TeslaCoilerOW/ttihp-protocol-emulator/README.md

     

# Protocol Emulator: four concurrent programmable I/O engines

- [Read the documentation for project](docs/info.md): the datasheet, with the host protocol, ISA reference and a worked example.

This is a Tiny Tapeout project for the IHP SG13CMOS5L 130 nm process and an
entry in the
[Jane Street protocol emulator ASIC competition](https://blog.janestreet.com/protocol-emulator-asic-competition/).
The chip is a small programmable protocol processor. Four engines run their
own programs at the same time on eight shared bidirectional pins. Each engine
fetches from a private 64-instruction program memory (two IHP SRAM macros)
and has 8-word TX and RX queues, shift and scratch registers, a repeat
counter and a wait timer. UART, SPI, I2C, JTAG and timed waveforms are
firmware; none is hardwired. Event mailboxes, input triggers, a common
timestamp and an autonomous mover coordinate the engines; the mover forwards
queue words between engines without the host, for example UART receive into
SPI transmit. A synchronous nibble-wide host port on `ui_in`/`uo_out` loads
and controls everything. The hardware is written in
[Hardcaml](https://github.com/janestreet/hardcaml): `src/protocol_emulator_core.v`
is generated from `hardcaml/`, and `src/project.v` is a thin Tiny Tapeout
wrapper (`tt_um_teslacoilerow_protocol_emulator`).

<!-- ENTRANT: pitch paragraph in your own words -->
> *Placeholder: the entrant's own pitch paragraph goes here.*

```mermaid
flowchart LR
    H["Synchronous host: load, commit, start, status"] --> C["Ownership, mailboxes, timestamp, finite transfer descriptors"]
    H --> P0["Engine 0: private program and TX/RX queues"]
    H --> P1["Engine 1: private program and TX/RX queues"]
    H --> P2["Engine 2: private program and TX/RX queues"]
    H --> P3["Engine 3: private program and TX/RX queues"]
    C --> P0
    C --> P1
    C --> P2
    C --> P3
    P1 --> D["One accepted FIFO transfer per clock; round-robin sources"]
    D --> P2
    P0 --> U0["Pin 0: UART TX"]
    U1["Pin 1: UART RX"] --> P1
    P2 <--> S["Pins 2–5: SPI"]
    P3 <--> I["Pins 6–7: open-drain I²C"]
```

The pin assignment shown is the flagship example (`firmware/flagship-scenario.json`);
ownership is set by the host.

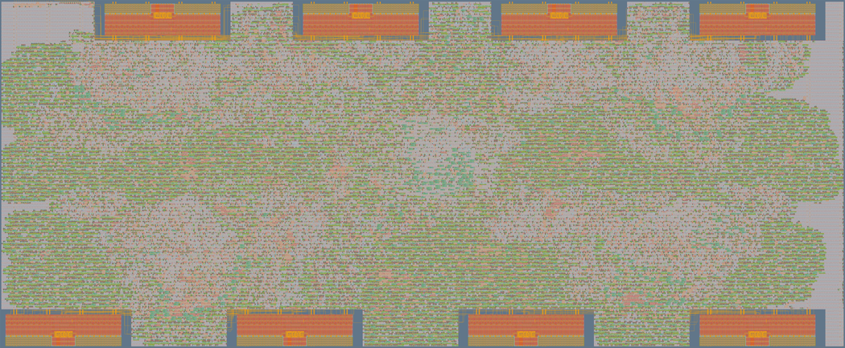
[picture p1: docs/img/die.png]
Layout of the 8x4 die: four SRAM macros along the top edge, four along the bottom, standard cells between them


The layout of the design of record (8x4 tiles, IHP SG13CMOS5L) with its eight
SRAM macros, rendered by the official `gds` workflow (artifact `gds_render` of run
[36714406904](https://github.com/TeslaCoilerOW/ttihp-protocol-emulator/actions/runs/36714406904),
commit `ce6b9bd`) and scaled down. The
[GDS viewer](https://teslacoilerow.github.io/ttihp-protocol-emulator/) shows
the same layout in 3D.

## What is different

1. **Isolated engines and a host-free mover.** Each engine fetches from its
   own SRAM, drives only the pins it owns, and its timing changes only at its
   own stall points; apart from `START`, `STOP` and `BEGIN`, the host port and
   the mover never delay its instructions. The mover forwards words from one
   engine's RX queue to another's TX queue without the host
   ([docs/architecture.md](docs/architecture.md)). The pad-level form of this
   isolation is proved on the RTL, unbounded, for each engine (item 2).
2. **Per-image timing certificates, extended by an isolation proof.** For each
   firmware image, a static analyzer predicts the clock edge of every pad
   change, and generated SymbiYosys proofs check that schedule on the RTL; an
   unbounded two-copy proof per engine extends it to any activity of the other
   engines and the host, apart from the host's commands to that engine
   ([docs/timing-certificates.md](docs/timing-certificates.md)).
3. **Netlist equivalence in CI.** After each official build of `main`, the
   `equivalence` workflow proves the gate-level netlist from the Tiny Tapeout
   flow sequentially equivalent to the RTL, for the 8x4 build and the 6x4
   fallback; an undecided result fails ([docs/equivalence.md](docs/equivalence.md)).

Each piece is checked by a tool on its own: the per-segment certificates of
each image and the lemmas that chain its segments, the per-engine isolation
proof, the netlist equivalence, and the static timing analysis of the layout
in the Tiny Tapeout flow. That they compose into one guarantee (the pads of
a loaded image change on the predicted clock edges in the hardened netlist,
whatever the other engines do and whatever the host does short of commands
to that engine) is a written argument over these separate results, not a
single machine-checked proof
([docs/timing-certificates.md](docs/timing-certificates.md) section 3). How
these fit with the other checks, and what they do not establish, is in
[docs/verification.md](docs/verification.md).

## Status (2026-09-29)

| | |
|---|---|
| Official build, 8x4 | The Tiny Tapeout `gds`, `precheck` and `gl_test` jobs pass. The `viewer` job, which publishes the GDS preview to GitHub Pages, failed until Pages was enabled after `24f31f0`; since `bab697b` (run 36624435821) it passes, and every completed official `gds` run of `main` since then has passed all four jobs, for example run 36714406904 on `ce6b9bd`. |
| Clock | Signed off at 15 ns (66.7 MHz), with setup and hold met at all three corners; operated at 50 MHz. Operation above 50 MHz is not claimed. |
| Tile size | 8x4 confirmed by the organizers (2026-09-28). The 6x4 build is a fallback kept green in CI: the `diet4` variant (4-word queues, 7-bit PC, byte-lane shifts) passes `gds`, `precheck` and `gl_test` in the `gds_6x4` workflow at 20 ns (50 MHz). |
| Timing certificates | All 19 images committed at `24f31f0` are certified: 350 of 350 segments proved, the 22 long segments also as 127 chunks, 455 covers reached; 132 of 132 negative controls and 52 of 52 chunk-level ones fail as required; 3 of 5 RTL timing mutants caught. The 7 images added since (`uart-rx-idle` and the SWD, WS2812B, PS/2 and 1-Wire images) are certified by the campaign on `6a3ea08`: 91 of 91 segments proved, the 28 long ones (up to 80,004 steps) as chains of 96-step chunks, 91 covers reached, and 53 of 53 negative controls that were run fail as required (36 deeper than 2,000 steps are not run). The ledger lists 26 of 26 images certified. |
| Silicon and hardware | No silicon: nothing has been measured on a chip. FPGA bitstreams exist, but no board has been programmed yet, and the host library has not run on hardware. |
| Details | [docs/signoff-history.md](docs/signoff-history.md): official runs, superseded configurations and the 50 MHz re-analysis. [docs/results.md](docs/results.md): every number with its evidence. |

## Documentation

| Page | Contents |
|---|---|
| [docs/overview.md](docs/overview.md) | Two-page overview, with a comparison against RP2040 PIO and other public entries |
| [docs/verification.md](docs/verification.md) | The verification argument: what is proven, bounded, tested or open |
| [docs/results.md](docs/results.md) | Every headline number, its evidence and the command that reproduces it |
| [docs/limitations.md](docs/limitations.md) | What the verification does not establish |
| [docs/info.md](docs/info.md) | Datasheet (rendered by the Tiny Tapeout docs action) |
| [docs/isa.md](docs/isa.md), [docs/isa-spec.md](docs/isa-spec.md), [docs/architecture.md](docs/architecture.md), [docs/firmware.md](docs/firmware.md) | ISA and host-protocol contract and its instruction-level formal specification, architecture notes, firmware and assembler contract |
| [docs/timing-analysis.md](docs/timing-analysis.md), [docs/timing-certificates.md](docs/timing-certificates.md), [docs/timing-certificates-tutorial.md](docs/timing-certificates-tutorial.md) | Static timing analysis of the firmware images; timing certificates proved on the RTL; a worked example |
| [docs/equivalence.md](docs/equivalence.md), [docs/formal-depth.md](docs/formal-depth.md) | RTL-to-netlist equivalence; deeper formal runs and further properties |
| [docs/verification-campaign.md](docs/verification-campaign.md), [docs/mutation-push.md](docs/mutation-push.md), [docs/independent-peers.md](docs/independent-peers.md) | Random differential and mutation campaigns; the mutation score push; tests against unmodified third-party protocol peers |
| [docs/bug-ledger.md](docs/bug-ledger.md) | Each defect the verification found, the method that found it and its fix |
| [docs/host.md](docs/host.md), [docs/fpga.md](docs/fpga.md), [docs/demo.md](docs/demo.md) | Host library, FPGA prototype and hardware demonstration procedures (not yet run on hardware) |
| [docs/signoff-history.md](docs/signoff-history.md) | Sign-off record, including superseded configurations and the milestone plan |
| [docs/extension.md](docs/extension.md), [docs/extension-study.md](docs/extension-study.md) | Line-coding and CRC-16 extension, built on a branch; not the design of record. The study that proposed it |
| [docs/notes/README.md](docs/notes/README.md) | Working notes: area study, hardening recipe, DRC triage, sweep harness, RTL variants, timing closure, optimizer, 6x4 fallback build |

## Build, test and prove

Requirements: OCaml 5.2.1 with the opam packages pinned in
`scripts/opam-deps.txt` (dune 3.20.2, hardcaml v0.17.0, yojson 2.2.2,
digestif 1.3.1); cocotb 2.0.1 and Icarus Verilog; Yosys and SymbiYosys.

```sh
make generate            # scripts/generate.sh configs/instruction-sram-32.json
make check-generated     # regenerate and fail if the committed core differs (the regen action)
make lint                # iverilog, yosys hierarchy and verilator -Wall
(cd test && pip install -r requirements.txt && make clean && make)   # cocotb suite on the RTL
(cd test && make COCOTB_TEST_MODULES=test_protocols_ext)             # SWD, WS2812B, PS/2 and 1-Wire images (RTL)
formal/run.sh --list     # SymbiYosys job names and isa_ci_* groups; formal/run.sh runs the core jobs (the formal action also runs the groups)
make reproduce           # the local checks behind docs/results.md; reproduce-full adds the longer ones
```

The cocotb tests run the design in lockstep with a Python reference model of
the ISA and check protocol results at the pins ([test/README.md](test/README.md)
covers gate-level runs with `GATES=yes` and the constrained-random test).
[formal/README.md](formal/README.md) lists each formal claim and its method.
The firmware assembler is `hardcaml/bin/assemble.ml` ([docs/firmware.md](docs/firmware.md)),
and [docs/notes/hardening.md](docs/notes/hardening.md) records the recipe of the first 8x4 `gds` build (as of `c118027`); `src/config.json` holds the current flow settings.

## Repository layout

| Path | Contents |
|---|---|
| `info.yaml`, `docs/info.md` | Tiny Tapeout metadata, pinout and datasheet |
| `src/` | `project.v` (top module), the generated core, LibreLane configuration |
| `hardcaml/`, `configs/` | Hardcaml hardware, assembler, firmware library, generators; configurations |
| `firmware/` | Assembled firmware images and sources, `flagship-scenario.json` |
| `test/`, `test_ext/` | cocotb tests and the reference model; tests against third-party protocol peers |
| `formal/`, `formal_depth/`, `formal_eq/` | SymbiYosys proofs; deeper runs and further property sets; RTL-vs-netlist equivalence |
| `tools/` | Firmware timing analyzer and certificates (`tools/timing/`), STA re-analysis (`tools/sta/`), evidence checks |
| `campaigns/` | Mutation and constrained-random campaigns |
| `macros/`, `models/` | Vendored IHP SRAM views and simulation models |
| `variants6x4/` | Overlay for the 6x4 fallback build |
| `fpga/`, `demo/`, `host/` | FPGA ports, bench kit and host library (not yet run on hardware) |
| `scripts/` | Generation, lint, reproduction and pinned opam packages |

## License

Apache License 2.0 ([LICENSE](LICENSE), [NOTICE](NOTICE)) for the Hardcaml
sources, the generated Verilog, the firmware, the tests and the documentation.
The SRAM views in `macros/RM_IHPSG13_1P_64x16_c2/` and the models in `models/`
are unmodified IHP-Open-PDK files (`models/blackbox/` is an interface-only
derivative), under Apache-2.0 from the IHP PDK Authors; see
`macros/LICENSE.IHP-Open-PDK` and `models/NOTICE.IHP-Open-PDK`.
`macros/README.md` and `macros/check_macro_floorplan.py` were written for this
project. The Tiny Tapeout template is Apache-2.0.

## What is Tiny Tapeout?

Tiny Tapeout is an educational project that aims to make it easier and cheaper than ever to get your digital and analog designs manufactured on a real chip.

To learn more and get started, visit https://tinytapeout.com.

## Resources

- [FAQ](https://tinytapeout.com/faq/)
- [Digital design lessons](https://tinytapeout.com/digital_design/)
- [Learn how semiconductors work](https://tinytapeout.com/siliwiz/)
- [Join the community](https://tinytapeout.com/discord)
- [Build your design locally](https://www.tinytapeout.com/guides/local-hardening/)
- [Enabling GitHub Pages](https://tinytapeout.com/faq/#my-github-action-is-failing-on-the-pages-part) for the results page
