TeslaCoilerOW/ttihp-protocol-emulator/tools/timing/report/timing-report.md

# Static timing report

Generated by `tools/timing/pe_timing.py report` (pe_timing 1.0) from `firmware`. All times are exact clock-cycle offsets from the previous synchronization boundary (START, PULL, blocking PUSH, WAITPIN, WAITEVENT) unless a range is given; ranges that cross a boundary use its minimum stall and LIMIT-1 (or unbounded) maximum.

## Ground truth (reference model)

Result **PASS**: 1193441/1193441 engine runs, 2599061920 edges, 1284177301 issue attempts and 35303947/35303947 pad changes matched the static schedules exactly; 12610795 complete segments, 12215049 boundary completions, 36114 LIMIT timeouts at the predicted edge.

Negative controls (deliberately wrong analyzers, each must be caught): `wait-n-cycles` caught, `xfer-late-edge` caught, `count-n-iterations` caught, `loopback-latency-4` caught, `open-drain-as-push-pull` caught, `halt-keeps-pins` caught, `set-two-cycles` caught

Margin experiment `uart-rx-baud`: agrees exactly. back-to-back 8N1 at 64 cycles/bit: predicted safe bit periods 62..67, observed passing 62..67 (patterns incl. 0x55/0xAA); prediction matches every setting

Margin experiment `spi-target-timing`: agrees. mode0 half_period: predicted >= 5, observed first pass 5; mode0 cs_setup: predicted >= 5, observed first pass 5; mode0 cs_high: predicted >= 9, observed first pass 9; mode1 half_period: predicted >= 4, observed first pass 4; mode1 cs_setup: predicted >= 2, observed first pass 1; mode1 cs_high: predicted >= 9, observed first pass 9; mode2 half_period: predicted >= 5, observed first pass 5; mode2 cs_setup: predicted >= 5, observed first pass 5; mode2 cs_high: predicted >= 9, observed first pass 9; mode3 half_period: predicted >= 4, observed first pass 4; mode3 cs_setup: predicted >= 2, observed first pass 1; mode3 cs_high: predicted >= 9, observed first pass 9

Margin experiment `i2c-target-phase`: agrees exactly. i2c-target-write: predicted phase >= 8 cycles (declared >= 16), observed first pass 8; i2c-target-write: mismatched second address faults 66 as documented; i2c-target-write: two transactions pass; i2c-target-read: predicted phase >= 8 cycles (declared >= 16), observed first pass 8; i2c-target-read: mismatched second address faults 66 as documented; i2c-target-read: two transactions pass, controller ACK faults 67 as documented

Random and legacy programs analyzed on the fly: 297112 (not exact: 844).

## Summary

| image | engine | contexts | variants | WCET between boundaries | model runs | variants observed | checks |
|---|---:|---:|---:|---:|---:|---:|---|
| event-transmitter | 0 | 2 | 2 | 35 | 28061 | 2/2 | 6 PASS |
| i2c-read | 3 | 26 | 28 | 106 | 28954 | 27/28 | 9 PASS |
| i2c-repeated-start | 3 | 50 | 53 | 106 | 28718 | 53/53 | 9 PASS |
| i2c-target-read | 3 | 67 | 70 | 6 | 27819 | 70/70 | 10 PASS |
| i2c-target-write | 3 | 48 | 49 | 7 | 27886 | 49/49 | 10 PASS |
| i2c-write | 3 | 25 | 27 | 106 | 28836 | 27/27 | 9 PASS |
| jtag | 0 | 4 | 4 | 695 | 33910 | 4/4 | 9 PASS |
| onewire-master | 3 | 6 | 12 | 80005 | - | - | 9 PASS |
| ps2-device | 2 | 18 | 31 | 4000 | - | - | 11 PASS |
| ps2-host | 2 | 50 | 52 | 6290 | - | - | 9 PASS |
| spi-controller-fast | 2 | 4 | 4 | 262 | 35071 | 4/4 | 10 PASS |
| spi-controller-mode0 | 2 | 4 | 4 | 518 | 34446 | 4/4 | 10 PASS |
| spi-controller-mode1 | 2 | 4 | 4 | 518 | 34901 | 4/4 | 10 PASS |
| spi-controller-mode2 | 2 | 4 | 4 | 518 | 34843 | 4/4 | 10 PASS |
| spi-controller-mode3 | 2 | 4 | 4 | 518 | 34936 | 4/4 | 10 PASS |
| spi-target-mode0 | 2 | 24 | 24 | 4 | 31770 | 24/24 | 10 PASS |
| spi-target-mode1 | 2 | 25 | 25 | 4 | 31529 | 25/25 | 10 PASS |
| spi-target-mode2 | 2 | 24 | 24 | 4 | 31306 | 24/24 | 10 PASS |
| spi-target-mode3 | 2 | 25 | 25 | 4 | 31631 | 25/25 | 10 PASS |
| swd-read | 0 | 6 | 18 | 6220 | - | - | 12 PASS |
| uart-rx-idle | 1 | 5 | 9 | 606 | - | - | 10 PASS |
| uart-rx | 1 | 5 | 7 | 618 | 28657 | 7/7 | 8 PASS |
| uart-tx | 0 | 3 | 3 | 644 | 31234 | 3/3 | 9 PASS |
| waveform | 0 | 2 | 2 | 1541 | 28336 | 2/2 | 6 PASS |
| ws2812 | 1 | 3 | 5 | 16514 | - | - | 9 PASS |
| ws2812b-v5 | 1 | 3 | 5 | 16514 | - | - | 9 PASS |

## Flagship scenario

- **PASS** `flagship-ownership`: images on engines 0:uart-tx (0x01), 1:uart-rx-idle (0x00), 2:spi-controller-mode0 (0x2c), 3:i2c-write (0xc0); ownership disjoint and matches each image's engine
- **PASS** `flagship-pin-roles`: pin connections match the image pin roles of docs/firmware.md
- **PASS** `flagship-engine0-schedule`: uart-tx: 3 contexts, WCET between boundaries 644 cycles; schedule exact per engine (no widening). Isolation from the other engines, host and mover rests on formal job timing_isolation_prove_k0 (formal/README.md; not re-run by this tool)
- **PASS** `flagship-engine1-schedule`: uart-rx-idle: 5 contexts, WCET between boundaries 606 cycles; schedule exact per engine (no widening). Isolation from the other engines, host and mover rests on formal job timing_isolation_prove_k1 (formal/README.md; not re-run by this tool)
- **PASS** `flagship-engine2-schedule`: spi-controller-mode0: 4 contexts, WCET between boundaries 518 cycles; schedule exact per engine (no widening). Isolation from the other engines, host and mover rests on formal job timing_isolation_prove_k2 (formal/README.md; not re-run by this tool)
- **PASS** `flagship-engine3-schedule`: i2c-write: 25 contexts, WCET between boundaries 106 cycles; schedule exact per engine (no widening). Isolation from the other engines, host and mover rests on formal job timing_isolation_prove_k3 (formal/README.md; not re-run by this tool)
- **PASS** `flagship-bridge-rate`: UART RX (engine1) delivers at most one word per 640 cycles (10 x 64); the SPI engine returns to PULL 520 cycles after taking a word when its RX FIFO has room: the route never backs up at line rate (margin 120 cycles/word)
- **PASS** `flagship-spi-rx-capacity`: 8 SPI return words fit the 8-word RX FIFO without host service; the 9th would stall the SPI PUSH, back up the route and end in the UART strict-PUSH fault4 (documented overload behaviour)

## event-transmitter

Engine 0, owned 0x01, open-drain 0x00, fused, 50 MHz annotation. Notes: "Event-triggered pin0 low pulse; mailbox delivery does not require host byte service. WAITEVENT has reset LIMIT65535."

### Checks

- **PASS** `identity`: bytecode sha256 matches, source sha256 matches
- **PASS** `assembler-timing-table`: 7 per-instruction entries (minimum_cycles, blocking) agree with the ISA cost model
- **PASS** `exact-analysis`: 2 boundary contexts, 2 path variants, no widening or budget cut
- **PASS** `no-self-deadlock`: no WAITPIN waits for a level the engine itself forces
- **PASS** `reachable-faults`: only explicit FAULT codes [] reachable
- **INFO** `bounded-waits`: 1 WAITPIN/WAITEVENT contexts; LIMIT values [65535]; longest bounded stall 65534 cycles (1310.680 us at 50 MHz) before fault 3
- **PASS** `event-pulse`: low pulse exactly 32 cycles (half-period 32, docs/firmware.md default); pulse starts 1 cycle(s) after WAITEVENT completes; minimum high time between pulses 3 cycles when events are already pending

### Boundaries

| boundary (context) | stall min..max | segment BCET..WCET | holding pads |
|---|---|---|---|
| START | 0..0 | 3..3 | pin0=Z |
| pc2 WAITEVENT | 0..65534 | 35..35 | pin0=1 |

### Pin spacing

- pin0: exact spacings {32: 1}; across boundaries [('2', '65536'), ('3', '65537')]; minimum 2

### Loop periods

- pc2 `WAITEVENT` via JMP@pc6: 35..65569 (x2)

### Edge schedules

```
  from START v0:
    +2      pc1   pin0 Z->1
    +3      pc2   arrive WAITEVENT
  from pc2 WAITEVENT v0:
    +1      pc3   pin0 1->0
    +33     pc5   pin0 0->1
    +35     pc2   arrive WAITEVENT
```

## i2c-read

Engine 3, owned 0xc0, open-drain 0xc0, fused, 50 MHz annotation. Notes: "I2C controller pins SCL6/SDA7, external pull-ups required. SCL release always waits for synchronized high and LIMIT bounds stretching." "TX word: address+R; one returned RX byte followed by NACK and STOP; an address NACK ends the transaction with STOP, completed by the fault65 pin release." "Single-controller bus only; no arbitration-loss detection. Queue a complete transaction: the first PULL waits with the bus idle, later PULL/PUSH holding points keep SCL low." "Declared I2C bus speed at the 50000000 Hz annotation: Fast-mode Plus (UM10204 Table 11; SCL low >= 35 and high >= 36 clocks, START/repeated-START/STOP set-up and hold >= 34 clocks, bus free >= 72 clocks, SDA held >= 2 clocks after SCL falls); Fast-mode needs half-period >= 62; Standard-mode needs half-period >= 247."

### Checks

- **PASS** `identity`: bytecode sha256 matches, source sha256 matches
- **PASS** `assembler-timing-table`: 55 per-instruction entries (minimum_cycles, blocking) agree with the ISA cost model
- **PASS** `exact-analysis`: 26 boundary contexts, 28 path variants, no widening or budget cut
- **PASS** `no-self-deadlock`: no WAITPIN waits for a level the engine itself forces
- **PASS** `reachable-faults`: only explicit FAULT codes [65] reachable
- **INFO** `bounded-waits`: 7 WAITPIN/WAITEVENT contexts; LIMIT values [131072]; longest bounded stall 131071 cycles (2621.420 us at 50 MHz) before fault 3
- **INFO** `holding-points`: unbounded FIFO waits hold: pc2 PULL [pin6=Z pin7=Z]; pc43 PUSH [pin6=0 pin7=Z]
- **PASS** `i2c-open-drain`: SCL/SDA are open-drain and never driven high (pull-ups define the high level)
- **PASS** `i2c-stretch-safe`: every SCL release is followed by WAITPIN SCL==1 before SCL is driven low again (clock stretching honoured; LIMIT bounds it)
- **PASS** `i2c-sda-only-while-scl-low`: SDA changes only while SCL is held low, except START/STOP conditions
- **PASS** `i2c-scl-low-phase`: SCL low phases (cycles: occurrences) {'37': 2, '36': 8, '38': 1, '35': 8, '37..inf': 1}; every phase >= half-period 32 (docs/firmware.md default)
- **INFO** `i2c-bus-timing-cycles`: tLOW >= 35; tHIGH >= 36; tHD;STA >= 34; tSU;STA >= 37; tSU;STO >= 37; tBUF >= 72; tSU;DAT >= 34; tHD;DAT >= 2; fSCL_period >= 71; tVD;DAT <= 4 cycles (tHIGH/tSU;STA/tSU;STO counted from the synchronized observation of SCL high, +2 cycles input latency; stretch-aware)
- **INFO** `i2c-Sm`: UM10204 Sm: met for clocks 1.16..7.1 MHz (limited by fSCL_period); at 50 MHz FAIL; 10MHz FAIL, 25MHz FAIL, 50MHz FAIL, 66MHz FAIL, 100MHz FAIL
- **INFO** `i2c-Fm`: UM10204 Fm: met for clocks 4.44..26.9 MHz (limited by tLOW); at 50 MHz FAIL; 10MHz PASS, 25MHz PASS, 50MHz FAIL, 66MHz FAIL, 100MHz FAIL
- **INFO** `i2c-Fm+`: UM10204 Fm+: met for clocks 8.89..70 MHz (limited by tLOW); at 50 MHz PASS; 10MHz PASS, 25MHz PASS, 50MHz PASS, 66MHz PASS, 100MHz FAIL

### Boundaries

| boundary (context) | stall min..max | segment BCET..WCET | holding pads |
|---|---|---|---|
| START | 0..0 | 3..3 | pin6=Z pin7=Z |
| pc2 PULL | 0..inf | 2..2 | pin6=Z pin7=Z |
| pc4 WAITPIN pin6==1 | 0..131071 | 1..1 | pin6=Z pin7=Z |
| pc5 WAITPIN pin7==1 | 0..131071 | 106..106 | pin6=Z pin7=Z |
| pc15 WAITPIN pin6==1 [repeat=7] | 2..131071 | 71..71 | pin6=Z pin7=0|Z |
| pc15 WAITPIN pin6==1 [repeat=6] | 2..131071 | 71..71 | pin6=Z pin7=0|Z |
| pc15 WAITPIN pin6==1 [repeat=5] | 2..131071 | 71..71 | pin6=Z pin7=0|Z |
| pc15 WAITPIN pin6==1 [repeat=4] | 2..131071 | 71..71 | pin6=Z pin7=0|Z |
| pc15 WAITPIN pin6==1 [repeat=3] | 2..131071 | 71..71 | pin6=Z pin7=0|Z |
| pc15 WAITPIN pin6==1 [repeat=2] | 2..131071 | 71..71 | pin6=Z pin7=0|Z |
| pc15 WAITPIN pin6==1 [repeat=1] | 2..131071 | 71..71 | pin6=Z pin7=0|Z |
| pc15 WAITPIN pin6==1 | 2..131071 | 71..71 | pin6=Z pin7=0|Z |
| pc22 WAITPIN pin6==1 | 2..131071 | 74..75 | pin6=Z pin7=Z |
| pc48 WAITPIN pin6==1 | 2..131071 | 35..70 | pin6=Z pin7=0 |
| pc33 WAITPIN pin6==1 [repeat=7] | 2..131071 | 71..71 | pin6=Z pin7=Z |
| pc2 PULL | 0..inf | 2..2 | pin6=Z pin7=Z |
| pc33 WAITPIN pin6==1 [repeat=6] | 2..131071 | 71..71 | pin6=Z pin7=Z |
| pc33 WAITPIN pin6==1 [repeat=5] | 2..131071 | 71..71 | pin6=Z pin7=Z |
| pc33 WAITPIN pin6==1 [repeat=4] | 2..131071 | 71..71 | pin6=Z pin7=Z |
| pc33 WAITPIN pin6==1 [repeat=3] | 2..131071 | 71..71 | pin6=Z pin7=Z |
| pc33 WAITPIN pin6==1 [repeat=2] | 2..131071 | 71..71 | pin6=Z pin7=Z |
| pc33 WAITPIN pin6==1 [repeat=1] | 2..131071 | 71..71 | pin6=Z pin7=Z |
| pc33 WAITPIN pin6==1 | 2..131071 | 71..71 | pin6=Z pin7=Z |
| pc40 WAITPIN pin6==1 | 2..131071 | 35..35 | pin6=Z pin7=Z |
| pc43 PUSH | 0..inf | 37..37 | pin6=0 pin7=Z |
| pc48 WAITPIN pin6==1 | 2..131071 | 70..70 | pin6=Z pin7=0 |

### Pin spacing

- pin6: exact spacings {35: 8, 36: 8, 37: 2, 38: 1}; across boundaries [('144', 'inf'), ('37', '131106'), ('37', 'inf'), ('38', '131107'), ('39', '131108')]; minimum 35
- pin7: exact spacings {37: 1}; across boundaries [('72', '131141'), ('72', 'inf'), ('73', '131142'), ('77', 'inf')]; minimum 37

### Loop periods

- pc2 `PULL` via JMP@pc54: 842..inf (x3)
- pc12 `OUT pin7 msb` via LOOP@pc18: 73..131142 (x7), 331..inf (x1)
- pc31 `WAIT 32` via LOOP@pc37: 73..131142 (x7), 988..inf (x1)

### Edge schedules

```
  from START v0:
    +3      pc2   arrive PULL
  from pc2 PULL v0 (+1 identical contexts):
    +2      pc4   arrive WAITPIN pin6==1
  from pc4 WAITPIN pin6==1 v0:
    +1      pc5   arrive WAITPIN pin7==1
  from pc5 WAITPIN pin7==1 v0:
    +34     pc7   pin7 Z->0
    +68     pc9   pin6 Z->0
    +71     pc12  pin7 0->0|Z
    +105    pc14  pin6 0->Z
    +106    pc15  arrive WAITPIN pin6==1
  from pc15 WAITPIN pin6==1 [repeat=7] v0 (+6 identical contexts):
    +34     pc17  pin6 Z->0
    +36     pc12  pin7 0|Z->0|Z
    +70     pc14  pin6 0->Z
    +71     pc15  arrive WAITPIN pin6==1
  from pc15 WAITPIN pin6==1 v0:
    +34     pc17  pin6 Z->0
    +36     pc19  pin7 0|Z->Z
    +70     pc21  pin6 0->Z
    +71     pc22  arrive WAITPIN pin6==1
  from pc22 WAITPIN pin6==1 v0:
    +35     pc25  sample pin7
    +36     pc26  pin6 Z->0
    +40     pc45  pin7 Z->0
    +74     pc47  pin6 0->Z
    +75     pc48  arrive WAITPIN pin6==1
  from pc22 WAITPIN pin6==1 v1:
    +35     pc25  sample pin7
    +36     pc26  pin6 Z->0
    +73     pc32  pin6 0->Z
    +74     pc33  arrive WAITPIN pin6==1
  from pc48 WAITPIN pin6==1 v0:
    +35     pc51  pin7 0->Z
    end: fault65 at +35
  from pc48 WAITPIN pin6==1 v1 (+1 identical contexts):
    +35     pc52  pin7 0->Z
    +70     pc2   arrive PULL
  from pc33 WAITPIN pin6==1 [repeat=7] v0 (+6 identical contexts):
    +34     pc35  sample pin7
    +35     pc36  pin6 Z->0
    +70     pc32  pin6 0->Z
    +71     pc33  arrive WAITPIN pin6==1
  from pc33 WAITPIN pin6==1 v0:
    +34     pc35  sample pin7
    +35     pc36  pin6 Z->0
    +70     pc39  pin6 0->Z
    +71     pc40  arrive WAITPIN pin6==1
  from pc40 WAITPIN pin6==1 v0:
    +34     pc42  pin6 Z->0
    +35     pc43  arrive PUSH
  from pc43 PUSH v0:
    +2      pc45  pin7 Z->0
    +36     pc47  pin6 0->Z
    +37     pc48  arrive WAITPIN pin6==1
```

## i2c-repeated-start

Engine 3, owned 0xc0, open-drain 0xc0, fused, 50 MHz annotation. Notes: "I2C register read: TX address+W, register, address+R; repeated START, one RX byte, NACK, STOP." "Pins SCL6/SDA7 require pull-ups. Every released SCL is checked for stretching; LIMIT bounds pin waits; a NACK ends the transaction with STOP, completed by the fault65 pin release." "Shared transmit routine fits 64 words. Queue all three TX words: the first PULL waits with the bus idle, later FIFO holding points keep SCL low. Single-controller bus, no arbitration-loss detection." "Declared I2C bus speed at the 50000000 Hz annotation: Fast-mode Plus (UM10204 Table 11; SCL low >= 35 and high >= 36 clocks, START/repeated-START/STOP set-up and hold >= 34 clocks, bus free >= 72 clocks, SDA held >= 2 clocks after SCL falls); Fast-mode needs half-period >= 62; Standard-mode needs half-period >= 247."

### Checks

- **PASS** `identity`: bytecode sha256 matches, source sha256 matches
- **PASS** `assembler-timing-table`: 61 per-instruction entries (minimum_cycles, blocking) agree with the ISA cost model
- **PASS** `exact-analysis`: 50 boundary contexts, 53 path variants, no widening or budget cut
- **PASS** `no-self-deadlock`: no WAITPIN waits for a level the engine itself forces
- **PASS** `reachable-faults`: only explicit FAULT codes [65] reachable
- **INFO** `bounded-waits`: 7 WAITPIN/WAITEVENT contexts; LIMIT values [131072]; longest bounded stall 131071 cycles (2621.420 us at 50 MHz) before fault 3
- **INFO** `holding-points`: unbounded FIFO waits hold: pc5 PULL [pin6=0 pin7=Z]; pc5 PULL [pin6=Z pin7=Z]; pc50 PUSH [pin6=0 pin7=Z]
- **PASS** `i2c-open-drain`: SCL/SDA are open-drain and never driven high (pull-ups define the high level)
- **PASS** `i2c-stretch-safe`: every SCL release is followed by WAITPIN SCL==1 before SCL is driven low again (clock stretching honoured; LIMIT bounds it)
- **PASS** `i2c-sda-only-while-scl-low`: SDA changes only while SCL is held low, except START/STOP conditions
- **PASS** `i2c-scl-low-phase`: SCL low phases (cycles: occurrences) {'37': 2, '36': 24, '38': 3, '46..inf': 1, '42..inf': 1, '39': 1, '35': 8, '36..inf': 1}; every phase >= half-period 32 (docs/firmware.md default)
- **INFO** `i2c-bus-timing-cycles`: tLOW >= 35; tHIGH >= 36; tHD;STA >= 34; tSU;STA >= 37; tSU;STO >= 37; tBUF >= 111; tSU;DAT >= 34; tHD;DAT >= 2; fSCL_period >= 71; tVD;DAT <= 4 cycles (tHIGH/tSU;STA/tSU;STO counted from the synchronized observation of SCL high, +2 cycles input latency; stretch-aware)
- **INFO** `i2c-Sm`: UM10204 Sm: met for clocks 1.16..7.1 MHz (limited by fSCL_period); at 50 MHz FAIL; 10MHz FAIL, 25MHz FAIL, 50MHz FAIL, 66MHz FAIL, 100MHz FAIL
- **INFO** `i2c-Fm`: UM10204 Fm: met for clocks 4.44..26.9 MHz (limited by tLOW); at 50 MHz FAIL; 10MHz PASS, 25MHz PASS, 50MHz FAIL, 66MHz FAIL, 100MHz FAIL
- **INFO** `i2c-Fm+`: UM10204 Fm+: met for clocks 8.89..70 MHz (limited by tLOW); at 50 MHz PASS; 10MHz PASS, 25MHz PASS, 50MHz PASS, 66MHz PASS, 100MHz FAIL

### Boundaries

| boundary (context) | stall min..max | segment BCET..WCET | holding pads |
|---|---|---|---|
| START | 0..0 | 6..6 | pin6=Z pin7=Z |
| pc5 PULL | 0..inf | 38..38 | pin6=Z pin7=Z |
| pc11 WAITPIN pin6==1 | 0..131071 | 1..1 | pin6=Z pin7=Z |
| pc12 WAITPIN pin7==1 | 0..131071 | 106..106 | pin6=Z pin7=Z |
| pc22 WAITPIN pin6==1 [repeat=7] | 2..131071 | 71..71 | pin6=Z pin7=0|Z |
| pc22 WAITPIN pin6==1 [repeat=6] | 2..131071 | 71..71 | pin6=Z pin7=0|Z |
| pc22 WAITPIN pin6==1 [repeat=5] | 2..131071 | 71..71 | pin6=Z pin7=0|Z |
| pc22 WAITPIN pin6==1 [repeat=4] | 2..131071 | 71..71 | pin6=Z pin7=0|Z |
| pc22 WAITPIN pin6==1 [repeat=3] | 2..131071 | 71..71 | pin6=Z pin7=0|Z |
| pc22 WAITPIN pin6==1 [repeat=2] | 2..131071 | 71..71 | pin6=Z pin7=0|Z |
| pc22 WAITPIN pin6==1 [repeat=1] | 2..131071 | 71..71 | pin6=Z pin7=0|Z |
| pc22 WAITPIN pin6==1 | 2..131071 | 71..71 | pin6=Z pin7=0|Z |
| pc29 WAITPIN pin6==1 | 2..131071 | 41..75 | pin6=Z pin7=Z |
| pc54 WAITPIN pin6==1 | 2..131071 | 35..35 | pin6=Z pin7=0 |
| pc5 PULL | 0..inf | 42..42 | pin6=0 pin7=Z |
| pc22 WAITPIN pin6==1 [repeat=7] | 2..131071 | 71..71 | pin6=Z pin7=0|Z |
| pc22 WAITPIN pin6==1 [repeat=6] | 2..131071 | 71..71 | pin6=Z pin7=0|Z |
| pc22 WAITPIN pin6==1 [repeat=5] | 2..131071 | 71..71 | pin6=Z pin7=0|Z |
| pc22 WAITPIN pin6==1 [repeat=4] | 2..131071 | 71..71 | pin6=Z pin7=0|Z |
| pc22 WAITPIN pin6==1 [repeat=3] | 2..131071 | 71..71 | pin6=Z pin7=0|Z |
| pc22 WAITPIN pin6==1 [repeat=2] | 2..131071 | 71..71 | pin6=Z pin7=0|Z |
| pc22 WAITPIN pin6==1 [repeat=1] | 2..131071 | 71..71 | pin6=Z pin7=0|Z |
| pc22 WAITPIN pin6==1 | 2..131071 | 71..71 | pin6=Z pin7=0|Z |
| pc29 WAITPIN pin6==1 | 2..131071 | 41..75 | pin6=Z pin7=Z |
| pc54 WAITPIN pin6==1 | 2..131071 | 35..35 | pin6=Z pin7=0 |
| pc5 PULL | 0..inf | 38..38 | pin6=0 pin7=Z |
| pc11 WAITPIN pin6==1 | 2..131071 | 1..1 | pin6=Z pin7=Z |
| pc12 WAITPIN pin7==1 | 0..131071 | 106..106 | pin6=Z pin7=Z |
| pc22 WAITPIN pin6==1 [repeat=7] | 2..131071 | 71..71 | pin6=Z pin7=0|Z |
| pc22 WAITPIN pin6==1 [repeat=6] | 2..131071 | 71..71 | pin6=Z pin7=0|Z |
| pc22 WAITPIN pin6==1 [repeat=5] | 2..131071 | 71..71 | pin6=Z pin7=0|Z |
| pc22 WAITPIN pin6==1 [repeat=4] | 2..131071 | 71..71 | pin6=Z pin7=0|Z |
| pc22 WAITPIN pin6==1 [repeat=3] | 2..131071 | 71..71 | pin6=Z pin7=0|Z |
| pc22 WAITPIN pin6==1 [repeat=2] | 2..131071 | 71..71 | pin6=Z pin7=0|Z |
| pc22 WAITPIN pin6==1 [repeat=1] | 2..131071 | 71..71 | pin6=Z pin7=0|Z |
| pc22 WAITPIN pin6==1 | 2..131071 | 71..71 | pin6=Z pin7=0|Z |
| pc29 WAITPIN pin6==1 | 2..131071 | 75..76 | pin6=Z pin7=Z |
| pc54 WAITPIN pin6==1 | 2..131071 | 35..35 | pin6=Z pin7=0 |
| pc40 WAITPIN pin6==1 [repeat=7] | 2..131071 | 71..71 | pin6=Z pin7=Z |
| pc40 WAITPIN pin6==1 [repeat=6] | 2..131071 | 71..71 | pin6=Z pin7=Z |
| pc40 WAITPIN pin6==1 [repeat=5] | 2..131071 | 71..71 | pin6=Z pin7=Z |
| pc40 WAITPIN pin6==1 [repeat=4] | 2..131071 | 71..71 | pin6=Z pin7=Z |
| pc40 WAITPIN pin6==1 [repeat=3] | 2..131071 | 71..71 | pin6=Z pin7=Z |
| pc40 WAITPIN pin6==1 [repeat=2] | 2..131071 | 71..71 | pin6=Z pin7=Z |
| pc40 WAITPIN pin6==1 [repeat=1] | 2..131071 | 71..71 | pin6=Z pin7=Z |
| pc40 WAITPIN pin6==1 | 2..131071 | 71..71 | pin6=Z pin7=Z |
| pc47 WAITPIN pin6==1 | 2..131071 | 35..35 | pin6=Z pin7=Z |
| pc50 PUSH | 0..inf | 36..36 | pin6=0 pin7=Z |
| pc54 WAITPIN pin6==1 | 2..131071 | 73..73 | pin6=Z pin7=0 |
| pc5 PULL | 0..inf | 38..38 | pin6=Z pin7=Z |

### Pin spacing

- pin6: exact spacings {35: 8, 36: 24, 37: 2, 38: 3, 39: 1}; across boundaries [('183', 'inf'), ('36', 'inf'), ('37', '131106'), ('38', '131107'), ('39', '131108'), ('42', 'inf'), ('46', 'inf'), ('72', '262212')]; minimum 35
- pin7: exact spacings {3: 1, 37: 2}; across boundaries [('111', 'inf'), ('72', '131141'), ('73', '131142'), ('77', 'inf')]; minimum 3

### Loop periods

- pc2 `LOAD x, 4` via JMP@pc60: 2982..inf (x2)
- pc3 `ADD x, y` via JZ@pc35: 669..inf (x1), 767..inf (x1), 772..inf (x2), 774..inf (x1)
- pc19 `OUT pin7 msb` via LOOP@pc25: 73..131142 (x21), 158..inf (x1), 263..inf (x1), 1028..inf (x1)
- pc38 `WAIT 32` via LOOP@pc44: 73..131142 (x7), 2471..inf (x1)

### Edge schedules

```
  from START v0:
    +6      pc5   arrive PULL
  from pc5 PULL v0 (+1 identical contexts):
    +38     pc11  arrive WAITPIN pin6==1
  from pc11 WAITPIN pin6==1 v0 (+1 identical contexts):
    +1      pc12  arrive WAITPIN pin7==1
  from pc12 WAITPIN pin7==1 v0 (+1 identical contexts):
    +34     pc14  pin7 Z->0
    +68     pc16  pin6 Z->0
    +71     pc19  pin7 0->0|Z
    +105    pc21  pin6 0->Z
    +106    pc22  arrive WAITPIN pin6==1
  from pc22 WAITPIN pin6==1 [repeat=7] v0 (+20 identical contexts):
    +34     pc24  pin6 Z->0
    +36     pc19  pin7 0|Z->0|Z
    +70     pc21  pin6 0->Z
    +71     pc22  arrive WAITPIN pin6==1
  from pc22 WAITPIN pin6==1 v0 (+2 identical contexts):
    +34     pc24  pin6 Z->0
    +36     pc26  pin7 0|Z->Z
    +70     pc28  pin6 0->Z
    +71     pc29  arrive WAITPIN pin6==1
  from pc29 WAITPIN pin6==1 v0 (+2 identical contexts):
    +35     pc32  sample pin7
    +36     pc33  pin6 Z->0
    +40     pc51  pin7 Z->0
    +74     pc53  pin6 0->Z
    +75     pc54  arrive WAITPIN pin6==1
  from pc29 WAITPIN pin6==1 v1 (+1 identical contexts):
    +35     pc32  sample pin7
    +36     pc33  pin6 Z->0
    +41     pc5   arrive PULL
  from pc54 WAITPIN pin6==1 v0 (+2 identical contexts):
    +35     pc57  pin7 0->Z
    end: fault65 at +35
  from pc5 PULL v0:
    +4      pc16  pin7 Z->0
    +7      pc19  pin7 0->0|Z
    +41     pc21  pin6 0->Z
    +42     pc22  arrive WAITPIN pin6==1
  from pc5 PULL v0:
    +37     pc10  pin6 0->Z
    +38     pc11  arrive WAITPIN pin6==1
  from pc29 WAITPIN pin6==1 v1:
    +35     pc32  sample pin7
    +36     pc33  pin6 Z->0
    +75     pc39  pin6 0->Z
    +76     pc40  arrive WAITPIN pin6==1
  from pc40 WAITPIN pin6==1 [repeat=7] v0 (+6 identical contexts):
    +34     pc42  sample pin7
    +35     pc43  pin6 Z->0
    +70     pc39  pin6 0->Z
    +71     pc40  arrive WAITPIN pin6==1
  from pc40 WAITPIN pin6==1 v0:
    +34     pc42  sample pin7
    +35     pc43  pin6 Z->0
    +70     pc46  pin6 0->Z
    +71     pc47  arrive WAITPIN pin6==1
  from pc47 WAITPIN pin6==1 v0:
    +34     pc49  pin6 Z->0
    +35     pc50  arrive PUSH
  from pc50 PUSH v0:
    +1      pc51  pin7 Z->0
    +35     pc53  pin6 0->Z
    +36     pc54  arrive WAITPIN pin6==1
  from pc54 WAITPIN pin6==1 v0:
    +35     pc58  pin7 0->Z
    +73     pc5   arrive PULL
```

## i2c-target-read

Engine 3, owned 0xc0, open-drain 0xc0, fused, 50 MHz annotation. Notes: "I2C 7-bit target address0x42, pins SCL6/SDA7 with external pull-ups; one data byte per START/STOP transaction." "Controller must supply each low/high phase at least 16 system clocks and honor stretching. Target stretches before address ACK for TX availability and before data ACK for RX space." "Different address/direction faults66 and releases bus; this is a dedicated point-to-point target example, not a multi-address shared-bus target." "Read returns one queued byte; controller must NACK it (ACK faults67), then STOP." "Repeated START and multi-byte target framing are outside this example's contract; controller firmware provides repeated START."

### Checks

- **PASS** `identity`: bytecode sha256 matches, source sha256 matches
- **PASS** `assembler-timing-table`: 40 per-instruction entries (minimum_cycles, blocking) agree with the ISA cost model
- **PASS** `exact-analysis`: 67 boundary contexts, 70 path variants, no widening or budget cut
- **PASS** `no-self-deadlock`: no WAITPIN waits for a level the engine itself forces
- **PASS** `reachable-faults`: only explicit FAULT codes [66, 67] reachable
- **INFO** `bounded-waits`: 14 WAITPIN/WAITEVENT contexts; LIMIT values [131072]; longest bounded stall 131071 cycles (2621.420 us at 50 MHz) before fault 3
- **INFO** `holding-points`: unbounded FIFO waits hold: pc18 PULL [pin6=0 pin7=0]; pc18 PULL [pin6=0 pin7=0|Z]
- **PASS** `i2c-target-sda-latency`: SDA driven 7..8 cycles after SCL falls (input latency included); controller keeps SCL low >= 16 cycles: tSU;DAT margin 8 cycles (160.0 ns at 50 MHz); declared: "Controller must supply each low/high phase at least 16 system clocks and honor stretching. Target stretches before address ACK for TX availability and before data ACK for RX space."
- **PASS** `i2c-target-sda-only-after-scl-low`: the target changes SDA only after observing SCL low (or while stretching SCL)
- **PASS** `i2c-target-rearm`: after each observed edge the firmware reaches the next pin wait within 6 cycles, or grabs SCL (stretch) within 7..8 cycles of the edge; both <= 16 (margin 8)
- **PASS** `i2c-target-sample-hold`: SDA sampled from the pad 1..2 cycles after SCL rises (data held by the controller >= 16 cycles; margin 14)
- **PASS** `i2c-target-stretch-at-holding`: SCL held low (clock stretch) at every FIFO holding point

### Boundaries

| boundary (context) | stall min..max | segment BCET..WCET | holding pads |
|---|---|---|---|
| START | 0..0 | 4..4 | pin6=Z pin7=Z |
| pc3 WAITPIN pin7==1 | 0..131071 | 1..1 | pin6=Z pin7=Z |
| pc4 WAITPIN pin6==1 | 0..131071 | 1..1 | pin6=Z pin7=Z |
| pc5 WAITPIN pin7==0 | 0..131071 | 1..1 | pin6=Z pin7=Z |
| pc6 WAITPIN pin6==0 | 0..131071 | 3..3 | pin6=Z pin7=Z |
| pc9 WAITPIN pin6==1 [repeat=7] | 0..131071 | 2..2 | pin6=Z pin7=Z |
| pc11 WAITPIN pin6==0 [repeat=7] | 0..131071 | 2..2 | pin6=Z pin7=Z |
| pc9 WAITPIN pin6==1 [repeat=6] | 0..131071 | 2..2 | pin6=Z pin7=Z |
| pc11 WAITPIN pin6==0 [repeat=6] | 0..131071 | 2..2 | pin6=Z pin7=Z |
| pc9 WAITPIN pin6==1 [repeat=5] | 0..131071 | 2..2 | pin6=Z pin7=Z |
| pc11 WAITPIN pin6==0 [repeat=5] | 0..131071 | 2..2 | pin6=Z pin7=Z |
| pc9 WAITPIN pin6==1 [repeat=4] | 0..131071 | 2..2 | pin6=Z pin7=Z |
| pc11 WAITPIN pin6==0 [repeat=4] | 0..131071 | 2..2 | pin6=Z pin7=Z |
| pc9 WAITPIN pin6==1 [repeat=3] | 0..131071 | 2..2 | pin6=Z pin7=Z |
| pc11 WAITPIN pin6==0 [repeat=3] | 0..131071 | 2..2 | pin6=Z pin7=Z |
| pc9 WAITPIN pin6==1 [repeat=2] | 0..131071 | 2..2 | pin6=Z pin7=Z |
| pc11 WAITPIN pin6==0 [repeat=2] | 0..131071 | 2..2 | pin6=Z pin7=Z |
| pc9 WAITPIN pin6==1 [repeat=1] | 0..131071 | 2..2 | pin6=Z pin7=Z |
| pc11 WAITPIN pin6==0 [repeat=1] | 0..131071 | 2..2 | pin6=Z pin7=Z |
| pc9 WAITPIN pin6==1 | 0..131071 | 2..2 | pin6=Z pin7=Z |
| pc11 WAITPIN pin6==0 | 0..131071 | 5..6 | pin6=Z pin7=Z |
| pc18 PULL | 0..inf | 3..3 | pin6=0 pin7=0 |
| pc21 WAITPIN pin6==1 | 2..131071 | 1..1 | pin6=Z pin7=0 |
| pc22 WAITPIN pin6==0 | 0..131071 | 6..6 | pin6=Z pin7=0 |
| pc28 WAITPIN pin6==1 [repeat=7] | 0..131071 | 1..1 | pin6=Z pin7=0|Z |
| pc29 WAITPIN pin6==0 [repeat=7] | 0..131071 | 3..3 | pin6=Z pin7=0|Z |
| pc28 WAITPIN pin6==1 [repeat=6] | 0..131071 | 1..1 | pin6=Z pin7=0|Z |
| pc29 WAITPIN pin6==0 [repeat=6] | 0..131071 | 3..3 | pin6=Z pin7=0|Z |
| pc28 WAITPIN pin6==1 [repeat=5] | 0..131071 | 1..1 | pin6=Z pin7=0|Z |
| pc29 WAITPIN pin6==0 [repeat=5] | 0..131071 | 3..3 | pin6=Z pin7=0|Z |
| pc28 WAITPIN pin6==1 [repeat=4] | 0..131071 | 1..1 | pin6=Z pin7=0|Z |
| pc29 WAITPIN pin6==0 [repeat=4] | 0..131071 | 3..3 | pin6=Z pin7=0|Z |
| pc28 WAITPIN pin6==1 [repeat=3] | 0..131071 | 1..1 | pin6=Z pin7=0|Z |
| pc29 WAITPIN pin6==0 [repeat=3] | 0..131071 | 3..3 | pin6=Z pin7=0|Z |
| pc28 WAITPIN pin6==1 [repeat=2] | 0..131071 | 1..1 | pin6=Z pin7=0|Z |
| pc29 WAITPIN pin6==0 [repeat=2] | 0..131071 | 3..3 | pin6=Z pin7=0|Z |
| pc28 WAITPIN pin6==1 [repeat=1] | 0..131071 | 1..1 | pin6=Z pin7=0|Z |
| pc29 WAITPIN pin6==0 [repeat=1] | 0..131071 | 3..3 | pin6=Z pin7=0|Z |
| pc28 WAITPIN pin6==1 | 0..131071 | 1..1 | pin6=Z pin7=0|Z |
| pc29 WAITPIN pin6==0 | 0..131071 | 3..3 | pin6=Z pin7=0|Z |
| pc32 WAITPIN pin6==1 | 0..131071 | 2..2 | pin6=Z pin7=Z |
| pc34 WAITPIN pin6==0 | 0..131071 | 2..2 | pin6=Z pin7=Z |
| pc36 WAITPIN pin6==1 | 0..131071 | 1..1 | pin6=Z pin7=Z |
| pc37 WAITPIN pin7==1 | 0..131071 | 2..2 | pin6=Z pin7=Z |
| pc3 WAITPIN pin7==1 | 0..131071 | 1..1 | pin6=Z pin7=Z |
| pc4 WAITPIN pin6==1 | 0..131071 | 1..1 | pin6=Z pin7=Z |
| pc5 WAITPIN pin7==0 | 0..131071 | 1..1 | pin6=Z pin7=Z |
| pc6 WAITPIN pin6==0 | 0..131071 | 3..3 | pin6=Z pin7=Z |
| pc9 WAITPIN pin6==1 [repeat=7] | 0..131071 | 2..2 | pin6=Z pin7=Z |
| pc11 WAITPIN pin6==0 [repeat=7] | 0..131071 | 2..2 | pin6=Z pin7=Z |
| pc9 WAITPIN pin6==1 [repeat=6] | 0..131071 | 2..2 | pin6=Z pin7=Z |
| pc11 WAITPIN pin6==0 [repeat=6] | 0..131071 | 2..2 | pin6=Z pin7=Z |
| pc9 WAITPIN pin6==1 [repeat=5] | 0..131071 | 2..2 | pin6=Z pin7=Z |
| pc11 WAITPIN pin6==0 [repeat=5] | 0..131071 | 2..2 | pin6=Z pin7=Z |
| pc9 WAITPIN pin6==1 [repeat=4] | 0..131071 | 2..2 | pin6=Z pin7=Z |
| pc11 WAITPIN pin6==0 [repeat=4] | 0..131071 | 2..2 | pin6=Z pin7=Z |
| pc9 WAITPIN pin6==1 [repeat=3] | 0..131071 | 2..2 | pin6=Z pin7=Z |
| pc11 WAITPIN pin6==0 [repeat=3] | 0..131071 | 2..2 | pin6=Z pin7=Z |
| pc9 WAITPIN pin6==1 [repeat=2] | 0..131071 | 2..2 | pin6=Z pin7=Z |
| pc11 WAITPIN pin6==0 [repeat=2] | 0..131071 | 2..2 | pin6=Z pin7=Z |
| pc9 WAITPIN pin6==1 [repeat=1] | 0..131071 | 2..2 | pin6=Z pin7=Z |
| pc11 WAITPIN pin6==0 [repeat=1] | 0..131071 | 2..2 | pin6=Z pin7=Z |
| pc9 WAITPIN pin6==1 | 0..131071 | 2..2 | pin6=Z pin7=Z |
| pc11 WAITPIN pin6==0 | 0..131071 | 5..6 | pin6=Z pin7=Z |
| pc18 PULL | 0..inf | 3..3 | pin6=0 pin7=0|Z |
| pc21 WAITPIN pin6==1 | 2..131071 | 1..1 | pin6=Z pin7=0|Z |
| pc22 WAITPIN pin6==0 | 0..131071 | 6..6 | pin6=Z pin7=0|Z |

### Pin spacing

- pin6: exact spacings {}; across boundaries [('3', 'inf'), ('90', '5505070')]; minimum 3
- pin7: exact spacings {1: 2, 3: 2}; across boundaries [('4', '262146'), ('49', '3145753'), ('8', 'inf')]; minimum 1

### Loop periods

- pc3 `WAITPIN pin7==1` via JMP@pc38: 93..inf (x2)
- pc9 `WAITPIN pin6==1` via LOOP@pc12: 4..262146 (x14), 65..inf (x2)
- pc27 `OUT pin7 msb` via LOOP@pc30: 4..262146 (x8), 65..inf (x1)

### Edge schedules

```
  from START v0:
    +4      pc3   arrive WAITPIN pin7==1
  from pc3 WAITPIN pin7==1 v0 (+1 identical contexts):
    +1      pc4   arrive WAITPIN pin6==1
  from pc4 WAITPIN pin6==1 v0 (+1 identical contexts):
    +1      pc5   arrive WAITPIN pin7==0
  from pc5 WAITPIN pin7==0 v0 (+1 identical contexts):
    +1      pc6   arrive WAITPIN pin6==0
  from pc6 WAITPIN pin6==0 v0 (+1 identical contexts):
    +3      pc9   arrive WAITPIN pin6==1
  from pc9 WAITPIN pin6==1 [repeat=7] v0 (+15 identical contexts):
    +1      pc10  sample pin7
    +2      pc11  arrive WAITPIN pin6==0
  from pc11 WAITPIN pin6==0 [repeat=7] v0 (+13 identical contexts):
    +2      pc9   arrive WAITPIN pin6==1
  from pc11 WAITPIN pin6==0 v0 (+1 identical contexts):
    end: fault66 at +5
  from pc11 WAITPIN pin6==0 v1:
    +5      pc17  pin6 Z->0
    +5      pc17  pin7 Z->0
    +6      pc18  arrive PULL
  from pc18 PULL v0 (+1 identical contexts):
    +2      pc20  pin6 0->Z
    +3      pc21  arrive WAITPIN pin6==1
  from pc21 WAITPIN pin6==1 v0 (+1 identical contexts):
    +1      pc22  arrive WAITPIN pin6==0
  from pc22 WAITPIN pin6==0 v0:
    +1      pc23  pin7 0->Z
    +4      pc26  pin7 Z->0
    +5      pc27  pin7 0->0|Z
    +6      pc28  arrive WAITPIN pin6==1
  from pc28 WAITPIN pin6==1 [repeat=7] v0 (+7 identical contexts):
    +1      pc29  arrive WAITPIN pin6==0
  from pc29 WAITPIN pin6==0 [repeat=7] v0 (+6 identical contexts):
    +2      pc27  pin7 0|Z->0|Z
    +3      pc28  arrive WAITPIN pin6==1
  from pc29 WAITPIN pin6==0 v0:
    +2      pc31  pin7 0|Z->Z
    +3      pc32  arrive WAITPIN pin6==1
  from pc32 WAITPIN pin6==1 v0:
    +1      pc33  sample pin7
    +2      pc34  arrive WAITPIN pin6==0
  from pc34 WAITPIN pin6==0 v0:
    +2      pc36  arrive WAITPIN pin6==1
  from pc34 WAITPIN pin6==0 v1:
    end: fault67 at +2
  from pc36 WAITPIN pin6==1 v0:
    +1      pc37  arrive WAITPIN pin7==1
  from pc37 WAITPIN pin7==1 v0:
    +2      pc3   arrive WAITPIN pin7==1
  from pc11 WAITPIN pin6==0 v1:
    +5      pc17  pin6 Z->0
    +5      pc17  pin7 Z->0|Z
    +6      pc18  arrive PULL
  from pc22 WAITPIN pin6==0 v0:
    +1      pc23  pin7 0|Z->Z
    +4      pc26  pin7 Z->0|Z
    +5      pc27  pin7 0|Z->0|Z
    +6      pc28  arrive WAITPIN pin6==1
```

## i2c-target-write

Engine 3, owned 0xc0, open-drain 0xc0, fused, 50 MHz annotation. Notes: "I2C 7-bit target address0x42, pins SCL6/SDA7 with external pull-ups; one data byte per START/STOP transaction." "Controller must supply each low/high phase at least 16 system clocks and honor stretching. Target stretches before address ACK for TX availability and before data ACK for RX space." "Different address/direction faults66 and releases bus; this is a dedicated point-to-point target example, not a multi-address shared-bus target." "Write accepts one byte, ACKs after RX enqueue, then requires STOP." "Repeated START and multi-byte target framing are outside this example's contract; controller firmware provides repeated START."

### Checks

- **PASS** `identity`: bytecode sha256 matches, source sha256 matches
- **PASS** `assembler-timing-table`: 37 per-instruction entries (minimum_cycles, blocking) agree with the ISA cost model
- **PASS** `exact-analysis`: 48 boundary contexts, 49 path variants, no widening or budget cut
- **PASS** `no-self-deadlock`: no WAITPIN waits for a level the engine itself forces
- **PASS** `reachable-faults`: only explicit FAULT codes [66] reachable
- **INFO** `bounded-waits`: 14 WAITPIN/WAITEVENT contexts; LIMIT values [131072]; longest bounded stall 131071 cycles (2621.420 us at 50 MHz) before fault 3
- **INFO** `holding-points`: unbounded FIFO waits hold: pc29 PUSH [pin6=0 pin7=0]
- **PASS** `i2c-target-sda-latency`: SDA driven 7..8 cycles after SCL falls (input latency included); controller keeps SCL low >= 16 cycles: tSU;DAT margin 8 cycles (160.0 ns at 50 MHz); declared: "Controller must supply each low/high phase at least 16 system clocks and honor stretching. Target stretches before address ACK for TX availability and before data ACK for RX space."
- **PASS** `i2c-target-sda-only-after-scl-low`: the target changes SDA only after observing SCL low (or while stretching SCL)
- **PASS** `i2c-target-rearm`: after each observed edge the firmware reaches the next pin wait within 4 cycles, or grabs SCL (stretch) within 7..8 cycles of the edge; both <= 16 (margin 8)
- **PASS** `i2c-target-sample-hold`: SDA sampled from the pad 1..2 cycles after SCL rises (data held by the controller >= 16 cycles; margin 14)
- **PASS** `i2c-target-stretch-at-holding`: SCL held low (clock stretch) at every FIFO holding point

### Boundaries

| boundary (context) | stall min..max | segment BCET..WCET | holding pads |
|---|---|---|---|
| START | 0..0 | 4..4 | pin6=Z pin7=Z |
| pc3 WAITPIN pin7==1 | 0..131071 | 1..1 | pin6=Z pin7=Z |
| pc4 WAITPIN pin6==1 | 0..131071 | 1..1 | pin6=Z pin7=Z |
| pc5 WAITPIN pin7==0 | 0..131071 | 1..1 | pin6=Z pin7=Z |
| pc6 WAITPIN pin6==0 | 0..131071 | 3..3 | pin6=Z pin7=Z |
| pc9 WAITPIN pin6==1 [repeat=7] | 0..131071 | 2..2 | pin6=Z pin7=Z |
| pc11 WAITPIN pin6==0 [repeat=7] | 0..131071 | 2..2 | pin6=Z pin7=Z |
| pc9 WAITPIN pin6==1 [repeat=6] | 0..131071 | 2..2 | pin6=Z pin7=Z |
| pc11 WAITPIN pin6==0 [repeat=6] | 0..131071 | 2..2 | pin6=Z pin7=Z |
| pc9 WAITPIN pin6==1 [repeat=5] | 0..131071 | 2..2 | pin6=Z pin7=Z |
| pc11 WAITPIN pin6==0 [repeat=5] | 0..131071 | 2..2 | pin6=Z pin7=Z |
| pc9 WAITPIN pin6==1 [repeat=4] | 0..131071 | 2..2 | pin6=Z pin7=Z |
| pc11 WAITPIN pin6==0 [repeat=4] | 0..131071 | 2..2 | pin6=Z pin7=Z |
| pc9 WAITPIN pin6==1 [repeat=3] | 0..131071 | 2..2 | pin6=Z pin7=Z |
| pc11 WAITPIN pin6==0 [repeat=3] | 0..131071 | 2..2 | pin6=Z pin7=Z |
| pc9 WAITPIN pin6==1 [repeat=2] | 0..131071 | 2..2 | pin6=Z pin7=Z |
| pc11 WAITPIN pin6==0 [repeat=2] | 0..131071 | 2..2 | pin6=Z pin7=Z |
| pc9 WAITPIN pin6==1 [repeat=1] | 0..131071 | 2..2 | pin6=Z pin7=Z |
| pc11 WAITPIN pin6==0 [repeat=1] | 0..131071 | 2..2 | pin6=Z pin7=Z |
| pc9 WAITPIN pin6==1 | 0..131071 | 2..2 | pin6=Z pin7=Z |
| pc11 WAITPIN pin6==0 | 0..131071 | 5..7 | pin6=Z pin7=Z |
| pc19 WAITPIN pin6==1 | 0..131071 | 1..1 | pin6=Z pin7=0 |
| pc20 WAITPIN pin6==0 | 0..131071 | 4..4 | pin6=Z pin7=0 |
| pc24 WAITPIN pin6==1 [repeat=7] | 0..131071 | 2..2 | pin6=Z pin7=Z |
| pc26 WAITPIN pin6==0 [repeat=7] | 0..131071 | 2..2 | pin6=Z pin7=Z |
| pc24 WAITPIN pin6==1 [repeat=6] | 0..131071 | 2..2 | pin6=Z pin7=Z |
| pc26 WAITPIN pin6==0 [repeat=6] | 0..131071 | 2..2 | pin6=Z pin7=Z |
| pc24 WAITPIN pin6==1 [repeat=5] | 0..131071 | 2..2 | pin6=Z pin7=Z |
| pc26 WAITPIN pin6==0 [repeat=5] | 0..131071 | 2..2 | pin6=Z pin7=Z |
| pc24 WAITPIN pin6==1 [repeat=4] | 0..131071 | 2..2 | pin6=Z pin7=Z |
| pc26 WAITPIN pin6==0 [repeat=4] | 0..131071 | 2..2 | pin6=Z pin7=Z |
| pc24 WAITPIN pin6==1 [repeat=3] | 0..131071 | 2..2 | pin6=Z pin7=Z |
| pc26 WAITPIN pin6==0 [repeat=3] | 0..131071 | 2..2 | pin6=Z pin7=Z |
| pc24 WAITPIN pin6==1 [repeat=2] | 0..131071 | 2..2 | pin6=Z pin7=Z |
| pc26 WAITPIN pin6==0 [repeat=2] | 0..131071 | 2..2 | pin6=Z pin7=Z |
| pc24 WAITPIN pin6==1 [repeat=1] | 0..131071 | 2..2 | pin6=Z pin7=Z |
| pc26 WAITPIN pin6==0 [repeat=1] | 0..131071 | 2..2 | pin6=Z pin7=Z |
| pc24 WAITPIN pin6==1 | 0..131071 | 2..2 | pin6=Z pin7=Z |
| pc26 WAITPIN pin6==0 | 0..131071 | 3..3 | pin6=Z pin7=Z |
| pc29 PUSH | 0..inf | 2..2 | pin6=0 pin7=0 |
| pc31 WAITPIN pin6==1 | 0..131071 | 1..1 | pin6=Z pin7=0 |
| pc32 WAITPIN pin6==0 | 0..131071 | 2..2 | pin6=Z pin7=0 |
| pc34 WAITPIN pin6==1 | 0..131071 | 1..1 | pin6=Z pin7=Z |
| pc35 WAITPIN pin7==1 | 0..131071 | 2..2 | pin6=Z pin7=Z |
| pc3 WAITPIN pin7==1 | 0..131071 | 1..1 | pin6=Z pin7=Z |
| pc4 WAITPIN pin6==1 | 0..131071 | 1..1 | pin6=Z pin7=Z |
| pc5 WAITPIN pin7==0 | 0..131071 | 1..1 | pin6=Z pin7=Z |
| pc6 WAITPIN pin6==0 | 0..131071 | 3..3 | pin6=Z pin7=Z |

### Pin spacing

- pin6: exact spacings {1: 1}; across boundaries [('2', 'inf'), ('38', '2359316'), ('48', '3145752')]; minimum 1
- pin7: exact spacings {}; across boundaries [('35', '2097171'), ('4', '262146'), ('45', '2883607'), ('5', 'inf')]; minimum 4

### Loop periods

- pc3 `WAITPIN pin7==1` via JMP@pc36: 89..inf (x2)
- pc9 `WAITPIN pin6==1` via LOOP@pc12: 4..262146 (x8), 61..inf (x1)
- pc24 `WAITPIN pin6==1` via LOOP@pc27: 4..262146 (x7), 61..inf (x1)

### Edge schedules

```
  from START v0:
    +4      pc3   arrive WAITPIN pin7==1
  from pc3 WAITPIN pin7==1 v0 (+1 identical contexts):
    +1      pc4   arrive WAITPIN pin6==1
  from pc4 WAITPIN pin6==1 v0 (+1 identical contexts):
    +1      pc5   arrive WAITPIN pin7==0
  from pc5 WAITPIN pin7==0 v0 (+1 identical contexts):
    +1      pc6   arrive WAITPIN pin6==0
  from pc6 WAITPIN pin6==0 v0 (+1 identical contexts):
    +3      pc9   arrive WAITPIN pin6==1
  from pc9 WAITPIN pin6==1 [repeat=7] v0 (+7 identical contexts):
    +1      pc10  sample pin7
    +2      pc11  arrive WAITPIN pin6==0
  from pc11 WAITPIN pin6==0 [repeat=7] v0 (+6 identical contexts):
    +2      pc9   arrive WAITPIN pin6==1
  from pc11 WAITPIN pin6==0 v0:
    end: fault66 at +5
  from pc11 WAITPIN pin6==0 v1:
    +5      pc17  pin6 Z->0
    +5      pc17  pin7 Z->0
    +6      pc18  pin6 0->Z
    +7      pc19  arrive WAITPIN pin6==1
  from pc19 WAITPIN pin6==1 v0:
    +1      pc20  arrive WAITPIN pin6==0
  from pc20 WAITPIN pin6==0 v0:
    +1      pc21  pin7 0->Z
    +4      pc24  arrive WAITPIN pin6==1
  from pc24 WAITPIN pin6==1 [repeat=7] v0 (+7 identical contexts):
    +1      pc25  sample pin7
    +2      pc26  arrive WAITPIN pin6==0
  from pc26 WAITPIN pin6==0 [repeat=7] v0 (+6 identical contexts):
    +2      pc24  arrive WAITPIN pin6==1
  from pc26 WAITPIN pin6==0 v0:
    +2      pc28  pin6 Z->0
    +2      pc28  pin7 Z->0
    +3      pc29  arrive PUSH
  from pc29 PUSH v0:
    +1      pc30  pin6 0->Z
    +2      pc31  arrive WAITPIN pin6==1
  from pc31 WAITPIN pin6==1 v0:
    +1      pc32  arrive WAITPIN pin6==0
  from pc32 WAITPIN pin6==0 v0:
    +1      pc33  pin7 0->Z
    +2      pc34  arrive WAITPIN pin6==1
  from pc34 WAITPIN pin6==1 v0:
    +1      pc35  arrive WAITPIN pin7==1
  from pc35 WAITPIN pin7==1 v0:
    +2      pc3   arrive WAITPIN pin7==1
```

## i2c-write

Engine 3, owned 0xc0, open-drain 0xc0, fused, 50 MHz annotation. Notes: "I2C controller pins SCL6/SDA7, external pull-ups required. SCL release always waits for synchronized high and LIMIT bounds stretching." "TX words: address+W then one data byte; an address or data NACK ends the transaction with STOP, completed by the fault65 pin release." "Single-controller bus only; no arbitration-loss detection. Queue a complete transaction: the first PULL waits with the bus idle, later PULL/PUSH holding points keep SCL low." "Declared I2C bus speed at the 50000000 Hz annotation: Fast-mode Plus (UM10204 Table 11; SCL low >= 35 and high >= 36 clocks, START/repeated-START/STOP set-up and hold >= 34 clocks, bus free >= 72 clocks, SDA held >= 2 clocks after SCL falls); Fast-mode needs half-period >= 62; Standard-mode needs half-period >= 247."

### Checks

- **PASS** `identity`: bytecode sha256 matches, source sha256 matches
- **PASS** `assembler-timing-table`: 60 per-instruction entries (minimum_cycles, blocking) agree with the ISA cost model
- **PASS** `exact-analysis`: 25 boundary contexts, 27 path variants, no widening or budget cut
- **PASS** `no-self-deadlock`: no WAITPIN waits for a level the engine itself forces
- **PASS** `reachable-faults`: only explicit FAULT codes [65] reachable
- **INFO** `bounded-waits`: 7 WAITPIN/WAITEVENT contexts; LIMIT values [131072]; longest bounded stall 131071 cycles (2621.420 us at 50 MHz) before fault 3
- **INFO** `holding-points`: unbounded FIFO waits hold: pc2 PULL [pin6=Z pin7=Z]; pc31 PULL [pin6=0 pin7=0]
- **PASS** `i2c-open-drain`: SCL/SDA are open-drain and never driven high (pull-ups define the high level)
- **PASS** `i2c-stretch-safe`: every SCL release is followed by WAITPIN SCL==1 before SCL is driven low again (clock stretching honoured; LIMIT bounds it)
- **PASS** `i2c-sda-only-while-scl-low`: SDA changes only while SCL is held low, except START/STOP conditions
- **PASS** `i2c-scl-low-phase`: SCL low phases (cycles: occurrences) {'37': 1, '36': 17, '38': 1, '41..inf': 1}; every phase >= half-period 32 (docs/firmware.md default)
- **INFO** `i2c-bus-timing-cycles`: tLOW >= 36; tHIGH >= 36; tHD;STA >= 34; tSU;STA >= 37; tSU;STO >= 37; tBUF >= 72; tSU;DAT >= 34; tHD;DAT >= 2; fSCL_period >= 72; tVD;DAT <= 4 cycles (tHIGH/tSU;STA/tSU;STO counted from the synchronized observation of SCL high, +2 cycles input latency; stretch-aware)
- **INFO** `i2c-Sm`: UM10204 Sm: met for clocks 1.16..7.2 MHz (limited by fSCL_period); at 50 MHz FAIL; 10MHz FAIL, 25MHz FAIL, 50MHz FAIL, 66MHz FAIL, 100MHz FAIL
- **INFO** `i2c-Fm`: UM10204 Fm: met for clocks 4.44..27.7 MHz (limited by tLOW); at 50 MHz FAIL; 10MHz PASS, 25MHz PASS, 50MHz FAIL, 66MHz FAIL, 100MHz FAIL
- **INFO** `i2c-Fm+`: UM10204 Fm+: met for clocks 8.89..72 MHz (limited by fSCL_period); at 50 MHz PASS; 10MHz PASS, 25MHz PASS, 50MHz PASS, 66MHz PASS, 100MHz FAIL

### Boundaries

| boundary (context) | stall min..max | segment BCET..WCET | holding pads |
|---|---|---|---|
| START | 0..0 | 3..3 | pin6=Z pin7=Z |
| pc2 PULL | 0..inf | 2..2 | pin6=Z pin7=Z |
| pc4 WAITPIN pin6==1 | 0..131071 | 1..1 | pin6=Z pin7=Z |
| pc5 WAITPIN pin7==1 | 0..131071 | 106..106 | pin6=Z pin7=Z |
| pc15 WAITPIN pin6==1 [repeat=7] | 2..131071 | 71..71 | pin6=Z pin7=0|Z |
| pc15 WAITPIN pin6==1 [repeat=6] | 2..131071 | 71..71 | pin6=Z pin7=0|Z |
| pc15 WAITPIN pin6==1 [repeat=5] | 2..131071 | 71..71 | pin6=Z pin7=0|Z |
| pc15 WAITPIN pin6==1 [repeat=4] | 2..131071 | 71..71 | pin6=Z pin7=0|Z |
| pc15 WAITPIN pin6==1 [repeat=3] | 2..131071 | 71..71 | pin6=Z pin7=0|Z |
| pc15 WAITPIN pin6==1 [repeat=2] | 2..131071 | 71..71 | pin6=Z pin7=0|Z |
| pc15 WAITPIN pin6==1 [repeat=1] | 2..131071 | 71..71 | pin6=Z pin7=0|Z |
| pc15 WAITPIN pin6==1 | 2..131071 | 71..71 | pin6=Z pin7=0|Z |
| pc22 WAITPIN pin6==1 | 2..131071 | 40..75 | pin6=Z pin7=Z |
| pc53 WAITPIN pin6==1 | 2..131071 | 35..70 | pin6=Z pin7=0 |
| pc31 PULL | 0..inf | 38..38 | pin6=0 pin7=0 |
| pc2 PULL | 0..inf | 2..2 | pin6=Z pin7=Z |
| pc37 WAITPIN pin6==1 [repeat=7] | 2..131071 | 71..71 | pin6=Z pin7=0|Z |
| pc37 WAITPIN pin6==1 [repeat=6] | 2..131071 | 71..71 | pin6=Z pin7=0|Z |
| pc37 WAITPIN pin6==1 [repeat=5] | 2..131071 | 71..71 | pin6=Z pin7=0|Z |
| pc37 WAITPIN pin6==1 [repeat=4] | 2..131071 | 71..71 | pin6=Z pin7=0|Z |
| pc37 WAITPIN pin6==1 [repeat=3] | 2..131071 | 71..71 | pin6=Z pin7=0|Z |
| pc37 WAITPIN pin6==1 [repeat=2] | 2..131071 | 71..71 | pin6=Z pin7=0|Z |
| pc37 WAITPIN pin6==1 [repeat=1] | 2..131071 | 71..71 | pin6=Z pin7=0|Z |
| pc37 WAITPIN pin6==1 | 2..131071 | 71..71 | pin6=Z pin7=0|Z |
| pc44 WAITPIN pin6==1 | 2..131071 | 73..73 | pin6=Z pin7=Z |

### Pin spacing

- pin6: exact spacings {36: 17, 37: 1, 38: 1}; across boundaries [('144', 'inf'), ('37', '131106'), ('39', '131108'), ('41', 'inf')]; minimum 36
- pin7: exact spacings {37: 1}; across boundaries [('4', 'inf'), ('72', '131141'), ('72', 'inf'), ('73', '131142'), ('75', '131144'), ('76', '131146')]; minimum 4

### Loop periods

- pc2 `PULL` via JMP@pc59: 842..inf (x2)
- pc12 `OUT pin7 msb` via LOOP@pc18: 73..131142 (x7), 331..inf (x1)
- pc34 `OUT pin7 msb` via LOOP@pc40: 73..131142 (x7), 993..inf (x1)

### Edge schedules

```
  from START v0:
    +3      pc2   arrive PULL
  from pc2 PULL v0 (+1 identical contexts):
    +2      pc4   arrive WAITPIN pin6==1
  from pc4 WAITPIN pin6==1 v0:
    +1      pc5   arrive WAITPIN pin7==1
  from pc5 WAITPIN pin7==1 v0:
    +34     pc7   pin7 Z->0
    +68     pc9   pin6 Z->0
    +71     pc12  pin7 0->0|Z
    +105    pc14  pin6 0->Z
    +106    pc15  arrive WAITPIN pin6==1
  from pc15 WAITPIN pin6==1 [repeat=7] v0 (+6 identical contexts):
    +34     pc17  pin6 Z->0
    +36     pc12  pin7 0|Z->0|Z
    +70     pc14  pin6 0->Z
    +71     pc15  arrive WAITPIN pin6==1
  from pc15 WAITPIN pin6==1 v0:
    +34     pc17  pin6 Z->0
    +36     pc19  pin7 0|Z->Z
    +70     pc21  pin6 0->Z
    +71     pc22  arrive WAITPIN pin6==1
  from pc22 WAITPIN pin6==1 v0:
    +35     pc25  sample pin7
    +36     pc26  pin6 Z->0
    +40     pc50  pin7 Z->0
    +74     pc52  pin6 0->Z
    +75     pc53  arrive WAITPIN pin6==1
  from pc22 WAITPIN pin6==1 v1:
    +35     pc25  sample pin7
    +36     pc26  pin6 Z->0
    +39     pc30  pin7 Z->0
    +40     pc31  arrive PULL
  from pc53 WAITPIN pin6==1 v0:
    +35     pc56  pin7 0->Z
    end: fault65 at +35
  from pc53 WAITPIN pin6==1 v1:
    +35     pc57  pin7 0->Z
    +70     pc2   arrive PULL
  from pc31 PULL v0:
    +3      pc34  pin7 0->0|Z
    +37     pc36  pin6 0->Z
    +38     pc37  arrive WAITPIN pin6==1
  from pc37 WAITPIN pin6==1 [repeat=7] v0 (+6 identical contexts):
    +34     pc39  pin6 Z->0
    +36     pc34  pin7 0|Z->0|Z
    +70     pc36  pin6 0->Z
    +71     pc37  arrive WAITPIN pin6==1
  from pc37 WAITPIN pin6==1 v0:
    +34     pc39  pin6 Z->0
    +36     pc41  pin7 0|Z->Z
    +70     pc43  pin6 0->Z
    +71     pc44  arrive WAITPIN pin6==1
  from pc44 WAITPIN pin6==1 v0:
    +35     pc47  sample pin7
    +36     pc48  pin6 Z->0
    +38     pc50  pin7 Z->0
    +72     pc52  pin6 0->Z
    +73     pc53  arrive WAITPIN pin6==1
```

## jtag

Engine 0, owned 0x0b, open-drain 0x00, fused, 50 MHz annotation. Notes: "JTAG pins TCK0/TDI1/TDO2/TMS3: TAP reset, enter Shift-DR, stream LSB-first eight-bit scan chunks indefinitely." "Scan-only fixture: no device-specific IR commands or update/exit sequence; halt releases outputs. Use a source program for full device TAP transactions."

### Checks

- **PASS** `identity`: bytecode sha256 matches, source sha256 matches
- **PASS** `assembler-timing-table`: 35 per-instruction entries (minimum_cycles, blocking) agree with the ISA cost model
- **PASS** `exact-analysis`: 4 boundary contexts, 4 path variants, no widening or budget cut
- **PASS** `no-self-deadlock`: no WAITPIN waits for a level the engine itself forces
- **PASS** `reachable-faults`: only explicit FAULT codes [] reachable
- **INFO** `holding-points`: unbounded FIFO waits hold: pc29 PULL [pin0=0 pin1=0 pin3=0]; pc29 PULL [pin0=0 pin1=0|1 pin3=0]; pc33 PUSH [pin0=0 pin1=0|1 pin3=0]
- **PASS** `jtag-tms-tdi-change-on-tck-low`: all 20 TMS/TDI writes happen while TCK is low
- **PASS** `jtag-setup-hold`: TMS/TDI setup to TCK rise >= 32 cycles, hold after TCK rise >= 32 cycles; TCK low/high phases >= 32 cycles
- **PASS** `jtag-tdo-sampling`: TDO sampled exactly on TCK rising edges; TDO launched on the falling edge must reach the pad within 30 cycles (600.0 ns at 50 MHz)
- **PASS** `jtag-tap-reset`: 6 TCK rising edges with TMS high before the first TMS low (>= 5 resets any TAP)

### Boundaries

| boundary (context) | stall min..max | segment BCET..WCET | holding pads |
|---|---|---|---|
| START | 0..0 | 695..695 | pin0=Z pin1=Z pin3=Z |
| pc29 PULL | 0..inf | 516..516 | pin0=0 pin1=0 pin3=0 |
| pc33 PUSH | 0..inf | 2..2 | pin0=0 pin1=0|1 pin3=0 |
| pc29 PULL | 0..inf | 516..516 | pin0=0 pin1=0|1 pin3=0 |

### Pin spacing

- pin0: exact spacings {32: 30, 34: 10, 35: 9, 36: 1}; across boundaries [('36', 'inf'), ('38', 'inf')]; minimum 32
- pin1: exact spacings {64: 14}; across boundaries [('695', 'inf'), ('70', 'inf')]; minimum 64
- pin3: exact spacings {2: 1, 69: 2, 414: 1}; across boundaries []; minimum 2

### Loop periods

- pc3 `SET 0x08` via LOOP@pc7: 69 (x5)
- pc29 `PULL` via JMP@pc34: 518..inf (x2)

### Edge schedules

```
  from START v0:
    +2      pc1   pin0 Z->0
    +2      pc1   pin1 Z->0
    +2      pc1   pin3 Z->0
    +4      pc3   pin3 0->1
    +38     pc5   pin0 0->1
    +73     pc3   pin0 1->0
    +107    pc5   pin0 0->1
    +142    pc3   pin0 1->0
    +176    pc5   pin0 0->1
    +211    pc3   pin0 1->0
    +245    pc5   pin0 0->1
    +280    pc3   pin0 1->0
    +314    pc5   pin0 0->1
    +349    pc3   pin0 1->0
    +383    pc5   pin0 0->1
    +418    pc8   pin0 1->0
    +418    pc8   pin3 1->0
    +452    pc10  pin0 0->1
    +486    pc12  pin0 1->0
    +487    pc13  pin3 0->1
    +521    pc15  pin0 0->1
    +555    pc17  pin0 1->0
    +556    pc18  pin3 1->0
    +590    pc20  pin0 0->1
    +624    pc22  pin0 1->0
    +659    pc25  pin0 0->1
    +693    pc27  pin0 1->0
    +695    pc29  arrive PULL
  from pc29 PULL v0:
    +2      pc31  pin1 0->0|1
    +34     pc31  pin0 0->1
    +34     pc31  sample pin2
    +66     pc31  pin0 1->0
    +66     pc31  pin1 0|1->0|1
    +98     pc31  pin0 0->1
    +98     pc31  sample pin2
    +130    pc31  pin0 1->0
    +130    pc31  pin1 0|1->0|1
    +162    pc31  pin0 0->1
    +162    pc31  sample pin2
    +194    pc31  pin0 1->0
    +194    pc31  pin1 0|1->0|1
    +226    pc31  pin0 0->1
    +226    pc31  sample pin2
    +258    pc31  pin0 1->0
    +258    pc31  pin1 0|1->0|1
    +290    pc31  pin0 0->1
    +290    pc31  sample pin2
    +322    pc31  pin0 1->0
    +322    pc31  pin1 0|1->0|1
    +354    pc31  pin0 0->1
    +354    pc31  sample pin2
    +386    pc31  pin0 1->0
    +386    pc31  pin1 0|1->0|1
    +418    pc31  pin0 0->1
    +418    pc31  sample pin2
    +450    pc31  pin0 1->0
    +450    pc31  pin1 0|1->0|1
    +482    pc31  pin0 0->1
    +482    pc31  sample pin2
    +514    pc31  pin0 1->0
    +516    pc33  arrive PUSH
  from pc33 PUSH v0:
    +2      pc29  arrive PULL
  from pc29 PULL v0:
    +2      pc31  pin1 0|1->0|1
    +34     pc31  pin0 0->1
    +34     pc31  sample pin2
    +66     pc31  pin0 1->0
    +66     pc31  pin1 0|1->0|1
    +98     pc31  pin0 0->1
    +98     pc31  sample pin2
    +130    pc31  pin0 1->0
    +130    pc31  pin1 0|1->0|1
    +162    pc31  pin0 0->1
    +162    pc31  sample pin2
    +194    pc31  pin0 1->0
    +194    pc31  pin1 0|1->0|1
    +226    pc31  pin0 0->1
    +226    pc31  sample pin2
    +258    pc31  pin0 1->0
    +258    pc31  pin1 0|1->0|1
    +290    pc31  pin0 0->1
    +290    pc31  sample pin2
    +322    pc31  pin0 1->0
    +322    pc31  pin1 0|1->0|1
    +354    pc31  pin0 0->1
    +354    pc31  sample pin2
    +386    pc31  pin0 1->0
    +386    pc31  pin1 0|1->0|1
    +418    pc31  pin0 0->1
    +418    pc31  sample pin2
    +450    pc31  pin0 1->0
    +450    pc31  pin1 0|1->0|1
    +482    pc31  pin0 0->1
    +482    pc31  sample pin2
    +514    pc31  pin0 1->0
    +516    pc33  arrive PUSH
```

## onewire-master

Engine 3, owned 0x80, open-drain 0x80, fused, 50 MHz annotation. Notes: "1-Wire bus master (Maxim AN126 operations, standard speed) on DQ pin7, open-drain; external pull-up required. TX word: bits 7..0 a byte; bit 8 set: reset and presence detect first. The byte is sent LSB first in 8 time slots that also sample DQ; RX word: the 8 sampled bits (the byte itself for a write, the slave's data when the byte is 0xFF)." "Reset at 50000000 Hz: DQ low 25000 clocks (500 us); presence sampled 3500 clocks (70 us) after release; first slot 25000 clocks (500 us) after release. No presence pulse: fault 96." "Time slot at 50000000 Hz: DQ low at 0; a 1 bit releases DQ at 300 clocks (6 us); DQ sampled 700 clocks (14 us) after the fall; a 0 bit releases DQ at 3250 clocks (65 us); next slot at 3750 clocks (75 us)." "DQ is released at every holding point (PULL, PUSH). The host checks CRCs. Scope: standard speed only; no overdrive, strong pull-up (parasite power) or alarm-presence handling."

### Checks

- **PASS** `identity`: bytecode sha256 matches, source sha256 matches
- **PASS** `assembler-timing-table`: 28 per-instruction entries (minimum_cycles, blocking) agree with the ISA cost model
- **PASS** `exact-analysis`: 6 boundary contexts, 12 path variants, no widening or budget cut
- **PASS** `no-self-deadlock`: no WAITPIN waits for a level the engine itself forces
- **PASS** `reachable-faults`: only explicit FAULT codes [96] reachable
- **INFO** `holding-points`: unbounded FIFO waits hold: pc2 PULL [pin7=Z]; pc26 PUSH [pin7=Z]
- **PASS** `onewire-schedule`: reset path: DQ low 25000, presence sample 3500 after release, first slot 25000 after release; 8 slots per byte on both paths: OUT (a 1 releases DQ) at [300], sample at [700], release at [3250], next slot at [3750] clocks (declared {'reset_low': 25000, 'presence': 3500, 'reset_high': 25000, 'release1': 300, 'sample': 700, 'release0': 3250, 'slot': 3750})
- **PASS** `onewire-reset`: DS18B20 limits at 50 MHz: reset low (tRSTL) 25000 clocks = 500.00 us (480.00 us..960.00 us; 20.00 us above the minimum, 460.00 us below the maximum); presence sample, pad value 3498 clocks = 69.96 us (60.00 us..75.00 us; 9960 ns above the minimum, 5040 ns below the maximum); release to first slot (tRSTH) 25000 clocks = 500.00 us (>= 480.00 us; 20.00 us above the minimum). all hold for clocks from 46.64 to 52.08 MHz. AN126 Table 1 uses 480.00 us low, samples 70.00 us after release and waits 480.00 us in total; the presence window is where every DS18B20 presence pulse (tPDHIGH 15-60 us, tPDLOW 60-240 us) holds DQ low
- **PASS** `onewire-slot`: DS18B20 limits at 50 MHz: write-1 low (tLOW1) 300 clocks = 6000 ns (1000 ns..15.00 us; 5000 ns above the minimum, 9000 ns below the maximum); write-0 low (tLOW0) 3250 clocks = 65.00 us (60.00 us..120.00 us; 5000 ns above the minimum, 55.00 us below the maximum); read sample, pad value (tRDV) 698 clocks = 13.96 us (<= 15.00 us; 1040 ns below the maximum); time slot (tSLOT) 3750 clocks = 75.00 us (60.00 us..120.00 us; 15.00 us above the minimum, 45.00 us below the maximum); recovery (tREC) 500 clocks = 10.00 us (>= 1000 ns; 9000 ns above the minimum); write-1 released before the slave's window 300 clocks = 6000 ns (<= 15.00 us; 9000 ns below the maximum); write-0 held through the slave's window 3250 clocks = 65.00 us (>= 60.00 us; 5000 ns above the minimum). all hold for clocks from 46.53 to 54.17 MHz. AN126 Table 1: write-1 low 6000 ns, write-0 low 60.00 us, sample 15.00 us after the fall, slot 70.00 us. Rise time after a release is not included
- **PASS** `onewire-open-drain`: DQ is only pulled low or released, released at every PULL/PUSH holding point and by fault 96; the shortest recovery from a release to the next fall, across bytes, is 500 clocks (10.00 us; tREC >= 1 us); 1-Wire sets no maximum time between slots

### Boundaries

| boundary (context) | stall min..max | segment BCET..WCET | holding pads |
|---|---|---|---|
| START | 0..0 | 3..3 | pin7=Z |
| pc2 PULL | 0..inf | 28506..80005 | pin7=Z |
| pc26 PUSH | 0..inf | 2..2 | pin7=Z |
| pc26 PUSH | 0..inf | 2..2 | pin7=Z |
| pc2 PULL | 0..inf | 28506..80005 | pin7=Z |
| pc2 PULL | 0..inf | 28506..80005 | pin7=Z |

### Pin spacing

- pin7: exact spacings {300: 48, 500: 42, 2950: 48, 25000: 9}; across boundaries [('507', 'inf')]; minimum 300

### Loop periods

- pc2 `PULL` via JMP@pc27: 30008..inf (x3)
- pc16 `SET 0x00` via LOOP@pc24: 3750 (x42), 3758..inf (x6)

### Edge schedules

```
  from START v0:
    +3      pc2   arrive PULL
  from pc2 PULL v0 (+2 identical contexts):
    +4      pc6   pin7 Z->0
    +25004  pc8   pin7 0->Z
    +28504  pc11  sample pin7
    end: fault96 at +28506
  from pc2 PULL v1 (+2 identical contexts):
    +4      pc6   pin7 Z->0
    +25004  pc8   pin7 0->Z
    +28504  pc11  sample pin7
    +50004  pc16  pin7 Z->0
    +50304  pc18  pin7 0->0|Z
    +50704  pc20  sample pin7
    +53254  pc22  pin7 0|Z->Z
    +53754  pc16  pin7 Z->0
    +54054  pc18  pin7 0->0|Z
    +54454  pc20  sample pin7
    +57004  pc22  pin7 0|Z->Z
    +57504  pc16  pin7 Z->0
    +57804  pc18  pin7 0->0|Z
    +58204  pc20  sample pin7
    +60754  pc22  pin7 0|Z->Z
    +61254  pc16  pin7 Z->0
    +61554  pc18  pin7 0->0|Z
    +61954  pc20  sample pin7
    +64504  pc22  pin7 0|Z->Z
    +65004  pc16  pin7 Z->0
    +65304  pc18  pin7 0->0|Z
    +65704  pc20  sample pin7
    +68254  pc22  pin7 0|Z->Z
    +68754  pc16  pin7 Z->0
    +69054  pc18  pin7 0->0|Z
    +69454  pc20  sample pin7
    +72004  pc22  pin7 0|Z->Z
    +72504  pc16  pin7 Z->0
    +72804  pc18  pin7 0->0|Z
    +73204  pc20  sample pin7
    +75754  pc22  pin7 0|Z->Z
    +76254  pc16  pin7 Z->0
    +76554  pc18  pin7 0->0|Z
    +76954  pc20  sample pin7
    +79504  pc22  pin7 0|Z->Z
    +80005  pc26  arrive PUSH
  from pc2 PULL v2 (+2 identical contexts):
    +5      pc16  pin7 Z->0
    +305    pc18  pin7 0->0|Z
    +705    pc20  sample pin7
    +3255   pc22  pin7 0|Z->Z
    +3755   pc16  pin7 Z->0
    +4055   pc18  pin7 0->0|Z
    +4455   pc20  sample pin7
    +7005   pc22  pin7 0|Z->Z
    +7505   pc16  pin7 Z->0
    +7805   pc18  pin7 0->0|Z
    +8205   pc20  sample pin7
    +10755  pc22  pin7 0|Z->Z
    +11255  pc16  pin7 Z->0
    +11555  pc18  pin7 0->0|Z
    +11955  pc20  sample pin7
    +14505  pc22  pin7 0|Z->Z
    +15005  pc16  pin7 Z->0
    +15305  pc18  pin7 0->0|Z
    +15705  pc20  sample pin7
    +18255  pc22  pin7 0|Z->Z
    +18755  pc16  pin7 Z->0
    +19055  pc18  pin7 0->0|Z
    +19455  pc20  sample pin7
    +22005  pc22  pin7 0|Z->Z
    +22505  pc16  pin7 Z->0
    +22805  pc18  pin7 0->0|Z
    +23205  pc20  sample pin7
    +25755  pc22  pin7 0|Z->Z
    +26255  pc16  pin7 Z->0
    +26555  pc18  pin7 0->0|Z
    +26955  pc20  sample pin7
    +29505  pc22  pin7 0|Z->Z
    +30006  pc26  arrive PUSH
  from pc26 PUSH v0 (+1 identical contexts):
    +2      pc2   arrive PULL
```

## ps2-device

Engine 2, owned 0x30, open-drain 0x30, fused, 50 MHz annotation. Notes: "PS/2 device-to-host transmitter (keyboard or mouse side) on CLK pin4 and DATA pin5, open-drain; external pull-ups required (a 5 V host needs level shifting to the 3.3 V pads). TX word: a byte in bits 7..0, sent as an 11-bit frame: start 0, 8 data bits LSB first, odd parity, stop 1." "Before each frame: WAITPIN CLK high, WAITPIN DATA high, then 56 CLK samples 50 clocks apart (1 us at 50000000 Hz, 55 us from first to last) must all read high, or the wait starts again." "Timing at 50000000 Hz: DATA change to CLK fall 1000 clocks (20 us), CLK low 2000 clocks (40 us), CLK rise to DATA change 1000 clocks (20 us), CLK high 2000 clocks (40 us): 12.5 kHz." "Inhibit: CLK is sampled before each of the 11 CLK falls; if the host holds it low, the device releases both lines and retransmits the same frame after the idle check. No check after the 11th clock. The CLK-high and DATA-high waits are bounded by LIMIT 16777215 (335.5 ms at 50000000 Hz): a longer inhibit or request-to-send ends in fault 3." "Scope: device-to-host only. This image does not receive host-to-device commands: PULL is the only TX-queue test of the design-of-record ISA and it blocks, so one engine cannot wait for a queued byte and a host request-to-send at the same time."

### Checks

- **PASS** `identity`: bytecode sha256 matches, source sha256 matches
- **PASS** `assembler-timing-table`: 45 per-instruction entries (minimum_cycles, blocking) agree with the ISA cost model
- **PASS** `exact-analysis`: 18 boundary contexts, 31 path variants, no widening or budget cut
- **PASS** `no-self-deadlock`: no WAITPIN waits for a level the engine itself forces
- **PASS** `reachable-faults`: only explicit FAULT codes [] reachable
- **INFO** `bounded-waits`: 2 WAITPIN/WAITEVENT contexts; LIMIT values [16777215]; longest bounded stall 16777214 cycles (335544.280 us at 50 MHz) before fault 3
- **INFO** `holding-points`: unbounded FIFO waits hold: pc1 PULL [pin4=Z pin5=Z]
- **PASS** `ps2-frame`: one frame without inhibit (12 segments joined at zero stall): 11 DATA changes (OUT, LSB first), each followed by a CLK fall and a CLK release: 11 clock pulses. Start, parity and stop values are computed from the TX byte (checked at the pins by test/test_protocols_ext.py)
- **PASS** `ps2-frame-timing`: inside a frame, exact in every bit: data_to_fall [1000], low [2000], high [2000], rise_to_data [1000], period [4000] clocks; declared data_to_fall 1000, low 2000, rise_to_data 1000, high 2000
- **PASS** `ps2-spec-timing`: PS/2 device-to-host limits (Chapweske) at 50 MHz: CLK low 2000 clocks = 40.00 us (30.00 us..50.00 us; 10.00 us above the minimum, 10.00 us below the maximum); CLK high 2000 clocks = 40.00 us (30.00 us..50.00 us; 10.00 us above the minimum, 10.00 us below the maximum); CLK period 4000 clocks = 80.00 us (59.88 us..100.00 us; 20.12 us above the minimum, 20.00 us below the maximum); CLK rise to DATA change 1000 clocks = 20.00 us (>= 5000 ns; 15.00 us above the minimum); DATA change to CLK fall 1000 clocks = 20.00 us (5000 ns..25.00 us; 15.00 us above the minimum, 5000 ns below the maximum). all hold for clocks from 40.00 to 66.67 MHz
- **PASS** `ps2-idle-before-frame`: PS/2 device-to-host limits (Chapweske) at 50 MHz: CLK sampled high 2750 clocks = 55.00 us (>= 50.00 us; 5000 ns above the minimum). all hold for clocks from 0.00 to 55.00 MHz. 56 CLK samples [50] clocks apart after WAITPIN CLK and WAITPIN DATA, all high, span 2750 clocks; the start bit follows the last sample by 8 clocks. Between samples the line is not observed: a low pulse shorter than 50 clocks can be missed (a host inhibit lasts at least 100 us)
- **PASS** `ps2-inhibit`: CLK is sampled 2 clocks before each of the 11 CLK falls (the pad value 4 clocks before the fall) and not after the 11th; a low sample branches to the retry path, which releases CLK and DATA and waits for the idle bus (11 abort paths, WAITPIN reached 5 clocks later at most, no CLK fall on the way). The idle waits are bounded by LIMIT 16777215 (335.5 ms at 50 MHz), then fault 3
- **PASS** `ps2-open-drain`: CLK and DATA are only pulled low or released (no pad state drives high) and both are released at the PULL holding point

### Boundaries

| boundary (context) | stall min..max | segment BCET..WCET | holding pads |
|---|---|---|---|
| START | 0..0 | 2..2 | pin4=Z pin5=Z |
| pc1 PULL | 0..inf | 42..42 | pin4=Z pin5=Z |
| pc22 WAITPIN pin4==1 [repeat=55] | 0..16777214 | 1..1 | pin4=Z pin5=Z |
| pc23 WAITPIN pin5==1 [repeat=55] | 0..16777214 | 2806..3805 | pin4=Z pin5=Z |
| pc37 JZ rx, 18 <retry> [repeat=10] | 0..0 | 5..4000 | pin4=Z pin5=0|Z |
| pc22 WAITPIN pin4==1 [repeat=55] | 0..16777214 | 1..1 | pin4=Z pin5=Z |
| pc37 JZ rx, 18 <retry> [repeat=9] | 0..0 | 5..4000 | pin4=Z pin5=0|Z |
| pc23 WAITPIN pin5==1 [repeat=55] | 0..16777214 | 2806..3805 | pin4=Z pin5=Z |
| pc37 JZ rx, 18 <retry> [repeat=8] | 0..0 | 5..4000 | pin4=Z pin5=0|Z |
| pc37 JZ rx, 18 <retry> [repeat=7] | 0..0 | 5..4000 | pin4=Z pin5=0|Z |
| pc37 JZ rx, 18 <retry> [repeat=6] | 0..0 | 5..4000 | pin4=Z pin5=0|Z |
| pc37 JZ rx, 18 <retry> [repeat=5] | 0..0 | 5..4000 | pin4=Z pin5=0|Z |
| pc37 JZ rx, 18 <retry> [repeat=4] | 0..0 | 5..4000 | pin4=Z pin5=0|Z |
| pc37 JZ rx, 18 <retry> [repeat=3] | 0..0 | 5..4000 | pin4=Z pin5=0|Z |
| pc37 JZ rx, 18 <retry> [repeat=2] | 0..0 | 5..4000 | pin4=Z pin5=0|Z |
| pc37 JZ rx, 18 <retry> [repeat=1] | 0..0 | 5..4000 | pin4=Z pin5=0|Z |
| pc37 JZ rx, 18 <retry> | 0..0 | 5..3003 | pin4=Z pin5=0|Z |
| pc1 PULL | 0..inf | 42..42 | pin4=Z pin5=Z |

### Pin spacing

- pin4: exact spacings {2000: 11}; across boundaries [('2000', 'inf'), ('4851', 'inf')]; minimum 2000
- pin5: exact spacings {}; across boundaries [('1000', '4000'), ('2811', 'inf'), ('2851', 'inf')]; minimum 1000

### Loop periods

- pc1 `PULL` via JMP@pc44: 46851..inf (x2)
- pc7 `XOR y, x` via LOOP@pc9: 3 (x14), 46830..inf (x2)
- pc18 `DIR 0x00` via JZ@pc28, JZ@pc37: 2807..inf (x15)
- pc24 `WAIT 46` via LOOP@pc27: 50 (x220), 57..33554485 (x2), 1061..inf (x2)
- pc33 `OUT pin5 lsb` via LOOP@pc42: 3811..inf (x12)

### Edge schedules

```
  from START v0:
    +2      pc1   arrive PULL
  from pc1 PULL v0 (+1 identical contexts):
    +42     pc22  arrive WAITPIN pin4==1
  from pc22 WAITPIN pin4==1 [repeat=55] v0 (+1 identical contexts):
    +1      pc23  arrive WAITPIN pin5==1
  from pc23 WAITPIN pin5==1 [repeat=55] v0 (+1 identical contexts):
    +48     pc25  sample pin4
    +98     pc25  sample pin4
    +148    pc25  sample pin4
    +198    pc25  sample pin4
    +248    pc25  sample pin4
    +298    pc25  sample pin4
    +348    pc25  sample pin4
    +398    pc25  sample pin4
    +448    pc25  sample pin4
    +498    pc25  sample pin4
    +548    pc25  sample pin4
    +598    pc25  sample pin4
    +648    pc25  sample pin4
    +698    pc25  sample pin4
    +748    pc25  sample pin4
    +798    pc25  sample pin4
    +848    pc25  sample pin4
    +898    pc25  sample pin4
    +948    pc25  sample pin4
    +998    pc25  sample pin4
    +1048   pc25  sample pin4
    +1098   pc25  sample pin4
    +1148   pc25  sample pin4
    +1198   pc25  sample pin4
    +1248   pc25  sample pin4
    +1298   pc25  sample pin4
    +1348   pc25  sample pin4
    +1398   pc25  sample pin4
    +1448   pc25  sample pin4
    +1498   pc25  sample pin4
    +1548   pc25  sample pin4
    +1598   pc25  sample pin4
    +1648   pc25  sample pin4
    +1698   pc25  sample pin4
    +1748   pc25  sample pin4
    +1798   pc25  sample pin4
    +1848   pc25  sample pin4
    +1898   pc25  sample pin4
    +1948   pc25  sample pin4
    +1998   pc25  sample pin4
    +2048   pc25  sample pin4
    +2098   pc25  sample pin4
    +2148   pc25  sample pin4
    +2198   pc25  sample pin4
    +2248   pc25  sample pin4
    +2298   pc25  sample pin4
    +2348   pc25  sample pin4
    +2398   pc25  sample pin4
    +2448   pc25  sample pin4
    +2498   pc25  sample pin4
    +2548   pc25  sample pin4
    +2598   pc25  sample pin4
    +2648   pc25  sample pin4
    +2698   pc25  sample pin4
    +2748   pc25  sample pin4
    +2798   pc25  sample pin4
    +2806   pc33  pin5 Z->0|Z
    +3804   pc36  sample pin4
    +3805   pc37  arrive JZ rx, 18 <retry>
  from pc23 WAITPIN pin5==1 [repeat=55] v1 (+1 identical contexts):
    +48     pc25  sample pin4
    +98     pc25  sample pin4
    +148    pc25  sample pin4
    +198    pc25  sample pin4
    +248    pc25  sample pin4
    +298    pc25  sample pin4
    +348    pc25  sample pin4
    +398    pc25  sample pin4
    +448    pc25  sample pin4
    +498    pc25  sample pin4
    +548    pc25  sample pin4
    +598    pc25  sample pin4
    +648    pc25  sample pin4
    +698    pc25  sample pin4
    +748    pc25  sample pin4
    +798    pc25  sample pin4
    +848    pc25  sample pin4
    +898    pc25  sample pin4
    +948    pc25  sample pin4
    +998    pc25  sample pin4
    +1048   pc25  sample pin4
    +1098   pc25  sample pin4
    +1148   pc25  sample pin4
    +1198   pc25  sample pin4
    +1248   pc25  sample pin4
    +1298   pc25  sample pin4
    +1348   pc25  sample pin4
    +1398   pc25  sample pin4
    +1448   pc25  sample pin4
    +1498   pc25  sample pin4
    +1548   pc25  sample pin4
    +1598   pc25  sample pin4
    +1648   pc25  sample pin4
    +1698   pc25  sample pin4
    +1748   pc25  sample pin4
    +1798   pc25  sample pin4
    +1848   pc25  sample pin4
    +1898   pc25  sample pin4
    +1948   pc25  sample pin4
    +1998   pc25  sample pin4
    +2048   pc25  sample pin4
    +2098   pc25  sample pin4
    +2148   pc25  sample pin4
    +2198   pc25  sample pin4
    +2248   pc25  sample pin4
    +2298   pc25  sample pin4
    +2348   pc25  sample pin4
    +2398   pc25  sample pin4
    +2448   pc25  sample pin4
    +2498   pc25  sample pin4
    +2548   pc25  sample pin4
    +2598   pc25  sample pin4
    +2648   pc25  sample pin4
    +2698   pc25  sample pin4
    +2748   pc25  sample pin4
    +2798   pc25  sample pin4
    +2806   pc22  arrive WAITPIN pin4==1
  from pc37 JZ rx, 18 <retry> [repeat=10] v0 (+10 identical contexts):
    +1      pc18  pin5 0|Z->Z
    +5      pc22  arrive WAITPIN pin4==1
  from pc37 JZ rx, 18 <retry> [repeat=10] v1 (+9 identical contexts):
    +1      pc38  pin4 Z->0
    +2001   pc40  pin4 0->Z
    +3001   pc33  pin5 0|Z->0|Z
    +3999   pc36  sample pin4
    +4000   pc37  arrive JZ rx, 18 <retry>
  from pc37 JZ rx, 18 <retry> v1:
    +1      pc38  pin4 Z->0
    +2001   pc40  pin4 0->Z
    +3001   pc43  pin5 0|Z->Z
    +3003   pc1   arrive PULL
```

## ps2-host

Engine 2, owned 0x30, open-drain 0x30, fused, 50 MHz annotation. Notes: "PS/2 host (computer side) on CLK pin4 and DATA pin5, open-drain; external pull-ups required (a 5 V device needs level shifting to the 3.3 V pads). TX word: bits 7..0 a command byte, bits 11..8 the number of response frames to read. RX word: one received frame, bit 0 start, bits 8..1 data LSB first, bit 9 parity, bit 10 stop; the TT host checks the framing." "Request to send at 50000000 Hz: CLK low 6000 clocks (120 us), then DATA low, then CLK released 250 clocks (5 us) later. After it sees CLK high, the host puts each of the 10 bits (8 data bits LSB first, odd parity, stop 1) on DATA one clock after it sees the device's CLK low and waits for CLK high before the next one; after the stop bit it waits for the device's acknowledge (DATA low), one more CLK pulse and DATA high." "Timeouts: every wait for the device during the command is bounded by LIMIT 800000 (16 ms at 50000000 Hz; a device must start clocking within 15 ms), every wait while reading responses by LIMIT 1100000 (22 ms; a response is due within 20 ms); a device that does not clock, acknowledge or answer in time ends in fault 3." "Each response frame is sampled on 11 device CLK falls (DATA read one clock after WAITPIN sees CLK low) and pushed with strict PUSH: more than 8 unread frames end in fault 4. The host does not inhibit the device between commands."

### Checks

- **PASS** `identity`: bytecode sha256 matches, source sha256 matches
- **PASS** `assembler-timing-table`: 49 per-instruction entries (minimum_cycles, blocking) agree with the ISA cost model
- **PASS** `exact-analysis`: 50 boundary contexts, 52 path variants, no widening or budget cut
- **PASS** `no-self-deadlock`: no WAITPIN waits for a level the engine itself forces
- **PASS** `reachable-faults`: only explicit FAULT codes [] reachable
- **INFO** `bounded-waits`: 9 WAITPIN/WAITEVENT contexts; LIMIT values [800000, 1100000]; longest bounded stall 1099999 cycles (21999.980 us at 50 MHz) before fault 3
- **INFO** `holding-points`: unbounded FIFO waits hold: pc0 PULL [pin4=Z pin5=Z]
- **PASS** `ps2-host-request`: PS/2 host-to-device limits (Chapweske) at 50 MHz: CLK low before DATA low 6000 clocks = 120.00 us (>= 100.00 us; 20.00 us above the minimum); CLK low to the host's first-clock timeout 806250 clocks = 16.1 ms (>= 15.0 ms; 1.1 ms above the minimum). all hold for clocks from 0.00 to 53.75 MHz. request-to-send schedule (CLK low to DATA low, DATA low to CLK release) [(6000, 250)] clocks (declared 6000, 250): CLK low, then DATA low, then CLK released. The host waits for each device clock for up to LIMIT 800000 clocks, so a device that starts clocking within the 15 ms allowed after CLK goes low is never timed out
- **PASS** `ps2-host-bits`: command: 10 bits (8 data LSB first, parity, stop), each put on DATA one clock after WAITPIN sees the device's CLK low and held until WAITPIN sees CLK high (the device reads it on the rising edge); response: 11 DATA samples per frame, each one clock after WAITPIN sees CLK low, from the pad value 1 to 2 clocks after the CLK fall
- **PASS** `ps2-host-handshake`: PS/2 host-to-device limits (Chapweske) at 50 MHz: response wait 1.1e+06 clocks = 22.0 ms (>= 20.0 ms; 2.0 ms above the minimum). all hold for clocks from 0.00 to 55.00 MHz. WAITPIN sequence [(4, 1), (4, 0), (4, 1), (5, 0), (4, 0), (4, 1), (5, 1), (4, 0), (4, 1)] (CLK seen released, bit clocking, acknowledge DATA low, the acknowledge clock, DATA released, response clocking); LIMIT values [800000, 1100000]; both lines released at every PULL holding point
- **PASS** `ps2-host-open-drain`: CLK and DATA are only pulled low or released

### Boundaries

| boundary (context) | stall min..max | segment BCET..WCET | holding pads |
|---|---|---|---|
| START | 0..0 | 1..1 | pin4=Z pin5=Z |
| pc0 PULL | 0..inf | 6290..6290 | pin4=Z pin5=Z |
| pc23 WAITPIN pin4==1 | 2..799999 | 2..2 | pin4=Z pin5=0 |
| pc25 WAITPIN pin4==0 [repeat=9] | 0..799999 | 2..2 | pin4=Z pin5=0 |
| pc27 WAITPIN pin4==1 [repeat=9] | 0..799999 | 2..2 | pin4=Z pin5=0|Z |
| pc25 WAITPIN pin4==0 [repeat=8] | 0..799999 | 2..2 | pin4=Z pin5=0|Z |
| pc27 WAITPIN pin4==1 [repeat=8] | 0..799999 | 2..2 | pin4=Z pin5=0|Z |
| pc25 WAITPIN pin4==0 [repeat=7] | 0..799999 | 2..2 | pin4=Z pin5=0|Z |
| pc27 WAITPIN pin4==1 [repeat=7] | 0..799999 | 2..2 | pin4=Z pin5=0|Z |
| pc25 WAITPIN pin4==0 [repeat=6] | 0..799999 | 2..2 | pin4=Z pin5=0|Z |
| pc27 WAITPIN pin4==1 [repeat=6] | 0..799999 | 2..2 | pin4=Z pin5=0|Z |
| pc25 WAITPIN pin4==0 [repeat=5] | 0..799999 | 2..2 | pin4=Z pin5=0|Z |
| pc27 WAITPIN pin4==1 [repeat=5] | 0..799999 | 2..2 | pin4=Z pin5=0|Z |
| pc25 WAITPIN pin4==0 [repeat=4] | 0..799999 | 2..2 | pin4=Z pin5=0|Z |
| pc27 WAITPIN pin4==1 [repeat=4] | 0..799999 | 2..2 | pin4=Z pin5=0|Z |
| pc25 WAITPIN pin4==0 [repeat=3] | 0..799999 | 2..2 | pin4=Z pin5=0|Z |
| pc27 WAITPIN pin4==1 [repeat=3] | 0..799999 | 2..2 | pin4=Z pin5=0|Z |
| pc25 WAITPIN pin4==0 [repeat=2] | 0..799999 | 2..2 | pin4=Z pin5=0|Z |
| pc27 WAITPIN pin4==1 [repeat=2] | 0..799999 | 2..2 | pin4=Z pin5=0|Z |
| pc25 WAITPIN pin4==0 [repeat=1] | 0..799999 | 2..2 | pin4=Z pin5=0|Z |
| pc27 WAITPIN pin4==1 [repeat=1] | 0..799999 | 2..2 | pin4=Z pin5=0|Z |
| pc25 WAITPIN pin4==0 | 0..799999 | 2..2 | pin4=Z pin5=0|Z |
| pc27 WAITPIN pin4==1 | 0..799999 | 2..2 | pin4=Z pin5=0|Z |
| pc29 WAITPIN pin5==0 | 0..799999 | 1..1 | pin4=Z pin5=0|Z |
| pc30 WAITPIN pin4==0 | 0..799999 | 1..1 | pin4=Z pin5=0|Z |
| pc31 WAITPIN pin4==1 | 0..799999 | 1..1 | pin4=Z pin5=0|Z |
| pc32 WAITPIN pin5==1 | 0..799999 | 8..9 | pin4=Z pin5=0|Z |
| pc41 WAITPIN pin4==0 [repeat=10] | 0..1099999 | 2..2 | pin4=Z pin5=Z |
| pc0 PULL | 0..inf | 6290..6290 | pin4=Z pin5=Z |
| pc43 WAITPIN pin4==1 [repeat=10] | 0..1099999 | 2..2 | pin4=Z pin5=Z |
| pc41 WAITPIN pin4==0 [repeat=9] | 0..1099999 | 2..2 | pin4=Z pin5=Z |
| pc43 WAITPIN pin4==1 [repeat=9] | 0..1099999 | 2..2 | pin4=Z pin5=Z |
| pc41 WAITPIN pin4==0 [repeat=8] | 0..1099999 | 2..2 | pin4=Z pin5=Z |
| pc43 WAITPIN pin4==1 [repeat=8] | 0..1099999 | 2..2 | pin4=Z pin5=Z |
| pc41 WAITPIN pin4==0 [repeat=7] | 0..1099999 | 2..2 | pin4=Z pin5=Z |
| pc43 WAITPIN pin4==1 [repeat=7] | 0..1099999 | 2..2 | pin4=Z pin5=Z |
| pc41 WAITPIN pin4==0 [repeat=6] | 0..1099999 | 2..2 | pin4=Z pin5=Z |
| pc43 WAITPIN pin4==1 [repeat=6] | 0..1099999 | 2..2 | pin4=Z pin5=Z |
| pc41 WAITPIN pin4==0 [repeat=5] | 0..1099999 | 2..2 | pin4=Z pin5=Z |
| pc43 WAITPIN pin4==1 [repeat=5] | 0..1099999 | 2..2 | pin4=Z pin5=Z |
| pc41 WAITPIN pin4==0 [repeat=4] | 0..1099999 | 2..2 | pin4=Z pin5=Z |
| pc43 WAITPIN pin4==1 [repeat=4] | 0..1099999 | 2..2 | pin4=Z pin5=Z |
| pc41 WAITPIN pin4==0 [repeat=3] | 0..1099999 | 2..2 | pin4=Z pin5=Z |
| pc43 WAITPIN pin4==1 [repeat=3] | 0..1099999 | 2..2 | pin4=Z pin5=Z |
| pc41 WAITPIN pin4==0 [repeat=2] | 0..1099999 | 2..2 | pin4=Z pin5=Z |
| pc43 WAITPIN pin4==1 [repeat=2] | 0..1099999 | 2..2 | pin4=Z pin5=Z |
| pc41 WAITPIN pin4==0 [repeat=1] | 0..1099999 | 2..2 | pin4=Z pin5=Z |
| pc43 WAITPIN pin4==1 [repeat=1] | 0..1099999 | 2..2 | pin4=Z pin5=Z |
| pc41 WAITPIN pin4==0 | 0..1099999 | 2..2 | pin4=Z pin5=Z |
| pc43 WAITPIN pin4==1 | 0..1099999 | 7..8 | pin4=Z pin5=Z |

### Pin spacing

- pin4: exact spacings {6250: 2}; across boundaries [('95', 'inf')]; minimum 95
- pin5: exact spacings {}; across boundaries [('256', '1600252'), ('4', '1600002'), ('6046', 'inf'), ('6096', 'inf'), ('7', '4000002')]; minimum 4

### Loop periods

- pc0 `PULL` via JZ@pc39: 6345..inf (x3)
- pc7 `XOR rx, x` via LOOP@pc9: 3 (x14), 6324..inf (x2)
- pc25 `WAITPIN pin4==0` via LOOP@pc28: 4..1600002 (x9), 6309..inf (x1)
- pc39 `JZ x, 0 <command>` via JMP@pc48: 50..24200028 (x2), 6345..inf (x2)
- pc41 `WAITPIN pin4==0` via LOOP@pc44: 4..2200002 (x11), 10..inf (x1)

### Edge schedules

```
  from START v0:
    +1      pc0   arrive PULL
  from pc0 PULL v0 (+1 identical contexts):
    +39     pc18  pin4 Z->0
    +6039   pc20  pin5 Z->0
    +6289   pc22  pin4 0->Z
    +6290   pc23  arrive WAITPIN pin4==1
  from pc23 WAITPIN pin4==1 v0 (+9 identical contexts):
    +2      pc25  arrive WAITPIN pin4==0
  from pc25 WAITPIN pin4==0 [repeat=9] v0:
    +1      pc26  pin5 0->0|Z
    +2      pc27  arrive WAITPIN pin4==1
  from pc25 WAITPIN pin4==0 [repeat=8] v0 (+8 identical contexts):
    +1      pc26  pin5 0|Z->0|Z
    +2      pc27  arrive WAITPIN pin4==1
  from pc27 WAITPIN pin4==1 v0:
    +2      pc29  arrive WAITPIN pin5==0
  from pc29 WAITPIN pin5==0 v0:
    +1      pc30  arrive WAITPIN pin4==0
  from pc30 WAITPIN pin4==0 v0:
    +1      pc31  arrive WAITPIN pin4==1
  from pc31 WAITPIN pin4==1 v0:
    +1      pc32  arrive WAITPIN pin5==1
  from pc32 WAITPIN pin5==1 v0:
    +1      pc33  pin5 0|Z->Z
    +9      pc41  arrive WAITPIN pin4==0
  from pc32 WAITPIN pin5==1 v1:
    +1      pc33  pin5 0|Z->Z
    +8      pc0   arrive PULL
  from pc41 WAITPIN pin4==0 [repeat=10] v0 (+10 identical contexts):
    +1      pc42  sample pin5
    +2      pc43  arrive WAITPIN pin4==1
  from pc43 WAITPIN pin4==1 [repeat=10] v0 (+9 identical contexts):
    +2      pc41  arrive WAITPIN pin4==0
  from pc43 WAITPIN pin4==1 v0:
    +3      pc46  interaction
    +8      pc41  arrive WAITPIN pin4==0
  from pc43 WAITPIN pin4==1 v1:
    +3      pc46  interaction
    +7      pc0   arrive PULL
```

## spi-controller-fast

Engine 2, owned 0x2c, open-drain 0x00, fused, 50 MHz annotation. Notes: "SPI controller mode0, MSB-first 8-bit full duplex; pins SCK2/MOSI3/MISO4/CSn5." "Fused transfers have 16-cycle half periods; scalar expansion preserves mode but adds data-dependent instruction overhead between bits." "One CS assertion per FIFO byte; low-byte receive words. Input synchronization requires external return/setup margin; no maximum external rate asserted."

### Checks

- **PASS** `identity`: bytecode sha256 matches, source sha256 matches
- **PASS** `assembler-timing-table`: 11 per-instruction entries (minimum_cycles, blocking) agree with the ISA cost model
- **PASS** `exact-analysis`: 4 boundary contexts, 4 path variants, no widening or budget cut
- **PASS** `no-self-deadlock`: no WAITPIN waits for a level the engine itself forces
- **PASS** `reachable-faults`: only explicit FAULT codes [] reachable
- **INFO** `holding-points`: unbounded FIFO waits hold: pc3 PULL [pin2=0 pin3=0 pin5=1]; pc9 PUSH [pin2=0 pin3=0 pin5=1]
- **PASS** `spi-xfer-encoding`: 1 XFER: 8 bits, half-period 16, CPOL0/CPHA0, MSB first, drive+sample; declared: "Fused transfers have 16-cycle half periods; scalar expansion preserves mode but adds data-dependent instruction overhead between bits." and mode0
- **PASS** `spi-sck-half-period`: every frame has 16 SCK edges spaced exactly 16 cycles (2 frame contexts)
- **PASS** `spi-idle-at-holding-points`: SCK at CPOL level 0 and CS deasserted at every PULL/PUSH holding point
- **INFO** `spi-cs-timing`: CS setup (CS low to first SCK edge) [17] cycles; CS hold (last SCK edge to CS high) [1] cycles; CS high between frames >= 6 cycles (120.0 ns at 50 MHz)
- **PASS** `spi-mosi-setup-hold`: MOSI stable >= 16 cycles before and >= 16 cycles after every target sampling edge (leading)
- **PASS** `spi-miso-sampling`: MISO sampled on every leading SCK edge; the sample reads the pad 2 cycles before the edge, so target clock-to-out plus board round trip must fit in 14 cycles (280.0 ns at 50 MHz)
- **INFO** `spi-sck-frequency`: 10MHz: SCK 0.3125 MHz, 25MHz: SCK 0.78125 MHz, 50MHz: SCK 1.5625 MHz, 66MHz: SCK 2.0625 MHz, 100MHz: SCK 3.125 MHz
- **INFO** `image-name`: image 'name' field is "spi-controller-mode0" but the file is spi-controller-fast.image.json

### Boundaries

| boundary (context) | stall min..max | segment BCET..WCET | holding pads |
|---|---|---|---|
| START | 0..0 | 4..4 | pin2=Z pin3=Z pin5=Z |
| pc3 PULL | 0..inf | 262..262 | pin2=0 pin3=0 pin5=1 |
| pc9 PUSH | 0..inf | 2..2 | pin2=0 pin3=0 pin5=1 |
| pc3 PULL | 0..inf | 262..262 | pin2=0 pin3=0 pin5=1 |

### Pin spacing

- pin2: exact spacings {16: 30}; across boundaries [('22', 'inf'), ('24', 'inf')]; minimum 16
- pin3: exact spacings {32: 14, 33: 2}; across boundaries [('6', 'inf'), ('7', 'inf')]; minimum 6
- pin5: exact spacings {258: 2}; across boundaries [('5', 'inf'), ('6', 'inf')]; minimum 5

### Loop periods

- pc3 `PULL` via JMP@pc10: 264..inf (x2)

### Edge schedules

```
  from START v0:
    +2      pc1   pin2 Z->0
    +2      pc1   pin3 Z->0
    +2      pc1   pin5 Z->1
    +4      pc3   arrive PULL
  from pc3 PULL v0 (+1 identical contexts):
    +3      pc6   pin5 1->0
    +4      pc7   pin3 0->0|1
    +20     pc7   pin2 0->1
    +20     pc7   sample pin4
    +36     pc7   pin2 1->0
    +36     pc7   pin3 0|1->0|1
    +52     pc7   pin2 0->1
    +52     pc7   sample pin4
    +68     pc7   pin2 1->0
    +68     pc7   pin3 0|1->0|1
    +84     pc7   pin2 0->1
    +84     pc7   sample pin4
    +100    pc7   pin2 1->0
    +100    pc7   pin3 0|1->0|1
    +116    pc7   pin2 0->1
    +116    pc7   sample pin4
    +132    pc7   pin2 1->0
    +132    pc7   pin3 0|1->0|1
    +148    pc7   pin2 0->1
    +148    pc7   sample pin4
    +164    pc7   pin2 1->0
    +164    pc7   pin3 0|1->0|1
    +180    pc7   pin2 0->1
    +180    pc7   sample pin4
    +196    pc7   pin2 1->0
    +196    pc7   pin3 0|1->0|1
    +212    pc7   pin2 0->1
    +212    pc7   sample pin4
    +228    pc7   pin2 1->0
    +228    pc7   pin3 0|1->0|1
    +244    pc7   pin2 0->1
    +244    pc7   sample pin4
    +260    pc7   pin2 1->0
    +261    pc8   pin3 0|1->0
    +261    pc8   pin5 0->1
    +262    pc9   arrive PUSH
  from pc9 PUSH v0:
    +2      pc3   arrive PULL
```

## spi-controller-mode0

Engine 2, owned 0x2c, open-drain 0x00, fused, 50 MHz annotation. Notes: "SPI controller mode0, MSB-first 8-bit full duplex; pins SCK2/MOSI3/MISO4/CSn5." "Fused transfers have 32-cycle half periods; scalar expansion preserves mode but adds data-dependent instruction overhead between bits." "One CS assertion per FIFO byte; low-byte receive words. Input synchronization requires external return/setup margin; no maximum external rate asserted."

### Checks

- **PASS** `identity`: bytecode sha256 matches, source sha256 matches
- **PASS** `assembler-timing-table`: 11 per-instruction entries (minimum_cycles, blocking) agree with the ISA cost model
- **PASS** `exact-analysis`: 4 boundary contexts, 4 path variants, no widening or budget cut
- **PASS** `no-self-deadlock`: no WAITPIN waits for a level the engine itself forces
- **PASS** `reachable-faults`: only explicit FAULT codes [] reachable
- **INFO** `holding-points`: unbounded FIFO waits hold: pc3 PULL [pin2=0 pin3=0 pin5=1]; pc9 PUSH [pin2=0 pin3=0 pin5=1]
- **PASS** `spi-xfer-encoding`: 1 XFER: 8 bits, half-period 32, CPOL0/CPHA0, MSB first, drive+sample; declared: "Fused transfers have 32-cycle half periods; scalar expansion preserves mode but adds data-dependent instruction overhead between bits." and mode0
- **PASS** `spi-sck-half-period`: every frame has 16 SCK edges spaced exactly 32 cycles (2 frame contexts)
- **PASS** `spi-idle-at-holding-points`: SCK at CPOL level 0 and CS deasserted at every PULL/PUSH holding point
- **INFO** `spi-cs-timing`: CS setup (CS low to first SCK edge) [33] cycles; CS hold (last SCK edge to CS high) [1] cycles; CS high between frames >= 6 cycles (120.0 ns at 50 MHz)
- **PASS** `spi-mosi-setup-hold`: MOSI stable >= 32 cycles before and >= 32 cycles after every target sampling edge (leading)
- **PASS** `spi-miso-sampling`: MISO sampled on every leading SCK edge; the sample reads the pad 2 cycles before the edge, so target clock-to-out plus board round trip must fit in 30 cycles (600.0 ns at 50 MHz)
- **INFO** `spi-sck-frequency`: 10MHz: SCK 0.15625 MHz, 25MHz: SCK 0.390625 MHz, 50MHz: SCK 0.78125 MHz, 66MHz: SCK 1.03125 MHz, 100MHz: SCK 1.5625 MHz

### Boundaries

| boundary (context) | stall min..max | segment BCET..WCET | holding pads |
|---|---|---|---|
| START | 0..0 | 4..4 | pin2=Z pin3=Z pin5=Z |
| pc3 PULL | 0..inf | 518..518 | pin2=0 pin3=0 pin5=1 |
| pc9 PUSH | 0..inf | 2..2 | pin2=0 pin3=0 pin5=1 |
| pc3 PULL | 0..inf | 518..518 | pin2=0 pin3=0 pin5=1 |

### Pin spacing

- pin2: exact spacings {32: 30}; across boundaries [('38', 'inf'), ('40', 'inf')]; minimum 32
- pin3: exact spacings {64: 14, 65: 2}; across boundaries [('6', 'inf'), ('7', 'inf')]; minimum 6
- pin5: exact spacings {514: 2}; across boundaries [('5', 'inf'), ('6', 'inf')]; minimum 5

### Loop periods

- pc3 `PULL` via JMP@pc10: 520..inf (x2)

### Edge schedules

```
  from START v0:
    +2      pc1   pin2 Z->0
    +2      pc1   pin3 Z->0
    +2      pc1   pin5 Z->1
    +4      pc3   arrive PULL
  from pc3 PULL v0 (+1 identical contexts):
    +3      pc6   pin5 1->0
    +4      pc7   pin3 0->0|1
    +36     pc7   pin2 0->1
    +36     pc7   sample pin4
    +68     pc7   pin2 1->0
    +68     pc7   pin3 0|1->0|1
    +100    pc7   pin2 0->1
    +100    pc7   sample pin4
    +132    pc7   pin2 1->0
    +132    pc7   pin3 0|1->0|1
    +164    pc7   pin2 0->1
    +164    pc7   sample pin4
    +196    pc7   pin2 1->0
    +196    pc7   pin3 0|1->0|1
    +228    pc7   pin2 0->1
    +228    pc7   sample pin4
    +260    pc7   pin2 1->0
    +260    pc7   pin3 0|1->0|1
    +292    pc7   pin2 0->1
    +292    pc7   sample pin4
    +324    pc7   pin2 1->0
    +324    pc7   pin3 0|1->0|1
    +356    pc7   pin2 0->1
    +356    pc7   sample pin4
    +388    pc7   pin2 1->0
    +388    pc7   pin3 0|1->0|1
    +420    pc7   pin2 0->1
    +420    pc7   sample pin4
    +452    pc7   pin2 1->0
    +452    pc7   pin3 0|1->0|1
    +484    pc7   pin2 0->1
    +484    pc7   sample pin4
    +516    pc7   pin2 1->0
    +517    pc8   pin3 0|1->0
    +517    pc8   pin5 0->1
    +518    pc9   arrive PUSH
  from pc9 PUSH v0:
    +2      pc3   arrive PULL
```

## spi-controller-mode1

Engine 2, owned 0x2c, open-drain 0x00, fused, 50 MHz annotation. Notes: "SPI controller mode1, MSB-first 8-bit full duplex; pins SCK2/MOSI3/MISO4/CSn5." "Fused transfers have 32-cycle half periods; scalar expansion preserves mode but adds data-dependent instruction overhead between bits." "One CS assertion per FIFO byte; low-byte receive words. Input synchronization requires external return/setup margin; no maximum external rate asserted."

### Checks

- **PASS** `identity`: bytecode sha256 matches, source sha256 matches
- **PASS** `assembler-timing-table`: 11 per-instruction entries (minimum_cycles, blocking) agree with the ISA cost model
- **PASS** `exact-analysis`: 4 boundary contexts, 4 path variants, no widening or budget cut
- **PASS** `no-self-deadlock`: no WAITPIN waits for a level the engine itself forces
- **PASS** `reachable-faults`: only explicit FAULT codes [] reachable
- **INFO** `holding-points`: unbounded FIFO waits hold: pc3 PULL [pin2=0 pin3=0 pin5=1]; pc9 PUSH [pin2=0 pin3=0 pin5=1]
- **PASS** `spi-xfer-encoding`: 1 XFER: 8 bits, half-period 32, CPOL0/CPHA1, MSB first, drive+sample; declared: "Fused transfers have 32-cycle half periods; scalar expansion preserves mode but adds data-dependent instruction overhead between bits." and mode1
- **PASS** `spi-sck-half-period`: every frame has 16 SCK edges spaced exactly 32 cycles (2 frame contexts)
- **PASS** `spi-idle-at-holding-points`: SCK at CPOL level 0 and CS deasserted at every PULL/PUSH holding point
- **INFO** `spi-cs-timing`: CS setup (CS low to first SCK edge) [33] cycles; CS hold (last SCK edge to CS high) [1] cycles; CS high between frames >= 6 cycles (120.0 ns at 50 MHz)
- **PASS** `spi-mosi-setup-hold`: MOSI stable >= 32 cycles before and >= 1 cycles after every target sampling edge (trailing); the last bit's hold is only [1] cycle(s) because the post-transfer SET rewrites MOSI together with CS
- **PASS** `spi-miso-sampling`: MISO sampled on every trailing SCK edge; the sample reads the pad 2 cycles before the edge, so target clock-to-out plus board round trip must fit in 30 cycles (600.0 ns at 50 MHz)
- **INFO** `spi-sck-frequency`: 10MHz: SCK 0.15625 MHz, 25MHz: SCK 0.390625 MHz, 50MHz: SCK 0.78125 MHz, 66MHz: SCK 1.03125 MHz, 100MHz: SCK 1.5625 MHz

### Boundaries

| boundary (context) | stall min..max | segment BCET..WCET | holding pads |
|---|---|---|---|
| START | 0..0 | 4..4 | pin2=Z pin3=Z pin5=Z |
| pc3 PULL | 0..inf | 518..518 | pin2=0 pin3=0 pin5=1 |
| pc9 PUSH | 0..inf | 2..2 | pin2=0 pin3=0 pin5=1 |
| pc3 PULL | 0..inf | 518..518 | pin2=0 pin3=0 pin5=1 |

### Pin spacing

- pin2: exact spacings {32: 30}; across boundaries [('38', 'inf'), ('40', 'inf')]; minimum 32
- pin3: exact spacings {33: 2, 64: 14}; across boundaries [('38', 'inf'), ('39', 'inf')]; minimum 33
- pin5: exact spacings {514: 2}; across boundaries [('5', 'inf'), ('6', 'inf')]; minimum 5

### Loop periods

- pc3 `PULL` via JMP@pc10: 520..inf (x2)

### Edge schedules

```
  from START v0:
    +2      pc1   pin2 Z->0
    +2      pc1   pin3 Z->0
    +2      pc1   pin5 Z->1
    +4      pc3   arrive PULL
  from pc3 PULL v0 (+1 identical contexts):
    +3      pc6   pin5 1->0
    +36     pc7   pin2 0->1
    +36     pc7   pin3 0->0|1
    +68     pc7   pin2 1->0
    +68     pc7   sample pin4
    +100    pc7   pin2 0->1
    +100    pc7   pin3 0|1->0|1
    +132    pc7   pin2 1->0
    +132    pc7   sample pin4
    +164    pc7   pin2 0->1
    +164    pc7   pin3 0|1->0|1
    +196    pc7   pin2 1->0
    +196    pc7   sample pin4
    +228    pc7   pin2 0->1
    +228    pc7   pin3 0|1->0|1
    +260    pc7   pin2 1->0
    +260    pc7   sample pin4
    +292    pc7   pin2 0->1
    +292    pc7   pin3 0|1->0|1
    +324    pc7   pin2 1->0
    +324    pc7   sample pin4
    +356    pc7   pin2 0->1
    +356    pc7   pin3 0|1->0|1
    +388    pc7   pin2 1->0
    +388    pc7   sample pin4
    +420    pc7   pin2 0->1
    +420    pc7   pin3 0|1->0|1
    +452    pc7   pin2 1->0
    +452    pc7   sample pin4
    +484    pc7   pin2 0->1
    +484    pc7   pin3 0|1->0|1
    +516    pc7   pin2 1->0
    +516    pc7   sample pin4
    +517    pc8   pin3 0|1->0
    +517    pc8   pin5 0->1
    +518    pc9   arrive PUSH
  from pc9 PUSH v0:
    +2      pc3   arrive PULL
```

## spi-controller-mode2

Engine 2, owned 0x2c, open-drain 0x00, fused, 50 MHz annotation. Notes: "SPI controller mode2, MSB-first 8-bit full duplex; pins SCK2/MOSI3/MISO4/CSn5." "Fused transfers have 32-cycle half periods; scalar expansion preserves mode but adds data-dependent instruction overhead between bits." "One CS assertion per FIFO byte; low-byte receive words. Input synchronization requires external return/setup margin; no maximum external rate asserted."

### Checks

- **PASS** `identity`: bytecode sha256 matches, source sha256 matches
- **PASS** `assembler-timing-table`: 11 per-instruction entries (minimum_cycles, blocking) agree with the ISA cost model
- **PASS** `exact-analysis`: 4 boundary contexts, 4 path variants, no widening or budget cut
- **PASS** `no-self-deadlock`: no WAITPIN waits for a level the engine itself forces
- **PASS** `reachable-faults`: only explicit FAULT codes [] reachable
- **INFO** `holding-points`: unbounded FIFO waits hold: pc3 PULL [pin2=1 pin3=0 pin5=1]; pc9 PUSH [pin2=1 pin3=0 pin5=1]
- **PASS** `spi-xfer-encoding`: 1 XFER: 8 bits, half-period 32, CPOL1/CPHA0, MSB first, drive+sample; declared: "Fused transfers have 32-cycle half periods; scalar expansion preserves mode but adds data-dependent instruction overhead between bits." and mode2
- **PASS** `spi-sck-half-period`: every frame has 16 SCK edges spaced exactly 32 cycles (2 frame contexts)
- **PASS** `spi-idle-at-holding-points`: SCK at CPOL level 1 and CS deasserted at every PULL/PUSH holding point
- **INFO** `spi-cs-timing`: CS setup (CS low to first SCK edge) [33] cycles; CS hold (last SCK edge to CS high) [1] cycles; CS high between frames >= 6 cycles (120.0 ns at 50 MHz)
- **PASS** `spi-mosi-setup-hold`: MOSI stable >= 32 cycles before and >= 32 cycles after every target sampling edge (leading)
- **PASS** `spi-miso-sampling`: MISO sampled on every leading SCK edge; the sample reads the pad 2 cycles before the edge, so target clock-to-out plus board round trip must fit in 30 cycles (600.0 ns at 50 MHz)
- **INFO** `spi-sck-frequency`: 10MHz: SCK 0.15625 MHz, 25MHz: SCK 0.390625 MHz, 50MHz: SCK 0.78125 MHz, 66MHz: SCK 1.03125 MHz, 100MHz: SCK 1.5625 MHz

### Boundaries

| boundary (context) | stall min..max | segment BCET..WCET | holding pads |
|---|---|---|---|
| START | 0..0 | 4..4 | pin2=Z pin3=Z pin5=Z |
| pc3 PULL | 0..inf | 518..518 | pin2=1 pin3=0 pin5=1 |
| pc9 PUSH | 0..inf | 2..2 | pin2=1 pin3=0 pin5=1 |
| pc3 PULL | 0..inf | 518..518 | pin2=1 pin3=0 pin5=1 |

### Pin spacing

- pin2: exact spacings {32: 30}; across boundaries [('38', 'inf'), ('40', 'inf')]; minimum 32
- pin3: exact spacings {64: 14, 65: 2}; across boundaries [('6', 'inf'), ('7', 'inf')]; minimum 6
- pin5: exact spacings {514: 2}; across boundaries [('5', 'inf'), ('6', 'inf')]; minimum 5

### Loop periods

- pc3 `PULL` via JMP@pc10: 520..inf (x2)

### Edge schedules

```
  from START v0:
    +2      pc1   pin2 Z->1
    +2      pc1   pin3 Z->0
    +2      pc1   pin5 Z->1
    +4      pc3   arrive PULL
  from pc3 PULL v0 (+1 identical contexts):
    +3      pc6   pin5 1->0
    +4      pc7   pin3 0->0|1
    +36     pc7   pin2 1->0
    +36     pc7   sample pin4
    +68     pc7   pin2 0->1
    +68     pc7   pin3 0|1->0|1
    +100    pc7   pin2 1->0
    +100    pc7   sample pin4
    +132    pc7   pin2 0->1
    +132    pc7   pin3 0|1->0|1
    +164    pc7   pin2 1->0
    +164    pc7   sample pin4
    +196    pc7   pin2 0->1
    +196    pc7   pin3 0|1->0|1
    +228    pc7   pin2 1->0
    +228    pc7   sample pin4
    +260    pc7   pin2 0->1
    +260    pc7   pin3 0|1->0|1
    +292    pc7   pin2 1->0
    +292    pc7   sample pin4
    +324    pc7   pin2 0->1
    +324    pc7   pin3 0|1->0|1
    +356    pc7   pin2 1->0
    +356    pc7   sample pin4
    +388    pc7   pin2 0->1
    +388    pc7   pin3 0|1->0|1
    +420    pc7   pin2 1->0
    +420    pc7   sample pin4
    +452    pc7   pin2 0->1
    +452    pc7   pin3 0|1->0|1
    +484    pc7   pin2 1->0
    +484    pc7   sample pin4
    +516    pc7   pin2 0->1
    +517    pc8   pin3 0|1->0
    +517    pc8   pin5 0->1
    +518    pc9   arrive PUSH
  from pc9 PUSH v0:
    +2      pc3   arrive PULL
```

## spi-controller-mode3

Engine 2, owned 0x2c, open-drain 0x00, fused, 50 MHz annotation. Notes: "SPI controller mode3, MSB-first 8-bit full duplex; pins SCK2/MOSI3/MISO4/CSn5." "Fused transfers have 32-cycle half periods; scalar expansion preserves mode but adds data-dependent instruction overhead between bits." "One CS assertion per FIFO byte; low-byte receive words. Input synchronization requires external return/setup margin; no maximum external rate asserted."

### Checks

- **PASS** `identity`: bytecode sha256 matches, source sha256 matches
- **PASS** `assembler-timing-table`: 11 per-instruction entries (minimum_cycles, blocking) agree with the ISA cost model
- **PASS** `exact-analysis`: 4 boundary contexts, 4 path variants, no widening or budget cut
- **PASS** `no-self-deadlock`: no WAITPIN waits for a level the engine itself forces
- **PASS** `reachable-faults`: only explicit FAULT codes [] reachable
- **INFO** `holding-points`: unbounded FIFO waits hold: pc3 PULL [pin2=1 pin3=0 pin5=1]; pc9 PUSH [pin2=1 pin3=0 pin5=1]
- **PASS** `spi-xfer-encoding`: 1 XFER: 8 bits, half-period 32, CPOL1/CPHA1, MSB first, drive+sample; declared: "Fused transfers have 32-cycle half periods; scalar expansion preserves mode but adds data-dependent instruction overhead between bits." and mode3
- **PASS** `spi-sck-half-period`: every frame has 16 SCK edges spaced exactly 32 cycles (2 frame contexts)
- **PASS** `spi-idle-at-holding-points`: SCK at CPOL level 1 and CS deasserted at every PULL/PUSH holding point
- **INFO** `spi-cs-timing`: CS setup (CS low to first SCK edge) [33] cycles; CS hold (last SCK edge to CS high) [1] cycles; CS high between frames >= 6 cycles (120.0 ns at 50 MHz)
- **PASS** `spi-mosi-setup-hold`: MOSI stable >= 32 cycles before and >= 1 cycles after every target sampling edge (trailing); the last bit's hold is only [1] cycle(s) because the post-transfer SET rewrites MOSI together with CS
- **PASS** `spi-miso-sampling`: MISO sampled on every trailing SCK edge; the sample reads the pad 2 cycles before the edge, so target clock-to-out plus board round trip must fit in 30 cycles (600.0 ns at 50 MHz)
- **INFO** `spi-sck-frequency`: 10MHz: SCK 0.15625 MHz, 25MHz: SCK 0.390625 MHz, 50MHz: SCK 0.78125 MHz, 66MHz: SCK 1.03125 MHz, 100MHz: SCK 1.5625 MHz

### Boundaries

| boundary (context) | stall min..max | segment BCET..WCET | holding pads |
|---|---|---|---|
| START | 0..0 | 4..4 | pin2=Z pin3=Z pin5=Z |
| pc3 PULL | 0..inf | 518..518 | pin2=1 pin3=0 pin5=1 |
| pc9 PUSH | 0..inf | 2..2 | pin2=1 pin3=0 pin5=1 |
| pc3 PULL | 0..inf | 518..518 | pin2=1 pin3=0 pin5=1 |

### Pin spacing

- pin2: exact spacings {32: 30}; across boundaries [('38', 'inf'), ('40', 'inf')]; minimum 32
- pin3: exact spacings {33: 2, 64: 14}; across boundaries [('38', 'inf'), ('39', 'inf')]; minimum 33
- pin5: exact spacings {514: 2}; across boundaries [('5', 'inf'), ('6', 'inf')]; minimum 5

### Loop periods

- pc3 `PULL` via JMP@pc10: 520..inf (x2)

### Edge schedules

```
  from START v0:
    +2      pc1   pin2 Z->1
    +2      pc1   pin3 Z->0
    +2      pc1   pin5 Z->1
    +4      pc3   arrive PULL
  from pc3 PULL v0 (+1 identical contexts):
    +3      pc6   pin5 1->0
    +36     pc7   pin2 1->0
    +36     pc7   pin3 0->0|1
    +68     pc7   pin2 0->1
    +68     pc7   sample pin4
    +100    pc7   pin2 1->0
    +100    pc7   pin3 0|1->0|1
    +132    pc7   pin2 0->1
    +132    pc7   sample pin4
    +164    pc7   pin2 1->0
    +164    pc7   pin3 0|1->0|1
    +196    pc7   pin2 0->1
    +196    pc7   sample pin4
    +228    pc7   pin2 1->0
    +228    pc7   pin3 0|1->0|1
    +260    pc7   pin2 0->1
    +260    pc7   sample pin4
    +292    pc7   pin2 1->0
    +292    pc7   pin3 0|1->0|1
    +324    pc7   pin2 0->1
    +324    pc7   sample pin4
    +356    pc7   pin2 1->0
    +356    pc7   pin3 0|1->0|1
    +388    pc7   pin2 0->1
    +388    pc7   sample pin4
    +420    pc7   pin2 1->0
    +420    pc7   pin3 0|1->0|1
    +452    pc7   pin2 0->1
    +452    pc7   sample pin4
    +484    pc7   pin2 1->0
    +484    pc7   pin3 0|1->0|1
    +516    pc7   pin2 0->1
    +516    pc7   sample pin4
    +517    pc8   pin3 0|1->0
    +517    pc8   pin5 0->1
    +518    pc9   arrive PUSH
  from pc9 PUSH v0:
    +2      pc3   arrive PULL
```

## spi-target-mode0

Engine 2, owned 0x10, open-drain 0x00, fused, 50 MHz annotation. Notes: "SPI target mode0, MSB-first 8-bit full duplex; SCK2/MOSI3/MISO4/CSn5." "CS must be high between bytes, asserted at least 8 system clocks before first edge; each external half period at least 8 clocks." "TX word must be queued before CS assertion; CS is checked at frame boundaries, interrupted frames terminate through LIMIT timeout. MISO releases at deassertion observation." "Full RX FIFO at completed-frame delivery halts with fault4 and retains the captured byte in READ_SELECT6."

### Checks

- **PASS** `identity`: bytecode sha256 matches, source sha256 matches
- **PASS** `assembler-timing-table`: 19 per-instruction entries (minimum_cycles, blocking) agree with the ISA cost model
- **PASS** `exact-analysis`: 24 boundary contexts, 24 path variants, no widening or budget cut
- **PASS** `no-self-deadlock`: no WAITPIN waits for a level the engine itself forces
- **PASS** `reachable-faults`: only explicit FAULT codes [] reachable
- **INFO** `bounded-waits`: 5 WAITPIN/WAITEVENT contexts; LIMIT values [32768]; longest bounded stall 32767 cycles (655.340 us at 50 MHz) before fault 3
- **INFO** `holding-points`: unbounded FIFO waits hold: pc3 PULL [pin4=Z]
- **PASS** `spi-target-miso-latency`: after CS edge: MISO valid 4..5 cycles later, budget 8 (margin 3); after SCK edge: MISO valid 4..5 cycles later, budget 8 (margin 3); declared: "CS must be high between bytes, asserted at least 8 system clocks before first edge; each external half period at least 8 clocks.", "CS must be high between bytes, asserted at least 8 system clocks before first edge; each external half period at least 8 clocks."
- **PASS** `spi-target-mosi-hold`: MOSI sampled from the pad 1..2 cycles after the sampling SCK edge; the controller keeps it for >= 8 cycles (margin 6)
- **PASS** `spi-target-rearm`: after each SCK edge is seen the firmware waits for the next edge within 3 cycles (<= 8: no edge observed late; margin 5)
- **PASS** `spi-target-cs-setup`: after CS assertion is seen, waiting for the first SCK edge within 3 cycles (declared CS setup 8; margin 5)
- **PASS** `spi-target-miso-released`: MISO released (high-Z) at the PULL holding point between frames

### Boundaries

| boundary (context) | stall min..max | segment BCET..WCET | holding pads |
|---|---|---|---|
| START | 0..0 | 4..4 | pin4=Z |
| pc3 PULL | 0..inf | 4..4 | pin4=Z |
| pc7 WAITPIN pin5==1 [repeat=7] | 0..32767 | 1..1 | pin4=Z |
| pc8 WAITPIN pin5==0 [repeat=7] | 0..32767 | 3..3 | pin4=Z |
| pc11 WAITPIN pin2==1 [repeat=7] | 0..32767 | 2..2 | pin4=0|1 |
| pc13 WAITPIN pin2==0 [repeat=7] | 0..32767 | 3..3 | pin4=0|1 |
| pc11 WAITPIN pin2==1 [repeat=6] | 0..32767 | 2..2 | pin4=0|1 |
| pc13 WAITPIN pin2==0 [repeat=6] | 0..32767 | 3..3 | pin4=0|1 |
| pc11 WAITPIN pin2==1 [repeat=5] | 0..32767 | 2..2 | pin4=0|1 |
| pc13 WAITPIN pin2==0 [repeat=5] | 0..32767 | 3..3 | pin4=0|1 |
| pc11 WAITPIN pin2==1 [repeat=4] | 0..32767 | 2..2 | pin4=0|1 |
| pc13 WAITPIN pin2==0 [repeat=4] | 0..32767 | 3..3 | pin4=0|1 |
| pc11 WAITPIN pin2==1 [repeat=3] | 0..32767 | 2..2 | pin4=0|1 |
| pc13 WAITPIN pin2==0 [repeat=3] | 0..32767 | 3..3 | pin4=0|1 |
| pc11 WAITPIN pin2==1 [repeat=2] | 0..32767 | 2..2 | pin4=0|1 |
| pc13 WAITPIN pin2==0 [repeat=2] | 0..32767 | 3..3 | pin4=0|1 |
| pc11 WAITPIN pin2==1 [repeat=1] | 0..32767 | 2..2 | pin4=0|1 |
| pc13 WAITPIN pin2==0 [repeat=1] | 0..32767 | 3..3 | pin4=0|1 |
| pc11 WAITPIN pin2==1 | 0..32767 | 2..2 | pin4=0|1 |
| pc13 WAITPIN pin2==0 | 0..32767 | 2..2 | pin4=0|1 |
| pc15 WAITPIN pin5==1 | 0..32767 | 4..4 | pin4=0|1 |
| pc3 PULL | 0..inf | 4..4 | pin4=Z |
| pc7 WAITPIN pin5==1 [repeat=7] | 0..32767 | 1..1 | pin4=Z |
| pc8 WAITPIN pin5==0 [repeat=7] | 0..32767 | 3..3 | pin4=Z |

### Pin spacing

- pin4: exact spacings {1: 2}; across boundaries [('5', '65539'), ('6', '98307'), ('9', 'inf')]; minimum 1

### Loop periods

- pc3 `PULL` via JMP@pc18: 51..inf (x2)
- pc10 `OUT pin4 msb` via LOOP@pc14: 5..65539 (x8), 16..inf (x1)

### Edge schedules

```
  from START v0:
    +4      pc3   arrive PULL
  from pc3 PULL v0 (+1 identical contexts):
    +4      pc7   arrive WAITPIN pin5==1
  from pc7 WAITPIN pin5==1 [repeat=7] v0 (+1 identical contexts):
    +1      pc8   arrive WAITPIN pin5==0
  from pc8 WAITPIN pin5==0 [repeat=7] v0:
    +1      pc9   pin4 Z->0
    +2      pc10  pin4 0->0|1
    +3      pc11  arrive WAITPIN pin2==1
  from pc11 WAITPIN pin2==1 [repeat=7] v0 (+7 identical contexts):
    +1      pc12  sample pin3
    +2      pc13  arrive WAITPIN pin2==0
  from pc13 WAITPIN pin2==0 [repeat=7] v0 (+6 identical contexts):
    +2      pc10  pin4 0|1->0|1
    +3      pc11  arrive WAITPIN pin2==1
  from pc13 WAITPIN pin2==0 v0:
    +2      pc15  arrive WAITPIN pin5==1
  from pc15 WAITPIN pin5==1 v0:
    +1      pc16  pin4 0|1->Z
    +2      pc17  interaction
    +4      pc3   arrive PULL
  from pc8 WAITPIN pin5==0 [repeat=7] v0:
    +1      pc9   pin4 Z->0|1
    +2      pc10  pin4 0|1->0|1
    +3      pc11  arrive WAITPIN pin2==1
```

## spi-target-mode1

Engine 2, owned 0x10, open-drain 0x00, fused, 50 MHz annotation. Notes: "SPI target mode1, MSB-first 8-bit full duplex; SCK2/MOSI3/MISO4/CSn5." "CS must be high between bytes, asserted at least 8 system clocks before first edge; each external half period at least 8 clocks." "TX word must be queued before CS assertion; CS is checked at frame boundaries, interrupted frames terminate through LIMIT timeout. MISO releases at deassertion observation." "Full RX FIFO at completed-frame delivery halts with fault4 and retains the captured byte in READ_SELECT6."

### Checks

- **PASS** `identity`: bytecode sha256 matches, source sha256 matches
- **PASS** `assembler-timing-table`: 19 per-instruction entries (minimum_cycles, blocking) agree with the ISA cost model
- **PASS** `exact-analysis`: 25 boundary contexts, 25 path variants, no widening or budget cut
- **PASS** `no-self-deadlock`: no WAITPIN waits for a level the engine itself forces
- **PASS** `reachable-faults`: only explicit FAULT codes [] reachable
- **INFO** `bounded-waits`: 5 WAITPIN/WAITEVENT contexts; LIMIT values [32768]; longest bounded stall 32767 cycles (655.340 us at 50 MHz) before fault 3
- **INFO** `holding-points`: unbounded FIFO waits hold: pc3 PULL [pin4=Z]
- **PASS** `spi-target-miso-latency`: after SCK edge: MISO valid 3..4 cycles later, budget 8 (margin 4); declared: "CS must be high between bytes, asserted at least 8 system clocks before first edge; each external half period at least 8 clocks.", "CS must be high between bytes, asserted at least 8 system clocks before first edge; each external half period at least 8 clocks."
- **PASS** `spi-target-mosi-hold`: MOSI sampled from the pad 1..2 cycles after the sampling SCK edge; the controller keeps it for >= 8 cycles (margin 6)
- **PASS** `spi-target-rearm`: after each SCK edge is seen the firmware waits for the next edge within 3 cycles (<= 8: no edge observed late; margin 5)
- **PASS** `spi-target-cs-setup`: after CS assertion is seen, waiting for the first SCK edge within 2 cycles (declared CS setup 8; margin 6)
- **PASS** `spi-target-miso-released`: MISO released (high-Z) at the PULL holding point between frames

### Boundaries

| boundary (context) | stall min..max | segment BCET..WCET | holding pads |
|---|---|---|---|
| START | 0..0 | 4..4 | pin4=Z |
| pc3 PULL | 0..inf | 4..4 | pin4=Z |
| pc7 WAITPIN pin5==1 [repeat=7] | 0..32767 | 1..1 | pin4=Z |
| pc8 WAITPIN pin5==0 [repeat=7] | 0..32767 | 2..2 | pin4=Z |
| pc10 WAITPIN pin2==1 [repeat=7] | 0..32767 | 2..2 | pin4=0 |
| pc12 WAITPIN pin2==0 [repeat=7] | 0..32767 | 3..3 | pin4=0|1 |
| pc10 WAITPIN pin2==1 [repeat=6] | 0..32767 | 2..2 | pin4=0|1 |
| pc12 WAITPIN pin2==0 [repeat=6] | 0..32767 | 3..3 | pin4=0|1 |
| pc10 WAITPIN pin2==1 [repeat=5] | 0..32767 | 2..2 | pin4=0|1 |
| pc12 WAITPIN pin2==0 [repeat=5] | 0..32767 | 3..3 | pin4=0|1 |
| pc10 WAITPIN pin2==1 [repeat=4] | 0..32767 | 2..2 | pin4=0|1 |
| pc12 WAITPIN pin2==0 [repeat=4] | 0..32767 | 3..3 | pin4=0|1 |
| pc10 WAITPIN pin2==1 [repeat=3] | 0..32767 | 2..2 | pin4=0|1 |
| pc12 WAITPIN pin2==0 [repeat=3] | 0..32767 | 3..3 | pin4=0|1 |
| pc10 WAITPIN pin2==1 [repeat=2] | 0..32767 | 2..2 | pin4=0|1 |
| pc12 WAITPIN pin2==0 [repeat=2] | 0..32767 | 3..3 | pin4=0|1 |
| pc10 WAITPIN pin2==1 [repeat=1] | 0..32767 | 2..2 | pin4=0|1 |
| pc12 WAITPIN pin2==0 [repeat=1] | 0..32767 | 3..3 | pin4=0|1 |
| pc10 WAITPIN pin2==1 | 0..32767 | 2..2 | pin4=0|1 |
| pc12 WAITPIN pin2==0 | 0..32767 | 3..3 | pin4=0|1 |
| pc15 WAITPIN pin5==1 | 0..32767 | 4..4 | pin4=0|1 |
| pc3 PULL | 0..inf | 4..4 | pin4=Z |
| pc7 WAITPIN pin5==1 [repeat=7] | 0..32767 | 1..1 | pin4=Z |
| pc8 WAITPIN pin5==0 [repeat=7] | 0..32767 | 2..2 | pin4=Z |
| pc10 WAITPIN pin2==1 [repeat=7] | 0..32767 | 2..2 | pin4=0|1 |

### Pin spacing

- pin4: exact spacings {}; across boundaries [('2', '32769'), ('5', '65539'), ('9', 'inf')]; minimum 2

### Loop periods

- pc3 `PULL` via JMP@pc18: 51..inf (x2)
- pc10 `WAITPIN pin2==1` via LOOP@pc14: 5..65539 (x8), 16..inf (x1)

### Edge schedules

```
  from START v0:
    +4      pc3   arrive PULL
  from pc3 PULL v0 (+1 identical contexts):
    +4      pc7   arrive WAITPIN pin5==1
  from pc7 WAITPIN pin5==1 [repeat=7] v0 (+1 identical contexts):
    +1      pc8   arrive WAITPIN pin5==0
  from pc8 WAITPIN pin5==0 [repeat=7] v0:
    +1      pc9   pin4 Z->0
    +2      pc10  arrive WAITPIN pin2==1
  from pc10 WAITPIN pin2==1 [repeat=7] v0:
    +1      pc11  pin4 0->0|1
    +2      pc12  arrive WAITPIN pin2==0
  from pc12 WAITPIN pin2==0 [repeat=7] v0 (+6 identical contexts):
    +1      pc13  sample pin3
    +3      pc10  arrive WAITPIN pin2==1
  from pc10 WAITPIN pin2==1 [repeat=6] v0 (+7 identical contexts):
    +1      pc11  pin4 0|1->0|1
    +2      pc12  arrive WAITPIN pin2==0
  from pc12 WAITPIN pin2==0 v0:
    +1      pc13  sample pin3
    +3      pc15  arrive WAITPIN pin5==1
  from pc15 WAITPIN pin5==1 v0:
    +1      pc16  pin4 0|1->Z
    +2      pc17  interaction
    +4      pc3   arrive PULL
  from pc8 WAITPIN pin5==0 [repeat=7] v0:
    +1      pc9   pin4 Z->0|1
    +2      pc10  arrive WAITPIN pin2==1
```

## spi-target-mode2

Engine 2, owned 0x10, open-drain 0x00, fused, 50 MHz annotation. Notes: "SPI target mode2, MSB-first 8-bit full duplex; SCK2/MOSI3/MISO4/CSn5." "CS must be high between bytes, asserted at least 8 system clocks before first edge; each external half period at least 8 clocks." "TX word must be queued before CS assertion; CS is checked at frame boundaries, interrupted frames terminate through LIMIT timeout. MISO releases at deassertion observation." "Full RX FIFO at completed-frame delivery halts with fault4 and retains the captured byte in READ_SELECT6."

### Checks

- **PASS** `identity`: bytecode sha256 matches, source sha256 matches
- **PASS** `assembler-timing-table`: 19 per-instruction entries (minimum_cycles, blocking) agree with the ISA cost model
- **PASS** `exact-analysis`: 24 boundary contexts, 24 path variants, no widening or budget cut
- **PASS** `no-self-deadlock`: no WAITPIN waits for a level the engine itself forces
- **PASS** `reachable-faults`: only explicit FAULT codes [] reachable
- **INFO** `bounded-waits`: 5 WAITPIN/WAITEVENT contexts; LIMIT values [32768]; longest bounded stall 32767 cycles (655.340 us at 50 MHz) before fault 3
- **INFO** `holding-points`: unbounded FIFO waits hold: pc3 PULL [pin4=Z]
- **PASS** `spi-target-miso-latency`: after CS edge: MISO valid 4..5 cycles later, budget 8 (margin 3); after SCK edge: MISO valid 4..5 cycles later, budget 8 (margin 3); declared: "CS must be high between bytes, asserted at least 8 system clocks before first edge; each external half period at least 8 clocks.", "CS must be high between bytes, asserted at least 8 system clocks before first edge; each external half period at least 8 clocks."
- **PASS** `spi-target-mosi-hold`: MOSI sampled from the pad 1..2 cycles after the sampling SCK edge; the controller keeps it for >= 8 cycles (margin 6)
- **PASS** `spi-target-rearm`: after each SCK edge is seen the firmware waits for the next edge within 3 cycles (<= 8: no edge observed late; margin 5)
- **PASS** `spi-target-cs-setup`: after CS assertion is seen, waiting for the first SCK edge within 3 cycles (declared CS setup 8; margin 5)
- **PASS** `spi-target-miso-released`: MISO released (high-Z) at the PULL holding point between frames

### Boundaries

| boundary (context) | stall min..max | segment BCET..WCET | holding pads |
|---|---|---|---|
| START | 0..0 | 4..4 | pin4=Z |
| pc3 PULL | 0..inf | 4..4 | pin4=Z |
| pc7 WAITPIN pin5==1 [repeat=7] | 0..32767 | 1..1 | pin4=Z |
| pc8 WAITPIN pin5==0 [repeat=7] | 0..32767 | 3..3 | pin4=Z |
| pc11 WAITPIN pin2==0 [repeat=7] | 0..32767 | 2..2 | pin4=0|1 |
| pc13 WAITPIN pin2==1 [repeat=7] | 0..32767 | 3..3 | pin4=0|1 |
| pc11 WAITPIN pin2==0 [repeat=6] | 0..32767 | 2..2 | pin4=0|1 |
| pc13 WAITPIN pin2==1 [repeat=6] | 0..32767 | 3..3 | pin4=0|1 |
| pc11 WAITPIN pin2==0 [repeat=5] | 0..32767 | 2..2 | pin4=0|1 |
| pc13 WAITPIN pin2==1 [repeat=5] | 0..32767 | 3..3 | pin4=0|1 |
| pc11 WAITPIN pin2==0 [repeat=4] | 0..32767 | 2..2 | pin4=0|1 |
| pc13 WAITPIN pin2==1 [repeat=4] | 0..32767 | 3..3 | pin4=0|1 |
| pc11 WAITPIN pin2==0 [repeat=3] | 0..32767 | 2..2 | pin4=0|1 |
| pc13 WAITPIN pin2==1 [repeat=3] | 0..32767 | 3..3 | pin4=0|1 |
| pc11 WAITPIN pin2==0 [repeat=2] | 0..32767 | 2..2 | pin4=0|1 |
| pc13 WAITPIN pin2==1 [repeat=2] | 0..32767 | 3..3 | pin4=0|1 |
| pc11 WAITPIN pin2==0 [repeat=1] | 0..32767 | 2..2 | pin4=0|1 |
| pc13 WAITPIN pin2==1 [repeat=1] | 0..32767 | 3..3 | pin4=0|1 |
| pc11 WAITPIN pin2==0 | 0..32767 | 2..2 | pin4=0|1 |
| pc13 WAITPIN pin2==1 | 0..32767 | 2..2 | pin4=0|1 |
| pc15 WAITPIN pin5==1 | 0..32767 | 4..4 | pin4=0|1 |
| pc3 PULL | 0..inf | 4..4 | pin4=Z |
| pc7 WAITPIN pin5==1 [repeat=7] | 0..32767 | 1..1 | pin4=Z |
| pc8 WAITPIN pin5==0 [repeat=7] | 0..32767 | 3..3 | pin4=Z |

### Pin spacing

- pin4: exact spacings {1: 2}; across boundaries [('5', '65539'), ('6', '98307'), ('9', 'inf')]; minimum 1

### Loop periods

- pc3 `PULL` via JMP@pc18: 51..inf (x2)
- pc10 `OUT pin4 msb` via LOOP@pc14: 5..65539 (x8), 16..inf (x1)

### Edge schedules

```
  from START v0:
    +4      pc3   arrive PULL
  from pc3 PULL v0 (+1 identical contexts):
    +4      pc7   arrive WAITPIN pin5==1
  from pc7 WAITPIN pin5==1 [repeat=7] v0 (+1 identical contexts):
    +1      pc8   arrive WAITPIN pin5==0
  from pc8 WAITPIN pin5==0 [repeat=7] v0:
    +1      pc9   pin4 Z->0
    +2      pc10  pin4 0->0|1
    +3      pc11  arrive WAITPIN pin2==0
  from pc11 WAITPIN pin2==0 [repeat=7] v0 (+7 identical contexts):
    +1      pc12  sample pin3
    +2      pc13  arrive WAITPIN pin2==1
  from pc13 WAITPIN pin2==1 [repeat=7] v0 (+6 identical contexts):
    +2      pc10  pin4 0|1->0|1
    +3      pc11  arrive WAITPIN pin2==0
  from pc13 WAITPIN pin2==1 v0:
    +2      pc15  arrive WAITPIN pin5==1
  from pc15 WAITPIN pin5==1 v0:
    +1      pc16  pin4 0|1->Z
    +2      pc17  interaction
    +4      pc3   arrive PULL
  from pc8 WAITPIN pin5==0 [repeat=7] v0:
    +1      pc9   pin4 Z->0|1
    +2      pc10  pin4 0|1->0|1
    +3      pc11  arrive WAITPIN pin2==0
```

## spi-target-mode3

Engine 2, owned 0x10, open-drain 0x00, fused, 50 MHz annotation. Notes: "SPI target mode3, MSB-first 8-bit full duplex; SCK2/MOSI3/MISO4/CSn5." "CS must be high between bytes, asserted at least 8 system clocks before first edge; each external half period at least 8 clocks." "TX word must be queued before CS assertion; CS is checked at frame boundaries, interrupted frames terminate through LIMIT timeout. MISO releases at deassertion observation." "Full RX FIFO at completed-frame delivery halts with fault4 and retains the captured byte in READ_SELECT6."

### Checks

- **PASS** `identity`: bytecode sha256 matches, source sha256 matches
- **PASS** `assembler-timing-table`: 19 per-instruction entries (minimum_cycles, blocking) agree with the ISA cost model
- **PASS** `exact-analysis`: 25 boundary contexts, 25 path variants, no widening or budget cut
- **PASS** `no-self-deadlock`: no WAITPIN waits for a level the engine itself forces
- **PASS** `reachable-faults`: only explicit FAULT codes [] reachable
- **INFO** `bounded-waits`: 5 WAITPIN/WAITEVENT contexts; LIMIT values [32768]; longest bounded stall 32767 cycles (655.340 us at 50 MHz) before fault 3
- **INFO** `holding-points`: unbounded FIFO waits hold: pc3 PULL [pin4=Z]
- **PASS** `spi-target-miso-latency`: after SCK edge: MISO valid 3..4 cycles later, budget 8 (margin 4); declared: "CS must be high between bytes, asserted at least 8 system clocks before first edge; each external half period at least 8 clocks.", "CS must be high between bytes, asserted at least 8 system clocks before first edge; each external half period at least 8 clocks."
- **PASS** `spi-target-mosi-hold`: MOSI sampled from the pad 1..2 cycles after the sampling SCK edge; the controller keeps it for >= 8 cycles (margin 6)
- **PASS** `spi-target-rearm`: after each SCK edge is seen the firmware waits for the next edge within 3 cycles (<= 8: no edge observed late; margin 5)
- **PASS** `spi-target-cs-setup`: after CS assertion is seen, waiting for the first SCK edge within 2 cycles (declared CS setup 8; margin 6)
- **PASS** `spi-target-miso-released`: MISO released (high-Z) at the PULL holding point between frames

### Boundaries

| boundary (context) | stall min..max | segment BCET..WCET | holding pads |
|---|---|---|---|
| START | 0..0 | 4..4 | pin4=Z |
| pc3 PULL | 0..inf | 4..4 | pin4=Z |
| pc7 WAITPIN pin5==1 [repeat=7] | 0..32767 | 1..1 | pin4=Z |
| pc8 WAITPIN pin5==0 [repeat=7] | 0..32767 | 2..2 | pin4=Z |
| pc10 WAITPIN pin2==0 [repeat=7] | 0..32767 | 2..2 | pin4=0 |
| pc12 WAITPIN pin2==1 [repeat=7] | 0..32767 | 3..3 | pin4=0|1 |
| pc10 WAITPIN pin2==0 [repeat=6] | 0..32767 | 2..2 | pin4=0|1 |
| pc12 WAITPIN pin2==1 [repeat=6] | 0..32767 | 3..3 | pin4=0|1 |
| pc10 WAITPIN pin2==0 [repeat=5] | 0..32767 | 2..2 | pin4=0|1 |
| pc12 WAITPIN pin2==1 [repeat=5] | 0..32767 | 3..3 | pin4=0|1 |
| pc10 WAITPIN pin2==0 [repeat=4] | 0..32767 | 2..2 | pin4=0|1 |
| pc12 WAITPIN pin2==1 [repeat=4] | 0..32767 | 3..3 | pin4=0|1 |
| pc10 WAITPIN pin2==0 [repeat=3] | 0..32767 | 2..2 | pin4=0|1 |
| pc12 WAITPIN pin2==1 [repeat=3] | 0..32767 | 3..3 | pin4=0|1 |
| pc10 WAITPIN pin2==0 [repeat=2] | 0..32767 | 2..2 | pin4=0|1 |
| pc12 WAITPIN pin2==1 [repeat=2] | 0..32767 | 3..3 | pin4=0|1 |
| pc10 WAITPIN pin2==0 [repeat=1] | 0..32767 | 2..2 | pin4=0|1 |
| pc12 WAITPIN pin2==1 [repeat=1] | 0..32767 | 3..3 | pin4=0|1 |
| pc10 WAITPIN pin2==0 | 0..32767 | 2..2 | pin4=0|1 |
| pc12 WAITPIN pin2==1 | 0..32767 | 3..3 | pin4=0|1 |
| pc15 WAITPIN pin5==1 | 0..32767 | 4..4 | pin4=0|1 |
| pc3 PULL | 0..inf | 4..4 | pin4=Z |
| pc7 WAITPIN pin5==1 [repeat=7] | 0..32767 | 1..1 | pin4=Z |
| pc8 WAITPIN pin5==0 [repeat=7] | 0..32767 | 2..2 | pin4=Z |
| pc10 WAITPIN pin2==0 [repeat=7] | 0..32767 | 2..2 | pin4=0|1 |

### Pin spacing

- pin4: exact spacings {}; across boundaries [('2', '32769'), ('5', '65539'), ('9', 'inf')]; minimum 2

### Loop periods

- pc3 `PULL` via JMP@pc18: 51..inf (x2)
- pc10 `WAITPIN pin2==0` via LOOP@pc14: 5..65539 (x8), 16..inf (x1)

### Edge schedules

```
  from START v0:
    +4      pc3   arrive PULL
  from pc3 PULL v0 (+1 identical contexts):
    +4      pc7   arrive WAITPIN pin5==1
  from pc7 WAITPIN pin5==1 [repeat=7] v0 (+1 identical contexts):
    +1      pc8   arrive WAITPIN pin5==0
  from pc8 WAITPIN pin5==0 [repeat=7] v0:
    +1      pc9   pin4 Z->0
    +2      pc10  arrive WAITPIN pin2==0
  from pc10 WAITPIN pin2==0 [repeat=7] v0:
    +1      pc11  pin4 0->0|1
    +2      pc12  arrive WAITPIN pin2==1
  from pc12 WAITPIN pin2==1 [repeat=7] v0 (+6 identical contexts):
    +1      pc13  sample pin3
    +3      pc10  arrive WAITPIN pin2==0
  from pc10 WAITPIN pin2==0 [repeat=6] v0 (+7 identical contexts):
    +1      pc11  pin4 0|1->0|1
    +2      pc12  arrive WAITPIN pin2==1
  from pc12 WAITPIN pin2==1 v0:
    +1      pc13  sample pin3
    +3      pc15  arrive WAITPIN pin5==1
  from pc15 WAITPIN pin5==1 v0:
    +1      pc16  pin4 0|1->Z
    +2      pc17  interaction
    +4      pc3   arrive PULL
  from pc8 WAITPIN pin5==0 [repeat=7] v0:
    +1      pc9   pin4 Z->0|1
    +2      pc10  arrive WAITPIN pin2==0
```

## swd-read

Engine 0, owned 0x03, open-drain 0x00, fused, 50 MHz annotation. Notes: "SWD host (Arm ADIv5 Serial Wire Debug) on SWCLK pin0 and SWDIO pin1, push-pull; SWDIO is released while the target drives it. TX word: bits 7..0 a read request header (Start, APnDP, RnW=1, A[2:3], Parity, Stop, Park; LSB first; 0xA5 reads DP DPIDR); bit 8 set: connect first. RX word: the 32-bit read data." "Connect: 56 SWCLK cycles with SWDIO high, the 16-bit JTAG-to-SWD select sequence 0xE79E LSB first, then 56 SWCLK cycles with SWDIO high (line reset). Every request starts with 8 idle cycles (SWDIO low)." "SWCLK half period 16 clocks (1.5625 MHz at 50000000 Hz). SWDIO changes only while SWCLK is low; ACK, data and parity are sampled at SWCLK rising edges from the pad value 2 clocks before the edge." "Park is driven high, then SWDIO is released for one turnaround cycle before ACK[0:2]. After RDATA[0:31] and its even parity bit: one turnaround cycle, 8 idle cycles with SWDIO low, then SWCLK stops low and SWDIO is driven high until the next request." "An ACK other than OK pushes the three ACK bits in wire order (4 OK, 2 WAIT, 1 FAULT, 7 no response), clocks one turnaround cycle and faults 80. A data parity error pushes the data word and faults 81. A header with RnW=0 faults 82 before any SWCLK edge." "Scope: read transactions only; the host builds the header, including its parity. No write data phase, no WAIT retry, no dormant-state (ADIv5.2) wake-up sequence. SWCLK is not free-running and a fault releases both pins."

### Checks

- **PASS** `identity`: bytecode sha256 matches, source sha256 matches
- **PASS** `assembler-timing-table`: 60 per-instruction entries (minimum_cycles, blocking) agree with the ISA cost model
- **PASS** `exact-analysis`: 6 boundary contexts, 18 path variants, no widening or budget cut
- **PASS** `no-self-deadlock`: no WAITPIN waits for a level the engine itself forces
- **PASS** `reachable-faults`: only explicit FAULT codes [80, 81, 82] reachable
- **INFO** `holding-points`: unbounded FIFO waits hold: pc3 PULL [pin0=0 pin1=1]; pc33 PUSH [pin0=0 pin1=Z]; pc53 PUSH [pin0=0 pin1=0]; pc56 PUSH [pin0=0 pin1=0]
- **PASS** `swd-dpidr-header`: declared header 0xA5 = start 1, APnDP 0, RnW 1, A2 0, A3 0, parity 1, stop 0, park 1: a DP read of address 0x0 (DPIDR) with even parity over APnDP, RnW, A[2:3], Stop 0 and Park 1 (ADIv5.1 Supplement 8.3.5)
- **PASS** `swd-sequence`: SWDIO at every SWCLK rise, all 14 request paths: connect = 56 x 1, 0xE79E LSB first, 56 x 1 (ADIv5.1 Supplement 6.2.1 and 8.3.6: at least 50 x 1, then at least one idle cycle); every request: 8 idle rises with SWDIO low, 8 driven header bits, then SWDIO released at the turnaround rise, the 3 ACK rises and, after ACK OK, the 32 data rises, the parity rise and the second turnaround rise, then 8 idle rises with SWDIO driven low. Samples are taken exactly at the ACK, data and parity rises (36; 3 when the ACK is not OK). A header with RnW = 0 faults 82 with no SWCLK edge
- **PASS** `swd-clock`: SWCLK high phases [(16, 16)] clocks, low phases at least 16 clocks (declared half period 16; a low phase between two XFERs is longer)
- **PASS** `swd-host-drive`: every host SWDIO change (drive, release, re-drive) happens while SWCLK is low; set-up to the next SWCLK rise >= 16 clocks, hold after a rise >= 16 clocks (half period 16); Park is driven before the release (ADIv5.1 Supplement erratum 2.6)
- **PASS** `swd-target-budget`: each ACK, data or parity sample is taken at a SWCLK rise at least 32 clocks after the rise on which the target launched the bit, from the pad value 2 clocks earlier: the target's output delay plus board delay must stay below 30 clocks (600.0 ns at 50 MHz)
- **PASS** `swd-clock-after-data`: 9 SWCLK rises after the data parity bit before SWCLK stops (one turnaround and 8 idle cycles); ADIv5.1 Supplement 8.2 asks for at least 8
- **PASS** `swd-idle-line`: SWCLK low and SWDIO driven high at every PULL holding point (ADIv5.1 Supplement 8.3.2: the host holds the line high between uses)
- **INFO** `swd-rate`: SWCLK = clock/32: 10MHz 0.3125 MHz, 25MHz 0.7812 MHz, 50MHz 1.562 MHz, 66MHz 2.062 MHz, 100MHz 3.125 MHz; SWCLK stretches between instructions (ADIv5 has no minimum SWCLK frequency); longest request path 6220 clocks

### Boundaries

| boundary (context) | stall min..max | segment BCET..WCET | holding pads |
|---|---|---|---|
| START | 0..0 | 4..4 | pin0=Z pin1=Z |
| pc3 PULL | 0..inf | 5..6220 | pin0=0 pin1=1 |
| pc33 PUSH | 0..inf | 34..34 | pin0=0 pin1=Z |
| pc53 PUSH | 0..inf | 1..1 | pin0=0 pin1=0 |
| pc56 PUSH | 0..inf | 3..3 | pin0=0 pin1=0 |
| pc3 PULL | 0..inf | 5..6220 | pin0=0 pin1=1 |

### Pin spacing

- pin0: exact spacings {1: 1, 16: 2585, 17: 20, 18: 24, 19: 34, 20: 14}; across boundaries [('104', 'inf'), ('111', 'inf'), ('21', 'inf'), ('7', 'inf')]; minimum 1
- pin1: exact spacings {32: 90, 33: 12, 64: 12, 128: 6, 131: 6, 259: 12, 1229: 8, 1891: 6}; across boundaries [('361', 'inf'), ('7', 'inf')]; minimum 7

### Loop periods

- pc3 `PULL` via JMP@pc58: 2115..inf (x2)
- pc45 `XOR rx, x` via LOOP@pc47: 3 (x248), 2022..inf (x4)

### Edge schedules

```
  from START v0:
    +2      pc1   pin0 Z->0
    +2      pc1   pin1 Z->1
    +4      pc3   arrive PULL
  from pc3 PULL v0 (+1 identical contexts):
    +25     pc12  pin0 0->1
    +41     pc12  pin0 1->0
    +57     pc12  pin0 0->1
    +73     pc12  pin0 1->0
    +89     pc12  pin0 0->1
    +105    pc12  pin0 1->0
    +121    pc12  pin0 0->1
    +137    pc12  pin0 1->0
    +153    pc12  pin0 0->1
    +169    pc12  pin0 1->0
    +185    pc12  pin0 0->1
    +201    pc12  pin0 1->0
    +217    pc12  pin0 0->1
    +233    pc12  pin0 1->0
    +249    pc12  pin0 0->1
    +265    pc12  pin0 1->0
    +281    pc12  pin0 0->1
    +297    pc12  pin0 1->0
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
    +33     pc34  pin0 1->0
    +34     pc35  pin0 0->Z
    end: fault80 at +34
  from pc53 PUSH v0:
    +1      pc54  pin0 0->Z
    +1      pc54  pin1 0->Z
    end: fault81 at +1
  from pc56 PUSH v0:
    +1      pc57  pin1 0->1
    +3      pc3   arrive PULL
```

## uart-rx-idle

Engine 1, owned 0x00, open-drain 0x00, fused, 50 MHz annotation. Notes: "UART 8N1 RX on pin1, 64 clocks per bit, low-byte RX words." "Idle-tolerant: the idle and start-bit waits poll the synchronized line with IN/XOR/JZ and have no bound (no WAITPIN, no LIMIT), so the line may stay idle indefinitely and fault3 cannot occur. After START it first waits for the idle-high line." "Start-bit poll period 3 clocks (detection latency 0..2 clocks). Frame bit n (start bit 0, stop bit 9) is sampled 64n+31..64n+33 clocks after the edge whose pad sample first showed the start bit low (95 clocks after the poll sample that saw it); declared baud tolerance +-2%." "Stop-bit low produces fault64; a full RX FIFO at completed-frame delivery halts with fault4 (strict PUSH), as in uart-rx; the captured byte remains inspectable in the RX register (READ_SELECT6)."

### Checks

- **PASS** `identity`: bytecode sha256 matches, source sha256 matches
- **PASS** `assembler-timing-table`: 24 per-instruction entries (minimum_cycles, blocking) agree with the ISA cost model
- **PASS** `exact-analysis`: 5 boundary contexts, 9 path variants, no widening or budget cut
- **PASS** `no-self-deadlock`: no WAITPIN waits for a level the engine itself forces
- **PASS** `reachable-faults`: only explicit FAULT codes [64] reachable
- **PASS** `uart-rx-idle-unbounded-wait`: no WAITPIN, WAITEVENT or LIMIT in the image, so fault 3 is unreachable; the idle and start-bit waits are data-dependent loops without a counter: JZ at pc3 samples pin1 at pc2 every [2] clocks; JZ at pc20 samples pin1 at pc18 every [3] clocks
- **PASS** `uart-rx-idle-poll-period`: start-bit poll period [3] clocks (detection latency 0..2); declared: "poll period 3 clocks"
- **PASS** `uart-rx-idle-center-sampling`: data bits sampled 31..33 and the stop bit 31..33 clocks into the bit, counted from the first edge that registered the start bit (one more from the line edge; centre 32); the first data sample is 95 clocks after the poll sample that saw the start bit; declared: "sampled 64n+31..64n+33 clocks"
- **PASS** `uart-rx-idle-baud-tolerance`: all 9 samples stay inside their bit for a transmitter bit period within -4.688% .. +5.382% of 64 clocks, i.e. a baud error of -5.107% .. +4.918% (includes the 0..2-clock poll latency and the 1-clock asynchronous edge uncertainty); declared: +-2%
- **PASS** `uart-rx-idle-rearm`: the poll samples the line again 612 clocks after the poll sample that saw the start bit (614 after the registered start edge at the latest); the next start edge (1 stop bit, no idle) is 640 clocks after the previous one: margin 25 clocks; back-to-back traffic keeps the 0..2-clock detection latency for a transmitter bit period down to -3.906% of 64 clocks
- **INFO** `uart-rx-idle-rate`: baud = clock/64: 10MHz 156250 Bd, 25MHz 390625 Bd, 50MHz 781250 Bd, 66MHz 1031250 Bd, 100MHz 1562500 Bd

### Boundaries

| boundary (context) | stall min..max | segment BCET..WCET | holding pads |
|---|---|---|---|
| START | 0..0 | 4..4 |  |
| pc3 JZ rx, 2 <idle> [repeat=7] | 0..0 | 2..5 |  |
| pc20 JZ rx, 18 <poll> [repeat=7] | 0..0 | 3..606 |  |
| pc14 JZ rx, 23 <framing_error> [repeat=7] | 0..0 | 1..6 |  |
| pc20 JZ rx, 18 <poll> [repeat=7] | 0..0 | 3..606 |  |

### Pin spacing

### Loop periods

- pc2 `IN pin1 msb` via JZ@pc3: 2..inf (x2)
- pc5 `WAIT 61` via LOOP@pc7, JMP@pc22: 64 (x14), 164..inf (x2)
- pc18 `IN pin1 msb` via JZ@pc20: 3..612 (x4)

### Edge schedules

```
  from START v0:
    +3      pc2   sample pin1
    +4      pc3   arrive JZ rx, 2 <idle>
  from pc3 JZ rx, 2 <idle> [repeat=7] v0:
    +1      pc2   sample pin1
    +2      pc3   arrive JZ rx, 2 <idle>
  from pc3 JZ rx, 2 <idle> [repeat=7] v1:
    +3      pc18  sample pin1
    +5      pc20  arrive JZ rx, 18 <poll>
  from pc20 JZ rx, 18 <poll> [repeat=7] v0 (+1 identical contexts):
    +1      pc18  sample pin1
    +3      pc20  arrive JZ rx, 18 <poll>
  from pc20 JZ rx, 18 <poll> [repeat=7] v1 (+1 identical contexts):
    +93     pc6   sample pin1
    +157    pc6   sample pin1
    +221    pc6   sample pin1
    +285    pc6   sample pin1
    +349    pc6   sample pin1
    +413    pc6   sample pin1
    +477    pc6   sample pin1
    +541    pc6   sample pin1
    +605    pc13  sample pin1
    +606    pc14  arrive JZ rx, 23 <framing_error>
  from pc14 JZ rx, 23 <framing_error> [repeat=7] v0:
    end: fault64 at +1
  from pc14 JZ rx, 23 <framing_error> [repeat=7] v1:
    +2      pc16  interaction
    +4      pc18  sample pin1
    +6      pc20  arrive JZ rx, 18 <poll>
```

## uart-rx

Engine 1, owned 0x00, open-drain 0x00, fused, 50 MHz annotation. Notes: "UART 8N1 RX on pin1, 64 clocks per bit, low-byte RX words." "Two-flop input synchronization precedes center sampling; stop-bit low produces fault64. Idle/start waits are bounded by 12 bit periods." "A full RX FIFO at completed-frame delivery halts with fault4; the captured byte remains inspectable in the RX register (READ_SELECT6)."

### Checks

- **PASS** `identity`: bytecode sha256 matches, source sha256 matches
- **PASS** `assembler-timing-table`: 18 per-instruction entries (minimum_cycles, blocking) agree with the ISA cost model
- **PASS** `exact-analysis`: 5 boundary contexts, 7 path variants, no widening or budget cut
- **PASS** `no-self-deadlock`: no WAITPIN waits for a level the engine itself forces
- **PASS** `reachable-faults`: only explicit FAULT codes [64] reachable
- **INFO** `bounded-waits`: 2 WAITPIN/WAITEVENT contexts; LIMIT values [768]; longest bounded stall 767 cycles (15.340 us at 50 MHz) before fault 3
- **PASS** `uart-rx-center-sampling`: data bits sampled 32..33 cycles into the bit (centre 32), stop bit +35..36 of 64; offsets from start-edge sample: (96, 160, 224, 288, 352, 416, 480, 544, 611); declared: "UART 8N1 RX on pin1, 64 clocks per bit, low-byte RX words."
- **INFO** `uart-rx-baud-tolerance`: all 9 samples stay inside their bit for a transmitter bit period within -4.37% .. +6.08% of 64 cycles (includes the 1-cycle asynchronous start-edge uncertainty)
- **PASS** `uart-rx-rearm`: re-armed at the start-bit WAITPIN 619 cycles after the start edge is seen; the next start edge (1 stop bit) is 640 cycles after the previous one: margin 20 cycles; continuous traffic tolerates a transmitter up to -3.12% fast without late start detection
- **PASS** `uart-rx-idle-bound`: idle/start WAITPIN LIMIT [768] = 12 x 64-cycle bit periods; declared: "Two-flop input synchronization precedes center sampling; stop-bit low produces fault64. Idle/start waits are bounded by 12 bit periods."
- **INFO** `uart-rx-rate`: baud = clock/64: 10MHz 156250 Bd, 25MHz 390625 Bd, 50MHz 781250 Bd, 66MHz 1031250 Bd, 100MHz 1562500 Bd

### Boundaries

| boundary (context) | stall min..max | segment BCET..WCET | holding pads |
|---|---|---|---|
| START | 0..0 | 4..4 |  |
| pc3 WAITPIN pin1==1 [repeat=7] | 0..767 | 1..1 |  |
| pc4 WAITPIN pin1==0 [repeat=7] | 0..767 | 613..618 |  |
| pc3 WAITPIN pin1==1 [repeat=7] | 0..767 | 1..1 |  |
| pc4 WAITPIN pin1==0 [repeat=7] | 0..767 | 613..618 |  |

### Pin spacing

### Loop periods

- pc1 `LOAD rx, 0` via JMP@pc16: 619..2153 (x3)
- pc6 `IN pin1 lsb` via LOOP@pc8: 64 (x28), 171..1705 (x2)

### Edge schedules

```
  from START v0:
    +4      pc3   arrive WAITPIN pin1==1
  from pc3 WAITPIN pin1==1 [repeat=7] v0 (+1 identical contexts):
    +1      pc4   arrive WAITPIN pin1==0
  from pc4 WAITPIN pin1==0 [repeat=7] v0 (+1 identical contexts):
    +96     pc6   sample pin1
    +160    pc6   sample pin1
    +224    pc6   sample pin1
    +288    pc6   sample pin1
    +352    pc6   sample pin1
    +416    pc6   sample pin1
    +480    pc6   sample pin1
    +544    pc6   sample pin1
    +611    pc12  sample pin1
    +614    pc15  interaction
    +618    pc3   arrive WAITPIN pin1==1
  from pc4 WAITPIN pin1==0 [repeat=7] v1 (+1 identical contexts):
    +96     pc6   sample pin1
    +160    pc6   sample pin1
    +224    pc6   sample pin1
    +288    pc6   sample pin1
    +352    pc6   sample pin1
    +416    pc6   sample pin1
    +480    pc6   sample pin1
    +544    pc6   sample pin1
    +611    pc12  sample pin1
    end: fault64 at +613
```

## uart-tx

Engine 0, owned 0x01, open-drain 0x00, fused, 50 MHz annotation. Notes: "UART 8N1 TX on pin0, LSB first, exact bit period 64 clocks (50000000 Hz nominal clock)." "TX FIFO low byte supplies each frame; FIFO-empty holding point is idle high; interframe idle includes loop/setup cycles."

### Checks

- **PASS** `identity`: bytecode sha256 matches, source sha256 matches
- **PASS** `assembler-timing-table`: 12 per-instruction entries (minimum_cycles, blocking) agree with the ISA cost model
- **PASS** `exact-analysis`: 3 boundary contexts, 3 path variants, no widening or budget cut
- **PASS** `no-self-deadlock`: no WAITPIN waits for a level the engine itself forces
- **PASS** `reachable-faults`: only explicit FAULT codes [] reachable
- **INFO** `holding-points`: unbounded FIFO waits hold: pc2 PULL [pin0=1]
- **PASS** `uart-tx-bit-period`: start bit and all 8 data bits last exactly 64 cycles in every context (18 bit boundaries); declared: "UART 8N1 TX on pin0, LSB first, exact bit period 64 clocks (50000000 Hz nominal clock)."
- **PASS** `uart-tx-frame-8N1`: each frame: start (1->0), 8 OUT data bits, stop (->1); contexts {'pc2 PULL': 16}
- **PASS** `uart-tx-stop-bit`: stop bit (idle high before the next start bit) >= 68 cycles, required >= 64; margin 4 cycles (loop/PULL overhead), unbounded while the TX FIFO is empty
- **PASS** `uart-tx-idle-high`: TX pin driven high at every FIFO holding point (PULL)
- **INFO** `uart-tx-rate`: baud = clock/64: 10MHz 156250 Bd, 25MHz 390625 Bd, 50MHz 781250 Bd, 66MHz 1031250 Bd, 100MHz 1562500 Bd; back-to-back frame period >= 644 cycles (10 bits = 640); standard 115200 Bd would need a 7.3728 MHz clock

### Boundaries

| boundary (context) | stall min..max | segment BCET..WCET | holding pads |
|---|---|---|---|
| START | 0..0 | 3..3 | pin0=Z |
| pc2 PULL | 0..inf | 644..644 | pin0=1 |
| pc2 PULL | 0..inf | 644..644 | pin0=1 |

### Pin spacing

- pin0: exact spacings {64: 18}; across boundaries [('3', 'inf'), ('68', 'inf')]; minimum 3

### Loop periods

- pc2 `PULL` via JMP@pc11: 644..inf (x3)
- pc6 `OUT pin0 lsb` via LOOP@pc8: 64 (x14), 196..inf (x2)

### Edge schedules

```
  from START v0:
    +2      pc1   pin0 Z->1
    +3      pc2   arrive PULL
  from pc2 PULL v0 (+1 identical contexts):
    +2      pc4   pin0 1->0
    +66     pc6   pin0 0->0|1
    +130    pc6   pin0 0|1->0|1
    +194    pc6   pin0 0|1->0|1
    +258    pc6   pin0 0|1->0|1
    +322    pc6   pin0 0|1->0|1
    +386    pc6   pin0 0|1->0|1
    +450    pc6   pin0 0|1->0|1
    +514    pc6   pin0 0|1->0|1
    +578    pc9   pin0 0|1->1
    +644    pc2   arrive PULL
```

## waveform

Engine 0, owned 0x01, open-drain 0x00, fused, 50 MHz annotation. Notes: "Custom timed waveform: sixteen pin0 pulses, high for half-period clocks and low for twice half-period clocks; final timestamp in RX FIFO."

### Checks

- **PASS** `identity`: bytecode sha256 matches, source sha256 matches
- **PASS** `assembler-timing-table`: 11 per-instruction entries (minimum_cycles, blocking) agree with the ISA cost model
- **PASS** `exact-analysis`: 2 boundary contexts, 2 path variants, no widening or budget cut
- **PASS** `no-self-deadlock`: no WAITPIN waits for a level the engine itself forces
- **PASS** `reachable-faults`: only explicit FAULT codes [] reachable
- **INFO** `holding-points`: unbounded FIFO waits hold: pc9 PUSH [pin0=0]
- **PASS** `waveform-pulses`: 16 pulses, high [32] cycles, low [64] cycles; declared 16 pulses high 32 / low 64 (half-period 32: docs/firmware.md default)
- **INFO** `waveform-timestamp`: TIME issues 1540 cycles after the START edge, 64 cycles after the last falling edge

### Boundaries

| boundary (context) | stall min..max | segment BCET..WCET | holding pads |
|---|---|---|---|
| START | 0..0 | 1541..1541 | pin0=Z |
| pc9 PUSH | 0..inf | 1..1 | pin0=0 |

### Pin spacing

- pin0: exact spacings {2: 1, 32: 16, 64: 15}; across boundaries [('66', 'inf')]; minimum 2

### Loop periods

- pc3 `SET 0x01` via LOOP@pc7: 96 (x15)

### Edge schedules

```
  from START v0:
    +2      pc1   pin0 Z->0
    +4      pc3   pin0 0->1
    +36     pc5   pin0 1->0
    +100    pc3   pin0 0->1
    +132    pc5   pin0 1->0
    +196    pc3   pin0 0->1
    +228    pc5   pin0 1->0
    +292    pc3   pin0 0->1
    +324    pc5   pin0 1->0
    +388    pc3   pin0 0->1
    +420    pc5   pin0 1->0
    +484    pc3   pin0 0->1
    +516    pc5   pin0 1->0
    +580    pc3   pin0 0->1
    +612    pc5   pin0 1->0
    +676    pc3   pin0 0->1
    +708    pc5   pin0 1->0
    +772    pc3   pin0 0->1
    +804    pc5   pin0 1->0
    +868    pc3   pin0 0->1
    +900    pc5   pin0 1->0
    +964    pc3   pin0 0->1
    +996    pc5   pin0 1->0
    +1060   pc3   pin0 0->1
    +1092   pc5   pin0 1->0
    +1156   pc3   pin0 0->1
    +1188   pc5   pin0 1->0
    +1252   pc3   pin0 0->1
    +1284   pc5   pin0 1->0
    +1348   pc3   pin0 0->1
    +1380   pc5   pin0 1->0
    +1444   pc3   pin0 0->1
    +1476   pc5   pin0 1->0
    +1540   pc8   interaction
    +1541   pc9   arrive PUSH
  from pc9 PUSH v0:
    +1      pc10  pin0 0->Z
    end: halt at +1
```

## ws2812

Engine 1, owned 0x04, open-drain 0x00, fused, 50 MHz annotation. Notes: "WS2812B data output on DOUT pin2, push-pull; timing from the Worldsemi WS2812B datasheet (T0H 0.4 us, T1H 0.8 us, T0L 0.85 us, T1L 0.45 us, each +-150 ns; RES above 50 us). TX word: G<<24 | R<<16 | B<<8 | L: 24 bits GRB, MSB first; a nonzero low byte L ends the frame with a reset (latch) low time." "Bit timing at 50000000 Hz: T0H 20, T1H 40, T0L 43, T1L 23 clocks (0.4, 0.8, 0.86, 0.46 us); bit period 63 clocks (1.26 us), also across pixel boundaries while the TX FIFO has data." "Reset low time: 15004 clocks (300.08 us) after START and 15025 clocks (300.5 us) after a word with a nonzero low byte." "Holding point: DOUT low while PULL waits. Keep the TX FIFO non-empty during a frame: an empty FIFO stretches the low time of the last bit sent, and a gap longer than the reset time latches early." "3.3 V output: this datasheet gives VIH = 0.7 VDD (3.5 V at VDD = 5 V), so a 5 V LED needs a level shifter. The WS2812B-V5 revision has other bit windows: see ws2812b-v5."

### Checks

- **PASS** `identity`: bytecode sha256 matches, source sha256 matches
- **PASS** `assembler-timing-table`: 22 per-instruction entries (minimum_cycles, blocking) agree with the ISA cost model
- **PASS** `exact-analysis`: 3 boundary contexts, 5 path variants, no widening or budget cut
- **PASS** `no-self-deadlock`: no WAITPIN waits for a level the engine itself forces
- **PASS** `reachable-faults`: only explicit FAULT codes [] reachable
- **INFO** `holding-points`: unbounded FIFO waits hold: pc3 PULL [pin2=0]
- **PASS** `ws2812-bit-schedule`: every pixel: 24 bits, MSB first (OUT c=1); high 20 clocks then the bit (OUT), low at 40; next bit 63 clocks after the previous one, also across the pixel boundary when the next TX word is queued: T0H [20], T1H [40], T0L [43], T1L [23], bit period [63] (declared T0H 20, T1H 40, T0L 43, T1L 23, period 63); rises/OUTs/falls per pixel [(24, 24, 24)]
- **PASS** `ws2812-datasheet-bits`: WS2812B datasheet at 50 MHz: T0H 20 clocks = 400 ns (250 ns..550 ns; 150 ns above the minimum, 150 ns below the maximum); T1H 40 clocks = 800 ns (650 ns..950 ns; 150 ns above the minimum, 150 ns below the maximum); T0L 43 clocks = 860 ns (700 ns..1000 ns; 160 ns above the minimum, 140 ns below the maximum); T1L 23 clocks = 460 ns (300 ns..600 ns; 160 ns above the minimum, 140 ns below the maximum); TH+TL 63 clocks = 1260 ns (650 ns..1850 ns; 610 ns above the minimum, 590 ns below the maximum). all hold for clocks from 43.00 to 61.43 MHz
- **PASS** `ws2812-reset`: WS2812B datasheet at 50 MHz: reset after START 15004 clocks = 300.08 us (>= 50.00 us; 250.08 us above the minimum); reset after a latch word 15025 clocks = 300.50 us (>= 50.00 us; 250.50 us above the minimum). all hold for clocks from 0.00 to 300.08 MHz. low times ending a frame [15004, 15025, 15045] clocks (declared 15004 after START, 15025 after a latch word); DOUT is low at the PULL holding point, so a TX FIFO underrun also latches once the stall exceeds 2477 clocks
- **PASS** `ws2812-underrun`: DOUT is driven low at every PULL holding point. A PULL stall of s clocks between pixels lengthens the last bit's low time by s: T0L stays within WS2812B datasheet for s <= 7, T1L for s <= 7; one TX word is consumed every 1512 clocks (30.240 us at 50 MHz)

### Boundaries

| boundary (context) | stall min..max | segment BCET..WCET | holding pads |
|---|---|---|---|
| START | 0..0 | 15004..15004 | pin2=Z |
| pc3 PULL | 0..inf | 1512..16514 | pin2=0 |
| pc3 PULL | 0..inf | 1512..16514 | pin2=0 |

### Pin spacing

- pin2: exact spacings {20: 192, 23: 92}; across boundaries [('15004', 'inf'), ('15025', 'inf'), ('23', 'inf')]; minimum 20

### Loop periods

- pc3 `PULL` via JZ@pc19, JMP@pc21: 1512..inf (x5)
- pc5 `SET 0x04` via LOOP@pc11: 63 (x88), 126..inf (x2), 15128..inf (x2)

### Edge schedules

```
  from START v0:
    +2      pc1   pin2 Z->0
    +15004  pc3   arrive PULL
  from pc3 PULL v0 (+1 identical contexts):
    +2      pc5   pin2 0->1
    +22     pc7   pin2 1->0|1
    +42     pc9   pin2 0|1->0
    +65     pc5   pin2 0->1
    +85     pc7   pin2 1->0|1
    +105    pc9   pin2 0|1->0
    +128    pc5   pin2 0->1
    +148    pc7   pin2 1->0|1
    +168    pc9   pin2 0|1->0
    +191    pc5   pin2 0->1
    +211    pc7   pin2 1->0|1
    +231    pc9   pin2 0|1->0
    +254    pc5   pin2 0->1
    +274    pc7   pin2 1->0|1
    +294    pc9   pin2 0|1->0
    +317    pc5   pin2 0->1
    +337    pc7   pin2 1->0|1
    +357    pc9   pin2 0|1->0
    +380    pc5   pin2 0->1
    +400    pc7   pin2 1->0|1
    +420    pc9   pin2 0|1->0
    +443    pc5   pin2 0->1
    +463    pc7   pin2 1->0|1
    +483    pc9   pin2 0|1->0
    +506    pc5   pin2 0->1
    +526    pc7   pin2 1->0|1
    +546    pc9   pin2 0|1->0
    +569    pc5   pin2 0->1
    +589    pc7   pin2 1->0|1
    +609    pc9   pin2 0|1->0
    +632    pc5   pin2 0->1
    +652    pc7   pin2 1->0|1
    +672    pc9   pin2 0|1->0
    +695    pc5   pin2 0->1
    +715    pc7   pin2 1->0|1
    +735    pc9   pin2 0|1->0
    +758    pc5   pin2 0->1
    +778    pc7   pin2 1->0|1
    +798    pc9   pin2 0|1->0
    +821    pc5   pin2 0->1
    +841    pc7   pin2 1->0|1
    +861    pc9   pin2 0|1->0
    +884    pc5   pin2 0->1
    +904    pc7   pin2 1->0|1
    +924    pc9   pin2 0|1->0
    +947    pc5   pin2 0->1
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

### Checks

- **PASS** `identity`: bytecode sha256 matches, source sha256 matches
- **PASS** `assembler-timing-table`: 22 per-instruction entries (minimum_cycles, blocking) agree with the ISA cost model
- **PASS** `exact-analysis`: 3 boundary contexts, 5 path variants, no widening or budget cut
- **PASS** `no-self-deadlock`: no WAITPIN waits for a level the engine itself forces
- **PASS** `reachable-faults`: only explicit FAULT codes [] reachable
- **INFO** `holding-points`: unbounded FIFO waits hold: pc3 PULL [pin2=0]
- **PASS** `ws2812-bit-schedule`: every pixel: 24 bits, MSB first (OUT c=1); high 15 clocks then the bit (OUT), low at 32; next bit 63 clocks after the previous one, also across the pixel boundary when the next TX word is queued: T0H [15], T1H [32], T0L [48], T1L [31], bit period [63] (declared T0H 15, T1H 32, T0L 48, T1L 31, period 63); rises/OUTs/falls per pixel [(24, 24, 24)]
- **PASS** `ws2812-datasheet-bits`: WS2812B-V5 datasheet V1.0 at 50 MHz: T0H 15 clocks = 300 ns (220 ns..380 ns; 80 ns above the minimum, 80 ns below the maximum); T1H 32 clocks = 640 ns (580 ns..1000 ns; 60 ns above the minimum, 360 ns below the maximum); T0L 48 clocks = 960 ns (580 ns..1000 ns; 380 ns above the minimum, 40 ns below the maximum); T1L 31 clocks = 620 ns (580 ns..1000 ns; 40 ns above the minimum, 380 ns below the maximum). all hold for clocks from 48.00 to 53.45 MHz
- **PASS** `ws2812-reset`: WS2812B-V5 datasheet V1.0 at 50 MHz: reset after START 15004 clocks = 300.08 us (>= 280.00 us; 20.08 us above the minimum); reset after a latch word 15033 clocks = 300.66 us (>= 280.00 us; 20.66 us above the minimum). all hold for clocks from 0.00 to 53.59 MHz. low times ending a frame [15004, 15033, 15050] clocks (declared 15004 after START, 15033 after a latch word); DOUT is low at the PULL holding point, so a TX FIFO underrun also latches once the stall exceeds 13968 clocks
- **PASS** `ws2812-underrun`: DOUT is driven low at every PULL holding point. A PULL stall of s clocks between pixels lengthens the last bit's low time by s: T0L stays within WS2812B-V5 datasheet V1.0 for s <= 2, T1L for s <= 19; one TX word is consumed every 1512 clocks (30.240 us at 50 MHz)

### Boundaries

| boundary (context) | stall min..max | segment BCET..WCET | holding pads |
|---|---|---|---|
| START | 0..0 | 15004..15004 | pin2=Z |
| pc3 PULL | 0..inf | 1512..16514 | pin2=0 |
| pc3 PULL | 0..inf | 1512..16514 | pin2=0 |

### Pin spacing

- pin2: exact spacings {15: 96, 17: 96, 31: 92}; across boundaries [('15004', 'inf'), ('15033', 'inf'), ('31', 'inf')]; minimum 15

### Loop periods

- pc3 `PULL` via JZ@pc19, JMP@pc21: 1512..inf (x5)
- pc5 `SET 0x04` via LOOP@pc11: 63 (x88), 126..inf (x2), 15128..inf (x2)

### Edge schedules

```
  from START v0:
    +2      pc1   pin2 Z->0
    +15004  pc3   arrive PULL
  from pc3 PULL v0 (+1 identical contexts):
    +2      pc5   pin2 0->1
    +17     pc7   pin2 1->0|1
    +34     pc9   pin2 0|1->0
    +65     pc5   pin2 0->1
    +80     pc7   pin2 1->0|1
    +97     pc9   pin2 0|1->0
    +128    pc5   pin2 0->1
    +143    pc7   pin2 1->0|1
    +160    pc9   pin2 0|1->0
    +191    pc5   pin2 0->1
    +206    pc7   pin2 1->0|1
    +223    pc9   pin2 0|1->0
    +254    pc5   pin2 0->1
    +269    pc7   pin2 1->0|1
    +286    pc9   pin2 0|1->0
    +317    pc5   pin2 0->1
    +332    pc7   pin2 1->0|1
    +349    pc9   pin2 0|1->0
    +380    pc5   pin2 0->1
    +395    pc7   pin2 1->0|1
    +412    pc9   pin2 0|1->0
    +443    pc5   pin2 0->1
    +458    pc7   pin2 1->0|1
    +475    pc9   pin2 0|1->0
    +506    pc5   pin2 0->1
    +521    pc7   pin2 1->0|1
    +538    pc9   pin2 0|1->0
    +569    pc5   pin2 0->1
    +584    pc7   pin2 1->0|1
    +601    pc9   pin2 0|1->0
    +632    pc5   pin2 0->1
    +647    pc7   pin2 1->0|1
    +664    pc9   pin2 0|1->0
    +695    pc5   pin2 0->1
    +710    pc7   pin2 1->0|1
    +727    pc9   pin2 0|1->0
    +758    pc5   pin2 0->1
    +773    pc7   pin2 1->0|1
    +790    pc9   pin2 0|1->0
    +821    pc5   pin2 0->1
    +836    pc7   pin2 1->0|1
    +853    pc9   pin2 0|1->0
    +884    pc5   pin2 0->1
    +899    pc7   pin2 1->0|1
    +916    pc9   pin2 0|1->0
    +947    pc5   pin2 0->1
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
    +1325   pc5   pin2 0->1
    +1340   pc7   pin2 1->0|1
    +1357   pc9   pin2 0|1->0
    +1388   pc5   pin2 0->1
    +1403   pc7   pin2 1->0|1
    +1420   pc9   pin2 0|1->0
    +1451   pc12  pin2 0->1
    +1466   pc14  pin2 1->0|1
    +1483   pc16  pin2 0|1->0
    +1512   pc3   arrive PULL
```
