TeslaCoilerOW/ttihp-protocol-emulator/docs/host.md

# Host library (`host/pe_host`)

`pe_host` drives the chip's nibble host port exactly as [isa.md](isa.md)
("Host interface") specifies. One API, `ProtocolEmulator`, runs unchanged on:

| Backend | Where | Module |
|---|---|---|
| Tiny Tapeout demo board | MicroPython on the board's RP2350 (or RP2040), through the Tiny Tapeout SDK (`ttboard`) | `pe_host.ports.ttboard.DemoBoardPort` |
| Raspberry Pi Pico or Pico 2 wired to an FPGA running the design | MicroPython, raw `machine.Pin` / SIO registers | `pe_host.ports.pico.PicoPort` |
| Reference model | CPython: `test/model/reference.py`, one clock per call | `pe_host.ports.model.ModelPort` |
| RTL or gate-level netlist in cocotb | CPython: cocotb bridge thread, lockstep with the model | `pe_host.ports.cocotb_port.CocotbPort` |
| Recorded trace | any interpreter: differential replay | `pe_host.ports.replay.ReplayPort` |
| Demo board v3 or a Pico, with the project clock free-running on a PIO state machine | MicroPython, `rp2` PIO ([Lockstep PIO port](#lockstep-pio-port-free-running-clock)) | `pe_host.ports.pio_lockstep.LockstepPort` |

The same scripts run everywhere. `host/examples/selftest_demo.py` exercises
every host command through the host port alone. `host/examples/flagship_demo.py`
runs [`firmware/flagship-scenario.json`](../firmware/flagship-scenario.json):
UART TX, UART RX, SPI and I2C on four engines at once, plus the autonomous
UART-RX to SPI-TX route.

**Status.** No hardware exists yet. Nothing here has run on a demo board, a
Pico or an FPGA. The demo-board and Pico backends ran unmodified against
register- and GPIO-level fakes of the SDK and of `machine`, with the reference
model behind the pins. The library also ran under the MicroPython 1.29 unix
port. Both are listed under [Verification](#verification-of-the-library).

## Contents

1. [Quick start](#quick-start)
2. [Wiring](#wiring)
3. [How one host clock works](#how-one-host-clock-works)
4. [API reference](#api-reference)
5. [Running the same scripts on silicon](#running-the-same-scripts-on-silicon)
6. [Lockstep PIO port (free-running clock)](#lockstep-pio-port-free-running-clock)
7. [Verification of the library](#verification-of-the-library)
8. [Sources](#sources)

## Quick start

CPython, reference model (from the repository root):

```sh
python3 host/examples/selftest_demo.py      # 73 checks, every host command
python3 host/examples/flagship_demo.py      # the flagship scenario with software peers
make -C host test                           # the library's unit tests
```

```python
import sys; sys.path.insert(0, "host")
from pe_host import ProtocolEmulator, FirmwareImage
from pe_host.ports.model import ModelPort

pe = ProtocolEmulator(ModelPort())
pe.reset()
pe.check_isa()                                    # READ_SELECT 7 == 2
pe.load_image(FirmwareImage.load("firmware/uart-tx.image.json"))
pe.tx_write([0x48, 0x69], engine=0)               # prefill engine 0's TX FIFO
pe.start(0b0001)
pe.run(2000)                                      # 2000 host clocks, raises on FAULT
print(pe.status(0), pe.levels(0))
```

On the demo board or a Pico, only the port changes. `pe_host.connect()` picks
`DemoBoardPort` when the `ttboard` SDK is importable, `PicoPort` on other
MicroPython boards, and `ModelPort` under CPython.

```python
import pe_host
pe = pe_host.connect()          # or connect("pico"), connect("model")
```

## Wiring

### Tiny Tapeout demo board

The chip sits on a carrier plugged into the demo board. The RP2 reaches every
project pin through the PCB, so the host needs no wiring. The table below
gives the GPIO numbers from the SDK's GPIO maps. The library never uses them
directly; it goes through the SDK.

```
                      Tiny Tapeout demo board
  +------------------------------+          +-----------------------------------+
  | RP2350B (TT ETR, DB v3)      |          | chip: tt_um_teslacoilerow_        |
  |                              |          |       protocol_emulator (8x4)     |
  | GPIO17..24 ---- ui_in[0..7] -+--------->| ui[3:0] nibble, ui4 WVALID,       |
  |                              |          | ui5 RREADY, ui[7:6] window        |
  | GPIO33..40 <--- uo_out[0..7]-+----------| uo[3:0] nibble, uo4 WREADY,       |
  |                              |          | uo5 RVALID, uo6 IRQ, uo7 FAULT    |
  | GPIO16 -------- clk ---------+--------->| clk (every edge from the RP2)     |
  | GPIO14 -------- rst_n -------+--------->| rst_n                             |
  | GPIO25..32 <--> uio[0..7] ---+<-------->| uio[7:0] protocol pins            |
  +------------------------------+    |     +-----------------------------------+
                                      |
                              uio PMOD header: UART / SPI / I2C peripherals
                              (not needed with software peers)
```

| Signal | DB v3 (RP2350B, SDK v3, `gpio_map_dbv3.py`) | TT04 to TT06 boards (RP2040, `util/platform/rp2040.py`) |
|---|---|---|
| ui_in[7:0] | GPIO 17..24 | GPIO 9..12 (bits 3:0), 17..20 (bits 7:4) |
| uo_out[7:0] | GPIO 33..40 | GPIO 5..8 (bits 3:0), 13..16 (bits 7:4) |
| uio[7:0] | GPIO 25..32 | GPIO 21..28 |
| project clock | GPIO 16 | GPIO 0 |
| rst_n | GPIO 14 | via the SDK's `reset_project()` |

Rules:

- Set all `ui_in` DIP switches to off. In `ASIC_RP_CONTROL` mode the SDK
  refuses to drive any ui_in pin that reads high, to avoid a fight with the
  switch (`pins.py`, `begin_asiconboard`).
- Software peers (the flagship demo with nothing attached): the RP2 drives
  uio1 (UART into the chip) and uio4 (MISO) push-pull. It pulls uio6/uio7
  (SCL/SDA) low or releases them. `pullups=0xC0` enables the RP2's internal
  pull-ups on SCL/SDA. Leave the uio PMOD header empty in this mode.
- Real peripherals on the PMOD header (`peers="external"`): as in
  [info.md](info.md), "External hardware". Connect a UART adapter (chip TX on
  uio0, chip RX on uio1), an SPI target (SCK 2, MOSI 3, MISO 4, CS_N 5) and
  an I2C target at 0x42 (SCL 6, SDA 7) with pull-ups, for example 4.7 kOhm, to
  the chip's I/O supply. The RP2 leaves uio as inputs (`uio_oe_pico = 0`), so
  it can still read the pads.

### Raspberry Pi Pico wired to an FPGA

`PicoPort`'s default map (`PIN_MAP`) uses all 26 GPIOs that the Pico and
Pico 2 expose. It is meant for an FPGA top that brings uio out to the Pico, so
the Pico can also act as the software peers (UART, SPI, I2C). The FPGA
host-clock builds that task 4.1 produces use other wirings, and two presets
match them (see [FPGA host-clock builds](#fpga-host-clock-builds)).
For any other wiring, pass `PicoPort(pin_map={...})`.

```
   Raspberry Pi Pico / Pico 2                     FPGA board running the design
  +----------------------------+                +------------------------------------+
  | GP0..GP7   (out) ----------+-- ui_in[0..7] -->| ui_in[7:0]                        |
  | GP8..GP15  (in)  <---------+-- uo_out[0..7] --| uo_out[7:0]                       |
  | GP16       (out) ----------+-- clk ---------->| clk   (clock-capable input pin)   |
  | GP17       (out) ----------+-- rst_n -------->| rst_n                             |
  | GP18..GP22 (in*) <---------+-- uio[0..4] ---->| uio[4:0]  tri-state pads          |
  | GP26..GP28 (in*) <---------+-- uio[5..7] ---->| uio[7:5]  tri-state pads          |
  | GND -----------------------+-- GND ---------->| GND                               |
  +----------------------------+                | ena tied high inside the top      |
     * outputs only while software peers        +------------------------------------+
       drive a pin
```

| Pico GPIO | Direction (Pico) | Design port |
|---|---|---|
| GP0..GP7 | output | ui_in[0..7] |
| GP8..GP15 | input | uo_out[0..7] |
| GP16 | output | clk |
| GP17 | output | rst_n (active low) |
| GP18, GP19, GP20, GP21, GP22 | input (output for software peers) | uio[0..4] |
| GP26, GP27, GP28 | input (output for software peers) | uio[5..7] |

For the default map, the FPGA top must:

- instantiate `tt_um_teslacoilerow_protocol_emulator` with `ena = 1`, or
  drive `ena` from a Pico GPIO named `"ena"` in the pin map;
- implement each uio pin as a tri-state pad, with
  `pad = uio_oe[i] ? uio_out[i] : 'z` and `uio_in[i] = pad`, so the chip reads
  its own driven level, as on silicon;
- take `clk` from GP16 on a clock-capable pin, with no PLL (the host supplies
  single edges; a PLL would not lock at kHz manual rates);
- use 3.3 V LVCMOS I/O banks for every signal above.

The IHP SRAM macros need an FPGA memory substitute (task 4.1). The template's
iCE40UP5K target is too small ([.github/workflows/fpga.yaml](../.github/workflows/fpga.yaml)).

#### FPGA host-clock builds

[fpga.md](fpga.md) ("Pin host (Pico) and the host clock option") documents
the Pico wiring of the Cmod A7 and Urbana `host` builds. That document is
task 4.1's work and was not yet committed when these presets were written, so
check the presets against it when it lands. These builds do not
bring uio to the Pico. `pe_host.ports.pico` provides pin maps for both builds:

| Preset | ui_in | uo_out | clk | reset | ena | uio |
|---|---|---|---|---|---|---|
| `PIN_MAP` (default) | GP0..7 | GP8..15 | GP16 | GP17 `rst_n` (active low) | tied high on the FPGA | GP18..22, GP26..28 |
| `PIN_MAP_CMOD_A7_HOST` | GP0..7 (DIP 1..8) | GP8..15 (DIP 9..14, 17, 18) | GP16 (DIP 46) | GP17 `rst_n` (DIP 47) | GP18 (DIP 48); `deselect()` pulses it low | not wired |
| `PIN_MAP_URBANA_HOST` | GP0..7 (PMOD B) | GP8..13 = uo_out[0..5] only | GP16 (JAB_1) | GP17 `rst` (SERVO0, active high) | sw[0] | not wired |

```python
from pe_host import ProtocolEmulator
from pe_host.ports.pico import PicoPort, PIN_MAP_CMOD_A7_HOST
pe = ProtocolEmulator(PicoPort(pin_map=PIN_MAP_CMOD_A7_HOST))
```

A pin map is a dict with these keys:

- `"ui_in"`: 8 GPIOs.
- `"uo_out"`: 6 to 8 GPIOs for uo_out[0..n-1]. The bits that are not wired
  read 0, and `port.uo_visible` lists the wired bits.
- `"clk"`: the clock GPIO.
- `"rst_n"` (active low) or `"rst"` (active high): exactly one of the two.
- `"ena"`: optional.
- `"uio"`: 0 to 8 GPIOs. The software peers need all eight.

What each build supports:

| Feature | Default map | Cmod A7 host build | Urbana host build |
|---|---|---|---|
| Every command, program load, TX/RX, READ_SELECT | yes | yes | yes |
| Command acceptance (`command()` returns True or False) | yes | yes | SELECT and READ_SELECT only; the others return None, because uo[7] is not wired |
| `wait_irq()` | yes | yes | raises HostError, because uo[6] is not wired; poll `levels()` instead |
| `fault_report()` | engine faults, and the host fault inferred from uo[7] | same | engine faults only; `host_fault` is None |
| Self-test (`selftest.run`) | all sections | all except `trigger`, which needs uio0 | no: it checks uo[7] |
| Software peers and the flagship demo | yes | no | no |
| Flagship demo with `peers="external"` | yes | yes | yes, but the sticky host fault cannot be checked (`result.notes` says so) |

`host/tests/test_host_ports.py` runs both presets against GPIO-level fakes
with the reference model behind the pins. On the Cmod A7 map, the self-test
minus `trigger`, followed by a `deselect()`, produces the same edges (ui_in,
uio, reset and ena) as the model backend. The Urbana map runs a program load,
TX and RX traffic and rejected commands, all with the active-high reset.

The FPGA workstream also ships its own Pico host, `fpga/host/pico_host.py`,
and a PC-side UART-bridge host, `fpga/host/pe_host.py`, with the client of
the bitstreams' on-board capture unit (`fpga/host/pe_scope.py`) and the
bring-up driver (`fpga/host/bringup.py`) next to it ([fpga.md](fpga.md),
"On-board capture unit" and "First hour with a board"). They are separate
tools: `pico_host.PicoPort` has a different constructor (`ui=`, `uo=`, `rst=`,
`rst_active_high=`, `ena=`) and a `step()` interface. The module name
`fpga/host/pe_host.py` is the same as this library's package `pe_host`, so do
not put `fpga/host/` and `host/` on the same `sys.path`. Renaming one of them
is left to the release reconciliation of tasks 4.1 and 4.2.

#### Fast GPIO path

`fast=True` (the default) uses `machine.mem32` on the SIO block for pin values:
GPIO_IN at 0xD0000004 and GPIO_OUT at 0xD0000010. The offsets are the same on
RP2040 and RP2350, and the SDK uses them in `util/platform/rp2040.py` and
`rp2350.py`. The fast path needs the ui_in and uo_out GPIOs to be contiguous
runs, and `os.uname().machine` must name an RP2040 or RP2350. Otherwise, or
with `fast=False`, the port uses only `machine.Pin` calls. Pin directions always
change through `machine.Pin`.

## How one host clock works

The host port is synchronous and `ui_in` is not synchronized ([isa.md](isa.md)),
so the host supplies every clock edge. A backend implements one primitive,
`port.cycle(ui)`:

1. With software peers attached: read the uio pad levels left by the previous
   edge, let the peers choose their drive, and apply it. A peer may never drive
   a pin that the chip owns push-pull; see [Safety interlock](#safety-interlock).
2. Drive `ui_in = ui`.
3. Sample `uo_out` before the edge. This sample shows the window-change bubble
   and the current ready/valid bits.
4. Apply one rising edge, then return the clock low.

The library's handshakes are cycle-identical to the cocotb harness's host
driver (`test/harness.py`, checked cycle for cycle):

- A window change costs one bubble cycle with valid and ready low.
- A word is eight little-endian nibbles. Write-valid is held on each nibble
  until write-ready was sampled high. One idle cycle follows the word, and its
  uo sample shows the FAULT state after the word.
- Read-ready is held until read-valid was sampled high, nibble by nibble.
- A READ_SELECT read is: the command, one cycle in window 1 (this drops a stale
  snapshot), then a window-0 read. The word is captured one cycle after the
  bubble, and read-valid rises one cycle later.

Example (the [info.md](info.md) timing sketch): writing one TX word and
then reading status takes a 1-cycle bubble, 8 nibble cycles, 1 idle cycle,
a 1-cycle bubble, 1 capture cycle and 8 read cycles.

## API reference

All cycle counts are host clocks. `timeout` arguments bound one blocked nibble
handshake; the default is `ProtocolEmulator.timeout`, 100000.

### `ProtocolEmulator(port, timeout=100000, architecture=None, isa_versions=(2,), strict=True, log=None)`

- `architecture`: the device architecture that images must be bound to. The
  default is `protocol.DESIGN_ARCHITECTURE`, the design of record
  `configs/instruction-sram-32.json`: 4 engines, 32-bit, 64 words, FIFO 8,
  fused, no prefetch.
- `isa_versions`: the READ_SELECT 7 values that `check_isa()` and
  `load_image()` accept.
- `strict`: raise `CommandRejected` when uo[7] rises across a command word.
- `log`: an optional print-like callable that logs every command and its
  outcome.

Attributes: `uo` (the last uo sample), `irq`, `fault_pin`, `fault_visible`
(False when the port does not see uo[7]), `cycles`, `window`, `selected`,
`read_selected`, `device_isa`, `last_command_ok`.

**Clock, reset and windows**

| Method | Effect |
|---|---|
| `cycle(ui=None)` | One clock; the default ui is the current window with no valid or ready. Returns uo. |
| `idle(n=1)` | n idle clocks in the current window. |
| `reset(cycles=4)` | Holds reset asserted (rst_n low) for `cycles` edges. Invalidates images, queues and selection. Always call it first. |
| `deselect(cycles=2)` | Holds ena low. Same effect as reset. Works on the model and cocotb backends, and on a `PicoPort` whose pin map has an `"ena"` GPIO. |
| `set_window(w)`, `bounce()` | Changes the window (one bubble). `bounce()` leaves the window for one cycle, which abandons any partial transfer. |

**Words**

| Method | Effect |
|---|---|
| `write_word(window, word, timeout=None)` | Windows 0, 1 and 2. On timeout, abandons the partial word (bounce) and raises `HostTimeout`. |
| `read_word(window=0, timeout=None, pauses=None)` | Windows 0 (status) and 3 (RX FIFO; pops at the 8th nibble). `pauses[i]` idle cycles before nibble i. |
| `try_write_word(window, word, max_wait, nibbles=8)` | Gives up after `max_wait` stalled cycles, or after `nibbles` < 8 on purpose. Returns True only for a complete word. |
| `try_read_word(window, max_wait, nibbles=8, pauses=None)` | Returns None when abandoned. An abandoned RX read does not pop the word. |

**Commands.** Every command method writes one window-0 word and returns
`True` (FAULT low after the word), `False` (FAULT rose: the chip rejected the
word and set its sticky host fault) or `None` (FAULT was already high, so
acceptance cannot be inferred). With `strict`, `False` raises
`CommandRejected`. The chip does not report which word was rejected. An
engine that faults on the same cycles cannot be told apart, so call
`fault_report()`.

SELECT and READ_SELECT are the exception. Whether the chip accepts them
depends only on the payload: SELECT needs an engine below `engine_count`, and
READ_SELECT an index from 0 to 7 ([isa.md](isa.md); `test/model/reference.py`).
For these two commands `command()` returns that answer, True or False, even
when FAULT is already high, when an engine faults during the word, or when
the port cannot see uo[7]. `selected` and `read_selected` change only when
the command is accepted, so the library's record always matches the chip.
Earlier versions returned None under a high FAULT pin and still recorded the
payload, so a raw `command(SELECT, 7)` could leave `selected` at 7 and make
`fault_report()` raise. `test_selection_tracking_under_fault` covers this
case. On a port without uo[7], every other command returns None.

| Method | Command (isa.md) |
|---|---|
| `command(op, payload=0, check=None)` | Any raw command. |
| `select(engine)` / `use(engine)` | SELECT. `use` sends it only when the engine is not already selected. |
| `begin(engine=None)` | BEGIN. |
| `commit(length)` | COMMIT. |
| `own(pins, open_drain=0, engine=None)` | OWN. |
| `start(mask)` / `stop(mask=None)` | START / STOP (default: all engines). |
| `route(source, destination, count, enable=True)` / `unroute(source)` | ROUTE. |
| `clear(mask=0, host_fault=False)` | CLEAR. `host_fault` sets payload bit 23. |
| `event(mask)` | EVENT. |
| `flush(engine=None)` | FLUSH. |
| `trigger(pin, mode, enable=True, engine=None)` / `disable_trigger(engine=None)` | TRIGGER. Modes are `protocol.TRIG_RISING`, `TRIG_FALLING`, `TRIG_HIGH` and `TRIG_LOW`. |

**Status reads.** Each read is READ_SELECT, a bounce and a window-0 read.
`engine=None` means the selected engine.

| Method | READ_SELECT |
|---|---|
| `read_status(index)` | Any index, raw word. |
| `status(engine=None)` | 0, decoded into `protocol.Status`: `running`, `committed`, `stalled`, `faulted`, `fault`, `fault_name`. |
| `timestamp()` | 1. |
| `levels(engine=None)` | 2, returned as `(tx_level, rx_level)`. |
| `pc(engine=None)` | 3. |
| `event_pending(engine=None)` | 4. |
| `completed(engine=None)` | 5. |
| `held_rx(engine=None)` | 6, for example the word a strict PUSH rejected. |
| `isa_version()` / `check_isa()` | 7. `check_isa` raises `IsaMismatch` for a version outside `isa_versions`. |

**Loading**

- `load_program(engine, words, owned=0, open_drain=0, verify=False)` sends
  SELECT, BEGIN, OWN, the program words in window 1, then COMMIT.
  `verify=True` reads the status back. [firmware.md](firmware.md) recommends
  a different order: SELECT, BEGIN, the program words, OWN, COMMIT. Both
  orders are legal under [isa.md](isa.md), because OWN only needs a halted
  engine and BEGIN has just halted it. The library uses the order of
  `test/harness.py` `load()`, so its waveforms stay cycle-identical to the
  harness and to the `scenarios.flagship` reference run. For the other order,
  call `select`, `begin`, `write_word(W_PROGRAM, ...)`, `own` and `commit`
  yourself.
- `load_image(image_or_path, engine=None, check_isa=True, verify=False)`
  checks the image's architecture binding. It reads the ISA version (at least
  the image's `isa_version`, and in `isa_versions`; on a version-3 device the
  image must also pass `image.check_isa`, below), then loads the image on
  `image.engine`. For a refused image the library reads READ_SELECT 7 and
  sends no program word.

**Queues**

- `tx_write(word_or_words, engine=None, timeout=None)` blocks under
  backpressure and raises `HostTimeout` when the budget runs out.
- `tx_try_write(word, max_wait=0, engine=None)` returns True or False.
- `rx_read(engine=None, timeout=None)` and `rx_read_many(count, ...)`.
- `rx_try_read(max_wait=4, engine=None)` returns a word, or None when no word
  became valid in time.
- `rx_drain(engine=None)` reads as many words as READ_SELECT 2 reports.

**Faults and waiting**

- `fault_report()` reads every engine's status and restores the selection.
  It returns a `FaultReport` with `statuses`, `faulted`, `fault_pin`, `ok` and
  `host_fault`. `host_fault` is True, False, or None when an engine fault
  masks it or the port cannot see uo[7] (`fault_pin` is then None too).
- `clear_faults(mask=None, host_fault=True)` with no mask clears exactly the
  faulted engines. A mask that includes a running engine would make the whole
  CLEAR reject.
- `raise_on_fault()` raises `EngineFault` carrying the report.
- `protocol.fault_name(code)` names built-in codes 1 to 4 and the example
  firmware's explicit codes 64 to 67.
- `wait_until(predicate, timeout)`, `wait_irq(timeout=None)` (raises
  `HostError` on a port that cannot see uo[6]), `run(cycles, watch_fault=True)`.
- `free_run(cycles, freq_hz=None)`: idle in window 0. With `freq_hz`, hardware
  ports switch to a PWM clock for `cycles / freq_hz` seconds, so the edge
  count is approximate.

### Firmware images: `pe_host.image`

`FirmwareImage.load(path, source=True, architecture=None)` verifies the image
as [firmware.md](firmware.md) specifies:

- the schema version;
- 32-bit words;
- `bytecode_sha256` over the little-endian words;
- `source_sha256` over the exact bytes of the sibling `.source.json` when it
  is present (`source="required"` makes it mandatory, `False` skips it);
- 8-bit pin masks, with open-drain pins inside the owned pins;
- the engine range and program capacity;
- with `architecture`, the binding to that architecture.

`image.check_binding(arch, ignore=())` and `image.check_isa(version)` raise
`ImageError`. `check_isa` requires the version to be at least the image's
`isa_version`. When bits 7..0 of the version are 3, an image of ISA version 1
or 2 must also meet the rule of [isa.md](isa.md), "ISA version": every SHL and
SHR count a byte lane (0, 8, 16 or 24) and every JMP, LOOP and JZ target below
128. Version 3 does not tell which of the ISA-3 knobs a device has, so both
parts apply. `isa3_differences(words)` lists the words that break the rule, as
(PC, reason) pairs. Of the 26 committed images only `ps2-host` breaks it (word
45, SHR by 21), so `load_image` refuses `ps2-host` on a `diet4` (6x4),
`diet2`, `diet8` or `diet8_rec16` device, where that word would fault with
code 1. (`load_image` compares the whole READ_SELECT 7 word with
`isa_versions`, so a `diet8_rec16` device, which reads 0x000F5F03, needs that
value in `isa_versions`; with (2, 3) it refuses every image.) `load_image(..., check_isa=False)` skips the version check.
`load_scenario(path, architecture=None)` loads a
`protocol-emulator.firmware-scenario.v1` file and checks its binding. All of
this uses only `json`, `hashlib.sha256`, `binascii` and `struct`, so it runs
on the board too.

### Software peers: `pe_host.peers`

Each peer sees only pad levels. `step(cycle, pads)` returns
`(enable_mask, value_mask)` for the next edge. `Environment(peers,
pullups=0xFF)` combines peers as a wired-AND. Attach an environment with
`port.env = env`.

| Peer | Behaviour |
|---|---|
| `UartSource(pin, words, bit_cycles, gap_cycles, start=None, bad_stop=())` | 8N1 sender, as `test/peers.py`. |
| `UartMonitor(pin, bit_cycles)` | Streaming 8N1 receiver: `words`, `errors`. |
| `SpiTarget(mode, responses, sck=2, mosi=3, miso=4, cs=5)` | Modes 0 to 3, as `test/peers.py`: `received`, `violations`. |
| `I2CTarget(address=0x42, scl=6, sda=7, read_bytes=(0x5A,), stretch_cycles=0, nack_bytes=())` | Pad-level open-drain target: `received`, `master_acks`, `starts`, `stops`. It changes SDA only after an observed SCL falling edge. `stretch_cycles` holds SCL low after each falling edge. |
| `PadCapture(limit, start)` | Records the observed pads, one byte per cycle. |

### Scenarios

- `pe_host.selftest.run(pe, trigger_pin=0, log=None, sections=None)` runs a
  bring-up self-test in 10 independent sections and 73 checks, using only
  the host port. The "trigger" section drives uio0 for a few cycles; nothing
  else leaves the chip. It returns `SelfTestResult` (`passed`, `summary()`).
- `pe_host.flagship.run_flagship(pe, scenario_path, firmware_dir=None,
  peers="software", i2c_stretch=0, done=None, max_cycles=None,
  free_run_cycles=200000, free_run_hz=None, on_reset=None, log=None)` returns
  `FlagshipResult` (`passed`, `mismatches`, `summary()`). With
  `peers="software"`, the result is checked against the scenario's `expected`
  block: the UART bytes seen on pin 0, the SPI MOSI bytes, the I2C bytes and a
  single STOP, engine 2's RX words, empty route queues and no faults.
  `peers="external"` lets the engines free-run with real peripherals and
  reports what the host reads back. Engine 1 runs `uart-rx-idle`, whose
  start-bit wait has no bound, so an idle UART line does not fault it, and
  with no engine faulted `run_flagship` reads the sticky host fault from
  uo[7] directly. Any engine fault fails the run, with one exception kept for
  a scenario that puts the bounded `uart-rx` image on engine 1: its idle and
  start-bit waits are bounded at twelve bit periods
  ([firmware.md](firmware.md)), so it ends in fault 3 when the line stays
  idle that long, and that fault is accepted. uo[7] is the OR of the sticky
  host fault and every engine fault, so it says nothing about the host fault
  while engine 1 is faulted. In that case `run_flagship` CLEARs engine 1
  after STOP (CLEAR is accepted for a halted engine whatever the host fault)
  and reads the fault state again. `result.fault_report` is the report from
  before any CLEAR, `result.fault_report_after_clear` the one after it (None
  when nothing was cleared), and `result.host_fault` the host fault read
  from uo[7] with no engine faulted. A host fault fails the run. On a port
  without uo[7] (the Urbana build)
  the host fault cannot be read. The run then passes on the engine faults
  alone, and `result.notes` records that the host fault was not checked.

### Ports

`Port` is the contract that every port implements: `cycle(ui)`,
`reset(cycles)`, `deselect(cycles)`, `free_run(cycles, freq_hz)`, `count`,
`env`, `forbidden`, and `uo_visible`, the mask of uo_out bits the port can
see. It is 0xFF except on a partly wired `PicoPort`.

| Port | Constructor |
|---|---|
| `ModelPort` | `(architecture=None, model=None, env=None, pins=None, pullups=0xFF, record=False, record_replay=False)`. `pins` is a harness-style supplier: an int or `(cycle, Outputs) -> pads`. `record` enables `wire_samples()`, which returns the scoreboards' `WireSample`s, and `render_testbench()`, which returns a self-checking Verilog testbench. |
| `CocotbPort` | `(dut, env=None, pins=None, pullups=0xFF, lockstep=True, ...)`. Use it from `await run_in_bridge(func)`. |
| `DemoBoardPort` | `(tt=None, project="tt_um_teslacoilerow_protocol_emulator", enable=True, fast=True, env=None, pullups=0)`. `release()` returns the board to the SDK. |
| `PicoPort` | `(pin_map=None, fast=True, env=None, pullups=0, chip=None)`. `pin_map` is `PIN_MAP` (the default), `PIN_MAP_CMOD_A7_HOST`, `PIN_MAP_URBANA_HOST` or your own dict; see [FPGA host-clock builds](#fpga-host-clock-builds). |
| `ReplayPort` | `(data, env=None)`. |

Errors are `HostError` and its subclasses: `HostTimeout`, `CommandRejected`,
`ImageError`, `IsaMismatch`, `EngineFault`, `PadContention` and
`ReplayDivergence`. `HostTimeout` does not derive from `TimeoutError`, which
MicroPython lacks.

### Safety interlock

Every OWN the library sends adds the pins it owns without open drain to
`port.forbidden`. A reset clears the set. The ports never let software peers
drive a forbidden pin:

- The model and cocotb ports raise `PadContention`. They also raise it on
  any simulated driver fight.
- On hardware, the port masks the drive (`strict_env = False`) or raises
  (the default).

A miswired peer is therefore caught before the RP2 and the chip drive the
same pad against each other. A test in
`host/tests/test_host_flagship.py` checks this.

## Running the same scripts on silicon

1. **Flash the SDK.** Install the Tiny Tapeout demo-board firmware: a UF2
   with MicroPython and the frozen `ttboard` SDK. The v3 releases (v3.1.1 is
   the latest) ship an RP2350 UF2 only. RP2040 boards run earlier releases
   (see the SDK README's compatibility matrix). Those releases were not
   reviewed here.
2. **Copy the library and firmware.** Precompiling saves RAM:

   ```sh
   make -C host mpy MPY_ARCH=armv7emsp      # RP2350; armv6m for RP2040
   mpremote cp -r host/build/mpy/pe_host :   # or: mpremote cp -r host/pe_host :
   mpremote mkdir :firmware
   mpremote cp firmware/flagship-scenario.json firmware/uart-tx.image.json \
       firmware/uart-rx-idle.image.json firmware/uart-rx-idle.source.json \
       firmware/spi-controller-mode0.image.json \
       firmware/i2c-write.image.json :firmware/
   ```

   The `.mpy` version must match the board's MicroPython. Check it with
   `import sys; sys.implementation._mpy`. If you are unsure, copy the `.py`
   sources. Engine 1 of the scenario is `uart-rx-idle`, so its image must
   be on the board. Copying the `.source.json` files as well (the list above
   copies the one for `uart-rx-idle`) lets `FirmwareImage` also verify
   `source_sha256`. Without them it verifies the bytecode only and reports
   `source_verified=False`.
3. **Run the bring-up self-test with nothing attached.** Put all DIP switches
   off, then run `mpremote run host/examples/selftest_demo.py`. It selects the
   project through `tt.shuttle`, takes the clock (`clock_project_stop`, then
   RP2-driven), disables the v3.3 manual-clock button timer, resets the chip
   and runs the 73 checks.
4. **Run the flagship scenario with software peers.** Keep the PMOD header
   empty and run `mpremote run host/examples/flagship_demo.py`. The RP2 plays
   the UART sender and receiver, the SPI target and the I2C target on its own
   uio GPIOs, with internal pull-ups on SCL/SDA. The script prints the same
   `FlagshipResult` summary as the model run.
5. **Use real peripherals** with `flagship_demo.main(peers="external",
   free_run_hz=F)`. The host loads the images, prefills, routes and starts
   under manual clocking. It then PWM-clocks the chip
   (`tt.clock_project_PWM`), stops, and drains engine 2's RX. The example
   firmware counts time in system clocks, so the peripheral rates scale with
   `F`. The `uart-tx` and `uart-rx-idle` images use 64 clocks per bit, so
   F = 7.3728 MHz gives 115200 baud (7372800 / 64 = 115200), and F = 64 times
   the baud rate gives any other rate. `uart-tx` can also be reassembled with
   `--half-period` ([firmware.md](firmware.md)); `uart-rx-idle` is written
   for 64 clocks per bit and is not a built-in, so that option does not apply
   to it. Engine 1 runs `uart-rx-idle`, which waits for each start bit in a
   polling loop with no bound, so it does not fault while the line is idle and
   receives characters whenever they arrive after START, including characters
   typed by hand. The route forwards the first 8 to the SPI engine; later ones
   wait in engine 1's RX queue, and when that queue is full the next one halts
   engine 1 with fault 4. `flagship_demo.main` free-runs for the default
   200,000 cycles (about 27 ms at 7.3728 MHz). To type by hand, call
   `run_flagship` with a larger `free_run_cycles`, for example 73,728,000
   (10 s at 7.3728 MHz). This has not been tried on hardware. The bounded
   `uart-rx` image, which faults with code 3 after twelve idle bit periods,
   is still in `firmware/` for runs that must detect a stuck line.
6. **Capture the pads.** Attach a logic analyzer to uio[7:0], or record from
   the RP2 with `peers.PadCapture` during a software-peer run.

Performance on the RP2 has not been measured. Each host clock is a few Python
calls, so manual clocking runs far below 50 MHz. That is harmless for
correctness, because every protocol in the example firmware counts system
clocks.

Memory: the precompiled package was 39,133 bytes of `.mpy` for either
architecture before the ISA-3 check (39,613 since; see below). The smallest MicroPython heap that ran the replayed flagship
scenario was 190 KiB. The self-test needed 129 KiB (the bisection varies by a
few KiB between runs: 123 to 129 KiB in this round). Both figures come from
the 64-bit unix port (`tools/upy_heap.py`, job 23778831), include the replay
trace (47 KB and 20 KB), and do not include the `ttboard` SDK's own heap use. They are
estimates for a 32-bit board, not measurements on one. The RP2350's 520 KB of
SRAM leaves room. On an RP2040 (264 KB), the flagship scenario with software
peers may be tight next to the SDK. The ISA-version-3 check of
`pe_host.image` adds 480 bytes: 39,613 bytes of `.mpy` for either
architecture (job 24391202), against 39,133 on `dced528`. Job 24391460
bisected the heap again on `dced528` and with the check: the flagship
scenario (7,842 cycles with `uart-rx-idle`) needed 194 KiB in both, the
self-test 128 and 125 KiB. `make mpy` also builds the lockstep PIO driver
(`pe_host/ports/pio_lockstep.py`) since it joined `tools/upy_check.py`'s
module list: 9,345 bytes, 48,958 bytes in all for either architecture (job
24415035). The host-clocked ports do not import it, so copying it is
optional.

SHA-256: `image.py` uses `hashlib.sha256` when the firmware provides it,
otherwise a pure-Python SHA-256. The fallback was checked against `hashlib`
under CPython and under the MicroPython unix port.

## Lockstep PIO port (free-running clock)

The other ports stop the project clock whenever the host talks to the chip,
because the host port is synchronous and `ui_in` is not synchronised
([isa.md](isa.md)). With them the engines run at a steady rate only while the
host is silent (`free_run`), so queues cannot be serviced while the chip runs
(risk R1 in [extension-study.md](extension-study.md)).
In simulation, `pe_host.ports.pio_lockstep` removes that limit without
changing the RTL. One RP2040/RP2350 PIO state machine generates the project
clock on its side-set pin and carries the host's nibble transfers on the
same clock. The clock does
not pause for host transactions; between them the program keeps clocking with
write-valid and read-ready low, which the protocol treats as idle cycles in the
current window.

**Status.** Nothing here has run on hardware. The program, the driver and the
library ran on a cycle-accurate model of the PIO against the reference model,
the RTL and the FPGA host-clock builds in simulation (see
[Lockstep verification](#lockstep-verification) below).

What it enables:

- The engines run at a steady rate outside reset/deselect halts and watchdog
  restarts, and the host reads status, drains RX queues and tops up TX
  queues while they run. Two simulated scenarios need this. One streams
  32 bytes through the 8-word TX queue of a running UART transmitter. The
  other bridges 24 UART bytes from engine 1 to engine 0 through the host
  with no ROUTE. Without host service, `uart-rx-idle` faults with code 4
  once its 8-word RX queue is full (a control run with 12 bytes).
- Every `ProtocolEmulator` call runs (see [Limits](#limits)).
  `ProtocolEmulator` code runs unchanged: `LockstepPort.cycle(ui)` presents
  `ui` for exactly one clock and returns `uo` sampled before that clock's
  rising edge.
- `port.count` stays exact: the number of rising edges up to the last sampled
  one, from counters the program returns with each result.

### Frame and operations

Every path through the program runs the same 6-cycle frame per project clock
(slots 3, 4 and 5 with the clock low, slot 0 raising it, slots 1 and 2 high):

```
slot    3          4    5    0 (rising edge)   1    2
clk     0          0    0    1                 1    1
ui_in   changes    -    -    -                 -    -
uo_out  -          -    -    -                 -    read (level at the rising edge)
```

`ui_in` changes only at slot 3, half a period from both rising edges. The
slot-2 instruction reads `uo_out` through the RP2's two-flop input
synchroniser, whose first flop sampled the pads at the system-clock edge that
raises `clk`. The value is therefore the one from before the edge, since the
chip cannot react to the edge before its signal has made the round trip.

The host sends one 32-bit TX FIFO word per operation. Bits 4:0 are the handler
address (`out pc, 5`) and bits 12:5 the `ui` byte:

| Operation | What the program does | Result (RX FIFO) |
|---|---|---|
| CYC | presents `ui` for one frame | `uo` (bits 31:24) and 24 bits of the frame counter Y |
| WR | presents `ui` (write-valid set) and holds it, one frame per stall, until write-ready was read high | none |
| RD | presents `ui` (read-ready set), waits until read-valid was read high, then takes the eight nibbles in eight frames | the 32-bit word |
| RDB | one frame with a new window (the bubble; its sample is not used), then RD | the 32-bit word |
| HALT | stops the clock low until the next TX word, then acts as CYC | as CYC |

Each operation starts with one fetch frame that drives write-valid and
read-ready low and keeps the window bits. While the TX FIFO is empty, fetch
frames repeat. Idle frames and stall frames decrement Y, so the host
reconstructs the exact edge count from the fixed frame count of each
operation. The program fills the 32-word instruction memory and is therefore
always loaded at offset 0; `out pc` needs absolute addresses. Listing
(`python3 -m pio.pathcheck` in `host/`):

```
 0  1009  slot 0     rv_low     jmp 9 side 1
 1  5024  slot 0     rv_high    in x, 4 side 1
 2  b042  slot 1     hr_n1      mov y, y side 1
 3  5004  slot 2                in pins, 4 side 1
 4  6264  slot 3                out null, 4 side 0 [2]
 5  10e2  slot 0                jmp !osre, 2 side 1
 6  1118  slot 1                jmp 24 side 1 [1]
 7  6208  slot 3     rdb        out pins, 8 side 0 [2]
 8  121f  slot 0                jmp 31 side 1 [2]
 9  108a  slot 1     hr_stall   jmp y--, 10 side 1
10  b0e0  slot 2     hr_smp     mov osr, pins side 1
11  6024  slot 3                out x, 4 side 0
12  6061  slot 4                out null, 1 side 0
13  60a1  slot 5                out pc, 1 side 0
14  6208  slot 3     wr         out pins, 8 side 0 [2]
15  b142  slot 0     hw_e       mov y, y side 1 [1]
16  10d8  slot 2                jmp pin, 24 side 1
17  0092  slot 3                jmp y--, 18 side 0
18  010f  slot 4     hw_h       jmp 15 side 0 [1]
19  81a0  slot 3     halt       pull block side 0 [1]
20  0016  slot 5                jmp 22 side 0
21  6208  slot 3     cyc        out pins, 8 side 0 [2]
22  5158  slot 0     cyc0       in y, 24 side 1 [1]
23  5008  slot 2                in pins, 8 side 1
24  e000  slot 3     fetch      set pins, 0 side 0
25  8040  slot 4                push iffull noblock side 0
26  a025  slot 5                mov x, status side 0
27  103d  slot 0                jmp !x, 29 side 1
28  1198  slot 1                jmp y--, 24 side 1 [1]
29  90a0  slot 1     disp       pull block side 1
30  70a5  slot 2                out pc, 5 side 1
31  6208  slot 3     rd         out pins, 8 side 0 [2]
```

The pins are the side-set pin (`clk`), 8 OUT pins (`ui_in[7:0]`), 2 SET pins
(`ui_in[5:4]`, cleared at every fetch), the IN pins from `uo_out[0]`, and JMP
PIN = `uo_out[4]` (write-ready). Read-valid (`uo_out[5]`) is tested by copying
the pins to the OSR and jumping on bit 5 with `out pc, 1`, into the two-entry
table at addresses 0 and 1. The dispatch `pull` never blocks, because it
follows a TX-level test (`mov x, status`, EXECCTRL.STATUS_N = 1). The HALT
`pull` is the only instruction that can stop the clock.

The port never lets an operation that decides on a sample change the window.
In a frame that changes the window, read-valid and write-ready depend
combinationally on `ui_in[7:6]`, and the sample comes too soon after the
change. In such frames the protocol defines ready and valid as low (the
window-change bubble). `cycle()` therefore reports them as 0 and samples only
IRQ and FAULT, which are registered. WR never changes the window. A read in a
new window uses RDB. Reset and deselection halt the clock: `rst_n` and `ena`
change only while the clock is stopped low, and `ui_in = 0` while they are
active.

`LockstepEmulator` (a `ProtocolEmulator`) moves word transfers into the
program. `write_word` is one CYC (the FAULT state before the word), eight WR
and one CYC (the state after it). `read_word` in window 0, and in window 3
after `levels()` showed a word that only the host can remove, is RD or RDB
followed by CYC. The driver puts the words of a transaction with one
`sm.put(array('I', ...))` call, a single write loop in C, in chunks of at
most 4 words. Each chunk goes in only when it fits in the TX FIFO, so a put
never blocks. Everything else (partial transfers, read pauses, `try_*`
probes) runs ProtocolEmulator's own per-cycle code on `cycle()`. `idle(n)`,
`run(n)` and `free_run(n)` let at least `n` clocks pass.

Minimum project clocks per host call, measured on the model with no CPU time
between FIFO accesses: `cycle()` 3, a command or a TX word write 21,
`read_word(0)` in window 0 13, `set_window(1)` followed by `read_word(0)`
18, and `read_status()` or `levels()` 39. On a board, the MicroPython code between FIFO accesses adds
to this; that time was not measured.

### Rate

The project clock is f_sys / 6 (clock divider 1):

| RP2 system clock | Project clock | Note |
|---|---|---|
| 150 MHz | 25 MHz | RP2350 (demo board v3) at its rated clock |
| 144 MHz | 24 MHz | `machine.freq(144000000)`: USB-LS P = 8 per [extension-study.md](extension-study.md) section 3 |
| 125 MHz | 20.83 MHz | RP2040 at MicroPython's default clock |

A slower integer PIO clock divider scales every interval in the timing table
below. 10BASE-T timing (40 MHz) is out of reach.

### Timing

`host/pio/timing.py` derives the margins from the program's schedule
(the path check's slots) and from the chip's post-route timing. The chip
values come from `tools/sta` on the p018 layout at 15 ns (Slurm job
24089033, [notes/timing-closure.md](notes/timing-closure.md) section 10.5). That run's
SDC puts every I/O delay at X = 3 ns (20% of the period), and its slacks
include the 0.25 ns clock uncertainty:

| Chip requirement at the project boundary | slow | typ | fast |
|---|---:|---:|---:|
| `ui_in` set-up before `clk`: 15 − X − slack(setup, input to register) | 9.210354 ns | 5.824290 ns | 3.851867 ns |
| `ui_in` hold after `clk`: X − slack(hold, input to register), worst over all inputs | 1.740091 ns | 1.151163 ns | 0.845512 ns |
| `clk` to `uo_out`: 15 − X − slack(setup, register to output) | 6.055209 ns | 3.949203 ns | 2.722324 ns |

Outside the chip, the analysis takes two figures from Tiny Tapeout's GPIO
page ("Multiplexer measurements"), which describes the sky130 pads: the
"worst round trip latency" through the pads and multiplexer, 20 ns, and the
"Delay variance between different IO pins", "less than 2ns". Both were
measured on a single Tiny Tapeout 3.5 die at about 22 °C, and the page gives
them for reference only. No figures are published for the IHP pads. Each
row below therefore combines these room-temperature figures of one sky130
die with the chip's timing at the row's corner: the slow rows are not a
slow-corner analysis of the whole path. The set-up and hold margins charge the
2 ns for every delay difference between `clk` and `ui_in`; the RP2's
outputs and the board add to it. The RP2's pad delays
and the board traces are not in the sampling margin either: it is what
remains for them. At the RP2's pins, `ui_in` changes 3 system clocks before
and 3 after each rising edge, and `uo_out` must be valid 6 system clocks after
the previous rising edge.

| f_sys | Corner | Set-up at pins | Set-up margin (2 ns skew) | Hold margin (2 ns skew) | Sampling window | Sampling margin (20 ns round trip) |
|---|---|---:|---:|---:|---:|---:|
| 150 MHz | slow | 20.000 ns | 8.790 ns | 16.260 ns | 40.000 ns | 13.945 ns |
| 150 MHz | typ | 20.000 ns | 12.176 ns | 16.849 ns | 40.000 ns | 16.051 ns |
| 150 MHz | fast | 20.000 ns | 14.148 ns | 17.154 ns | 40.000 ns | 17.278 ns |
| 144 MHz | slow | 20.833 ns | 9.623 ns | 17.093 ns | 41.667 ns | 15.611 ns |
| 125 MHz | slow | 24.000 ns | 12.790 ns | 20.260 ns | 48.000 ns | 21.945 ns |

The sampling instant rests on the modelled synchroniser latency. If the real
synchroniser captures the pads one system clock earlier, the window shrinks
by 6.667 ns at 150 MHz, to 33.333 ns, which leaves 7.278 ns at the slow
corner. If it captures one clock later, the sample comes one system clock
(6.667 ns at 150 MHz) after the RP2 raises `clk`. The value is then still
from before the edge only if the fastest path from the RP2's `clk` pin
through the pads, the multiplexer and the chip back to the RP2's input is
longer than one system clock. That is an assumption, not a result: Tiny
Tapeout publishes the worst round trip, not a minimum. The chip's share is
at least t_co_min = hold slack (register to output) − X = 0.914381 ns at the
fast corner, so the minimum round trip through the pads and multiplexer,
the RP2's pad delays and the board together must exceed
1000/150 − 0.914381 ns, about 5.75 ns, at 150 MHz.

At 150 MHz and the slow corner, set-up still holds with up to 10.789646 ns of
skew between `clk` and `ui_in`. The sampling margin stays non-negative before
RP2 pad and board delays while f_sys is at most 6000 / 26.055209 MHz, which
lies between 230 and 231 MHz. The arithmetic in this section was checked with
AXLE (Lean 4, `lean-4.28.0`, `okay: true`).

The sampling argument needs one fact about the RTL: within a window, uo_out
must not depend combinationally on the other `ui_in` bits. `python3 -m
pio.uo_cone` (Yosys, bit-level, the SRAM macro as a black box) shows that
`uo_out[3:0]`, `uo_out[6]` and `uo_out[7]` come from registers only. Only
`uo_out[4]` and `uo_out[5]` depend combinationally on inputs, namely
`ui_in[6]`, `ui_in[7]`, `ena` and `rst_n` (job 24409054, core sha256
26a873db…). A frame that keeps the window therefore has registered outputs
only.

A frame that changes the window does have a combinational path, from
`ui_in[7:6]` to `uo_out[5:4]`, and its sample is not used for a decision
(see [Frame and operations](#frame-and-operations)). RDB is the case where a
decision follows soonest: its first RD sample comes 9 system clocks after
`ui_in` changes at the RP2's pins, 60 ns at 150 MHz. Against it stand the
20 ns round trip and at most 4.682413 ns inside the chip at the slow corner
(15 − 2 × 3 − 4.317587 ns, from the input-to-output setup slack of
`ui_in[7]` → `uo_out[5]` in [notes/timing-closure.md](notes/timing-closure.md) section
10.5), 24.682413 ns in all, which leaves 35.317587 ns for RP2 pad and board
delays.

### Pin maps

`check_pin_map` accepts a map when `ui_in` (8 GPIOs) and `uo_out` (6 to 8)
are contiguous runs and `clk`, `ui_in` and `uo_out` fit one 32-GPIO PIO
window.

| Board | clk | ui_in | uo_out | reset | Status |
|---|---|---|---|---|---|
| Demo board v3 (RP2350B), `PIN_MAP_DB3` | GPIO 16 | GPIO 17..24 | GPIO 33..40 | `rst_n` GPIO 14 through the SDK (`tt.reset_project`), outside the window | window GPIO 16..47 (GPIOBASE 16) |
| Pico / Pico 2 + FPGA, `pico.PIN_MAP` and `PIN_MAP_CMOD_A7_HOST` | GP16 | GP0..7 | GP8..15 | GP17 (`rst_n`) | window GPIO 0..31 |
| Pico + Urbana, `PIN_MAP_URBANA_HOST` | GP16 | GP0..7 | GP8..13 (uo_out[5:0]) | GP17 (`rst`) | IRQ and FAULT not visible |
| TT04 to TT06 boards (RP2040) | GPIO 0 | GPIO 9..12, 17..20 | GPIO 5..8, 13..16 | | not supported: `ui_in` is split, so one OUT group cannot drive it |
| Demo board v3 alpha map (`GPIOMapTTDBv3Alpha`) | GPIO 21 | GPIO 12..19 | GPIO 30..37 | | not supported: no 32-GPIO window holds both groups |

The DB v3 numbers were checked against `src/ttboard/pins/gpio_map_dbv3.py`
(`GPIOMapTTDBv3`) at the reviewed SDK commit `d485c7a`. Assumed and not
tested:

- MicroPython v1.26 or later on the RP2350B. It needs `rp2.PIO.gpio_base`
  (the backend calls `PIO(n).gpio_base(Pin(16))`) and the 9-field program
  list; `build_program` handles both list layouts.
- The `ttboard` SDK releases `clk`, `ui_in` and `uo_out` to the PIO once the
  project is selected in `ASIC_RP_CONTROL` mode and its clock is stopped
  (`demo_board_backend`).
- The two-cycle input synchroniser described in the RP2040 datasheet, with
  the capture phase modelled in `host/pio/sim.py`. The input-sync bypass is
  not used. If the capture is one system clock later, the minimum round trip
  of [Timing](#timing) is assumed as well.
- The program counter continuing at 0 after address 31 (`rd`).
- PUSH IfFull without autopush (`push iffull noblock` at address 25) doing
  nothing below the push threshold, as the datasheet describes and
  `host/pio/sim.py` models it. rp2040js 1.4.0 differs: it applies IfFull
  only with autopush, and pushes on every fetch frame.

```python
from machine import Pin
from pe_host.ports.pio_lockstep import connect_lockstep
from pe_host.ports import pico

pe = connect_lockstep()                                  # demo board v3 via the SDK

rst_n = Pin(17, Pin.OUT, value=1)                        # Pico + Cmod A7 host build
ena = Pin(18, Pin.OUT, value=1)
pe = connect_lockstep(pico.PIN_MAP_CMOD_A7_HOST,
                      reset=lambda active: rst_n.value(0 if active else 1),
                      ena=ena.value)
```

### Limits

- **Host throughput is set by the CPU.** The program itself needs 3 clocks
  for `cycle()` and 13 to 39 for a word transfer or a status read; the
  MicroPython code between FIFO accesses was not measured.
- **Blocked handshakes.** A WR or RD whose handshake never completes, for
  example a TX write to a full queue of a halted engine, holds the program.
  The port's watchdog (`watchdog_us`, 2 s by default) then re-initialises
  the state machine, which pauses the clock once, and raises `HostTimeout`.
  After that, `port.count_exact` is False.
- **The clock halts during reset and deselection.** In simulation, with the
  450-clock CPU model, each halt lasted about 5 µs.
- **No software peers.** `env` is refused, because bit-banged peers need
  host-supplied edges. Attach real peripherals to uio.
- **One self-test check assumes host-supplied edges.** "timestamp advances
  once per host clock" compares `pe.cycles` between host calls with the
  chip's timestamp. On a free clock, edges also pass between host calls, so
  the check can differ by a few clocks: by 1 in the RTL run, and by 0 to 8
  in the model runs so far, depending on the modelled CPU time. The other 72
  checks pass. A separate test shows that two timestamp snapshots differ by exactly
  the rising edges between them.
- **Scenario timing that the host sets in host cycles.** `run_flagship` starts
  the UART sender 96 cycles after `pe.cycles`. On this port the simulations
  start it 96 clocks after the chip's current edge instead
  (`pio.scenarios.ChipTimedUartSource`).
- **Not portable to every board.** The program uses a whole PIO block, and
  the driver needs MicroPython's `rp2` and `array` modules.
- **Not measured.** Pad-level timing on silicon, the IHP pads, RP2 pad delays
  and board traces are all unmeasured.

### Lockstep verification

All runs used the snapshot `dd7dae3` (the RTL of the design of record, core
sha256 `26a873db…`), with this port's files added. Simulations used cocotb
2.0.1 and Icarus Verilog 13.0, the CI builds. The unit tests ran in job
24409858, where the existing host suite also passed unchanged
(`test_host_*.py`: 72 tests, of which the two Icarus replays of
`test_host_rtl.py` were skipped because no Icarus was on the path).

An independent review then listed three places where the interpreter
departed from the datasheet: the delay of OUT/MOV EXEC, PULL with autopull
enabled, and side-set priority over OUT/SET. Checking the datasheet text for
them found a fourth, the autopull timing (first row below). None of them is
reachable by the lockstep program, which uses no autopull, no EXEC and no
pin shared by side-set and OUT/SET. After the corrections, job 24415035 ran every host test
module with MicroPython 1.29, mpy-cross, the `rp2.py` and `adafruit_pioasm`
oracles and Icarus 13.0 on the path: 141 tests (72 existing, 69 for this
port), none skipped, all pass. In the same job `make upy-check` reported no
problem in 19 files (the driver is now on its module list, with `array` on
the allow-list) and `make mpy` built both architectures. Job 24415288
repeated all of it after docstring-only edits, with the same results. A
CI-like run (Python 3.11, `PATH=/usr/bin:/bin`, no `PE_HOST_*` variables,
`python3 -m unittest discover -s host/tests` from the repository root) ran
the 141 tests with the 12 that need MicroPython, Icarus or an oracle
skipped, and passed (job 24415386). Job 24415056
repeated every cocotb run of the table, and the README's FPGA command, with
the same edge counts and results as job 24409857.

| Check | What it shows | Result |
|---|---|---|
| `host/tests/test_pio_sim.py` | The PIO interpreter (`host/pio/sim.py`) against the datasheet rules: side-set at issue and while stalled, delays after completion, output priority (side-set over OUT, SET and MOV on the same pin; the highest-numbered state machine), JMP conditions (X-- always decrements), WAIT on GPIO, PIN and IRQ, IN/OUT shift directions and counts, autopush, autopull as the datasheet's pseudocode gives it (an OUT on an empty OSR refills and stalls; other cycles refill in the background), PULL as a no-op on a full OSR while autopull is on, PUSH/PULL IfFull/IfEmpty/noblock (PULL noblock copies X), MOV invert/reverse/STATUS, OUT PC/ISR/EXEC (OUT and MOV EXEC ignore their own delay), SET, IRQ with REL, FIFO join, wrap, forced instructions, the two-cycle synchroniser and its bypass, RP2350 IN_COUNT and MOV PINDIRS. Not modelled (the module docstring lists them): the RP2350's IRQ PREV/NEXT modes and MOV to/from the RX FIFO registers (both raise `PioError`), fractional clock dividers, OUT_STICKY and INLINE_OUT_EN, system interrupts and DREQ. | PASS (32 tests; job 24409858). Corrected after the review: autopull timing, the PULL fence, the EXEC delay and side-set priority; each new test fails on the uncorrected rule. PASS (38 tests; job 24415035) |
| rp2040js 1.4.0 differential (the review's harness, in the work directory) | `host/pio/sim.py` against rp2040js's PIO state machine, instruction by instruction, on random programs, leaving out the classes rp2040js does not model as the datasheet does (WAIT, IRQ, EXEC, MOV PINDIRS, 32-bit OUT, IfFull/IfEmpty, side-set pins shared with OUT/SET); and the lockstep program itself on random operation streams. | Autopull off: 2,000 programs, 99,623 instructions, 0 differences. Autopull on: rp2040js refills the OSR at the start of an OUT and has no PULL fence, so most programs differ, each first in the OSR, its count, the TX level or an OUT stall. Lockstep program, with rp2040js given the datasheet's IfFull: 100 streams, 40,000 instructions, 0 differences (job 24415035) |
| `host/tests/test_pio_asm.py` | The CPython `asm_pio` against the datasheet encodings. The lockstep program assembled by MicroPython's own `rp2.py` (v1.24.1, v1.25.0, v1.26.0 and master, fetched 2026-09-30) gives the same 32 words and configuration fields, and `adafruit_pioasm` 1.3.8 assembles the disassembly to the same words. The path check (`host/pio/pathcheck.py`) covers all 32 reachable (instruction, slot) states: the clock waveform holds on every path, `ui_in` is driven only at slot 3 and `uo_out` read only at slot 2, every `jmp y--` falls through to its target, and only the two expected `pull`s block. The path check fails on a broken program. | PASS (9 tests; jobs 24409858 and 24415035) |
| `host/tests/test_pio_lockstep.py` | The MicroPython driver, unchanged, on stand-ins for `rp2`/`machine`/`time` whose state machine is the interpreter, with the reference model at the pins and a modelled CPU cost of 12 or 450 system clocks per FIFO access. Covered: the self-test (all 73 checks, or 72 with the timestamp check of Limits, depending on the modelled CPU time); the flagship scenario with pad-level peers and with `peers="external"`; `uart_stream` and `uart_bridge`, plus the control run without host service (fault 4); the acceptance oracle of `test_host_harness_equivalence.py` on its operation list and 10 random programs; the watchdog restart; the Y-wrap reconstruction; pin maps, including an RP2040 Pico at 125 MHz and the 6-bit Urbana map. Every run checks that the clock period is 6 system clocks at every rising edge outside reset halts, that `ui_in` never changes within 3 system clocks of a rising edge, and that `port.count` equals the edge count at every sample. | PASS (17 tests; jobs 24409858 and 24415035) |
| `host/tests/test_pio_micropython.py` | `upy_check` on the driver. Differential replay: the self-test and `peers="external"` runs are recorded call by call in CPython and replayed under the MicroPython 1.29 unix port, from source and from `mpy-cross` output; every call and the verdict match. MicroPython's own `rp2.asm_pio` (the same four versions), running under MicroPython, assembles the program to the recorded words. | PASS (5 tests; jobs 24409858 and 24415035) |
| `host/pio/cocotb`, RTL | The interpreter drives `clk` and `ui_in` of the RTL at 6.667 ns per system clock and reads `uo_out` through the modelled synchroniser. The driver and library run unchanged in a bridge thread, with a CPU cost of 450 system clocks per FIFO access. Pad-level peers act on uio, and the reference model checks `uo_out`, `uio_out` and `uio_oe` at every rising edge after the first reset. | flagship PASS (83,653 rising edges; 83,043 compared, 0 mismatches); uart_bridge PASS (52,009 edges); uart_stream PASS (38,664 edges); self-test 72 of 73, as in Limits (147,905 edges); all in job 24409857, and again in job 24415056. Every rising-edge interval is 6 system clocks except the reset halts (2 per reset, 756 and 758 system clocks), and no `ui_in` change falls within 3 system clocks of an edge. |
| `host/pio/cocotb` on the FPGA host-clock builds (`fpga/sim`, `FPGA_CLOCK=host`) | The same module on `tb_fpga_pins.v`: the board top, shell, design and FPGA SRAM stand-in, with the testbench's pad and pin checker active. The PIO reads all 8 `uo_out` bits of the testbench; the 6-bit Urbana map was tested on the model only. | Cmod A7: flagship, uart_bridge and uart_stream PASS, self-test 72 of 73. Urbana: flagship and uart_bridge PASS. Same edge counts as on the RTL and 0 mismatches (jobs 24409857 and 24415056). |
| `host/pio/uo_cone.py` | Combinational fan-in of every output (see Timing). | uo_out[5:4] from ui_in[7:6], ena, rst_n only (job 24409054) |

Clock traces (one line per change of `clk` or `ui_in`) and excerpts around a
window-3 read in the middle of each run are in the work directory, not in the
repository.

## Verification of the library

All runs used the committed snapshot `73536f0`: reference model, firmware
images, harness and RTL. The host code was the working-tree `host/`, copied
into each job's run directory. Results come from the Slurm jobs named in the
table; the work manifest records every job. The latest round (jobs 23778831
and later) ran a frozen copy of the current `host/`.

Two Icarus Verilog builds were used for the RTL replays: 14.0 (devel,
s20260301) from the OSS CAD Suite, and 13.0 from TinyTapeout's
`iverilog_13.0-1_amd64.deb`, the build that `.github/workflows/test.yaml`
installs in CI.

| Check | What it shows | Result |
|---|---|---|
| `host/tests/test_host_commands.py` | Every command and READ_SELECT against the model's internal state. Also: rejections, TX/RX timeouts, read pauses, strict-overflow held RX, every committed image loaded (19 at the time of job 23778831, 26 since `e64cd6b`), a self-test that fails on a model with an injected host-port bug, and raw SELECT/READ_SELECT under a high FAULT pin (the library's selection stays equal to the model's, and `fault_report()` still works). | PASS (job 23778831; with the 26 images, job 24302122) |
| `test_host_transfers.py` | Abandoned partial command, program, TX, RX and status transfers (1 to 7 nibbles) have no side effect. A window change abandons the RX reservation. Every window change is a bubble with ready and valid low. Read-valid comes two cycles and write-ready one cycle after the change. | PASS (23778831) |
| `test_host_image.py` | SHA-256 and structure checks, architecture binding and ISA requirement, including tampered images. Since the ISA-version-3 rule (three tests): `isa3_differences` on hand-written words (non-lane counts, targets 127 and 128) and on the 26 committed images, where it names only `ps2-host` word 45, cross-checked against the `.source.json` files (the only shift count that is not a multiple of 8; every branch target a label, every image at most 64 words); `check_isa` with 2, 3 and 0x000F5F03; and `load_image` on reference models of `diet8` and `diet4` with `isa_versions=(2, 3)`, which loads the other 25 images and refuses `ps2-host` with its engine left uncommitted (`check_isa=False` loads it). With the rule removed from `check_isa`, all three fail (four failed checks, job 24391702). | PASS (23778831; the ISA-version-3 tests, 24391202) |
| `test_host_harness_equivalence.py` | An operation list covering every command, accepted and rejected, gives cycle-identical ui/uio/rst/ena/uo and identical returned values on the library and on `test/harness.py`. The harness driver returns nothing for commands, so an acceptance oracle (`tests/acceptance.py`) checks `command()`'s results separately. It wraps the model's own command decoder and compares each result with the model's accept/reject decision. It also checks that the library's `selected` and `read_selected` equal the model's after every operation. The oracle runs on the operation list and on 30 random programs, each on a full port and on a 6-bit uo port. A mutant with the old SELECT/READ_SELECT rule is caught. | PASS (23778831) |
| `test_host_flagship.py` | The flagship scenario with pe_host peers. The pad waveform is decoded by `test/model/scoreboards.py` (`uart_decode` on pins 0 and 1, `spi_decode` MOSI and MISO, `i2c_decode`, `assert_open_drain`) and by `test/peers.py`'s `UartMonitor`. Also covered: I2C clock stretching, NACK reported as fault 65, and the contention interlock. With the `test/` peers, the whole flagship waveform (over 7,000 cycles) equals `test/scenarios.py` `flagship()` on the harness, cycle for cycle. `peers="external"`, with SPI and I2C targets on the pads and an idle UART line, has four tests. (1) Engine 1 (`uart-rx-idle` since `e64cd6b`) does not fault on the idle line: the run passes with no engine fault and no host fault, and nothing is cleared. (2) A host fault injected right after reset is still detected. (3) An extra engine fault (no I2C target, so fault 65) fails the run. (4) On a 6-bit uo port the run passes, with the host fault reported as not checked. (Until `e64cd6b` engine 1 ran the bounded `uart-rx`, test (1) expected its fault 3 and a CLEAR, and (3) and (4) expected fault 3 as well.) | PASS (23778831; with `uart-rx-idle`, 24302122) |
| `test_host_ports.py` | `DemoBoardPort` (fast and slow) and `PicoPort` (fast and slow) against SDK/GPIO fakes. For the self-test and the flagship scenario, their rising-edge sequence equals `ModelPort`'s. `PIN_MAP_CMOD_A7_HOST`: the self-test minus `trigger`, then `deselect()` through the ena GPIO, gives the same edges as `ModelPort`, ena included. `PIN_MAP_URBANA_HOST`: active-high reset, uo_out[5:0] only, program load, TX/RX traffic, and SELECT/READ_SELECT acceptance without uo[7]. | PASS (23778831) |
| `test_host_rtl.py` | The library's exact stimulus for the self-test (3,324 cycles) and the flagship scenario (7,827 cycles with `uart-rx`; 7,842 with `uart-rx-idle` since `e64cd6b`), rendered as a self-checking testbench and run on the RTL, once with Icarus 14 and once with Icarus 13.0 (the CI build). | PASS on both (23778831; with `uart-rx-idle`, 24302122) |
| `test_host_makefile.py` | `make -C host rtl-cocotb-paths` from the repository root (also with a bogus `$PWD`), `make rtl-cocotb-paths` in `host/` and `make paths` in `host/tests/rtl_cocotb/` all resolve the same testbench, RTL, model and scenario. Command-line overrides work, and a stale `PE_HOST_SCENARIO` in the environment is ignored. | PASS (23778831) |
| `tests/rtl_cocotb` | The library drives the RTL live through cocotb 2.0.1 (`CocotbPort`, bridge thread), lockstep with the model before and after every edge. The self-test and the flagship scenario both pass, with 0 mismatches. In a fresh export of `73536f0` plus this `host/`, all three documented entry points ran on Icarus 13.0, each giving 2 of 2: `make -C host rtl-cocotb` from the repository root, `cd host && make rtl-cocotb` and `make` in `host/tests/rtl_cocotb/`. So did the first form with a stale `PE_HOST_SCENARIO` in the environment, and the first form on Icarus 14. With `uart-rx-idle` on engine 1 (since `e64cd6b`), the first form on Icarus 13.0 gives 2 of 2 again. | PASS, 2 of 2 in each of the 5 runs (23778831); 2 of 2 (24302122) |
| `test_host_micropython.py` | `tools/upy_check.py` subset check. The self-test, the flagship scenario (with and without I2C stretching) and the `peers="external"` flagship run replayed under the MicroPython 1.29 unix port, from `.py` sources and from `mpy-cross` `.mpy` files. Every ui byte and peer drive matched the CPython run, and so did the verdict (for `external`: pass, host fault False, and no engine fault with `uart-rx-idle`; faults `1:3` with `uart-rx` until `e64cd6b`). Also checks the pure-Python SHA-256. | PASS (23778831; with `uart-rx-idle`, 24302122) |
| `peers="external"` with the default 200,000 free-run cycles (`external_default.py` in the work directory) | SPI and I2C targets on the pads and an idle UART line, on a full port and on a 6-bit uo port. | With `uart-rx-idle` (since `e64cd6b`): PASS on both, 201,599 host cycles each, no engine fault and nothing cleared; host fault False on the full port and not checked on the 6-bit port; I2C bytes `84 5a` (24302122). Until `e64cd6b`, with `uart-rx`: PASS on both, 201,581 host cycles each, faults `[(1, 3)]`, none after the CLEAR (23778831) |
| `tools/fuzz_host.py`, seeds 0 to 59,999 | Random host-operation programs, run on the harness driver, the CPython library and the MicroPython library (three-way differential). | 60,000 of 60,000 PASS: 114.4 M cycles, 4.38 M ops (jobs 23755318, 23755319) |
| `tools/fuzz_host.py --rtl`, seeds 100,000 to 102,999 and 200,000 to 239,999 | The same three-way differential, and each seed's stimulus also replayed on the RTL with Icarus 14, checking every public output after every edge. | 43,000 of 43,000 PASS: 81.7 M RTL cycles (jobs 23756016, 23756557) |
| `tools/fuzz_host.py --rtl`, seeds 300,000 to 399,999, on the current code (SELECT/READ_SELECT acceptance rule, generalized `PicoPort`) | The three-way differential plus the Icarus 14 RTL replay of every seed. | 100,000 of 100,000 PASS: 190.5 M cycles, 7.30 M ops, 100,000 MicroPython and 100,000 RTL replays (jobs 23767497, 23767986, 23767987, 23767988) |
| `tools/fuzz_host.py --rtl`, seeds 400,000 to 499,999, current code, RTL replays on Icarus 13.0 | The three-way differential, the acceptance oracle on every command of every seed, a repeat on a 6-bit uo port for every fourth seed (same stimulus, same oracle), and the Icarus 13.0 RTL replay of every seed. | 100,000 of 100,000 PASS: 190.5 M cycles, 7.30 M ops, 100,000 MicroPython and 100,000 RTL replays, 25,000 6-bit repeats, 0 oracle problems (jobs 23778347, 23778353, 23778832, 23778833, 23778835, 23778836) |

In job 23778831 the full unit suite ran 69 tests with none skipped, with
MicroPython 1.29, mpy-cross and Icarus 14 available; `test_host_rtl.py` then
ran again on Icarus 13.0 and passed. A CI-like run (Python 3.11,
`PATH=/usr/bin:/bin`, no `PE_HOST_*` variables, `python3 -m unittest
discover -s host/tests` from the repository root) ran 69 tests with 6
skipped: the four MicroPython replay tests and the two Icarus replays. Job
24302122 repeated both runs on the tree with `uart-rx-idle` as the flagship's
engine 1 (since `e64cd6b`): 69 of 69 pass with MicroPython 1.29, mpy-cross
and Icarus 14, `test_host_rtl.py` passes on Icarus 13.0, and the CI-like run
passes with the same 6 skipped. Job 24391202 ran the suite with the three
ISA-version-3 tests of `test_host_image.py` on a snapshot of the working tree
after `dced528`: 72 of 72 pass with MicroPython 1.29, mpy-cross and Icarus 14
(`make test`), the CI-like run passes with the same 6 skipped,
`test_host_rtl.py` passes on Icarus 13.0, `make upy-check` reports no
problem, `make mpy` builds for both architectures and `make -C host
rtl-cocotb` gives 2 of 2; the same `make test` on `dced528` itself runs 69.
The host tests are not in CI yet. If
`python3 -m unittest discover -s
host/tests` is added to `.github/workflows/test.yaml` after its Icarus 13.0
install step, the two Icarus replays run as well, and they pass on that
build.

The fuzz programs mix every command with valid and invalid payloads,
abandoned writes in windows 1 and 2 and abandoned reads in windows 0 and 3,
read pauses, bounces, program and firmware loads, and mid-run resets and
deselection. Seeds 0 to 59,999 produced:

- 417,341 READ_SELECT status reads;
- 468,921 abandoned and 115,671 completed bounded reads;
- 341,895 abandoned and 243,297 completed bounded writes.

Every defined command (opcodes 0 to 11) was seen accepted and seen rejected,
and was also sent while FAULT was already high. COMMIT was accepted only 28
times in seeds 0 to 59,999, because it needs the exact written length.
Unknown opcodes were always rejected.

`command()` never returns None for SELECT and READ_SELECT, by construction,
so counting None results proves nothing. The evidence that the results are
right comes from the acceptance oracle. It compares every result with the
model's own decision, and the library's selection record with the model's
after every operation. In seeds 400,000 to 499,999 it found no problems in
any of these cases (library result / model decision):

- SELECT and READ_SELECT on a full port: 208,942 True/accepted and 71,821
  False/rejected. On a 6-bit uo port: 52,482 and 18,058.
- Other commands on a full port: 861,937 True/accepted and 255,934
  False/rejected. 583,971 None/accepted and 274,722 None/rejected, each
  with FAULT already high.
- 239 False/accepted, each with an engine fault rising during the word.
  uo[7] cannot tell this case from a rejection, which is why the library
  documents it.
- Other commands on a 6-bit port: None in all 495,272 cases.

The replay found one real MicroPython incompatibility. An exception subclass
called `HostError.__init__(self, ...)`, which raises AttributeError on
MicroPython. It now uses `super().__init__`, and `upy_check` flags the pattern.

Not verified: any run on a demo board, a Pico or an FPGA; the real `ttboard`
SDK (only the fakes); SDK releases older than v3; RP2 clocking speed;
`free_run` PWM behaviour; and `peers="external"` with real peripherals (only
pad-level software targets on the model).

## Sources

- Tiny Tapeout MicroPython SDK, <https://github.com/TinyTapeout/tt-micropython-firmware>,
  reviewed at commit `d485c7a9986336024e35d790568fca33be1c5665` (September
  2026, release v3.1.1):
  - README "Initialization", "Selecting and loading projects", "Interacting
    with I/O", "Project clocking and reset" and "Fast I/O";
  - `src/ttboard/demoboard.py` (`DemoBoard.get`, `reset_project`,
    `clock_project_once`, `clock_project_PWM`, `clock_project_stop`);
  - `src/ttboard/mode.py` (`RPMode`);
  - `src/ttboard/project_mux.py` (`shuttle.has`, `shuttle.get`,
    `Design.enable`);
  - `src/ttboard/pins/pins.py` (ports, `project_clk_driven_by_RP2`,
    `begin_asiconboard`);
  - `src/ttboard/pins/gpio_map_dbv3.py` (DB v3 GPIO map);
  - `src/ttboard/pins/manual_clock.py` (v3.3 button timer);
  - `src/ttboard/util/platform/rp2040.py` and `rp2350.py` (fast I/O, SIO
    register offsets);
  - `.github/workflows/release.yml` (frozen SDK, MicroPython from source) and
    the README compatibility matrix.
- RP2040 datasheet section 2.3.1.7 and RP2350 datasheet section 3.1.11 (SIO
  GPIO registers), as cited in the SDK's platform files.
- MicroPython 1.29.0 unix port and mpy-cross: conda-forge package
  `micropython-1.29.0-h8d769aa_0`, used for the replay and subset checks.
