TeslaCoilerOW/ttihp-protocol-emulator/docs/info.md

## How it works

This design is a small programmable protocol processor. Four independent
engines run their own programs at the same time. Between them they drive the
eight bidirectional pins `uio[7:0]`. Each engine is loaded with a program for
one protocol, such as UART, SPI, I2C, JTAG or a custom timed waveform. No
protocol is hardwired: every protocol is an ordinary program in the instruction
set described below. A synchronous, nibble-wide host port on `ui_in` and
`uo_out` loads programs, fills and drains queues, starts and stops engines and
reads status.

This chip's configuration is 4 engines, a 32-bit datapath, 64 instructions per
engine and 8-word queues. It uses fused issue, so the `XFER` instruction is
available, and it has no prefetch. The ISA version register reads 2.

### Engines

Each engine has:

- A private program memory of 64 32-bit instructions. It is made from two IHP
  `RM_IHPSG13_1P_64x16_c2` SRAM macros per engine, eight macros in all.
  Instruction fetch is never shared or arbitrated between engines.
- A TX queue (host or mover to engine) and an RX queue (engine to host or
  mover). Each holds eight 32-bit words.
- Registers `tx`, `rx`, `x` and `y`. They are 32 bits wide and arithmetic
  wraps.
- A 16-bit repeat counter, a 24-bit interval/wait limit and local control state.
- One event mailbox bit and one programmable input trigger.

Instructions commit on rising clock edges. An ordinary instruction takes one
cycle, and `WAIT n` takes n + 1 cycles, so a program's pin timing is an exact
count of system clocks. Instruction fetch is private. Apart from `START`,
`STOP` and `BEGIN` (which stops the selected engine), the host port and the
queue mover never delay an engine's instructions.
A program's timing can change only at its own explicit stall points:

- `PULL` on an empty TX queue;
- a blocking `PUSH` on a full RX queue;
- `WAITPIN`, which waits for an input pin;
- `WAITEVENT`, which waits for a mailbox event.

### Pins

- Pin ownership is set with the `OWN` host command while the engine is halted.
  Ownership is disjoint between engines. An engine may drive, or change the
  output enable of, only the pins it owns. Any other write faults. Any engine
  may read any pin.
- Owned pins can be made open-drain. An open-drain pin's output value is always
  0, and its output enable is the logical enable AND NOT the logical value. A
  logical 1 therefore releases the pin. I2C uses this mode, with external
  pull-ups.
- Inputs pass through two flip-flops before the engines see them.
- Outputs are masked by ownership, by run state and by fault. A halted or
  faulted engine releases all its output enables.

### Timed transfers (XFER)

`PINS` selects the clock, TX and RX pins. `XFER` then performs a complete
synchronous serial transfer (SPI-style). It takes a bit count of 1 to 32, a
half-period of 1 to 255 cycles, clock polarity, clock phase and bit order, and
separate drive and sample enables. There are exactly 2 × (bit count) clock
transitions, each separated by the half-period. `XFER` does not touch the
queues while it runs. Its edges therefore stay equally spaced even when the
host or other engines saturate a queue. Firmware moves data between the queues
and `tx`/`rx` with `PULL` and `PUSH` before and after the transfer.

### Queues and the autonomous mover

The host writes TX words through window 2 and reads RX words through window 3.
An engine uses `PULL` to move the head of its TX queue into `tx`, and `PUSH`
to append `rx` to its RX queue:

- `PUSH` with a = 0 blocks while the RX queue is full.
- `PUSH` with a = 1 (strict) faults with code 4 instead. The rejected word
  stays in `rx`, where the host can read it (READ_SELECT 6).

The mover forwards words between engines without the host. The `ROUTE`
command gives each source engine one descriptor: a destination engine and a
16-bit word count. The mover works as follows:

- An accepted move pops the source's RX head, pushes the same word into the
  destination's TX queue and decrements the count.
- At most one word moves per clock. Sources are served round-robin.
- Host TX writes have priority over the mover for the same destination.
- A host read in window 3 reserves the selected engine's RX queue.

The flagship example below uses the mover to bridge UART receive into SPI
transmit.

### Events, triggers and the timestamp

- Each engine has one mailbox bit. It can be set in three ways, and the three
  are ORed:
  - `SIGNAL` from any engine;
  - the host `EVENT` command;
  - the engine's input trigger.
- `WAITEVENT` consumes the bit, or waits for it (bounded by `LIMIT`). If a new
  event arrives on the same edge, the bit stays pending. Pending bits coalesce;
  they do not count events.
- The input trigger is configured with the host `TRIGGER` command. It watches
  one pin for a rising edge, a falling edge, a high level or a low level.
- Triggers work while the engine is waiting, transferring, stalled, halted or
  faulted. They do not need pin ownership.
- For an input change that is stable before a clock edge, the mailbox is set on
  the third edge.
- A 32-bit timestamp counts system clocks and is common to all engines. `TIME`
  copies it into a register, and the host reads it with READ_SELECT 1.

### Faults and reset

A fault stops the engine and releases its output enables. The engine keeps the
fault code until the host sends `CLEAR` (while the engine is halted) or resets
the chip. The built-in codes are:

| Code | Meaning |
|-----:|---|
| 1 | invalid opcode, operand or pin ownership |
| 2 | PC outside the committed image |
| 3 | bounded-wait timeout (`WAITPIN` or `WAITEVENT` exceeded `LIMIT`) |
| 4 | strict RX enqueue overflow (`PUSH` with a = 1 on a full RX queue) |

`FAULT n` stops with code n, which can be 1 to 255. The example firmware uses
codes 64 to 67 for protocol errors, such as a UART framing error or an I2C
NACK. An invalid host command is rejected with no effect, and it sets a sticky
host fault. The host fault is cleared by reset, or by `CLEAR` with payload bit
23 set. `uo[7]` is high while any engine has a fault or the host fault is set.

Reset (`rst_n` low) or deselection (`ena` low) stops all engines and releases
every output enable. It also invalidates all program images and clears the
queues, the mailboxes and the control state, including routes and trigger
configuration. The program memory itself is not reset, so reload the images
after every reset.

## Host interface

### Pins

| Pin | Dir | Function |
|---|-----|---|
| `ui[3:0]` | in | write nibble |
| `ui[4]` | in | write-valid |
| `ui[5]` | in | read-ready |
| `ui[7:6]` | in | window select (0 to 3) |
| `uo[3:0]` | out | read nibble |
| `uo[4]` | out | write-ready |
| `uo[5]` | out | read-valid |
| `uo[6]` | out | IRQ: any event mailbox pending, or any RX queue non-empty |
| `uo[7]` | out | FAULT: any engine fault, or the sticky host fault |
| `uio[7:0]` | in/out | protocol pins 0 to 7 |

The host port is synchronous to `clk`, and `ui_in` is not synchronized. The
host must therefore share the chip's clock and change `ui_in` only between
rising edges.

A nibble transfers on a rising edge where ready and valid are both high. A
32-bit word is eight nibbles, least significant nibble first. For example,
the command word `0x0400000F` is sent as F, 0, 0, 0, 0, 0, 4, 0.

`uo[4]` and `uo[5]` drop immediately when the window bits change. Sample
`uo_out` after driving `ui_in` and before the rising edge. The read nibble has
no defined value while read-valid is low.

### Windows

| Window | Write | Read |
|---:|---|---|
| 0 | command word | status word chosen by READ_SELECT |
| 1 | next program word of the selected engine (address auto-increments) | none |
| 2 | TX queue word of the selected engine | none |
| 3 | none | RX queue word of the selected engine, popped when its last nibble is accepted |

Write-ready depends on the window:

| Window | Write-ready is high |
|---:|---|
| 0 | always |
| 1 | only while the selected engine is halted, after `BEGIN`, before `COMMIT` and below 64 words |
| 2 | only while that engine's TX queue has space |
| 3 | never |

Reset, deselection and the window-change bubble also hold write-ready low.

Changing the window abandons any partly transferred word, with no side effect.
The cycle in which the window bits change is a bubble: ready and valid are
both low. In the next cycle, write-ready can be high, so the first write nibble
can be accepted at the end of that cycle. A read word is captured at the end
of that same cycle, and read-valid rises one cycle later. A read word is a
snapshot: it stays stable until all eight nibbles are accepted, however long
the host pauses.

A full queue does not accept a push on the same edge that first frees space.
An empty queue does not allow a pop on the same edge as its first push.

The timing sketch below writes one TX word in window 2 and then reads one
status word in window 0. Each column is one clock cycle. It shows what the host
drives and samples before the rising edge at the end of that cycle.

```
cycle      0   1   2  ..   8   9  10  11  12  ..  18
ui[7:6]    2   2   2       2   0   0   0   0       0
ui[4] WV   0   1   1       1   0   0   0   0       0
ui[3:0]    -  d0  d1      d7   -   -   -   -       -
uo[4] WR   0   1   1       1   0   1   1   1       1
ui[5] RR   0   0   0       0   0   1   1   1       1
uo[5] RV   0   0   0       0   0   0   1   1       1
uo[3:0]    -   -   -       -   -   -  q0  q1      q7
           ^ bubble            ^ bubble, then capture in cycle 10
```

### Commands (window 0 writes)

A command word has the opcode in bits 31:24 and the payload in bits 23:0. Any
payload bit not listed below must be zero. An "engine mask" has bit i set for
engine i, using bits 3:0.

| Op | Command | Payload | Effect and conditions |
|---:|---|---|---|
| 0 | SELECT | bits 1:0 engine | Selects the engine used by windows 1 to 3, per-engine reads and the commands below. |
| 1 | BEGIN | none | Stops the selected engine, invalidates its image and sets the program write address to 0. |
| 2 | COMMIT | bits 15:0 length | Accepts the image only if exactly that many words were written since `BEGIN`. The length must be 1 to 64. |
| 3 | OWN | bits 7:0 owned pins, bits 15:8 open-drain mask | Halted engine only. Rejected if ownership overlaps another engine or open-drain bits fall outside ownership. |
| 4 | START | engine mask | Starts all the selected engines on the same edge. Each must have a committed image and no fault. Resets PC, registers, timers, repeat state and logical outputs. Keeps queues, ownership, open-drain configuration and images. |
| 5 | STOP | engine mask | Stops the engines and releases their output enables. |
| 6 | ROUTE | bits 1:0 source, bits 3:2 destination, bit 4 enable, bits 20:5 word count | Sets the source's single mover descriptor. Enable 0 or count 0 disables it. Self-routes are legal. |
| 7 | CLEAR | engine mask; bit 23 clears the host fault | Clears engine faults. The engines must be halted. |
| 8 | READ_SELECT | bits 7:0 index 0 to 7 | Chooses the window 0 read word (see the next table). |
| 9 | EVENT | engine mask | Sets those engines' mailboxes. |
| 10 | FLUSH | none | Empties the selected engine's queues and disables every route touching it. Halted engine only. |
| 11 | TRIGGER | bits 2:0 pin, bits 4:3 mode (0 rising, 1 falling, 2 high, 3 low), bit 5 enable | Configures the selected engine's input trigger. Halted engine only. |

### READ_SELECT (window 0 reads)

| Index | Word read in window 0 |
|---:|---|
| 0 | Status of the selected engine: bit 0 running, bit 1 committed, bit 2 stalled, bit 3 fault, bits 15:8 fault code |
| 1 | Common 32-bit timestamp |
| 2 | Queue levels of the selected engine: TX in bits 15:0, RX in bits 31:16 |
| 3 | PC of the selected engine |
| 4 | Event pending for the selected engine (bit 0) |
| 5 | Completed-instruction count of the selected engine |
| 6 | Held RX register (`rx`) of the selected engine, for example a word rejected by a strict `PUSH` |
| 7 | ISA version (2) |

The status word is snapshotted when it is first presented. After a
READ_SELECT, a word captured earlier may still be waiting. Switch to window 1
for one cycle and then back to window 0 to capture a fresh word.

### Loading and starting

1. `SELECT` the engine, then send `BEGIN`.
2. Write every program word in window 1.
3. Send `OWN`, then `COMMIT` with the image length.
4. Repeat steps 1 to 3 for each engine.
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
