TeslaCoilerOW/ttihp-protocol-emulator/test/README.md

# cocotb verification suite

Tests for `tt_um_teslacoilerow_protocol_emulator` (`../src/project.v` wrapping the
Hardcaml-generated `../src/protocol_emulator_core.v`). Every test runs the DUT in
**lockstep** with an independent pure-Python reference model of ISA v2
(`model/reference.py`, see `../docs/isa.md`): on every 20 ns clock the harness
compares `uo_out`, `uio_out` and `uio_oe` both after the edge and before the next
edge (the combinational window-change bubble on ready/valid). Read nibbles are
compared while read-valid is high, which covers every word the host reads. On top
of that, protocol results are checked at the pads by independent monitors and
behavioral peers.

## Layout

| file | content |
|---|---|
| `tb.v` | testbench top: instantiates the TT top, dumps `tb.fst` (TT ports only by default) |
| `Makefile` | cocotb makefile: RTL (default) and gate level (`GATES=yes`) |
| `harness.py` | lockstep harness (`CocotbHarness`, plus `ModelHarness` for model-only runs) and the nibble host driver: windows, ready/valid, eight little-endian nibbles per word, window-change bubble, SELECT/BEGIN/COMMIT/OWN/START/STOP/ROUTE/CLEAR/READ_SELECT/EVENT/FLUSH/TRIGGER, `firmware/*.image.json` loading with SHA-256 identity checks; the time warp (`warp`, `warp_completed`, `warp_routes`, see "Time warp") |
| `peers.py` | pad-level peers: UART source and streaming UART monitor, SPI target (modes 0-3), wired-AND open-drain I2C bus |
| `scenarios.py` | directed scenarios shared by the tests (runnable on the model alone) |
| `test_smoke.py` | reset/deselect, ISA version, loader (BEGIN/OWN/COMMIT/START/STOP), status registers, host-fault rejections, checker self-test |
| `test_protocols.py` | `uart-tx` (decoded from pin 0), `uart-rx` (pin 1 driven, RX FIFO read; idle timeout and framing faults), `spi-controller-mode0..3` against the SPI target, `i2c-write`/`i2c-read`/NACK against the open-drain target |
| `test_flagship.py` | `../firmware/flagship-scenario.json`: four engines concurrently (UART TX, UART RX with `uart-rx-idle`, SPI, I2C) plus the autonomous UART-RX to SPI-TX route; and 5 RTL-only tests of `uart-rx-idle` alone on engine 1 (idle stretches of `PE_UART_IDLE_CYCLES`, default 100,000 cycles; sparse frames at every poll phase, a break across START and a framing error; back-to-back frames at -2%, 0 and +2% baud error), which record the reference model's sample points while the DUT is checked in lockstep on its outputs; skipped at gate level |
| `test_protocols_ext.py` | the SWD, WS2812B, PS/2 and 1-Wire images (`../docs/firmware.md`) against peers written here from the cited specifications, 22 tests, and `test_ps2_host_restricted` (below). Not in the default list or the gate-level test: run `make COCOTB_TEST_MODULES=test_protocols_ext` (RTL, about 7 minutes); CI runs it in the `protocols-ext` job of `../.github/workflows/test.yaml`. It loads `../firmware/` directly and skips an image's tests on a design whose engine count, data width, queue depth or issue mode differs from the design of record, or whose ISA-version-3 knobs change one of the image's words (`model/variant.py` `Options.image_differences`; `../docs/isa.md`, "ISA version"). `ps2-host` shifts by 21 (word 45), so on a design with byte-lane shifts the two `test_ps2_host` tests are skipped and `test_ps2_host_restricted` checks instead that the image sends its command to the device and then faults at that word with code 1. That test queues one word, so it also runs on the 4- and 2-word-queue designs (`diet4`, `diet2`), where the other 22 are skipped; on the design of record it is skipped. `test_ps2_host_no_device` ends before that word and runs on every design of the design of record's architecture |
| `test_legacy.py` | lockstep replay of the 25 monorepo differential workloads (`model/verification.py`): queues, DMA congestion, SPI mode matrix, strict push, input triggers, JTAG, waveform, I2C target, UART overflow, ... |
| `test_random.py`, `random_gen.py` | constrained-random lockstep differential test with functional coverage and a minimizer |
| `test_directed.py` | directed tests written from the mutation campaign's survivor analysis (full-capacity image, OWN overlap, operand check, ROUTE counts above 4095, FLUSH of a routed engine, COUNT/LOOP, 40,003 completed instructions, blocked count after ALU/TIME, LIMIT 0x2108, SHR into bit 15, odd XFER half-period, far jump targets, XFER next to driven pins) |
| `test_mover.py` | mover (DMA) arbitration: round robin among 2, 3 and 4 simultaneously eligible routes (one a self-route) and host TX priority, with an independent per-edge monitor of the arbitration rule |
| `test_counters.py` | long-running counters read back: more than 2^16 completed instructions on every engine, a 0xFFFF-word ROUTE drained to zero, COUNT 0xFFFF loops, timestamp past 2^16, ROUTE counts draining exactly, LIMIT values with each bit 9..23 set, exact WAITPIN/WAITEVENT timeouts, exact WAIT ends |
| `test_timewarp.py` | counter carries up to bit 31 and the 2^32 timestamp rollover by time warp: timestamp/TIME, completed counts while every opcode runs, WAIT timers, blocked counts and LIMIT timeouts, blocked-count clearing by every kind of instruction, repeat counters, ROUTE counts |
| `test_wait_limit.py` | WAITEVENT and WAITPIN time out on the LIMIT-th sample at LIMIT 2^k + 2 (k = 0..23) on every engine, read from each engine's output enable and status (see "LIMIT timeouts") |
| `test_spec_pin_writes.py` | output values and enables change only where SET, DIR, OUT and HALT write them: OUT on every pin and value against both levels of every other pin, and DIR/SET patterns held through every other kind of instruction, wait and stall, on every engine (see "Specification checks") |
| `test_spec_xfer_timing.py` | XFER with every bit count 1..32 and half-periods 1..4 on every engine: the clock pin's level on every edge against the transition rule of `../docs/isa.md` |
| `test_spec_counters.py` | the completed-instruction count read while the engines block, stall, transfer and hold and after a strict overflow, at twelve count bit patterns (time warp); all eight READ_SELECT words; WAITEVENT and WAITPIN under the default LIMIT 65535 after reset and after START |
| `test_spec_loader.py` | COMMIT 0 after BEGIN, COMMIT of a length not written and of a committed image are rejected; full-capacity images committed at both cycle parities after their last word are accepted and run |
| `test_spec_invalid_encodings.py` | every undefined opcode one bit from a defined one (with that opcode's valid operands) and FAULT with an invalid operand fault with code 1 on the engine that issues them: fault pin, status, PC and count |
| `test_spec_common.py` | helpers of the `test_spec_*` modules (`PE_SPEC_ONLY` harness, pin-trace observer); no tests |
| `model/` | the reference model, host recorder and wire scoreboards, copied from the asic-lab monorepo (stdlib only; provenance and hashes in `model/__init__.py`); `model/variant.py` (written here) adds the design variants |
| `variants.py`, `variant_workloads.py` | design-variant selection (`PE_VARIANT`) and the legacy workloads recorded on a variant; see "Design variants" |

## Running

Requirements: Icarus Verilog (the TT actions use 13.0), Python 3.11+, and
`pip install -r requirements.txt` (cocotb 2.0.1, pytest 8.4.2).

RTL (what the TT `test` action runs):

```sh
cd test
make clean
make
```

The RTL run compiles `../src/project.v`, `../src/protocol_emulator_core.v` and the
IHP SRAM behavioral models `../models/RM_IHPSG13_1P_64x16_c2.v` +
`../models/RM_IHPSG13_1P_core_behavioral.v` with `-DFUNCTIONAL`. The full suite
has 118 tests in 26 modules (109 in 21 before the five `test_spec_*` modules;
see "Specification checks"). In job 24303859, `make clean; make` of the 107 tests before
`test_wait_limit.py` with Icarus 13.0 on a
cluster node, while other `scripts/reproduce.sh` steps ran in parallel,
took 373 s, with 368 s of test time; the five `uart-rx-idle` tests of `test_flagship.py`, added in
`e64cd6b`, took 105 s of it. For the 102-test suite before that commit it
took about 221 s of test time, of which the gap-closure modules took 27 s
and the test_kill_* modules 132 s. With `test_wait_limit.py`, `make clean;
make` alone on a cluster node took 216 s, with 207 s of test time, of which
its two tests took 2.9 s (job 24382111_1); in GitHub's `test` job of
`3364ad9` the 107 tests took 214 s of test time (run 36657674148). In job
24493924, which ran four suites at once on one cluster node, the 118 tests
took 440.8 s of test time, of which the nine `test_spec_*` tests took 17.2 s
and the other 109 tests 423.6 s; the 109-test suite alone, in the same job,
took 422.9 s. Uncontended (job 24507279, one suite per node) the 118 tests
took 198.3 s of test time, of which the nine `test_spec_*` tests 14.9 s, about
8 % more than the other 109 tests' 183.4 s.

Useful variables:

```sh
make COCOTB_TEST_MODULES=test_protocols         # one module
make COCOTB_TEST_FILTER=test_uart_tx            # tests matching a regex
make SIM_BUILD=/scratch/me/sim_build            # keep build output elsewhere
make WAVES=all                                  # dump the whole hierarchy (slow, large)
make WAVES=none                                 # no waveform
```

Gate level (what the TT `gl_test` action runs after hardening; it copies the
hardened netlist to `test/gate_level_netlist.v`):

```sh
cp /path/to/hardened/tt_um_teslacoilerow_protocol_emulator.v gate_level_netlist.v
make clean
make GATES=yes PDK_ROOT=/path/to/pdk
```

GL mode adds `$(PDK_ROOT)/ihp-sg13cmos5l/libs.ref/sg13cmos5l_{stdcell,io}/verilog`
and the same SRAM behavioral models (the netlist keeps the eight
`RM_IHPSG13_1P_64x16_c2` macros as instances). `GL_NETLIST=path` simulates a
netlist kept elsewhere. The Makefile exports `PE_GATE_LEVEL=1`, which scales the
workload down: 8 of the 25 legacy replays (`GL_SUBSET` in `test_legacy.py`; the
other 17 are reported as SKIP) and 2 random cases (override with `PE_LEGACY=all`
and `PE_RANDOM_ITERS`). Of the gap-closure modules, the tests that need more than
8,000 cycles and the time-warp tests (which need the RTL register names) are
reported as SKIP; 14 of their 27 tests run. The 5 `uart-rx-idle` tests of
`test_flagship.py` are reported as SKIP too. The 2 tests of
`test_wait_limit.py` run with LIMIT up to 2^8 + 2 and no time warp (see
"LIMIT timeouts"). Of the nine `test_spec_*` tests, seven run at gate level
with smaller parameter sets (see "Specification checks"), so 55 of the 118
tests run at gate level. A quick pre-hardening check
is possible with a Yosys netlist (`synth -flatten`, `dfflibmap`/`abc` to the
`sg13cmos5l_stdcell` liberty, SRAM macro read as a blackbox).

## Random lockstep test

`test_random.py` generates `PE_RANDOM_ITERS` independent cases from `PE_SEED`.
Each case assigns disjoint pin ownership (with random open-drain subsets), loads a
random legal program into each engine (NOP/HALT/SET/DIR/WAIT/JMP/PULL/PUSH/OUT/IN/
COUNT/LOOP/LIMIT/WAITPIN/SIGNAL/WAITEVENT/PINS/XFER/MOV/LOAD/ALU/SHL/SHR/JZ/NOT/
TIME/FAULT; computed registers are often pushed, shifted out or branched on so
that differences become observable), prefills TX FIFOs, configures routes and
input triggers, starts the engines and then runs random host traffic: TX writes
under backpressure, RX reads and drains, status reads of every READ_SELECT,
EVENT/ROUTE/STOP/START/CLEAR/FLUSH/TRIGGER/OWN commands (some rejected on
purpose), abandoned partial reads and writes, reprogramming, fault recovery and
deselection. External pins toggle randomly; driven pins loop back. A few
instructions per program are deliberate faults (invalid opcode/operand, pin
ownership, PC range, FAULT n); every fault must carry a code allowed for the
faulting instruction and deliberate ones must carry their annotated code.

Generator generation 2 (the default; `PE_RANDOM_GEN=1` draws the cases of the
2026-09-25 verification campaigns, whose stimulus it reproduces except that the
trailing deselect of 10% of the cases now runs) adds two things from a separate
random stream, so every generation-1 operation is still drawn identically:

- **Deselection inside the traffic.** Generation 1 appended the optional deselect
  (10% of cases) after operations whose estimated cost already filled the
  budget, and `run_case` stopped at the budget, so it ran in about 0.3% of cases.
  It now sits at a random point in the first 70% of the traffic (ena drops while
  engines run; the rest of the case runs on the deselected chip), and
  `run_case` never skips a deselect for the budget. Measured on the model
  (1,088 cases): 107 of 107 deselects run, 99 of them inside the budget and 101
  with engines running (generation 1: 3 inside the budget).
- **Command-rejection sequences.** In 70% of cases one to three sequences the
  first generation never sends: BEGIN with a payload, COMMIT with a wrong, zero
  or oversized length or while not loading, STOP and EVENT naming absent
  engines, ROUTE with payload bits 21 to 23, and aborted or overfull reloads
  (BEGIN of a running engine, START before COMMIT, a 65th program word). The
  model decides acceptance; half of the sequences end with CLEAR bit 23. On the
  default seed all twelve commands are now both accepted and rejected
  (BEGIN/COMMIT/STOP/ROUTE/EVENT rejected 13/23/9/6/7 times).

| variable | default | meaning |
|---|---|---|
| `PE_SEED` | `0x5EED2027` | base seed (`random` picks one and logs it) |
| `PE_RANDOM_ITERS` | 64 (RTL), 2 (GL) | number of cases |
| `PE_RANDOM_FIRST` | 0 | first case index (rerun one case with `PE_RANDOM_ITERS=1`) |
| `PE_RANDOM_CYCLES` | 2000 | host-traffic cycles per case after START |
| `PE_RANDOM_GEN` | 2 | generator generation (1: the campaigns' cases) |
| `PE_MINIMIZE` / `PE_MINIMIZE_BUDGET` | 1 / 60 | shrink a failing case (greedy delta debugging over host ops, engines, setup, instructions); replays are shrunk too |
| `PE_REPLAY` | | run a saved case JSON instead of generating |
| `PE_INJECT_MODEL_BUG` | | `xor`: corrupt the model after XOR, to demonstrate detection and minimization |

On a mismatch the test logs the seed, case index, cycle, the last 24 cycles of
pins, the program listings and host operations, writes
`output/random-failure-seed<seed>-case<n>.json` (and `-min.json` after
minimization) and prints a one-line reproduction command. A functional-coverage
summary (opcodes completed per engine, stall cycles per blocking opcode, faults by
code and instruction, deliberate faults, XFER CPOL/CPHA/bit-order/drive/sample
combinations and bit counts, mover transfers, host commands accepted/rejected,
host traffic) is printed at the end of every run.

## Gap-closure tests

The random and mutation campaigns (`../docs/verification-campaign.md`) showed
what the suite above left unexercised: high counter bits, mover arbitration,
command rejections and a few per-engine corner cases. Four modules close those
gaps; every scenario is an `async def f(h)` on a Harness, so it also runs on the
model alone, and every cycle is still compared with the model.

| module | tests | cycles | what it adds |
|---|---:|---:|---|
| `test_directed.py` | 14 | 75,000 | the twelve directed tests of the mutation campaign (`../campaigns/mutation/directed/`), cleaned up and made variant-independent (queue depth, debug counters, byte-lane shifts), and two from the re-run of its survivors: JMP/LOOP/JZ to targets with each PC bit 6..23 set (fault 2, full target read back) and XFER on every TX pin next to driven pins |
| `test_mover.py` | 1 | 11,000 | six phases: 2, 3 and 4 routes (one a self-route) into one destination whose TX queue is full, so all become eligible on one edge; the destination forwards the words to the host (the grant order is on the read nibbles); host TX words written while routes compete, in two phases built so that every host word meets an eligible route to the same destination. `ArbitrationMonitor` restates the arbitration rule of `../docs/isa.md` and checks every grant and the cursor; the test requires edges with 2, 3 and 4 eligible routes and host-priority collisions |
| `test_counters.py` | 5 | 98,000 | every engine completes more than 2^16 instructions while a 0xFFFF-word route drains and COUNT 0xFFFF/0x7FFF/0x8001 loops run, READ_SELECT 1 and 5 read at checkpoints; ROUTE counts of 0x1A5B/0x1C3D drain exactly and 2^k + 2 counts stay enabled; LIMIT (1 << k) \| 24 for k = 9..23 must not time out early; exact timeouts at LIMIT 1..0x3FF; exact WAIT ends |
| `test_timewarp.py` | 7 | 15,000 simulated | counter carries up to bit 31 and the 2^32 timestamp rollover (below) |

### Time warp

Brute-force simulation reaches about 2^17 cycles in the CI budget; the counters
are 16 to 32 bits wide and the timestamp wraps after 2^32 cycles. The harness
therefore skips time when nothing but counting can happen:

- `h.warp(n)` checks on the model that the next `n` edges are pure counting
  (every engine halted, inside a WAIT that outlasts the skip, blocked in a
  WAITPIN/WAITEVENT short of its LIMIT, or spinning on a JMP/LOOP to itself;
  host idle; static pins already synchronized; no trigger; no DMA move
  possible), advances the model's timestamp, WAIT timers, blocked counts,
  completed counts and repeat counts by that arithmetic, and adds the same
  amounts to the core's registers at the next falling clock edge through the
  simulator. The deposit is relative, so a DUT that had already diverged keeps
  its divergence. Engines whose counters move must all move alike, because
  Hardcaml's de-duplicated register names (`wait_timer`, `wait_timer_0`, ...)
  do not follow the engine index.
- `h.warp_completed(n)` adds `n` to every completed-instruction count (read only
  by READ_SELECT 5 and its own update, so any engine activity may continue).
- `h.warp_routes(n)` takes `n` words off every enabled ROUTE descriptor
  (`route_remaining_<source>`).

Each warp is followed by ordinary lockstep cycles, so each scenario walks a
counter family across every 2^k boundary and then lets it reach an
architectural event on the exact cycle (WAIT end, LIMIT timeout, LOOP exit,
route expiry) or reads it back: `timestamp_rollover` (READ_SELECT 1 and TIME
across 2^16..2^32), `completed_rollover` (READ_SELECT 5 across 2^16..2^32 while
every engine loops through all opcodes), `blocked_paths` (each of 29 ways to
complete an instruction, then a WAITPIN with LIMIT 0xFFFFFF warped to four
cycles short of the limit: a count left behind times the DUT out),
`wait_itinerary` (WAIT 0xFFFFFF), `blocked_itinerary` (LIMIT 0xFFFFFx timeouts
and releases), `repeat_itinerary` (COUNT 0xFFFF) and `route_itinerary` (four
0xFFFF-word routes carrying words around a ring). The warps are white-box
stimulus; the checks stay black-box. They need the RTL register names, so the
module is skipped at gate level; `h.warp_supported()` tells.

## Mutation-kill tests

The `test_kill_*` modules were written from the mutants that survived the
extended suite above (`../docs/mutation-push.md`). Each targets a class of
survivor: a field bit, pin, engine, edge or hold state that no other test
exercised. As everywhere else, every cycle is compared with the model and every
scenario also runs on the model alone. `test_kill_common.py` holds shared helpers
and has no tests.

| module | tests | cycles | what it adds |
|---|---:|---:|---|
| `test_kill_decode.py` | 3 | 134,000 | every operand field bit that must be zero or bounded, and every opcode with bit 5, 6 or 7 added, faults with code 1 on every engine (an own-pin DIR before each case shows each engine's fault on its own output enable); pin-ownership checks against every single unowned pin; FAULT n with twelve codes on every engine |
| `test_kill_blocked.py` | 4 | 28,000 | WAITPIN/WAITEVENT time out on the exact cycle after every way of completing an instruction and every hold state (WAIT, XFER, PULL/PUSH stalls); exact timeouts at LIMIT 2^k and 2^k + 5, WAITPIN and WAITEVENT (time warp) |
| `test_kill_pc.py` | 2 | 28,000 | far JMP/LOOP/JZ targets: a target whose low bits name a word in the image faults with code 2; a STOP on the edge after the jump keeps the whole target in the PC |
| `test_kill_mover.py` | 5 | 27,000 | a routed stream (grant timing on a pin) while the host writes, FLUSHes, re-routes and reads other engines; FLUSH, and a ROUTE rewriting a moving descriptor, landing on a grant edge; FLUSH disabling exactly the routes touching an engine; descriptor counts with high bits set (time warp) |
| `test_kill_regs.py` | 5 | 93,000 | every register observed after every kind of instruction (all-zeros and all-ones); shifter stages into every destination; every ALU operation on every register pair with distinct values; the repeat counter held across WAIT, XFER and a PULL stall; TIME with high timestamp bits (time warp) |
| `test_kill_xfer.py` | 4 | 20,000 | every single-bit and dense half-period; all 32 modes; PINS across WAITs, XFER without drive next to an enabled TX pin, driving XFER with default pins; sampling XFERs after odd and even numbers of instructions since PINS |
| `test_kill_host.py` | 5 | 30,000 | every host command with each must-be-zero payload bit and each opcode bit 4..7; OWN overlaps for every engine pair and pin; images of 64, 47, 33 and 17 words running off their end, and full images ending in COUNT, LIMIT, PINS or TIME; paused status reads |
| `test_kill_events.py` | 2 | 17,000 | pin triggers on every engine, mode and pin; EVENT and SIGNAL with every mask |
| `test_kill_pins.py` | 2 | 35,000 | SET/DIR/OUT and blocked waits on every pin, engine and open-drain mask; driving XFER on every TX pin in every CPHA/bit-order combination |
| `test_kill_edges.py` | 2 | 8,500 | STOP and START landing on the edge where PULL, PUSH, SIGNAL or WAITEVENT would issue; the status word captured on the edge a strict PUSH meets a full queue |
| `test_kill_fifo.py` | 2 | 5,400 | full queues keep their words while the queue's data input changes; commands, program words and TX words written with pauses between nibbles |

The 36 tests add about 0.43 M lockstep cycles to the default run. At gate
level only the ten tests under 5,000 cycles run (`fault_codes`,
`exact_timeout_waitevent`, `flush_on_grant_edge`, `flush_matrix`,
`pins_register`, `own_matrix`, `paused_reads`, `strict_push_status`,
`full_queues`, `paused_writes`); the others, like the time-warp tests, report
SKIP. Several scenarios time a command or a status capture to one clock edge
by consulting the model (`test_kill_pc.command_at`,
`test_kill_edges.snapshot_when`).

## LIMIT timeouts

`test_wait_limit.py` checks the bounded-wait timeout of `../docs/isa.md` (fault
code 3 after LIMIT consecutive unsuccessful samples) at a LIMIT just past each
bit of the blocked-cycle count. Each round loads every engine e with
`DIR 1<<e; LIMIT n; WAITEVENT` (no event arrives) or `DIR 1<<e; LIMIT n;
WAITPIN 7, 1` (pin 7 held low), for n = 2^k + 2 and k = 0..23. On sample 2^k
the count has bit k set for the first time, and the timeout is due two samples
later. An observer reads each engine's output enable (`uio_oe` bit e) from the
DUT before every edge. The enable must stay high for exactly n + 1 edges
(LIMIT's edge and n samples), and each engine's status must then report fault
code 3.

- **Model comparison.** The per-cycle comparison with the model runs as in
  every module. With `PE_SPEC_ONLY=1` it is off for this module, so that only
  the module's own checks can fail; the model still runs and tells the test how
  long to wait.
- **Time warp.** Above n = 16 the count is warped to 2^k − 6, so the sample
  that first sets bit k is simulated. Each test simulates 8,983 cycles
  (8,985 under `PE_VARIANT=diet4`) and warps 16,777,020.
- **Gate level.** The two tests run n up to 2^8 + 2 (k = 0..8) without the
  warp, 3,854 cycles each (3,856 under `diet4`). On the netlists of runs
  36298635436 (8x4) and 36298635404 (6x4, `PE_VARIANT=diet4`) they took
  7.4 s and 4.9 s of the gate-level suite's 111 s and 70 s (jobs
  24382111_4 and 24382111_5).

The module was written after the mutation campaign on the extension branch
found that four mutants of the design-of-record core pass the rest of the
suite. Each flips a bit of the next blocked-cycle count while a higher bit (13,
14, 18 or 21) is set, on the WAITEVENT path of engine 0 or engine 2. The
module fails on each of them, with the lockstep comparison and with
`PE_SPEC_ONLY=1`: the enable is released one edge early at LIMIT 2^13 + 2,
2^14 + 2, 2^18 + 2 or 2^21 + 2. It also fails on survivor 192 of the mutation
push (`../docs/mutation-push.md` section 8).

## Specification checks

The `test_spec_*` modules check behaviour that `../docs/isa.md` specifies and
that the suite above ran without observing it. A held-out mutation sample of the
design of record left 21 such gaps (`../docs/mutation-push.md` sections 9.5 and
10). Each module names the behaviour, not the mutants, and its docstring quotes
the isa.md text it checks. Besides the per-cycle comparison with the model, each
test checks the DUT's pins and read-back words against values that it derives
from isa.md itself (a small interpreter of the instructions used, or the stated
rule), not from the model. With `PE_SPEC_ONLY=1` the comparison with the model is
off, so that only these checks can fail; the model still tells the test when to
act. `test_spec_common.py` holds the shared helpers.

| module | tests | cycles (RTL) | what it checks | gate level |
|---|---:|---:|---|---|
| `test_spec_pin_writes.py` | 2 | 21,060 | OUT changes only its own bit, for every pin p, value v, other pin q and level of q, on every engine; DIR/SET values for eight enable patterns hold through every other kind of instruction, through WAIT and through blocked WAITEVENT, WAITPIN, PULL and PUSH, until HALT releases them. The DUT's (uio_oe, uio_out) runs are compared with the runs isa.md gives for the program | both; the hold test with patterns 0x55 and 0xAA (4,660 cycles) |
| `test_spec_xfer_timing.py` | 1 | 16,320 | XFER a = 1..32 with b = 1, 2, 3 and 4, four engines at once: the clock pin is CPOL on the issue edge, toggles on the edges T + kb (k = 1..2a), and the next instruction issues on edge T + 2ab + 1; checked edge by edge from DUT pins | b = 2 only (3,609 cycles) |
| `test_spec_counters.py` | 2 | 35,497 | the completed-instruction count, at twelve count patterns set with `warp_completed`, read three times at both cycle parities while every engine blocks, stalls, transfers or holds a WAIT, and after a strict overflow; all eight READ_SELECT words after the fault; WAITEVENT and WAITPIN without a LIMIT instruction time out on sample 65,535 after reset and after a START that follows LIMIT 7 (time warp) | the count test as one round without warp (3,644 cycles); the default-LIMIT test is skipped |
| `test_spec_loader.py` | 2 | 7,044 | COMMIT 0 after BEGIN, COMMIT of a length not written, COMMIT of a committed image rejected (fault pin, committed bit), COMMIT of the written length accepted; full-capacity images committed with 0 and 1 extra idle cycles after the last word are accepted and run to the last word | the length test; the full-image test (5,832 cycles) is skipped |
| `test_spec_invalid_encodings.py` | 2 | 38,227 | every undefined opcode one bit from a defined one, with that opcode's valid operands (98 per engine), and FAULT with 33 invalid operands fault with code 1, one engine at a time: fault pin, status 0x10A, and PC and count still 0 | the neighbours of opcodes 30 and 31 and four FAULT operands (2,496 and 1,340 cycles) |

The nine tests add 118,148 simulated cycles to the RTL run (17.2 s of test time
in job 24493924, which shared its node with three other suites; 14.9 s in the
uncontended job 24507279) and 19,825 to the gate-level run (26.7 s of test time on the
netlist of run 36714406904 in the same job, where the other 48 gate-level tests
took 151.5 s). All nine pass on RTL and all seven gate-level tests on that
netlist; under `PE_VARIANT=diet4` with the 6x4 core
(`../variants6x4/protocol_emulator_core.v`) all nine pass (job 24493924). On the
21 mutants of the held-out sample that the 109 tests did not detect, each module
fails where its behaviour differs, with the comparison on and with
`PE_SPEC_ONLY=1` (`../docs/mutation-push.md` section 10).

## Design variants (PE_VARIANT)

The area and reset variants of `../docs/notes/area-study.md` (defined in
`../docs/isa.md`, "Configuration variants") run the same suite:

```sh
make PE_VARIANT=diet4                       # ../build/variants/diet4/protocol_emulator_core.v
make PE_VARIANT=cn PE_CORE=/path/to/cn.v    # a core kept elsewhere
```

| name | reset | queue words | ISA knobs | ISA version |
|---|---|---:|---|---:|
| `base` (default) | `sync` | 8 | none | 2 |
| `rstreg` | `sync_registered` | 8 | none | 2 |
| `cn` | `async` (+ FIFO storage reset, narrow image registers) | 8 | none | 2 |
| `cn_s2` | `async_sync_release` (+ the same) | 8 | none | 2 |
| `diet4` | as `cn_s2` | 4 | no debug counters, 7-bit saturating PC, byte-lane shifts | 3 |
| `diet2` | as `cn_s2` | 2 | as `diet4` | 3 |
| `diet8` | as `cn_s2` | 8 | as `diet4` | 3 |
| `diet8_rec16` | as `cn_s2` | 8 | as `diet4`, plus the line unit (`../docs/extension.md`) | 3 (READ_SELECT 7 = 0x000F5F03) |

`base` is exactly the Tiny Tapeout CI run: the same file list
(`../src/protocol_emulator_core.v`), `sim_build/rtl`, and the verbatim
`model/reference.py`; its random cases and lockstep cycle counts are unchanged.
For any other name:

- **Core and configuration.** The core is `../build/variants/<name>/protocol_emulator_core.v`
  (`scripts/gen_variants.sh`) or `PE_CORE`. The model is configured from
  `../configs/variants/<name>.json`, which must match the independent table
  `variants.SPEC` (checked at import; a mislabelled config fails every test).
- **Firmware images.** The images reassembled for the variant
  (`../build/variants/<name>/firmware`) when present, else `../firmware/`;
  `PE_FIRMWARE=dir` overrides. A variant image must target the variant's
  architecture. `../scripts/gen_variants.sh` writes the 19 built-in images
  and `uart-rx-idle`, the flagship's engine 1, which it reassembles from
  `../firmware/uart-rx-idle.source.json` with the variant's architecture
  (every current variant has the 32-bit datapath it needs; `test_flagship`
  passes 6 of 6 with it under `PE_VARIANT=diet4` and `diet8_rec16`, job
  24303859). These 20 images are valid on every variant (shift counts are
  all 24, targets at most 58).
  The SWD, WS2812B, PS/2 and 1-Wire images are not reassembled:
  `test_protocols_ext.py` loads them from `../firmware/` and skips the tests
  of an image on a design that cannot run it unchanged (another engine
  count, data width, queue depth or issue mode, or a word that the design's
  ISA knobs change: `ps2-host` shifts by 21, which the byte-lane variants
  fault on with code 1). On a byte-lane design `test_ps2_host_restricted`
  checks that fault: 1 pass and 22 skipped on `diet4` (the 6x4 core) and
  `diet2`, 21 pass and 2 skipped on `diet8` and `diet8_rec16` (job
  24391190).
- **Model.** `model/variant.py` subclasses the verbatim reference: queue depth,
  counters, saturating PC, byte-lane faults, ISA version, and the reset
  styles, modelled with the two synchronizer flops explicitly.
- **Reset latency.** `Harness.reset()` idles until a reset still in flight has
  been applied and released (two extra cycles for `rstreg`, `cn_s2`, `diet*`).
  With an asynchronous reset the pre-edge outputs are also checked to be
  released during reset. `test_smoke` checks that write-ready stays low for
  exactly the reset latency after `rst_n` rises.
- **Small queues.** `uart-tx` prefills `min(8, fifo_words)` words; the SPI tests
  top up TX and read MISO words as they arrive; `test_flagship` runs
  `../firmware/flagship-scenario-topup.json` (the host prefills at most
  `fifo_words` words and then polls: top up UART TX, drain SPI RX).
  `PE_FLAGSHIP=topup` forces that scenario on any design, `PE_FLAGSHIP=prefill`
  the original.
- **Random test.** Byte-lane designs draw byte-lane shift counts, 15% of them
  deliberately not a lane (expected fault code 1). Saturating-PC designs make
  8% of jumps and branches target 128 or more. The coverage summary counts
  byte-lane faults and saturated jumps.
- **Legacy replays.** The monorepo workloads are recorded against the variant
  model (`variant_workloads.py`): a host that waits out the reset latency, and
  READ_SELECT 7 checked against the variant's version. Workloads that state a
  base-only fact run an adapted copy (`variant_workloads.ADAPTED`; each is
  cycle-identical to the original under the base configuration) or a live
  substitute (`SUBSTITUTE`):

  | workload | adapted for | change |
  |---|---|---|
  | `dma`, `congestion`, `firmware_i2c_restart`, `firmware_jtag` | queues < 3 words | at most `fifo_words` words before START, the rest after START under backpressure |
  | `random_alu` | byte-lane shifts | shift counts rounded down to a lane |
  | `firmware_i2c_target_write` | queues < 8 words | RX prefilled to `fifo_words` words |
  | `firmware_waveform` | reset latency | TIME compared against the index of the last reset edge |
  | `firmware_flagship`, `firmware_flagship_fast` | queues < 8 words | substituted by the top-up flagship scenario (mode-0 and fast SPI image) |

Gate level works the same way (`make GATES=yes PE_VARIANT=<name> GL_NETLIST=...`),
running the gate-level subset against the variant model. With a synchronous
clear, flip-flops have `RESET_B` tied high and power up X in simulation.
Synthesis may then implement a cleared register's next state as reconvergent
logic that is 0 in hardware but X in simulation (for example
`D = ~(Q | ~Q)` while the clear is active), so the register never leaves X.
One such register was seen in a plain-Yosys netlist of `rstreg`, and it fails
the gate-level read-back of READ_SELECT 5. The asynchronous-reset variants
cannot hit this, because their flip-flops are reset through `RESET_B`.
Whether a netlist has such logic depends on the synthesis script. The
LibreLane-replica netlists (`docs/notes/area-study/scripts/synth3.sh ll66`) of all
six variants, `rstreg` included, pass the gate-level subset
(`docs/notes/variants.md` section 7.2). The hardened netlist that the Tiny Tapeout
`gl_test` runs is a different netlist again.

Model-only (no simulator) runs take the same variable:
`PE_VARIANT=diet2 python3 -c "import harness, scenarios; print(harness.run_model(scenarios.flagship_topup).cycle)"`.

## Line-unit tests

For variants with the line unit (`PE_VARIANT=diet8_rec16`, `../docs/extension.md`)
the Makefile adds three modules to the default list; on every other variant
they are skipped (they are not in the default list either):

| file | content |
|---|---|
| `test_line_unit.py`, `line_scenarios.py` | 12 directed tests: version word, nine catalogued CRC check values, CRC from classic and sampling XFERs, ticker timing formula, TX line coding and RX decoding against independent encoders, arbitration, 43 invalid/valid encodings, LSTAT, START/STOP/reset, ticker sharing, completion points |
| `test_line_demos.py`, `line_demos.py` | the extension study's demos with the `../firmware/ext/` images: 10BASE-T UDP frame (to the first link pulse, 660,000 cycles), CAN node scenarios (including the ACK of received frames) and negative controls, reset in the middle of a CAN frame, USB low-speed IN responder, its rejection of a bad-CRC5, OUT and SETUP token and its EOP, and the absence of an address filter, CRC stream |
| `test_line_random.py`, `line_random.py` | constrained-random line-unit programs on up to four engines; `PE_SEED`, `PE_LINE_RANDOM_ITERS` (default 16), `PE_LINE_RANDOM_FIRST`, `PE_LINE_RANDOM_CYCLES`; logs the functional coverage counted by the model |
| `line_support.py` | encoders, the firmware/ext loader, CRC catalogue model, NRZI/stuffing/CAN/USB/UDP references, the behavioural CAN node |
| `model/line_unit.py` | the reference model of the unit (`LineReference`) |

```sh
make PE_VARIANT=diet8_rec16                                        # 109 + 25 tests
make PE_VARIANT=diet8_rec16 COCOTB_TEST_MODULES=test_line_unit     # directed tests only
```

At gate level the CAN demos are skipped and the 10BASE-T test stops after the
frame (no link pulse), unless `PE_LINE_GL_FULL=1`; the random test runs one
case.

## Model-only development

`ModelHarness` runs the same scenario coroutines against the reference model alone,
without a simulator, for fast iteration:

```sh
cd test
python3 -c "import harness, scenarios; h = harness.run_model(scenarios.flagship); print(h.cycle)"
```

## Waveforms

```sh
gtkwave tb.fst tb.gtkw
```
