TeslaCoilerOW/ttihp-protocol-emulator/tools/timing/cert/results/summary.md

# Timing certificates: ledger

Generated by `ledger.py` from [`summary.json`](summary.json). A firmware image is certified for the sha256 recorded here, on the RTL of its campaign; `ledger.py check` (CI workflow `certs`) fails when a committed image, the RTL, the harness includes or the generator's output no longer match. Method: [`docs/timing-certificates.md`](../../../../docs/timing-certificates.md). Full results per campaign, including superseded ones: [`campaigns/`](campaigns/).

## Campaigns

| campaign | commit | images | `processor_fv.v` sha256 | `src/protocol_emulator_core.v` sha256 | lemmas | equivalence (negative control) |
|---|---|---:|---|---|---|---|
| [c118027](campaigns/c118027.md) | `c118027` | 19 | `2a039bae6eb7` | `26a873db8293` | all met | EQUIVALENT (COUNTEREXAMPLE) |
| [24f31f0](campaigns/24f31f0.md) | `24f31f0` | 19 | `2a039bae6eb7` | `26a873db8293` | all met | EQUIVALENT (COUNTEREXAMPLE) |
| [6a3ea08](campaigns/6a3ea08.md) | `6a3ea08` | 7 | `2a039bae6eb7` | `26a873db8293` | all met | EQUIVALENT (COUNTEREXAMPLE) |

## Certified images

| image | sha256 | campaign | engine | segments | variants | pad events | known-level edges | issue slots | input samples | longest segment | proved | covers | negative controls failed | solver time max / total (s) | certified |
|---|---|---|---:|---:|---:|---:|---:|---:|---:|---:|---:|---:|---:|---:|---|
| `event-transmitter` | `f11bd90b7354` | 24f31f0 | 0 | 2 | 2 | 3 | 3 | 8 | 0 | 34 | 2/2 | 2/2 | 7/7 | 8 / 12 | yes |
| `i2c-read` | `4b95306b018e` | 24f31f0 | 3 | 26 | 28 | 55 | 46 | 174 | 10 | 105 | 26/26 | 26/26 | 9/9 | 32 / 409 | yes |
| `i2c-repeated-start` | `e214326c8d91` | 24f31f0 | 3 | 50 | 53 | 120 | 93 | 368 | 14 | 105 | 50/50 | 50/50 | 9/9 | 47 / 880 | yes |
| `i2c-target-read` | `0e42a5ec5664` | 24f31f0 | 3 | 67 | 70 | 20 | 7 | 159 | 17 | 5 | 67/67 | 67/67 | 7/7 | 5 / 237 | yes |
| `i2c-target-write` | `dc2521c4cec8` | 24f31f0 | 3 | 48 | 49 | 8 | 8 | 104 | 16 | 6 | 48/48 | 48/48 | 6/6 | 6 / 158 | yes |
| `i2c-write` | `000e88914e04` | 24f31f0 | 3 | 25 | 27 | 64 | 46 | 173 | 3 | 105 | 25/25 | 25/25 | 9/9 | 42 / 518 | yes |
| `jtag` | `0d3053480946` | 24f31f0 | 0 | 4 | 4 | 75 | 59 | 65 | 16 | 694 | 4/4 | 4/4 | 9/9 | 527 / 1170 | yes |
| `onewire-master` | `d73670ee0561` | 6a3ea08 | 3 | 6 | 12 | 156 | 60 | 532 | 54 | 80004 | 6/6 | 6/6 | 7/13 (6 undecided) | 118 / 26.9 h | yes |
| `ps2-device` | `e3f9eade4f3c` | 6a3ea08 | 2 | 18 | 31 | 46 | 22 | 1201 | 236 | 4000 | 18/18 | 18/18 | 10/16 (6 undecided) | 118 / 4.2 h | yes |
| `ps2-host` | `742cc4316227` | 6a3ea08 | 2 | 50 | 52 | 18 | 6 | 208 | 11 | 6289 | 50/50 | 50/50 | 7/13 (6 undecided) | 34 / 1.1 h | yes |
| `spi-controller-fast` | `2af6a32c6f35` | 24f31f0 | 2 | 4 | 4 | 57 | 39 | 18 | 16 | 261 | 4/4 | 4/4 | 7/7 | 220 / 370 | yes |
| `spi-controller-mode0` | `547dd70e7f4d` | 24f31f0 | 2 | 4 | 4 | 57 | 39 | 18 | 16 | 517 | 4/4 | 4/4 | 7/7 | 574 / 1132 | yes |
| `spi-controller-mode1` | `8e391b48a4b0` | 24f31f0 | 2 | 4 | 4 | 57 | 39 | 18 | 16 | 517 | 4/4 | 4/4 | 7/7 | 450 / 861 | yes |
| `spi-controller-mode2` | `dcbe33ee2200` | 24f31f0 | 2 | 4 | 4 | 57 | 39 | 18 | 16 | 517 | 4/4 | 4/4 | 7/7 | 732 / 1144 | yes |
| `spi-controller-mode3` | `0297625a7862` | 24f31f0 | 2 | 4 | 4 | 57 | 39 | 18 | 16 | 517 | 4/4 | 4/4 | 7/7 | 425 / 849 | yes |
| `spi-target-mode0` | `150ee2aa1751` | 24f31f0 | 2 | 24 | 24 | 12 | 3 | 63 | 8 | 3 | 24/24 | 24/24 | 5/5 | 4 / 73 | yes |
| `spi-target-mode1` | `cfdf9da7f9cf` | 24f31f0 | 2 | 25 | 25 | 12 | 3 | 64 | 8 | 3 | 25/25 | 25/25 | 5/5 | 4 / 84 | yes |
| `spi-target-mode2` | `0aba7f4ba267` | 24f31f0 | 2 | 24 | 24 | 12 | 3 | 63 | 8 | 3 | 24/24 | 24/24 | 5/5 | 5 / 95 | yes |
| `spi-target-mode3` | `6608fcad71f1` | 24f31f0 | 2 | 25 | 25 | 12 | 3 | 64 | 8 | 3 | 25/25 | 25/25 | 5/5 | 5 / 88 | yes |
| `swd-read` | `9df6386ebb02` | 6a3ea08 | 0 | 6 | 18 | 2864 | 2768 | 1188 | 300 | 6219 | 6/6 | 6/6 | 11/13 (2 undecided) | 96 / 1.8 h | yes |
| `uart-rx` | `473ee6db2311` | 24f31f0 | 1 | 5 | 7 | 0 | 0 | 140 | 36 | 617 | 5/5 | 5/5 | 4/4 | 212 / 329 | yes |
| `uart-rx-idle` | `edf05fc9b683` | 6a3ea08 | 1 | 5 | 9 | 0 | 0 | 98 | 24 | 606 | 5/5 | 5/5 | 8/8 | 152 / 293 | yes |
| `uart-tx` | `632a14d3e7d0` | 24f31f0 | 0 | 3 | 3 | 21 | 3 | 65 | 0 | 643 | 3/3 | 3/3 | 8/8 | 357 / 712 | yes |
| `waveform` | `cd9e96e0f3b8` | 24f31f0 | 0 | 2 | 2 | 34 | 34 | 86 | 0 | 1540 | 2/2 | 2/2 | 9/9 | 653 / 657 | yes |
| `ws2812` | `61157a3dc1e3` | 6a3ea08 | 1 | 3 | 5 | 289 | 97 | 692 | 0 | 16513 | 3/3 | 3/3 | 5/13 (8 undecided) | 34 / 3.1 h | yes |
| `ws2812b-v5` | `bf7ce0d70b51` | 6a3ea08 | 1 | 3 | 5 | 289 | 97 | 692 | 0 | 16513 | 3/3 | 3/3 | 5/13 (8 undecided) | 33 / 3.2 h | yes |
| **total** (26/26 certified) | | | | 441 | 495 | 4395 | 3556 | 6297 | 849 | | 441/441 | 441/441 | 185/221 | | |

## Negative controls not generated

A deliberately wrong analyzer can predict a schedule that contradicts itself on some nodes; no certificate can be written for those, so the control comes from another node the mutation changes (or there is none for that image).

| image | mutation | nodes | reason | control from another node |
|---|---|---|---|---|
| `ps2-device` | open-drain-as-push-pull | n3, n7 | gen_cert: pad timeline mismatch pin5 +2806: 4 vs 2 | yes |

## Superseded records

| image | sha256 | campaign | proved | superseded by | reason |
|---|---|---|---:|---|---|
| `event-transmitter` | `f11bd90b7354` | c118027 | 2/2 | 24f31f0 | re-certified (same image) |
| `i2c-read` | `dc88f88da48a` | c118027 | 36/36 | 24f31f0 | image changed |
| `i2c-repeated-start` | `294755335e99` | c118027 | 58/58 | 24f31f0 | image changed |
| `i2c-target-read` | `0e42a5ec5664` | c118027 | 67/67 | 24f31f0 | re-certified (same image) |
| `i2c-target-write` | `dc2521c4cec8` | c118027 | 48/48 | 24f31f0 | re-certified (same image) |
| `i2c-write` | `1c3f53c377c4` | c118027 | 25/25 | 24f31f0 | image changed |
| `jtag` | `0d3053480946` | c118027 | 4/4 | 24f31f0 | re-certified (same image) |
| `spi-controller-fast` | `2af6a32c6f35` | c118027 | 4/4 | 24f31f0 | re-certified (same image) |
| `spi-controller-mode0` | `547dd70e7f4d` | c118027 | 4/4 | 24f31f0 | re-certified (same image) |
| `spi-controller-mode1` | `8e391b48a4b0` | c118027 | 4/4 | 24f31f0 | re-certified (same image) |
| `spi-controller-mode2` | `dcbe33ee2200` | c118027 | 4/4 | 24f31f0 | re-certified (same image) |
| `spi-controller-mode3` | `0297625a7862` | c118027 | 4/4 | 24f31f0 | re-certified (same image) |
| `spi-target-mode0` | `150ee2aa1751` | c118027 | 24/24 | 24f31f0 | re-certified (same image) |
| `spi-target-mode1` | `cfdf9da7f9cf` | c118027 | 25/25 | 24f31f0 | re-certified (same image) |
| `spi-target-mode2` | `0aba7f4ba267` | c118027 | 24/24 | 24f31f0 | re-certified (same image) |
| `spi-target-mode3` | `6608fcad71f1` | c118027 | 25/25 | 24f31f0 | re-certified (same image) |
| `uart-rx` | `473ee6db2311` | c118027 | 5/5 | 24f31f0 | re-certified (same image) |
| `uart-tx` | `632a14d3e7d0` | c118027 | 3/3 | 24f31f0 | re-certified (same image) |
| `waveform` | `cd9e96e0f3b8` | c118027 | 2/2 | 24f31f0 | re-certified (same image) |
