TeslaCoilerOW/ttihp-protocol-emulator/tools/timing/cert/results/campaigns/6a3ea08.md

# Timing certificates: campaign 6a3ea08 (commit 6a3ea08)

Generated by `summarize.py`; the ledger is [`../summary.json`](../summary.json).

| image | engine | segments | variants | pad events | known-level edges | issue slots | input samples | longest segment | proved | whole-segment BMC | split into chunks | covers | solver time max / total (s) | solvers | Slurm jobs (proofs) |
|---|---:|---:|---:|---:|---:|---:|---:|---:|---:|---:|---:|---:|---:|---|---|
| `onewire-master` | 3 | 6 | 12 | 156 | 60 | 532 | 54 | 80004 | 6/6 | 3 | 3/3 | 6/6 | 118 / 26.9 h | boolector, yices | 24303012, 24303013 |
| `ps2-device` | 2 | 18 | 31 | 46 | 22 | 1201 | 236 | 4000 | 18/18 | 5 | 13/13 | 18/18 | 118 / 4.2 h | boolector, yices | 24303012, 24303013 |
| `ps2-host` | 2 | 50 | 52 | 18 | 6 | 208 | 11 | 6289 | 50/50 | 48 | 2/2 | 50/50 | 34 / 1.1 h | bitwuzla, boolector, yices | 24303012, 24303013 |
| `swd-read` | 0 | 6 | 18 | 2864 | 2768 | 1188 | 300 | 6219 | 6/6 | 4 | 2/2 | 6/6 | 96 / 1.8 h | boolector, yices | 24303012, 24303013 |
| `uart-rx-idle` | 1 | 5 | 9 | 0 | 0 | 98 | 24 | 606 | 5/5 | 5 | 2/2 | 5/5 | 152 / 293 | bmc3, yices | 24303012, 24303017 |
| `ws2812` | 1 | 3 | 5 | 289 | 97 | 692 | 0 | 16513 | 3/3 | 0 | 3/3 | 3/3 | 34 / 3.1 h | boolector, yices | 24303013 |
| `ws2812b-v5` | 1 | 3 | 5 | 289 | 97 | 692 | 0 | 16513 | 3/3 | 0 | 3/3 | 3/3 | 33 / 3.2 h | boolector, yices | 24303013 |
| **total** | | 91 | 132 | 3662 | 3050 | 4611 | 625 | | 91/91 | 65 | 28/28 | 91/91 | | | |

Cover runs: Slurm jobs 24303014, 24333946.

| negative control | image | node | depth | outcome | failed assertions | s | solver | Slurm job |
|---|---|---:|---:|---|---|---:|---|---|
| branch-late | `ps2-device` | 4 | 99 | FAIL (expected) | flow | 4 | yices | 24303015 |
| branch-late | `ps2-device` | 16 | 3006 | NOT_RUN | not run: 3004 steps | - | - | - |
| branch-late | `uart-rx-idle` | 1 | 8 | FAIL (expected) | flow | 4 | yices | 24303015 |
| branch-late | `uart-rx-idle` | 2 | 99 | FAIL (expected) | flow | 4 | yices | 24303015 |
| count-n-iterations | `onewire-master` | 1 | 76256 | NOT_RUN | not run: 76254 steps | - | - | - |
| count-n-iterations | `ps2-device` | 1 | 40 | FAIL (expected) | flow | 16 | yices | 24303015 |
| count-n-iterations | `ps2-host` | 2 | 3 | FAIL (expected) | post_v0 | 4 | yices | 24303015 |
| count-n-iterations | `swd-read` | 1 | 6218 | NOT_RUN | not run: 6216 steps | - | - | - |
| count-n-iterations | `uart-rx-idle` | 0 | 5 | FAIL (expected) | post_v0 | 6 | yices | 24303015 |
| count-n-iterations | `ws2812` | 1 | 16452 | NOT_RUN | not run: 16450 steps | - | - | - |
| count-n-iterations | `ws2812b-v5` | 1 | 16452 | NOT_RUN | not run: 16450 steps | - | - | - |
| issue-late | `onewire-master` | 1 | 80007 | NOT_RUN | not run: 80005 steps | - | - | - |
| issue-late | `ps2-device` | 3 | 99 | FAIL (expected) | flow | 25 | yices | 24303015 |
| issue-late | `ps2-device` | 16 | 3006 | NOT_RUN | not run: 3004 steps | - | - | - |
| issue-late | `ps2-host` | 1 | 6292 | NOT_RUN | not run: 6290 steps | - | - | - |
| issue-late | `swd-read` | 1 | 99 | FAIL (expected) | flow | 51 | yices | 24303015 |
| issue-late | `swd-read` | 2 | 37 | FAIL (expected) | flow | 17 | yices | 24303015 |
| issue-late | `uart-rx-idle` | 2 | 609 | FAIL (expected) | flow | 10 | bmc3 | 24303015 |
| issue-late | `uart-rx-idle` | 2 | 99 | FAIL (expected) | flow | 22 | yices | 24303015 |
| issue-late | `ws2812` | 0 | 15006 | NOT_RUN | not run: 15004 steps | - | - | - |
| issue-late | `ws2812` | 1 | 99 | FAIL (expected) | flow | 13 | yices | 24303015 |
| issue-late | `ws2812b-v5` | 0 | 15006 | NOT_RUN | not run: 15004 steps | - | - | - |
| issue-late | `ws2812b-v5` | 1 | 99 | FAIL (expected) | flow | 11 | yices | 24303015 |
| open-drain-as-push-pull | `onewire-master` | 2 | 3 | FAIL (expected) | pad_v0_p7 | 5 | yices | 24303015 |
| open-drain-as-push-pull | `ps2-device` | 17 | 43 | FAIL (expected) | pad_v0_p5 | 4 | yices | 24303015 |
| open-drain-as-push-pull | `ps2-host` | 23 | 2 | FAIL (expected) | pad_v0_p5 | 4 | yices | 24303015 |
| pad-early | `onewire-master` | 1 | 80006 | NOT_RUN | not run: 80004 steps | - | - | - |
| pad-early | `onewire-master` | 1 | 98 | FAIL (expected) | pad_v0_p7 | 9 | yices | 24303015 |
| pad-early | `ps2-device` | 4 | 98 | FAIL (expected) | pad_v1_p4 | 6 | yices | 24303015 |
| pad-early | `ps2-device` | 16 | 3005 | NOT_RUN | not run: 3003 steps | - | - | - |
| pad-early | `ps2-host` | 1 | 6291 | NOT_RUN | not run: 6289 steps | - | - | - |
| pad-early | `ps2-host` | 1 | 51 | FAIL (expected) | pad_v0_p4 | 31 | yices | 24303015 |
| pad-early | `swd-read` | 0 | 5 | FAIL (expected) | pad_v0_p0 | 6 | yices | 24303015 |
| pad-early | `swd-read` | 1 | 98 | FAIL (expected) | pad_v0_p0 | 21 | yices | 24303015 |
| pad-early | `ws2812` | 0 | 15005 | NOT_RUN | not run: 15003 steps | - | - | - |
| pad-early | `ws2812` | 1 | 98 | FAIL (expected) | pad_v0_p2 | 6 | yices | 24303015 |
| pad-early | `ws2812b-v5` | 0 | 15005 | NOT_RUN | not run: 15003 steps | - | - | - |
| pad-early | `ws2812b-v5` | 1 | 98 | FAIL (expected) | pad_v0_p2 | 5 | yices | 24303015 |
| pad-late | `onewire-master` | 1 | 80006 | NOT_RUN | not run: 80004 steps | - | - | - |
| pad-late | `onewire-master` | 1 | 98 | FAIL (expected) | edge_v0_p7, pad_v0_p7 | 9 | yices | 24303015 |
| pad-late | `ps2-device` | 4 | 98 | FAIL (expected) | edge_v1_p4, pad_v1_p4 | 7 | yices | 24303015 |
| pad-late | `ps2-device` | 16 | 3005 | NOT_RUN | not run: 3003 steps | - | - | - |
| pad-late | `ps2-host` | 1 | 6291 | NOT_RUN | not run: 6289 steps | - | - | - |
| pad-late | `ps2-host` | 1 | 98 | FAIL (expected) | edge_v0_p4, pad_v0_p4 | 38 | yices | 24303015 |
| pad-late | `swd-read` | 1 | 98 | FAIL (expected) | edge_v0_p0, pad_v0_p0 | 32 | yices | 24303015 |
| pad-late | `swd-read` | 4 | 4 | FAIL (expected) | edge_v0_p1, pad_v0_p1 | 7 | yices | 24303015 |
| pad-late | `ws2812` | 0 | 15005 | NOT_RUN | not run: 15003 steps | - | - | - |
| pad-late | `ws2812` | 1 | 98 | FAIL (expected) | edge_v0_p2, pad_v0_p2 | 7 | yices | 24303015 |
| pad-late | `ws2812b-v5` | 0 | 15005 | NOT_RUN | not run: 15003 steps | - | - | - |
| pad-late | `ws2812b-v5` | 1 | 98 | FAIL (expected) | edge_v0_p2, pad_v0_p2 | 8 | yices | 24303015 |
| pad-level | `onewire-master` | 1 | 80006 | NOT_RUN | not run: 80004 steps | - | - | - |
| pad-level | `onewire-master` | 1 | 98 | FAIL (expected) | pad_v0_p7 | 6 | yices | 24303015 |
| pad-level | `ps2-device` | 4 | 98 | FAIL (expected) | pad_v1_p4 | 6 | yices | 24303015 |
| pad-level | `ps2-device` | 16 | 3005 | NOT_RUN | not run: 3003 steps | - | - | - |
| pad-level | `ps2-host` | 1 | 6291 | NOT_RUN | not run: 6289 steps | - | - | - |
| pad-level | `ps2-host` | 1 | 98 | FAIL (expected) | pad_v0_p4 | 25 | yices | 24303015 |
| pad-level | `swd-read` | 1 | 98 | FAIL (expected) | pad_v0_p0 | 21 | yices | 24303015 |
| pad-level | `swd-read` | 4 | 4 | FAIL (expected) | pad_v0_p1 | 5 | yices | 24303015 |
| pad-level | `ws2812` | 0 | 15005 | NOT_RUN | not run: 15003 steps | - | - | - |
| pad-level | `ws2812` | 1 | 98 | FAIL (expected) | pad_v0_p2 | 5 | yices | 24303015 |
| pad-level | `ws2812b-v5` | 0 | 15005 | NOT_RUN | not run: 15003 steps | - | - | - |
| pad-level | `ws2812b-v5` | 1 | 98 | FAIL (expected) | pad_v0_p2 | 4 | yices | 24303015 |
| post-limit | `onewire-master` | 1 | 38 | FAIL (expected) | post_v0 | 24 | yices | 24303015 |
| post-limit | `onewire-master` | 2 | 3 | FAIL (expected) | post_v0 | 4 | yices | 24303015 |
| post-limit | `ps2-device` | 2 | 2 | FAIL (expected) | post_v0 | 3 | yices | 24303015 |
| post-limit | `ps2-device` | 16 | 29 | FAIL (expected) | post_v0 | 18 | yices | 24303015 |
| post-limit | `ps2-host` | 0 | 2 | FAIL (expected) | post_v0 | 5 | yices | 24303015 |
| post-limit | `ps2-host` | 1 | 51 | FAIL (expected) | post_v0 | 32 | yices | 24303015 |
| post-limit | `swd-read` | 1 | 77 | FAIL (expected) | post_v0 | 52 | yices | 24303015 |
| post-limit | `swd-read` | 4 | 4 | FAIL (expected) | post_v0 | 5 | yices | 24303015 |
| post-limit | `uart-rx-idle` | 0 | 5 | FAIL (expected) | post_v0 | 6 | yices | 24303015 |
| post-limit | `uart-rx-idle` | 2 | 32 | FAIL (expected) | post_v0 | 21 | yices | 24303015 |
| post-limit | `ws2812` | 0 | 15005 | NOT_RUN | not run: 15003 steps | - | - | - |
| post-limit | `ws2812` | 1 | 3 | FAIL (expected) | post_v0 | 5 | yices | 24303015 |
| post-limit | `ws2812b-v5` | 0 | 15005 | NOT_RUN | not run: 15003 steps | - | - | - |
| post-limit | `ws2812b-v5` | 1 | 3 | FAIL (expected) | post_v0 | 5 | yices | 24303015 |
| set-two-cycles | `onewire-master` | 0 | 5 | FAIL (expected) | flow | 5 | yices | 24303015 |
| set-two-cycles | `ps2-device` | 1 | 44 | FAIL (expected) | flow | 24 | yices | 24303015 |
| set-two-cycles | `ps2-host` | 1 | 6292 | NOT_RUN | not run: 6290 steps | - | - | - |
| set-two-cycles | `swd-read` | 4 | 5 | FAIL (expected) | flow | 5 | yices | 24303015 |
| set-two-cycles | `ws2812` | 0 | 15006 | NOT_RUN | not run: 15004 steps | - | - | - |
| set-two-cycles | `ws2812b-v5` | 0 | 15006 | NOT_RUN | not run: 15004 steps | - | - | - |
| wait-n-cycles | `onewire-master` | 1 | 79971 | NOT_RUN | not run: 79969 steps | - | - | - |
| wait-n-cycles | `ps2-device` | 16 | 3003 | NOT_RUN | not run: 3001 steps | - | - | - |
| wait-n-cycles | `ps2-host` | 1 | 6289 | NOT_RUN | not run: 6287 steps | - | - | - |
| wait-n-cycles | `uart-rx-idle` | 2 | 598 | FAIL (expected) | flow | 11 | bmc3 | 24303015 |
| wait-n-cycles | `ws2812` | 0 | 15004 | NOT_RUN | not run: 15002 steps | - | - | - |
| wait-n-cycles | `ws2812b-v5` | 0 | 15004 | NOT_RUN | not run: 15002 steps | - | - | - |
| xfer-late-edge | `swd-read` | 1 | 6221 | NOT_RUN | not run: 6219 steps | - | - | - |

Negative controls not generated (the wrong analyzer's schedule contradicts itself on these nodes, so no certificate can be written for them):

| mutation | image | nodes | reason | control from another node |
|---|---|---|---|---|
| open-drain-as-push-pull | `ps2-device` | n3, n7 | gen_cert: pad timeline mismatch pin5 +2806: 4 vs 2 | yes |

| lemma task | outcome | s | solver | Slurm job |
|---|---|---:|---|---|
| `boundary_lemmas` k0 | PASS | 7 | bitwuzla | 24303016 |
| `boundary_lemmas` k1 | PASS | 6 | bitwuzla | 24303016 |
| `boundary_lemmas` k2 | PASS | 6 | bitwuzla | 24303016 |
| `boundary_lemmas` k3 | PASS | 6 | bitwuzla | 24303016 |
| `boundary_lemmas` cover_k0 | PASS | 14 | yices | 24303016 |
| `boundary_lemmas` cover_k1 | PASS | 13 | yices | 24303016 |
| `boundary_lemmas` cover_k2 | PASS | 10 | yices | 24303016 |
| `boundary_lemmas` cover_k3 | PASS | 14 | yices | 24303016 |
| `boundary_lemmas` neg | FAIL (expected) | 5 | yices | 24303016 |
| `sram_lemma` prove | PASS | 3 | pdr | 24303016 |
| `sram_lemma` cover | PASS | 0 | yices | 24303016 |
| `sram_lemma` neg | FAIL (expected) | 1 | yices | 24303016 |
