TeslaCoilerOW/ttihp-protocol-emulator/tools/timing/cert/results/campaigns/24f31f0.md

# Timing certificates: campaign 24f31f0 (commit 24f31f0)

Generated by `summarize.py`; the ledger is [`../summary.json`](../summary.json).

| image | engine | segments | variants | pad events | known-level edges | issue slots | input samples | longest segment | proved | whole-segment BMC | split into chunks | covers | solver time max / total (s) | solvers | Slurm jobs (proofs) |
|---|---:|---:|---:|---:|---:|---:|---:|---:|---:|---:|---:|---:|---:|---|---|
| `event-transmitter` | 0 | 2 | 2 | 3 | 3 | 8 | 0 | 34 | 2/2 | 2 | 0/0 | 2/2 | 8 / 12 | boolector | 24168398 |
| `i2c-read` | 3 | 26 | 28 | 55 | 46 | 174 | 10 | 105 | 26/26 | 26 | 1/1 | 26/26 | 32 / 409 | boolector, yices | 24168398 |
| `i2c-repeated-start` | 3 | 50 | 53 | 120 | 93 | 368 | 14 | 105 | 50/50 | 50 | 2/2 | 50/50 | 47 / 880 | boolector, yices | 24168398 |
| `i2c-target-read` | 3 | 67 | 70 | 20 | 7 | 159 | 17 | 5 | 67/67 | 67 | 0/0 | 67/67 | 5 / 237 | boolector, yices | 24168398 |
| `i2c-target-write` | 3 | 48 | 49 | 8 | 8 | 104 | 16 | 6 | 48/48 | 48 | 0/0 | 48/48 | 6 / 158 | bitwuzla, boolector, yices | 24168398 |
| `i2c-write` | 3 | 25 | 27 | 64 | 46 | 173 | 3 | 105 | 25/25 | 25 | 1/1 | 25/25 | 42 / 518 | boolector, yices | 24168398 |
| `jtag` | 0 | 4 | 4 | 75 | 59 | 65 | 16 | 694 | 4/4 | 4 | 3/3 | 4/4 | 527 / 1170 | bmc3, boolector | 24168398, 24168403 |
| `spi-controller-fast` | 2 | 4 | 4 | 57 | 39 | 18 | 16 | 261 | 4/4 | 4 | 2/2 | 4/4 | 220 / 370 | bmc3, boolector, yices | 24168398, 24168403 |
| `spi-controller-mode0` | 2 | 4 | 4 | 57 | 39 | 18 | 16 | 517 | 4/4 | 4 | 2/2 | 4/4 | 574 / 1132 | bmc3, boolector | 24168398, 24168403 |
| `spi-controller-mode1` | 2 | 4 | 4 | 57 | 39 | 18 | 16 | 517 | 4/4 | 4 | 2/2 | 4/4 | 450 / 861 | bmc3, boolector | 24168398, 24168403 |
| `spi-controller-mode2` | 2 | 4 | 4 | 57 | 39 | 18 | 16 | 517 | 4/4 | 4 | 2/2 | 4/4 | 732 / 1144 | bmc3, boolector, yices | 24168398, 24168403 |
| `spi-controller-mode3` | 2 | 4 | 4 | 57 | 39 | 18 | 16 | 517 | 4/4 | 4 | 2/2 | 4/4 | 425 / 849 | bmc3, boolector, yices | 24168398, 24168403 |
| `spi-target-mode0` | 2 | 24 | 24 | 12 | 3 | 63 | 8 | 3 | 24/24 | 24 | 0/0 | 24/24 | 4 / 73 | boolector, yices | 24168398 |
| `spi-target-mode1` | 2 | 25 | 25 | 12 | 3 | 64 | 8 | 3 | 25/25 | 25 | 0/0 | 25/25 | 4 / 84 | boolector, yices | 24168398 |
| `spi-target-mode2` | 2 | 24 | 24 | 12 | 3 | 63 | 8 | 3 | 24/24 | 24 | 0/0 | 24/24 | 5 / 95 | boolector, yices | 24168398 |
| `spi-target-mode3` | 2 | 25 | 25 | 12 | 3 | 64 | 8 | 3 | 25/25 | 25 | 0/0 | 25/25 | 5 / 88 | boolector, yices | 24168398 |
| `uart-rx` | 1 | 5 | 7 | 0 | 0 | 140 | 36 | 617 | 5/5 | 5 | 2/2 | 5/5 | 212 / 329 | bmc3, boolector | 24168398, 24168403 |
| `uart-tx` | 0 | 3 | 3 | 21 | 3 | 65 | 0 | 643 | 3/3 | 3 | 2/2 | 3/3 | 357 / 712 | bmc3, yices | 24168398, 24168403 |
| `waveform` | 0 | 2 | 2 | 34 | 34 | 86 | 0 | 1540 | 2/2 | 2 | 1/1 | 2/2 | 653 / 657 | bitwuzla, bmc3 | 24168398, 24168403 |
| **total** | | 350 | 363 | 733 | 506 | 1686 | 224 | | 350/350 | 350 | 22/22 | 350/350 | | | |

Cover runs: Slurm jobs 24168400.

| negative control | image | node | depth | outcome | failed assertions | s | solver | Slurm job |
|---|---|---:|---:|---|---|---:|---|---|
| count-n-iterations | `i2c-read` | 3 | 107 | FAIL (expected) | post_v0 | 66 | yices | 24168401 |
| count-n-iterations | `i2c-repeated-start` | 3 | 107 | FAIL (expected) | post_v0 | 70 | yices | 24168401 |
| count-n-iterations | `i2c-target-read` | 4 | 4 | FAIL (expected) | post_v0 | 5 | yices | 24168401 |
| count-n-iterations | `i2c-target-write` | 4 | 4 | FAIL (expected) | post_v0 | 4 | yices | 24168401 |
| count-n-iterations | `i2c-write` | 3 | 107 | FAIL (expected) | post_v0 | 61 | yices | 24168401 |
| count-n-iterations | `jtag` | 0 | 627 | FAIL (expected) | flow | 129 | bmc3 | 24168401 |
| count-n-iterations | `spi-target-mode0` | 1 | 5 | FAIL (expected) | post_v0 | 11 | yices | 24168401 |
| count-n-iterations | `spi-target-mode1` | 1 | 5 | FAIL (expected) | post_v0 | 11 | yices | 24168401 |
| count-n-iterations | `spi-target-mode2` | 1 | 5 | FAIL (expected) | post_v0 | 9 | yices | 24168401 |
| count-n-iterations | `spi-target-mode3` | 1 | 5 | FAIL (expected) | post_v0 | 9 | yices | 24168401 |
| count-n-iterations | `uart-rx` | 0 | 5 | FAIL (expected) | post_v0 | 9 | yices | 24168401 |
| count-n-iterations | `uart-tx` | 1 | 581 | FAIL (expected) | flow | 485 | bmc3 | 24168401 |
| count-n-iterations | `waveform` | 0 | 1446 | FAIL (expected) | flow | 1308 | bmc3 | 24168401 |
| halt-keeps-pins | `waveform` | 1 | 3 | FAIL (expected) | edge_v0_p0, pad_v0_p0 | 7 | yices | 24168401 |
| issue-late | `event-transmitter` | 1 | 37 | FAIL (expected) | flow | 19 | yices | 24168401 |
| issue-late | `i2c-read` | 23 | 37 | FAIL (expected) | flow | 19 | yices | 24168401 |
| issue-late | `i2c-repeated-start` | 46 | 37 | FAIL (expected) | flow | 19 | yices | 24168401 |
| issue-late | `i2c-write` | 14 | 40 | FAIL (expected) | flow | 21 | yices | 24168401 |
| issue-late | `jtag` | 1 | 518 | FAIL (expected) | flow | 454 | bmc3 | 24168401 |
| issue-late | `spi-controller-fast` | 1 | 264 | FAIL (expected) | flow | 153 | bmc3 | 24168401 |
| issue-late | `spi-controller-mode0` | 1 | 520 | FAIL (expected) | flow | 509 | bmc3 | 24168401 |
| issue-late | `spi-controller-mode1` | 1 | 520 | FAIL (expected) | flow | 556 | bmc3 | 24168401 |
| issue-late | `spi-controller-mode2` | 1 | 520 | FAIL (expected) | flow | 571 | bmc3 | 24168401 |
| issue-late | `spi-controller-mode3` | 1 | 520 | FAIL (expected) | flow | 524 | bmc3 | 24168401 |
| issue-late | `uart-rx` | 2 | 620 | FAIL (expected) | flow | 32 | bmc3 | 24168401 |
| issue-late | `uart-tx` | 1 | 646 | FAIL (expected) | flow | 12 | bmc3 | 24168401 |
| issue-late | `waveform` | 0 | 1543 | FAIL (expected) | flow | 9 | bmc3 | 24168401 |
| open-drain-as-push-pull | `i2c-read` | 4 | 72 | FAIL (expected) | pad_v0_p7 | 5 | yices | 24168401 |
| open-drain-as-push-pull | `i2c-repeated-start` | 14 | 43 | FAIL (expected) | pad_v0_p7 | 9 | yices | 24168401 |
| open-drain-as-push-pull | `i2c-target-read` | 24 | 2 | FAIL (expected) | pad_v0_p7 | 5 | yices | 24168401 |
| open-drain-as-push-pull | `i2c-write` | 14 | 39 | FAIL (expected) | pad_v0_p7 | 8 | yices | 24168401 |
| pad-early | `event-transmitter` | 0 | 4 | FAIL (expected) | pad_v0_p0 | 5 | yices | 24168401 |
| pad-early | `i2c-read` | 23 | 36 | FAIL (expected) | pad_v0_p6 | 18 | yices | 24168401 |
| pad-early | `i2c-repeated-start` | 46 | 36 | FAIL (expected) | pad_v0_p6 | 18 | yices | 24168401 |
| pad-early | `i2c-target-read` | 21 | 4 | FAIL (expected) | pad_v0_p6 | 5 | yices | 24168401 |
| pad-early | `i2c-target-write` | 38 | 4 | FAIL (expected) | pad_v0_p6 | 3 | yices | 24168401 |
| pad-early | `i2c-write` | 14 | 39 | FAIL (expected) | pad_v0_p6 | 22 | yices | 24168401 |
| pad-early | `jtag` | 1 | 517 | FAIL (expected) | pad_v0_p0 | 12 | bmc3 | 24168401 |
| pad-early | `spi-controller-fast` | 0 | 5 | FAIL (expected) | pad_v0_p2 | 4 | yices | 24168401 |
| pad-early | `spi-controller-mode0` | 0 | 5 | FAIL (expected) | pad_v0_p2 | 4 | yices | 24168401 |
| pad-early | `spi-controller-mode1` | 0 | 5 | FAIL (expected) | pad_v0_p2 | 4 | yices | 24168401 |
| pad-early | `spi-controller-mode2` | 0 | 5 | FAIL (expected) | pad_v0_p2 | 4 | yices | 24168401 |
| pad-early | `spi-controller-mode3` | 0 | 5 | FAIL (expected) | pad_v0_p2 | 4 | yices | 24168401 |
| pad-early | `uart-tx` | 0 | 4 | FAIL (expected) | pad_v0_p0 | 4 | yices | 24168401 |
| pad-early | `waveform` | 0 | 1542 | FAIL (expected) | pad_v0_p0 | 7 | bmc3 | 24168401 |
| pad-late | `event-transmitter` | 1 | 36 | FAIL (expected) | edge_v0_p0, pad_v0_p0 | 5 | yices | 24168401 |
| pad-late | `i2c-read` | 24 | 38 | FAIL (expected) | edge_v0_p7, pad_v0_p7 | 6 | yices | 24168401 |
| pad-late | `i2c-repeated-start` | 47 | 37 | FAIL (expected) | edge_v0_p7, pad_v0_p7 | 5 | yices | 24168401 |
| pad-late | `i2c-target-read` | 23 | 7 | FAIL (expected) | edge_v0_p7, pad_v0_p7 | 5 | yices | 24168401 |
| pad-late | `i2c-target-write` | 22 | 5 | FAIL (expected) | edge_v0_p7, pad_v0_p7 | 4 | yices | 24168401 |
| pad-late | `i2c-write` | 13 | 71 | FAIL (expected) | edge_v1_p7, pad_v1_p7 | 21 | yices | 24168401 |
| pad-late | `jtag` | 1 | 517 | FAIL (expected) | edge_v0_p0, pad_v0_p0 | 15 | bmc3 | 24168401 |
| pad-late | `spi-controller-fast` | 0 | 5 | FAIL (expected) | edge_v0_p2, pad_v0_p2 | 5 | yices | 24168401 |
| pad-late | `spi-controller-mode0` | 0 | 5 | FAIL (expected) | edge_v0_p2, pad_v0_p2 | 5 | yices | 24168401 |
| pad-late | `spi-controller-mode1` | 0 | 5 | FAIL (expected) | edge_v0_p2, pad_v0_p2 | 5 | yices | 24168401 |
| pad-late | `spi-controller-mode2` | 0 | 5 | FAIL (expected) | edge_v0_p2, pad_v0_p2 | 6 | yices | 24168401 |
| pad-late | `spi-controller-mode3` | 0 | 5 | FAIL (expected) | edge_v0_p2, pad_v0_p2 | 6 | yices | 24168401 |
| pad-late | `spi-target-mode0` | 20 | 5 | FAIL (expected) | edge_v0_p4, pad_v0_p4 | 5 | yices | 24168401 |
| pad-late | `spi-target-mode1` | 20 | 5 | FAIL (expected) | edge_v0_p4, pad_v0_p4 | 5 | yices | 24168401 |
| pad-late | `spi-target-mode2` | 20 | 5 | FAIL (expected) | edge_v0_p4, pad_v0_p4 | 5 | yices | 24168401 |
| pad-late | `spi-target-mode3` | 20 | 5 | FAIL (expected) | edge_v0_p4, pad_v0_p4 | 5 | yices | 24168401 |
| pad-late | `uart-tx` | 1 | 645 | FAIL (expected) | edge_v0_p0, pad_v0_p0 | 9 | bmc3 | 24168401 |
| pad-late | `waveform` | 0 | 1542 | FAIL (expected) | edge_v0_p0, pad_v0_p0 | 9 | bmc3 | 24168401 |
| pad-level | `event-transmitter` | 0 | 4 | FAIL (expected) | pad_v0_p0 | 4 | yices | 24168401 |
| pad-level | `i2c-read` | 23 | 36 | FAIL (expected) | pad_v0_p6 | 17 | yices | 24168401 |
| pad-level | `i2c-repeated-start` | 46 | 36 | FAIL (expected) | pad_v0_p6 | 17 | yices | 24168401 |
| pad-level | `i2c-target-read` | 23 | 7 | FAIL (expected) | pad_v0_p7 | 5 | yices | 24168401 |
| pad-level | `i2c-target-write` | 38 | 4 | FAIL (expected) | pad_v0_p6 | 4 | yices | 24168401 |
| pad-level | `i2c-write` | 4 | 72 | FAIL (expected) | pad_v0_p6 | 15 | yices | 24168401 |
| pad-level | `jtag` | 1 | 517 | FAIL (expected) | pad_v0_p0 | 10 | bmc3 | 24168401 |
| pad-level | `spi-controller-fast` | 0 | 5 | FAIL (expected) | pad_v0_p2 | 4 | yices | 24168401 |
| pad-level | `spi-controller-mode0` | 0 | 5 | FAIL (expected) | pad_v0_p2 | 5 | yices | 24168401 |
| pad-level | `spi-controller-mode1` | 0 | 5 | FAIL (expected) | pad_v0_p2 | 5 | yices | 24168401 |
| pad-level | `spi-controller-mode2` | 0 | 5 | FAIL (expected) | pad_v0_p2 | 4 | yices | 24168401 |
| pad-level | `spi-controller-mode3` | 0 | 5 | FAIL (expected) | pad_v0_p2 | 4 | yices | 24168401 |
| pad-level | `spi-target-mode0` | 3 | 4 | FAIL (expected) | pad_v0_p4 | 5 | yices | 24168401 |
| pad-level | `spi-target-mode1` | 3 | 3 | FAIL (expected) | pad_v0_p4 | 4 | yices | 24168401 |
| pad-level | `spi-target-mode2` | 3 | 4 | FAIL (expected) | pad_v0_p4 | 4 | yices | 24168401 |
| pad-level | `spi-target-mode3` | 3 | 3 | FAIL (expected) | pad_v0_p4 | 4 | yices | 24168401 |
| pad-level | `uart-tx` | 0 | 4 | FAIL (expected) | pad_v0_p0 | 5 | yices | 24168401 |
| pad-level | `waveform` | 0 | 1542 | FAIL (expected) | pad_v0_p0 | 8 | bmc3 | 24168401 |
| post-limit | `event-transmitter` | 0 | 4 | FAIL (expected) | post_v0 | 4 | yices | 24168401 |
| post-limit | `i2c-read` | 2 | 2 | FAIL (expected) | post_v0 | 3 | yices | 24168401 |
| post-limit | `i2c-repeated-start` | 2 | 2 | FAIL (expected) | post_v0 | 3 | yices | 24168401 |
| post-limit | `i2c-target-read` | 1 | 2 | FAIL (expected) | post_v0 | 4 | yices | 24168401 |
| post-limit | `i2c-target-write` | 1 | 2 | FAIL (expected) | post_v0 | 3 | yices | 24168401 |
| post-limit | `i2c-write` | 2 | 2 | FAIL (expected) | post_v0 | 3 | yices | 24168401 |
| post-limit | `jtag` | 2 | 3 | FAIL (expected) | post_v0 | 4 | yices | 24168401 |
| post-limit | `spi-controller-fast` | 2 | 3 | FAIL (expected) | post_v0 | 7 | yices | 24168401 |
| post-limit | `spi-controller-mode0` | 2 | 3 | FAIL (expected) | post_v0 | 7 | yices | 24168401 |
| post-limit | `spi-controller-mode1` | 2 | 3 | FAIL (expected) | post_v0 | 8 | yices | 24168401 |
| post-limit | `spi-controller-mode2` | 2 | 3 | FAIL (expected) | post_v0 | 8 | yices | 24168401 |
| post-limit | `spi-controller-mode3` | 2 | 3 | FAIL (expected) | post_v0 | 7 | yices | 24168401 |
| post-limit | `spi-target-mode0` | 2 | 2 | FAIL (expected) | post_v0 | 6 | yices | 24168401 |
| post-limit | `spi-target-mode1` | 2 | 2 | FAIL (expected) | post_v0 | 7 | yices | 24168401 |
| post-limit | `spi-target-mode2` | 2 | 2 | FAIL (expected) | post_v0 | 6 | yices | 24168401 |
| post-limit | `spi-target-mode3` | 2 | 2 | FAIL (expected) | post_v0 | 6 | yices | 24168401 |
| post-limit | `uart-rx` | 1 | 2 | FAIL (expected) | post_v0 | 6 | yices | 24168401 |
| post-limit | `uart-tx` | 0 | 4 | FAIL (expected) | post_v0 | 4 | yices | 24168401 |
| post-limit | `waveform` | 0 | 1542 | FAIL (expected) | post_v0 | 946 | bmc3 | 24168401 |
| set-two-cycles | `event-transmitter` | 0 | 5 | FAIL (expected) | flow | 5 | yices | 24168401 |
| set-two-cycles | `i2c-read` | 0 | 5 | FAIL (expected) | flow | 6 | yices | 24168401 |
| set-two-cycles | `i2c-repeated-start` | 12 | 77 | FAIL (expected) | flow | 32 | yices | 24168401 |
| set-two-cycles | `i2c-target-read` | 0 | 6 | FAIL (expected) | flow | 6 | yices | 24168401 |
| set-two-cycles | `i2c-target-write` | 0 | 6 | FAIL (expected) | flow | 6 | yices | 24168401 |
| set-two-cycles | `i2c-write` | 0 | 5 | FAIL (expected) | flow | 7 | yices | 24168401 |
| set-two-cycles | `jtag` | 0 | 721 | FAIL (expected) | flow | 12 | bmc3 | 24168401 |
| set-two-cycles | `spi-controller-fast` | 0 | 6 | FAIL (expected) | flow | 5 | yices | 24168401 |
| set-two-cycles | `spi-controller-mode0` | 0 | 6 | FAIL (expected) | flow | 6 | yices | 24168401 |
| set-two-cycles | `spi-controller-mode1` | 0 | 6 | FAIL (expected) | flow | 6 | yices | 24168401 |
| set-two-cycles | `spi-controller-mode2` | 0 | 6 | FAIL (expected) | flow | 6 | yices | 24168401 |
| set-two-cycles | `spi-controller-mode3` | 0 | 6 | FAIL (expected) | flow | 7 | yices | 24168401 |
| set-two-cycles | `spi-target-mode0` | 0 | 6 | FAIL (expected) | flow | 6 | yices | 24168401 |
| set-two-cycles | `spi-target-mode1` | 0 | 6 | FAIL (expected) | flow | 6 | yices | 24168401 |
| set-two-cycles | `spi-target-mode2` | 0 | 6 | FAIL (expected) | flow | 7 | yices | 24168401 |
| set-two-cycles | `spi-target-mode3` | 0 | 6 | FAIL (expected) | flow | 7 | yices | 24168401 |
| set-two-cycles | `uart-tx` | 0 | 5 | FAIL (expected) | flow | 6 | yices | 24168401 |
| set-two-cycles | `waveform` | 0 | 1575 | FAIL (expected) | flow | 10 | bmc3 | 24168401 |
| wait-n-cycles | `event-transmitter` | 1 | 35 | FAIL (expected) | flow | 17 | yices | 24168401 |
| wait-n-cycles | `i2c-read` | 23 | 35 | FAIL (expected) | flow | 18 | yices | 24168401 |
| wait-n-cycles | `i2c-repeated-start` | 46 | 35 | FAIL (expected) | flow | 20 | yices | 24168401 |
| wait-n-cycles | `i2c-write` | 14 | 38 | FAIL (expected) | flow | 21 | yices | 24168401 |
| wait-n-cycles | `jtag` | 0 | 676 | FAIL (expected) | flow | 12 | bmc3 | 24168401 |
| wait-n-cycles | `uart-rx` | 2 | 610 | FAIL (expected) | flow | 43 | bmc3 | 24168401 |
| wait-n-cycles | `uart-tx` | 1 | 635 | FAIL (expected) | flow | 14 | bmc3 | 24168401 |
| wait-n-cycles | `waveform` | 0 | 1510 | FAIL (expected) | flow | 11 | bmc3 | 24168401 |
| xfer-late-edge | `jtag` | 1 | 517 | FAIL (expected) | edge_v0_p0, edge_v0_p1, pad_v0_p0 | 49 | bmc3 | 24168401 |
| xfer-late-edge | `spi-controller-fast` | 1 | 263 | FAIL (expected) | edge_v0_p2, edge_v0_p3, pad_v0_p2 | 20 | bmc3 | 24168401 |
| xfer-late-edge | `spi-controller-mode0` | 1 | 519 | FAIL (expected) | edge_v0_p2, edge_v0_p3, pad_v0_p2 | 45 | bmc3 | 24168401 |
| xfer-late-edge | `spi-controller-mode1` | 1 | 519 | FAIL (expected) | edge_v0_p2, pad_v0_p2 | 51 | bmc3 | 24168401 |
| xfer-late-edge | `spi-controller-mode2` | 1 | 519 | FAIL (expected) | edge_v0_p2, pad_v0_p2 | 46 | bmc3 | 24168401 |
| xfer-late-edge | `spi-controller-mode3` | 1 | 519 | FAIL (expected) | edge_v0_p2, pad_v0_p2 | 43 | bmc3 | 24168401 |

| lemma task | outcome | s | solver | Slurm job |
|---|---|---:|---|---|
| `boundary_lemmas` k0 | PASS | 13 | bitwuzla | 24168402 |
| `boundary_lemmas` k1 | PASS | 13 | bitwuzla | 24168402 |
| `boundary_lemmas` k2 | PASS | 13 | bitwuzla | 24168402 |
| `boundary_lemmas` k3 | PASS | 14 | bitwuzla | 24168402 |
| `boundary_lemmas` cover_k0 | PASS | 18 | yices | 24168402 |
| `boundary_lemmas` cover_k1 | PASS | 18 | yices | 24168402 |
| `boundary_lemmas` cover_k2 | PASS | 18 | yices | 24168402 |
| `boundary_lemmas` cover_k3 | PASS | 18 | yices | 24168402 |
| `boundary_lemmas` neg | FAIL (expected) | 7 | yices | 24168402 |
| `sram_lemma` prove | PASS | 5 | pdr | 24168402 |
| `sram_lemma` cover | PASS | 1 | yices | 24168402 |
| `sram_lemma` neg | FAIL (expected) | 0 | yices | 24168402 |

| RTL mutant | image | certificates run | failed | failed assertions | Slurm jobs |
|---|---|---:|---:|---|---|
| rtl_od_drive_high | `i2c-write` | 26/26 | 0 |  | 24168801 |
| rtl_od_oe_ungated | `i2c-write` | 26/26 | 0 |  | 24168801 |
| rtl_sync_3flop | `uart-rx` | 17/17 | 14 | sample_v0_0, sample_v1_0 | 24168801 |
| rtl_wait_plus1 | `uart-tx` | 15/15 | 14 | flow | 24168801 |
| rtl_xfer_short_tick | `spi-controller-mode0` | 14/14 | 12 | edge_v0_p2, edge_v0_p3, flow, pad_v0_p2 | 24168801 |
