TeslaCoilerOW/ttihp-protocol-emulator/tools/timing/cert/results/campaigns/c118027.md

# Timing certificates: campaign c118027 (commit c118027)

Generated by `summarize.py`; the ledger is [`../summary.json`](../summary.json).

# Timing certificates: results at commit c118027

Generated by `summarize.py` from the campaign's manifests and result files.
Method and interpretation: [`docs/timing-certificates.md`](../../../../../docs/timing-certificates.md).
`summary.json` has the same data per segment and per negative control.
`bmc3_neg_evidence.json` records the four negative controls whose violation
ABC `bmc3` found at the end of a long segment, from the ABC engine log (sby's
counterexample replay through smtbmc was not completed for them).

| image | engine | segments | variants | pad events | known-level edges | issue slots | input samples | longest segment | proved | whole-segment BMC | split into chunks | covers | solver time max / total (s) | solvers | Slurm jobs (proofs) |
|---|---:|---:|---:|---:|---:|---:|---:|---:|---:|---:|---:|---:|---:|---|---|
| `event-transmitter` | 0 | 2 | 2 | 3 | 3 | 8 | 0 | 34 | 2/2 | 2 | 0/0 | 2/2 | 9 / 13 | boolector, yices | 23975821 |
| `i2c-read` | 3 | 36 | 38 | 86 | 68 | 252 | 12 | 106 | 36/36 | 36 | 2/2 | 36/36 | 35 / 591 | boolector, yices | 23975821 |
| `i2c-repeated-start` | 3 | 58 | 62 | 150 | 114 | 424 | 16 | 77 | 58/58 | 58 | 0/0 | 58/58 | 48 / 1200 | boolector, yices | 23975821 |
| `i2c-target-read` | 3 | 67 | 70 | 20 | 7 | 159 | 17 | 5 | 67/67 | 67 | 0/0 | 67/67 | 6 / 246 | bitwuzla, boolector, yices | 23975821 |
| `i2c-target-write` | 3 | 48 | 49 | 8 | 8 | 104 | 16 | 6 | 48/48 | 48 | 0/0 | 48/48 | 5 / 161 | bitwuzla, boolector, yices | 23975821 |
| `i2c-write` | 3 | 25 | 27 | 66 | 48 | 175 | 4 | 106 | 25/25 | 25 | 1/1 | 25/25 | 32 / 416 | bitwuzla, boolector, yices | 23975821 |
| `jtag` | 0 | 4 | 4 | 75 | 59 | 65 | 16 | 694 | 4/4 | 4 | 3/3 | 4/4 | 756 / 1520 | bmc3, boolector, yices | 23975821, 23976555, 23983459, 23988090 |
| `spi-controller-fast` | 2 | 4 | 4 | 57 | 39 | 18 | 16 | 261 | 4/4 | 4 | 2/2 | 4/4 | 305 / 503 | boolector, yices | 23975821, 23983459 |
| `spi-controller-mode0` | 2 | 4 | 4 | 57 | 39 | 18 | 16 | 517 | 4/4 | 4 | 2/2 | 4/4 | 934 / 1836 | yices | 23975821, 23983459 |
| `spi-controller-mode1` | 2 | 4 | 4 | 57 | 39 | 18 | 16 | 517 | 4/4 | 4 | 2/2 | 4/4 | 2281 / 1.0 h | boolector, yices | 23975821, 23983459 |
| `spi-controller-mode2` | 2 | 4 | 4 | 57 | 39 | 18 | 16 | 517 | 4/4 | 4 | 2/2 | 4/4 | 2951 / 1.2 h | boolector, yices | 23975821, 23983459 |
| `spi-controller-mode3` | 2 | 4 | 4 | 57 | 39 | 18 | 16 | 517 | 4/4 | 4 | 2/2 | 4/4 | 876 / 1727 | boolector, yices | 23975821, 23983459 |
| `spi-target-mode0` | 2 | 24 | 24 | 12 | 3 | 63 | 8 | 3 | 24/24 | 24 | 0/0 | 24/24 | 4 / 76 | boolector, yices | 23975821 |
| `spi-target-mode1` | 2 | 25 | 25 | 12 | 3 | 64 | 8 | 3 | 25/25 | 25 | 0/0 | 25/25 | 5 / 88 | bitwuzla, boolector, yices | 23975821 |
| `spi-target-mode2` | 2 | 24 | 24 | 12 | 3 | 63 | 8 | 3 | 24/24 | 24 | 0/0 | 24/24 | 6 / 111 | boolector, yices | 23975821 |
| `spi-target-mode3` | 2 | 25 | 25 | 12 | 3 | 64 | 8 | 3 | 25/25 | 25 | 0/0 | 25/25 | 4 / 79 | boolector, yices | 23975821 |
| `uart-rx` | 1 | 5 | 7 | 0 | 0 | 140 | 36 | 617 | 5/5 | 5 | 2/2 | 5/5 | 1206 / 2412 | boolector, yices | 23975821, 23983459 |
| `uart-tx` | 0 | 3 | 3 | 21 | 3 | 65 | 0 | 643 | 3/3 | 3 | 2/2 | 3/3 | 1495 / 2991 | boolector, yices | 23975821, 23983459 |
| `waveform` | 0 | 2 | 2 | 34 | 34 | 86 | 0 | 1540 | 2/2 | 2 | 1/1 | 2/2 | 759 / 762 | bmc3, yices | 23975821, 23988090 |
| **total** | | 368 | 382 | 796 | 551 | 1822 | 229 | | 368/368 | 368 | 21/21 | 368/368 | | | |

Cover runs: Slurm jobs 23975822, 23983908, 23984832, 23984833, 23984834, 23988106.

| negative control | image | node | depth | outcome | failed assertions | s | solver | Slurm job |
|---|---|---:|---:|---|---|---:|---|---|
| count-n-iterations | `i2c-read` | 3 | 108 | FAIL (expected) | post_v0 | 56 | yices | 23975823 |
| count-n-iterations | `i2c-repeated-start` | 3 | 39 | FAIL (expected) | post_v0 | 22 | yices | 23975823 |
| count-n-iterations | `i2c-target-read` | 4 | 4 | FAIL (expected) | post_v0 | 5 | yices | 23975823 |
| count-n-iterations | `i2c-target-write` | 4 | 4 | FAIL (expected) | post_v0 | 5 | yices | 23975823 |
| count-n-iterations | `i2c-write` | 3 | 108 | FAIL (expected) | post_v0 | 72 | yices | 23975823 |
| count-n-iterations | `jtag` | 0 | 627 | FAIL (expected) | flow | 379 | yices | 23975823 |
| count-n-iterations | `spi-target-mode0` | 1 | 5 | FAIL (expected) | post_v0 | 5 | yices | 23975823 |
| count-n-iterations | `spi-target-mode1` | 1 | 5 | FAIL (expected) | post_v0 | 5 | yices | 23975823 |
| count-n-iterations | `spi-target-mode2` | 1 | 5 | FAIL (expected) | post_v0 | 5 | yices | 23975823 |
| count-n-iterations | `spi-target-mode3` | 1 | 5 | FAIL (expected) | post_v0 | 5 | yices | 23975823 |
| count-n-iterations | `uart-rx` | 0 | 5 | FAIL (expected) | post_v0 | 4 | yices | 23975823 |
| count-n-iterations | `uart-tx` | 1 | 581 | FAIL (expected) | flow | 1082 | yices | 23975823 |
| count-n-iterations | `waveform` | 0 | 1446 | FAIL (expected) | engine log: frame 1444 | 819 | bmc3 | 23989372_0 |
| halt-keeps-pins | `waveform` | 1 | 3 | FAIL (expected) | edge_v0_p0, pad_v0_p0 | 4 | yices | 23975823 |
| issue-late | `event-transmitter` | 1 | 37 | FAIL (expected) | flow | 21 | yices | 23975823 |
| issue-late | `i2c-read` | 21 | 37 | FAIL (expected) | flow | 21 | yices | 23975823 |
| issue-late | `i2c-repeated-start` | 43 | 37 | FAIL (expected) | flow | 22 | yices | 23975823 |
| issue-late | `i2c-write` | 13 | 40 | FAIL (expected) | flow | 24 | yices | 23975823 |
| issue-late | `jtag` | 1 | 518 | FAIL (expected) | flow | 929 | yices | 23983952 |
| issue-late | `spi-controller-fast` | 1 | 264 | FAIL (expected) | flow | 375 | yices | 23975823 |
| issue-late | `spi-controller-mode0` | 1 | 520 | FAIL (expected) | flow | 1216 | yices | 23983952 |
| issue-late | `spi-controller-mode1` | 1 | 520 | FAIL (expected) | flow | 1021 | yices | 23983952 |
| issue-late | `spi-controller-mode2` | 1 | 520 | FAIL (expected) | flow | 1142 | yices | 23983952 |
| issue-late | `spi-controller-mode3` | 1 | 520 | FAIL (expected) | flow | 1134 | yices | 23975823 |
| issue-late | `uart-rx` | 2 | 620 | FAIL (expected) | flow | 60 | yices | 23983952 |
| issue-late | `uart-tx` | 1 | 646 | FAIL (expected) | flow | 39 | yices | 23975823 |
| issue-late | `waveform` | 0 | 1543 | FAIL (expected) | flow | 21 | yices | 23975823 |
| open-drain-as-push-pull | `i2c-read` | 4 | 72 | FAIL (expected) | pad_v0_p7 | 4 | yices | 23975823 |
| open-drain-as-push-pull | `i2c-repeated-start` | 3 | 39 | FAIL (expected) | pad_v0_p7 | 5 | yices | 23975823 |
| open-drain-as-push-pull | `i2c-target-read` | 24 | 2 | FAIL (expected) | pad_v0_p7 | 4 | yices | 23975823 |
| open-drain-as-push-pull | `i2c-write` | 13 | 39 | FAIL (expected) | pad_v0_p7 | 5 | yices | 23975823 |
| pad-early | `event-transmitter` | 0 | 4 | FAIL (expected) | pad_v0_p0 | 4 | yices | 23975823 |
| pad-early | `i2c-read` | 21 | 36 | FAIL (expected) | pad_v0_p6 | 16 | yices | 23975823 |
| pad-early | `i2c-repeated-start` | 43 | 36 | FAIL (expected) | pad_v0_p6 | 17 | yices | 23975823 |
| pad-early | `i2c-target-read` | 21 | 4 | FAIL (expected) | pad_v0_p6 | 4 | yices | 23975823 |
| pad-early | `i2c-target-write` | 38 | 4 | FAIL (expected) | pad_v0_p6 | 4 | yices | 23975823 |
| pad-early | `i2c-write` | 13 | 39 | FAIL (expected) | pad_v0_p6 | 21 | yices | 23975823 |
| pad-early | `jtag` | 1 | 517 | FAIL (expected) | pad_v0_p0 | 17 | yices | 23975823 |
| pad-early | `spi-controller-fast` | 0 | 5 | FAIL (expected) | pad_v0_p2 | 5 | yices | 23975823 |
| pad-early | `spi-controller-mode0` | 0 | 5 | FAIL (expected) | pad_v0_p2 | 4 | yices | 23975823 |
| pad-early | `spi-controller-mode1` | 0 | 5 | FAIL (expected) | pad_v0_p2 | 5 | yices | 23975823 |
| pad-early | `spi-controller-mode2` | 0 | 5 | FAIL (expected) | pad_v0_p2 | 5 | yices | 23975823 |
| pad-early | `spi-controller-mode3` | 0 | 5 | FAIL (expected) | pad_v0_p2 | 4 | yices | 23975823 |
| pad-early | `uart-tx` | 0 | 4 | FAIL (expected) | pad_v0_p0 | 4 | yices | 23975823 |
| pad-early | `waveform` | 0 | 1542 | FAIL (expected) | pad_v0_p0 | 4 | yices | 23975823 |
| pad-late | `event-transmitter` | 1 | 36 | FAIL (expected) | edge_v0_p0, pad_v0_p0 | 5 | yices | 23975823 |
| pad-late | `i2c-read` | 22 | 38 | FAIL (expected) | edge_v0_p7, pad_v0_p7 | 5 | yices | 23975823 |
| pad-late | `i2c-repeated-start` | 44 | 37 | FAIL (expected) | edge_v0_p7, pad_v0_p7 | 5 | yices | 23975823 |
| pad-late | `i2c-target-read` | 23 | 7 | FAIL (expected) | edge_v0_p7, pad_v0_p7 | 5 | yices | 23975823 |
| pad-late | `i2c-target-write` | 22 | 5 | FAIL (expected) | edge_v0_p7, pad_v0_p7 | 3 | yices | 23975823 |
| pad-late | `i2c-write` | 12 | 41 | FAIL (expected) | edge_v0_p6, pad_v0_p6 | 22 | yices | 23975823 |
| pad-late | `jtag` | 1 | 517 | FAIL (expected) | edge_v0_p0, pad_v0_p0 | 19 | yices | 23975823 |
| pad-late | `spi-controller-fast` | 0 | 5 | FAIL (expected) | edge_v0_p2, pad_v0_p2 | 4 | yices | 23975823 |
| pad-late | `spi-controller-mode0` | 0 | 5 | FAIL (expected) | edge_v0_p2, pad_v0_p2 | 5 | yices | 23975823 |
| pad-late | `spi-controller-mode1` | 0 | 5 | FAIL (expected) | edge_v0_p2, pad_v0_p2 | 5 | yices | 23975823 |
| pad-late | `spi-controller-mode2` | 0 | 5 | FAIL (expected) | edge_v0_p2, pad_v0_p2 | 5 | yices | 23975823 |
| pad-late | `spi-controller-mode3` | 0 | 5 | FAIL (expected) | edge_v0_p2, pad_v0_p2 | 5 | yices | 23975823 |
| pad-late | `spi-target-mode0` | 20 | 5 | FAIL (expected) | edge_v0_p4, pad_v0_p4 | 4 | yices | 23975823 |
| pad-late | `spi-target-mode1` | 20 | 5 | FAIL (expected) | edge_v0_p4, pad_v0_p4 | 4 | yices | 23975823 |
| pad-late | `spi-target-mode2` | 20 | 5 | FAIL (expected) | edge_v0_p4, pad_v0_p4 | 3 | yices | 23975823 |
| pad-late | `spi-target-mode3` | 20 | 5 | FAIL (expected) | edge_v0_p4, pad_v0_p4 | 4 | yices | 23975823 |
| pad-late | `uart-tx` | 1 | 645 | FAIL (expected) | edge_v0_p0, pad_v0_p0 | 4 | yices | 23975823 |
| pad-late | `waveform` | 0 | 1542 | FAIL (expected) | edge_v0_p0, pad_v0_p0 | 4 | yices | 23975823 |
| pad-level | `event-transmitter` | 0 | 4 | FAIL (expected) | pad_v0_p0 | 4 | yices | 23975823 |
| pad-level | `i2c-read` | 21 | 36 | FAIL (expected) | pad_v0_p6 | 18 | yices | 23975823 |
| pad-level | `i2c-repeated-start` | 43 | 36 | FAIL (expected) | pad_v0_p6 | 18 | yices | 23975823 |
| pad-level | `i2c-target-read` | 23 | 7 | FAIL (expected) | pad_v0_p7 | 5 | yices | 23975823 |
| pad-level | `i2c-target-write` | 38 | 4 | FAIL (expected) | pad_v0_p6 | 4 | yices | 23975823 |
| pad-level | `i2c-write` | 12 | 41 | FAIL (expected) | pad_v0_p6 | 19 | yices | 23975823 |
| pad-level | `jtag` | 1 | 517 | FAIL (expected) | pad_v0_p0 | 18 | yices | 23975823 |
| pad-level | `spi-controller-fast` | 0 | 5 | FAIL (expected) | pad_v0_p2 | 4 | yices | 23975823 |
| pad-level | `spi-controller-mode0` | 0 | 5 | FAIL (expected) | pad_v0_p2 | 4 | yices | 23975823 |
| pad-level | `spi-controller-mode1` | 0 | 5 | FAIL (expected) | pad_v0_p2 | 4 | yices | 23975823 |
| pad-level | `spi-controller-mode2` | 0 | 5 | FAIL (expected) | pad_v0_p2 | 4 | yices | 23975823 |
| pad-level | `spi-controller-mode3` | 0 | 5 | FAIL (expected) | pad_v0_p2 | 4 | yices | 23975823 |
| pad-level | `spi-target-mode0` | 3 | 4 | FAIL (expected) | pad_v0_p4 | 4 | yices | 23975823 |
| pad-level | `spi-target-mode1` | 3 | 3 | FAIL (expected) | pad_v0_p4 | 3 | yices | 23975823 |
| pad-level | `spi-target-mode2` | 3 | 4 | FAIL (expected) | pad_v0_p4 | 4 | yices | 23975823 |
| pad-level | `spi-target-mode3` | 3 | 3 | FAIL (expected) | pad_v0_p4 | 4 | yices | 23975823 |
| pad-level | `uart-tx` | 0 | 4 | FAIL (expected) | pad_v0_p0 | 4 | yices | 23975823 |
| pad-level | `waveform` | 0 | 1542 | FAIL (expected) | pad_v0_p0 | 4 | yices | 23975823 |
| post-limit | `event-transmitter` | 0 | 4 | FAIL (expected) | post_v0 | 5 | yices | 23975823 |
| post-limit | `i2c-read` | 2 | 2 | FAIL (expected) | post_v0 | 4 | yices | 23975823 |
| post-limit | `i2c-repeated-start` | 1 | 2 | FAIL (expected) | post_v0 | 4 | yices | 23975823 |
| post-limit | `i2c-target-read` | 1 | 2 | FAIL (expected) | post_v0 | 5 | yices | 23975823 |
| post-limit | `i2c-target-write` | 1 | 2 | FAIL (expected) | post_v0 | 4 | yices | 23975823 |
| post-limit | `i2c-write` | 2 | 2 | FAIL (expected) | post_v0 | 4 | yices | 23975823 |
| post-limit | `jtag` | 2 | 3 | FAIL (expected) | post_v0 | 5 | yices | 23975823 |
| post-limit | `spi-controller-fast` | 2 | 3 | FAIL (expected) | post_v0 | 5 | yices | 23975823 |
| post-limit | `spi-controller-mode0` | 2 | 3 | FAIL (expected) | post_v0 | 5 | yices | 23975823 |
| post-limit | `spi-controller-mode1` | 2 | 3 | FAIL (expected) | post_v0 | 5 | yices | 23975823 |
| post-limit | `spi-controller-mode2` | 2 | 3 | FAIL (expected) | post_v0 | 4 | yices | 23975823 |
| post-limit | `spi-controller-mode3` | 2 | 3 | FAIL (expected) | post_v0 | 5 | yices | 23975823 |
| post-limit | `spi-target-mode0` | 2 | 2 | FAIL (expected) | post_v0 | 3 | yices | 23975823 |
| post-limit | `spi-target-mode1` | 2 | 2 | FAIL (expected) | post_v0 | 4 | yices | 23975823 |
| post-limit | `spi-target-mode2` | 2 | 2 | FAIL (expected) | post_v0 | 4 | yices | 23975823 |
| post-limit | `spi-target-mode3` | 2 | 2 | FAIL (expected) | post_v0 | 4 | yices | 23975823 |
| post-limit | `uart-rx` | 1 | 2 | FAIL (expected) | post_v0 | 4 | yices | 23975823 |
| post-limit | `uart-tx` | 0 | 4 | FAIL (expected) | post_v0 | 5 | yices | 23975823 |
| post-limit | `waveform` | 0 | 1542 | FAIL (expected) | engine log: frame 1541 | 891 | bmc3 | 23989005_1 |
| set-two-cycles | `event-transmitter` | 0 | 5 | FAIL (expected) | flow | 4 | yices | 23975823 |
| set-two-cycles | `i2c-read` | 0 | 5 | FAIL (expected) | flow | 4 | yices | 23975823 |
| set-two-cycles | `i2c-repeated-start` | 11 | 74 | FAIL (expected) | flow | 18 | yices | 23975823 |
| set-two-cycles | `i2c-target-read` | 0 | 6 | FAIL (expected) | flow | 4 | yices | 23975823 |
| set-two-cycles | `i2c-target-write` | 0 | 6 | FAIL (expected) | flow | 4 | yices | 23975823 |
| set-two-cycles | `i2c-write` | 0 | 5 | FAIL (expected) | flow | 3 | yices | 23975823 |
| set-two-cycles | `jtag` | 0 | 721 | FAIL (expected) | flow | 4 | yices | 23975823 |
| set-two-cycles | `spi-controller-fast` | 0 | 6 | FAIL (expected) | flow | 4 | yices | 23975823 |
| set-two-cycles | `spi-controller-mode0` | 0 | 6 | FAIL (expected) | flow | 4 | yices | 23975823 |
| set-two-cycles | `spi-controller-mode1` | 0 | 6 | FAIL (expected) | flow | 4 | yices | 23975823 |
| set-two-cycles | `spi-controller-mode2` | 0 | 6 | FAIL (expected) | flow | 4 | yices | 23975823 |
| set-two-cycles | `spi-controller-mode3` | 0 | 6 | FAIL (expected) | flow | 4 | yices | 23975823 |
| set-two-cycles | `spi-target-mode0` | 0 | 6 | FAIL (expected) | flow | 5 | yices | 23975823 |
| set-two-cycles | `spi-target-mode1` | 0 | 6 | FAIL (expected) | flow | 5 | yices | 23975823 |
| set-two-cycles | `spi-target-mode2` | 0 | 6 | FAIL (expected) | flow | 4 | yices | 23975823 |
| set-two-cycles | `spi-target-mode3` | 0 | 6 | FAIL (expected) | flow | 4 | yices | 23975823 |
| set-two-cycles | `uart-tx` | 0 | 5 | FAIL (expected) | flow | 4 | yices | 23975823 |
| set-two-cycles | `waveform` | 0 | 1575 | FAIL (expected) | flow | 4 | yices | 23975823 |
| wait-n-cycles | `event-transmitter` | 1 | 35 | FAIL (expected) | flow | 18 | yices | 23975823 |
| wait-n-cycles | `i2c-read` | 21 | 35 | FAIL (expected) | flow | 18 | yices | 23975823 |
| wait-n-cycles | `i2c-repeated-start` | 43 | 35 | FAIL (expected) | flow | 19 | yices | 23975823 |
| wait-n-cycles | `i2c-write` | 13 | 38 | FAIL (expected) | flow | 18 | yices | 23975823 |
| wait-n-cycles | `jtag` | 0 | 676 | FAIL (expected) | flow | 18 | yices | 23975823 |
| wait-n-cycles | `uart-rx` | 2 | 610 | FAIL (expected) | flow | 65 | yices | 23975823 |
| wait-n-cycles | `uart-tx` | 1 | 635 | FAIL (expected) | flow | 43 | yices | 23975823 |
| wait-n-cycles | `waveform` | 0 | 1510 | FAIL (expected) | flow | 19 | yices | 23975823 |
| xfer-late-edge | `jtag` | 1 | 517 | FAIL (expected) | edge_v0_p0, pad_v0_p0 | 88 | yices | 23975823 |
| xfer-late-edge | `spi-controller-fast` | 1 | 263 | FAIL (expected) | edge_v0_p2, pad_v0_p2 | 39 | yices | 23975823 |
| xfer-late-edge | `spi-controller-mode0` | 1 | 519 | FAIL (expected) | edge_v0_p2, pad_v0_p2 | 106 | yices | 23975823 |
| xfer-late-edge | `spi-controller-mode1` | 1 | 519 | FAIL (expected) | edge_v0_p2, pad_v0_p2 | 109 | yices | 23975823 |
| xfer-late-edge | `spi-controller-mode2` | 1 | 519 | FAIL (expected) | edge_v0_p2, pad_v0_p2 | 103 | yices | 23975823 |
| xfer-late-edge | `spi-controller-mode3` | 1 | 519 | FAIL (expected) | edge_v0_p2, pad_v0_p2 | 83 | yices | 23975823 |

| lemma task | outcome | s | solver | Slurm job |
|---|---|---:|---|---|
| `boundary_lemmas` k0 | PASS | 6 | bitwuzla | 23981752 |
| `boundary_lemmas` k1 | PASS | 6 | bitwuzla | 23981752 |
| `boundary_lemmas` k2 | PASS | 6 | bitwuzla | 23981752 |
| `boundary_lemmas` k3 | PASS | 6 | bitwuzla | 23981752 |
| `boundary_lemmas` cover_k0 | PASS | 10 | yices | 23981752 |
| `boundary_lemmas` cover_k1 | PASS | 9 | yices | 23981752 |
| `boundary_lemmas` cover_k2 | PASS | 9 | yices | 23981752 |
| `boundary_lemmas` cover_k3 | PASS | 9 | yices | 23981752 |
| `boundary_lemmas` neg | FAIL (expected) | 4 | yices | 23981752 |
| `sram_lemma` prove | PASS | 3 | pdr | 23981956 |
| `sram_lemma` cover | PASS | 1 | yices | 23981956 |
| `sram_lemma` neg | FAIL (expected) | 1 | yices | 23981956 |

| RTL mutant | image | certificates run | failed | failed assertions | Slurm jobs |
|---|---|---:|---:|---|---|
| rtl_od_drive_high | `i2c-write` | 26/26 | 0 |  | 23986495 |
| rtl_od_oe_ungated | `i2c-write` | 26/26 | 0 |  | 23986823 |
| rtl_sync_3flop | `uart-rx` | 17/17 | 14 | sample_v0_0, sample_v1_0 | 23986495 |
| rtl_wait_plus1 | `uart-tx` | 15/15 | 14 | flow | 23986495 |
| rtl_xfer_short_tick | `spi-controller-mode0` | 14/14 | 12 | edge_v0_p2, edge_v0_p3, flow, pad_v0_p2 | 23986495 |
