TeslaCoilerOW/ttihp-protocol-emulator/docs/results.md

# Results and how to reproduce them

This page lists every headline number that the repository states. It was
compiled at commit `c118027` (tag `v0.1-hardened`). On 2026-09-26 and
2026-09-27 (UTC) it was updated with:

- the official results of `131e793`, the 20 ns configuration of record from
  `25e331e` until `d76f1cc` (section 2b);
- the local sign-off of the 15 ns configuration p018 (R84), committed in
  `d76f1cc`; its official run (R85), its timing re-analysed at the 50 MHz
  operating clock (R86) and the same knob values run at 20 ns (R88) are in
  section 2d;
- the 6x4 build (section 2c, R80 to R83, R87 and R89);
- the mutation score of `aa07868` (R23c) and the `diet4` mutation rerun
  (R23d).

On 2026-09-28 (UTC) every row was checked again against `24f31f0`, and the
page was updated with:

- the firmware timing report and its validation for the I²C images of
  `fb79f31` (R40b, R41b; R40 and R41 are superseded) and the timing
  certificates (R42);
- the official runs of the later commits of `main` (section 2d) and the
  equivalence checks that GitHub ran on their netlists (R93);
- the equivalence of the formal netlist `processor_fv.v` with `src/`, and
  its identity with the one CI generates (R95);
- the official run of the extension variant on a branch (R94);
- the openXC7 release of 2026-09-27 and the Vivado sign-off of the FPGA
  builds (R60b, R62);
- the outcome of the `formal_depth/` runs that had not finished
  (section 9, item 10).

On 2026-09-29 (UTC) the page was updated for the round of commits from
`4c0753c` to `6a3ea08` (not yet pushed when this was written), with:

- the timing certificates of `24f31f0`, which include the three revised I²C
  images (R42b; R42 is superseded), and the certificates of the seven images added
  in `e64cd6b`, from the campaign on `6a3ea08` (R42c);
- the idle-tolerant UART receiver `uart-rx-idle`, now engine 1 of the
  flagship (R28), and the SWD, WS2812B, PS/2 and 1-Wire images (R29);
- the `pe_timing` report over the 26 images (R40c; R40b is superseded);
- the host library on the switched flagship (R24b) and the Hardcaml
  waveform expect tests (R26b);
- the finished runs of `65cb65c` and `24f31f0` (section 2d) and the
  equivalence checks GitHub ran on their netlists (R93b);
- the official run of a 13.33 ns configuration on a branch, which is not
  the design of record (section 2e, R96).

On 2026-09-30 (UTC) the page was updated with `test/test_wait_limit.py`,
now in the default suite (109 tests; R28b), and with survivor 192 of the
mutation push, which that module kills (section 9, item 18). On 2026-10-01
(UTC) the five `test/test_spec_*` modules were added for the 21 gaps of the
first held-out mutation sample: the default suite has 118 tests (R28c, R23g).

`tools/evidence/check_consistency.py` (the `consistency` workflow) checks
part of this page against the repository on every push: stale statuses,
missing files and workflows, and the `pe_timing` counts
([tools/evidence/README.md](../tools/evidence/README.md)).

A row that a later result replaces is marked **Superseded** and kept, with
its commit and run. Each row gives:

- the claim;
- where the repository states it;
- the evidence, that is, a GitHub Actions run, Slurm job ids, or a result
  file;
- the command that reproduces it, and where that command can run.

Each number was checked against its source when this page was written.
The claims that could not be checked, or that the source no longer supports,
are listed in [section 9](#9-claims-that-are-stale-or-not-fully-substantiated).
What the evidence does not establish is in [limitations.md](limitations.md).
The defects that verification found are in [bug-ledger.md](bug-ledger.md).

**Where a command runs:**

- **CI:** GitHub Actions. Re-run the workflow, or push a commit.
- **Local:** one workstation with the documented toolchain (below).
- **Cluster:** a Slurm cluster. The numbers came from the MIT Engaging
  cluster. Job ids are Slurm ids on that cluster.

`<work dir>` is the cluster work area (`$PE_WORK` in the scripts). Raw
per-seed and per-mutant results stay there and are not in git.

## 1. One-command reproduction

```sh
make reproduce          # scripts/reproduce.sh: the quick tier
make reproduce-full     # scripts/reproduce.sh --full: adds the longer local checks and prints the cluster commands
make reproduce REPRO_ARGS=--parallel     # independent steps run concurrently
scripts/reproduce.sh --list              # step names; --only/--skip select steps
```

The script prints a PASS/FAIL line per step and writes
`build/reproduce/summary.tsv`, with the logs in `build/reproduce/logs/`.
It never writes to `src/`.

| Step | Tier | What it checks | Reproduces |
|---|---|---|---|
| `regen` | quick | `hardcaml/` + `configs/instruction-sram-32.json` regenerates `src/protocol_emulator_core.v` byte for byte (into the work directory) | R10 |
| `lint` | quick | `scripts/lint.sh`: iverilog elaboration, `yosys hierarchy -check` with exactly 8 SRAM macros, `verilator -Wall` | R11 |
| `cocotb` | quick | the cocotb RTL suite (`cd test && make clean && make`); every test must pass | R28b (R28 before `test_wait_limit.py`, R12 at `c118027`) |
| `formal` | quick | 12 of the 16 `formal/` jobs: `reset_safety`, `engine_safety`, `processor_invariants_prove`, `processor_inductive_prove`, `processor_inductive_cover`, `timing_isolation_prove_k0` to `_k3`, `timing_isolation_cover`, and both negative controls | R30 (part) |
| `timing` | quick | `pe_timing report` on `firmware/` equals the committed `tools/timing/report/` byte for byte; the analyzer's unit tests | R40c (R40b at `24f31f0`, R40 at `c118027`) |
| `host` | quick | `python3 -m unittest discover -s host/tests` | R24, R24b |
| `formal-rest` | full | the other 4 `formal/` jobs: `fifo_conservation`, `processor_invariants_bmc`, `processor_inductive_bmc`, `timing_isolation_bmc` | R30 (rest) |
| `peers` | full | `test_ext/` against the vendored third-party peers, RTL | R22 (fixed stimulus, RTL) |
| `variants` | full | `scripts/gen_variants.sh` and its three byte-identity checks | R26 (generation) |
| `hardcaml` | full | `dune test` in `hardcaml/`: the Hardcaml unit tests, `line_test` and, when the `#test ` packages of `scripts/opam-deps.txt` are installed, the waveform expect tests | R26 (Hardcaml tests), R26b |
| `timing-validate` | full | `pe_timing validate` with the scenarios, legacy, event, mutants and margins suites | R41b (base suites; R41 at `c118027`) |
| `gl` | full | the gate-level subset of `test/` on a hardened netlist; runs only when `PDK_ROOT` and `GL_NETLIST` are set | R3 |

**Toolchain.**

- OCaml 5.2.1 with the opam pins in `scripts/opam-deps.txt`. Set
  `OCAML_ENV` to a shell file that puts `dune` on `PATH` if it is not
  already there.
- OSS CAD Suite 2026-07-29: yosys 0.67, sby, yices, bitwuzla and verilator.
- Icarus Verilog 13.0, the build that CI uses, or 14.
- Python 3.10 or later with `test/requirements.txt` (cocotb 2.0.1).

**Measured on a fresh export.** The tiers were run on a fresh `git archive`
export of `c118027`, with the reproduction files of this change
(`scripts/reproduce.sh` and the `Makefile` targets) copied in, as Slurm jobs:

| Job | Tier | Toolchain | CPUs | Result | Wall time |
|---|---|---|---:|---|---:|
| 23974810 | quick, sequential | Icarus 13.0 (the CI build), cocotb 2.0.1, Python 3.12, OSS CAD Suite 2026-07-29, OCaml 5.2.1 | 2 | PASS, all 6 steps | 319 s |
| 23975260 | quick, sequential, `DUNE_CACHE=disabled` (no reuse of earlier OCaml builds) | as 23974810 | 2 | PASS, all 6 steps | 329 s |
| 23974811 | full, `--parallel`, with `PDK_ROOT` (IHP-Open-PDK `2bbec755`, the action's revision) and `GL_NETLIST` (the `tt_submission` netlist of run 36144357821) | Icarus 14, otherwise as above | 8 | PASS, all 12 steps | 1,111 s |

In 23974811 the `gl` step reproduced the official `gl_test` result (R3) on
the CI netlist: 66 tests, 36 pass, 30 skip, 0 fail. With `--parallel`, the
formal lane (`formal`, then `formal-rest`) sets the wall time; its longest
job is `timing_isolation_bmc`. The quick jobs ran an earlier revision of
`scripts/reproduce.sh` that differs from the one in this change only in the
text printed by `--print-cluster`. The job logs and summaries are in
`<work dir>/repro/` (`manifest.json`).

Per-step wall times in seconds:

| Step | 23974810 | 23975260 | 23974811 |
|---|---:|---:|---:|
| regen | 4 | 4 | 4 |
| lint | 1 | 1 | 1 |
| cocotb (66 tests) | 81 | 81 | 98 |
| formal (12 jobs) | 223 | 233 | 269 |
| timing | 1 | 2 | 2 |
| host (69 tests, 4 skipped without MicroPython) | 8 | 8 | 10 |
| formal-rest (4 jobs) | | | 837 |
| peers (65 tests) | | | 78 |
| variants (6 cores) | | | 5 |
| hardcaml (7 test executables at `c118027`; `line_test` and the expect tests were added to `dune test` in `4c0753c`) | | | 28 |
| timing-validate (608 engine runs) | | | 56 |
| gl: 66 tests, 36 pass, 30 skip | | | 87 |

## 2. Official Tiny Tapeout results (`v0.1-hardened`, commit `c118027`)

These were the results of record until `25e331e` changed
`src/config.json`; section 2b gives the 20 ns results that followed, and
section 2d the current 15 ns configuration. Run
[36144357821](https://github.com/TeslaCoilerOW/ttihp-protocol-emulator/actions/runs/36144357821)
is the `gds` workflow on push of `c118027`, started 2026-09-25 13:58 UTC.
The metrics are from `tt_submission/stats/metrics.csv` in that run's
`tt_submission` artifact, whose `commit_id.json` names the same commit and
run. The design is 8x4 tiles at a 20 ns clock (50 MHz), with IHP-Open-PDK
`2bbec755` and LibreLane 3.1.0.dev3.

| # | Claim | Stated in | Evidence | Reproduce |
|---|---|---|---|---|
| R1 | gds PASS | [signoff-history.md](signoff-history.md) (Status, moved from README.md); tag `v0.1-hardened` message | Run 36144357821, job `gds`: success, 1 h 53 min | CI (re-run `gds`). Local mirror of the action: [notes/hardening.md](notes/hardening.md) section 7 and [notes/sweep.md](notes/sweep.md) (cluster) |
| R2 | precheck PASS | [signoff-history.md](signoff-history.md) (Status) | Run 36144357821, job `precheck`: "Precheck passed". KLayout SG13CMOS5L DRC ran for 11,001 s; the zero-area, top-macro-name, forbidden-layer, prBoundary and pin checks also passed | CI. Local: the precheck reproduction in [notes/drc-triage.md](notes/drc-triage.md) section 9 (cluster) |
| R3 | **Superseded by R15** (`131e793`, 102-test suite). gl_test PASS: 66 tests, 36 pass, 30 skip, 0 fail | [signoff-history.md](signoff-history.md) (Status); [test/README.md](../test/README.md) (skips by design) | Run 36144357821, job `gl_test`: `TESTS=66 PASS=36 FAIL=0 SKIP=30` | CI. Local: `scripts/reproduce.sh --only gl` with `PDK_ROOT` and `GL_NETLIST` set to the artifact netlist |
| R4 | **Superseded by R18** (`131e793`: 61.92%). Utilization 58.5% (58.53%; standard cells alone 53.88%) | [signoff-history.md](signoff-history.md) (Status); tag message | `design__instance__utilization` 0.585345, `__stdcell` 0.538803 | CI or local mirror |
| R5 | Route DRC 0, LVS 0, antenna 0 | [signoff-history.md](signoff-history.md) (Status); tag message | `route__drc_errors` 0 (the last detailed-routing iteration, 25, ended at 0); every `design__lvs_*` counter 0; `route__antenna_violation__count` 0, with 84 antenna diodes inserted | CI or local mirror |
| R6 | **Superseded by R16** (`131e793`: typ +7.88, fast +9.31 ns). Setup met at the typical corner at 50 MHz, WS +0.89 ns; at the fast corner WS +6.15 ns | [signoff-history.md](signoff-history.md) (Status); tag message | `timing__setup__ws` typ 0.8854, fast 6.1533; 0 setup violations at typ and fast | CI or local mirror |
| R7 | **Superseded by R16** (`131e793`: slow +2.95 ns, 0 violations). Slow corner (not Tiny Tapeout sign-off) misses setup, WS −8.52 ns | [signoff-history.md](signoff-history.md) (Status); tag message | slow `timing__setup__ws` −8.5171; 2,482 violating endpoints; register-to-register WS −0.116 ns (1 violation). The local mirror with the same configuration (job 23850490) gave identical values for the typical and slow setup slack, the register-to-register slack and the utilization. Its report puts 2,467 of the violations on `rst_n` to a register, 14 on `rst_n` to an output, and the one register-to-register path from `instruction_sram_e2_hi` `A_DOUT[1]` | CI or local mirror |
| R8 | **Superseded by R17** (`131e793`). Hold met at every corner | tag message | hold WS: fast +0.107 ns, typ +0.297 ns, slow +0.629 ns; 0 hold violations | CI or local mirror |
| R9 | 84 Magic illegal overlaps, waived by configuration; Magic DRC not run. `131e793` has 86 (R18); the waiver and `RUN_MAGIC_DRC` false are unchanged | [notes/drc-triage.md](notes/drc-triage.md) sections 4 and 7 | `magic__illegal_overlap__count` 84; `RUN_MAGIC_DRC` false in `src/config.json` since `1e2cfb3` | CI or local mirror |

The same run's `viewer` job failed. It could not create a GitHub Pages
deployment (HTTP 404), because Pages is not enabled for the repository.
That job publishes a preview; it does not check the design. It is why the
`gds` badge shows the workflow as failed.

The push of the tag started a second run on the same commit,
[36188299524](https://github.com/TeslaCoilerOW/ttihp-protocol-emulator/actions/runs/36188299524).
Its `gds`, `precheck` ("Precheck passed") and `gl_test` (`TESTS=66
PASS=36 FAIL=0 SKIP=30`) jobs also passed; its `viewer` job failed in the
same way.

**Other workflows on `c118027`** (all on push, 2026-09-25):

| # | Claim | Evidence | Reproduce |
|---|---|---|---|
| R10 | The committed core is current with `hardcaml/` | `regen` run [36144357930](https://github.com/TeslaCoilerOW/ttihp-protocol-emulator/actions/runs/36144357930): success | Local: `reproduce.sh --only regen`, or `make check-generated` (which rewrites `src/` in place) |
| R11 | Lint is clean: 0 errors, 8 SRAM macros | `test` run [36144357839](https://github.com/TeslaCoilerOW/ttihp-protocol-emulator/actions/runs/36144357839), job `lint`: iverilog OK; yosys OK with 8 macros; `verilator: rc=0 warnings=73 errors=0` (60 COMBDLY, 12 UNUSEDSIGNAL, 1 DECLFILENAME) | Local: `reproduce.sh --only lint` |
| R12 | **Superseded** by the 102-test suite of `aa07868`, which passes on `131e793` (section 2b). cocotb RTL suite: 66 tests pass | Same run, job `test`: `TESTS=66 PASS=66 FAIL=0 SKIP=0` (Icarus 13.0) | Local: `reproduce.sh --only cocotb` |
| R13 | All 16 formal jobs meet their expectation in CI | `formal` run [36144357811](https://github.com/TeslaCoilerOW/ttihp-protocol-emulator/actions/runs/36144357811): the generation job and all 16 matrix jobs succeeded. The longest was `timing_isolation_bmc`, at 8 min 20 s | Local: `reproduce.sh --only formal,formal-rest` |
| R14 | Datasheet builds | `docs` run [36144357954](https://github.com/TeslaCoilerOW/ttihp-protocol-emulator/actions/runs/36144357954): success | CI |

The runs on the tag push (`test` 36188299625, `formal` 36188299526, `regen`
36188299483, `docs` 36188299516) also succeeded.

## 2b. Official Tiny Tapeout results of `131e793` (20 ns configuration of record from `25e331e` until `d76f1cc`)

These were the results of record until `d76f1cc` set `CLOCK_PERIOD` 15 in
`src/config.json` (section 2d). They remain true for `131e793`; `src/` and
`info.yaml` are unchanged from `131e793` to `1e5b1d8`. Run
[36257636798](https://github.com/TeslaCoilerOW/ttihp-protocol-emulator/actions/runs/36257636798)
is the `gds` workflow on push of `131e793`, started 2026-09-26 17:03 UTC. The
metrics are from `tt_submission/stats/metrics.csv` of that run's
`tt_submission` artifact, whose `commit_id.json` names the same commit and
run. Tiles, clock, PDK and LibreLane are as in section 2.

**What changed since `c118027`.** `git diff --stat c118027 131e793 -- src/`
lists only `src/config.json`; `src/project.v`,
`src/protocol_emulator_core.v` and `src/sram_pdn_cfg.tcl` are byte-identical.
`25e331e` set the LibreLane keys of optimizer promotion p010
([notes/optimization.md](notes/optimization.md)): `PL_TARGET_DENSITY_PCT` 60 → 61,
`PL_RESIZER_HOLD_SLACK_MARGIN` 0.1 → 0.15, the `fp8_spread_trk` macro
placement with `FP_MACRO_HORIZONTAL_HALO` 16.48 → 20, and new keys
`PL_TIMING_DRIVEN` true, `PL_RESIZER_SETUP_SLACK_MARGIN` 5.75,
`SYNTH_STRATEGY` "DELAY 4", `MAX_FANOUT_CONSTRAINT` 8,
`DESIGN_REPAIR_MAX_WIRE_LENGTH` 300, `DESIGN_REPAIR_MAX_SLEW_PCT` 35,
`DESIGN_REPAIR_MAX_CAP_PCT` 50, `CTS_MAX_CAP` 0.2, `CTS_OBSTRUCTION_AWARE`
true, `CTS_SINK_CLUSTERING_SIZE` 16 and `GRT_LAYER_ADJUSTMENTS`
[0, 0.2, 0, 0.1, 0].

| # | Claim | Stated in | Evidence | Reproduce |
|---|---|---|---|---|
| R15 | gds, precheck and gl_test PASS on `131e793`; gl_test: 102 tests, 46 pass, 56 skip, 0 fail | [signoff-history.md](signoff-history.md) (Status) | Run 36257636798: job `gds` success, 1 h 51 min; job `precheck` "Precheck passed" (KLayout SG13CMOS5L DRC 10,501 s; the zero-area, top-macro-name, forbidden-layer, prBoundary and pin checks also ran); job `gl_test` `TESTS=102 PASS=46 FAIL=0 SKIP=56`. Job `viewer` failed with "Creating Pages deployment failed" (HTTP 404), as in run 36144357821 | CI |
| R16 | **20 ns result of `131e793`**, superseded as the current configuration by `d76f1cc` (section 2d) and still true for that commit. Setup met at all three corners at 50 MHz: WS typ +7.88, fast +9.31, slow +2.95 ns, with 0 setup-violating endpoints at every corner. The gain over `c118027` (R6, R7) is +6.99, +3.15 and +11.47 ns, from configuration only | [signoff-history.md](signoff-history.md) (Status); [notes/timing-closure.md](notes/timing-closure.md) section 9; [limitations.md](limitations.md) section 2; [info.md](info.md), "Limitations" | `timing__setup__ws` typ 7.8797, fast 9.3075, slow 2.9539; `timing__setup_vio__count` 0 at every corner; slow `timing__setup__tns` 0 (was −9,744.1); slow register-to-register WS +2.954 ns, 0 violations (was −0.116 ns, 1 violation). Arithmetic checked with AXLE (Lean 4, `<work dir>/docs-timing/axle/`) | CI. Local: the promoted full run of p010 (R19) |
| R17 | **20 ns result of `131e793`**, superseded as the current configuration by `d76f1cc` (section 2d) and still true for that commit. Hold met at every corner: fast +0.112, typ +0.318, slow +0.657 ns; 0 hold violations | [signoff-history.md](signoff-history.md) (Status); limitations.md section 2 | `timing__hold__ws` per corner; `timing__hold_vio__count` 0 at every corner; 137 hold buffers (was 10) | CI |
| R18 | **20 ns result of `131e793`**, superseded as the current configuration by `d76f1cc` (section 2d) and still true for that commit. Utilization 61.9% (61.92%; standard cells 57.64%); route DRC 0; LVS 0; antenna 0; 94,248 instances; max-slew / max-cap / max-fan-out violations typ 1/0/3, fast 0/0/3, slow 4/0/3 (were 42/70/524, 13/73/524 and 290/70/524); 86 Magic illegal overlaps, waived as in R9 | [signoff-history.md](signoff-history.md) (Status); limitations.md sections 2 and 5 | `design__instance__utilization` 0.619173, `__stdcell` 0.576428; `route__drc_errors` 0 (the last detailed-routing iteration, 17, ended at 0); every `design__lvs_*` counter 0; `route__antenna_violation__count` 0, with 25 antenna diodes; `design__instance__count` 94,248 (41,005 standard cells); `design__max_{slew,cap,fanout}_violation__count__corner:*`; `magic__illegal_overlap__count` 86 | CI |
| R19 | **20 ns result of `131e793`**, superseded as the current configuration by `d76f1cc` (section 2d) and still true for that commit. The local prediction matched: the promoted full run of p010 produced a `metrics.csv` byte-identical to that of run 36257636798 and the same gate-level netlist; its fast-mode trial gave the same setup and hold slack at all three corners, utilization, instance count and slew/cap/fan-out counts | [notes/optimization.md](notes/optimization.md), "Starting point" | Trial `dor-26a873-c8bf57e#94`, job 24009268 (fast mode, 32 threads); promotion p010: full run job 24010051 (`OPENROAD_THREADS` 4, LVS 0), precheck job 24011934 (9/9), gate-level job 24011935 (102 tests, 46 pass, 56 skip, 0 fail). `cmp` of the full run's `out/metrics.csv` with the artifact's: identical; netlist sha256 `8ce27ccc…` for both the artifact's `tt_um_teslacoilerow_protocol_emulator.v` and the run's `final/nl`. The trial was compared field by field from `<work dir>/optimizer/store/events.jsonl`. Record: `<work dir>/docs-timing/artifact_comparisons.out` | Cluster: [notes/optimization.md](notes/optimization.md), "Operation" |
| R84 | Optimizer promotion p018 passes the local sign-off at 15 ns (66.7 MHz): full run legal with LVS 0 and route DRC 0; setup WS typ +5.95, fast +6.92, slow +2.24 ns at 15 ns with 0 violations; hold WS min +0.165 ns (fast); utilization 65.30%; precheck 9/9; gate level 102 tests, 46 pass, 56 skip, 0 fail. It differed from the `src/config.json` of `131e793` in four keys: `CLOCK_PERIOD` 15, `DESIGN_REPAIR_MAX_CAP_PCT` 45, `GRT_LAYER_ADJUSTMENTS` [0, 0.2, 0.2, 0.1, 0], `PL_RESIZER_SETUP_SLACK_MARGIN` 5.8. **Committed since `d76f1cc`**, which sets exactly these four keys; `info.yaml` `clock_hz` stays 50000000 (the operating clock). The official run of `d76f1cc` is R85. (Until `d76f1cc` this row read: "Not committed and not built by CI; the design of record stays 20 ns / 50 MHz".) | [signoff-history.md](signoff-history.md) (Status); [notes/optimization.md](notes/optimization.md), "Current results" and "Adoption of p018"; [limitations.md](limitations.md) section 2; [info.md](info.md), "Limitations"; [notes/timing-closure.md](notes/timing-closure.md) section 10 | Trial `dor15-26a873-8x4-p15-f174dc0#1`, job 24024343 (fast mode, same setup WS); full run job 24042265 (`OPENROAD_THREADS` 4; `out/metrics.csv`: `timing__setup__ws__corner:*` 5.9499 / 6.9240 / 2.2400, `timing__hold__ws` 0.1650, `design__instance__utilization` 0.653002, `route__drc_errors` 0, `design__lvs_net_difference__count` 0); precheck job 24053971 (9/9; its submission-like directory carries the snapshot's `info.yaml` with `clock_hz` 66666667, which the precheck does not read); gate-level job 24053972. The run's `params.json` `config_changes_vs_repo` lists exactly the four keys (the placement, `MACROS`, is equal and so not listed); `git show d76f1cc -- src/config.json` changes the same four keys | Cluster: [notes/optimization.md](notes/optimization.md), "Operation" |

**Other workflows on `131e793`** (all on push, 2026-09-26): `test`
[36257636760](https://github.com/TeslaCoilerOW/ttihp-protocol-emulator/actions/runs/36257636760)
(job `lint` success; job `test` `TESTS=102 PASS=102 FAIL=0 SKIP=0`),
`formal` 36257636810 (the generation job and all 16 matrix jobs succeeded),
`regen` 36257636763 and `docs` 36257636924 all succeeded.

**Later commits.** `f0e9c19`, `4bd30c8`, `8a05de7`, `24b807b`, `fdc23f2`,
`d733cef` and `1e5b1d8` do not change `src/`.

- **`4bd30c8`.** `test` 36274474552, `regen` 36274474544, `docs`
  36274474541 and `formal` 36274474545 (all 17 jobs) succeeded. In `gds`
  36274474548 the jobs `gds`, `gl_test` (`TESTS=102 PASS=46 FAIL=0
  SKIP=56`) and `precheck` ("Precheck passed", finished 2026-09-27 01:57
  UTC) succeeded; `viewer` failed as in every run. The first version of
  this paragraph, written at about 2026-09-27 01:26 UTC for `1e5b1d8`,
  recorded the precheck as still running and gave the time as 01:40 UTC.
- **`1e5b1d8`** (pushed 2026-09-27 01:26 UTC). `test` 36285537637, `formal`
  36285537631 (all 17 jobs), `regen` 36285537627 and `docs` 36285537639
  succeeded. In `gds` 36285537636 the jobs `gds` (1 h 49 min) and `gl_test`
  (`TESTS=102 PASS=46 FAIL=0 SKIP=56`) succeeded and `viewer` failed; its
  `precheck` passed ("Precheck passed", finished 2026-09-27 06:41 UTC).
  `gds_6x4` 36285537630 passed all five jobs (R87).
- **`d76f1cc`** (pushed 2026-09-27 05:56 UTC) sets the 15 ns configuration
  in `src/config.json` (section 2d). `test` 36298635420 (job `lint` success;
  job `test` `TESTS=102 PASS=102 FAIL=0 SKIP=0`), `formal` 36298635454 (all
  17 jobs), `regen` 36298635381 and `docs` 36298635413 succeeded. `gds`
  36298635436 (R85) passed: job `gds` 05:56 to 10:20 UTC (4 h 24 min),
  `gl_test` and `precheck` (finished 13:33 UTC); `viewer` failed as
  always (Pages is not enabled). In `gds_6x4` 36298635404 the jobs
  `core_current`, `rtl_test`, `gds` and `gl_test` (`TESTS=102 PASS=46
  FAIL=0 SKIP=56`) and `precheck` ("Precheck passed") succeeded, with
  metrics byte-identical to the earlier 6x4 runs (section 2c).
- **`f511c97`** changes only `tools/opt/driver.py` and `tools/opt/tracks.py`
  (the optimizer's track weights; [notes/optimization.md](notes/optimization.md),
  "Allocation"). It has no CI run of its own: it was pushed together with
  `62f1ad6` and `4c30622`, and GitHub ran the workflows on `4c30622` only
  (section 2d).

## 2c. The 6x4 fallback build (`.github/workflows/gds_6x4.yaml`)

The workflow builds the `diet4` core on 6x4 tiles with
`variants6x4/config.overlay.json` merged into `src/config.json`
([notes/6x4.md](notes/6x4.md)). It has its own `tt_submission` artifact. The slow corner
is reported and not signed off, as for 8x4.

| # | Claim | Stated in | Evidence | Reproduce |
|---|---|---|---|---|
| R80 | **Superseded by R82 and R83** (configuration of `4bd30c8`). The pre-adoption 6x4 configuration (notes/6x4.md section 4) passed `gds`, `precheck` and `gl_test` in CI with its local sign-off numbers: setup WS typ +4.30, fast +8.50, slow −2.80 ns (467 violating endpoints at slow); hold WS min +0.099 ns; utilization 56.28% (standard cells 49.45%); route DRC 0; LVS 0 | [notes/6x4.md](notes/6x4.md) section 5b | Runs 36225500529 (`be7dbda`) and 36238342669 (`39d21e8`): all five jobs succeeded; `gl_test` `TESTS=102 PASS=46 FAIL=0 SKIP=56` and "Precheck passed" in both. The two artifacts' `metrics.csv` files are byte-identical, and equal to that of the local sign-off run 23980402_9 (notes/6x4.md section 3) | CI |
| R81 | `gds_6x4` failed on `131e793`, because the overlay set placement, obstruction, density and halo but no timing key, and so inherited the p010 timing keys of `src/config.json` | notes/6x4.md section 5b; [notes/optimization.md](notes/optimization.md), "Starting point" | Run 36257636751, job `gds` (4 h 10 min): `Checker.TrDRC` "69 Routing DRC errors found" (deferred), `Checker.IllegalOverlap` 73 (warning), Netgen LVS "Top level cell failed pin matching" (28,200 against 28,212 nets), then LibreLane stopped on a `JSONDecodeError` ("Invalid \escape") reading Netgen's output: "harden failed". `precheck` and `gl_test` were skipped; `core_current` and `rtl_test` (`TESTS=102 PASS=102`) passed. The same configuration locally: trial `diet4_6x4` #0 (job 24024332, fast mode) route DRC 69; control promotion p012, full run 24029191, route DRC 69 and stopped in `Netgen.LVS` | CI; cluster |
| R82 | Optimizer promotion p014 (trial `diet4_6x4` #8) passes the local sign-off: full run legal with LVS 0, route DRC 0 and antenna 0; setup WS typ +7.71, fast +10.52, slow +2.74 ns; hold WS min +0.051 ns (fast); utilization 58.90%; precheck 9/9; gate level 102 tests, 46 pass, 56 skip, 0 fail. `4bd30c8` puts it into the overlay, and the merged configuration equals the run's key for key | notes/6x4.md section 4b; commit message of `4bd30c8` | Trial job 24032431 (fast mode, same setup WS); full run job 24036160; precheck job 24041156 (`promotions/p014-diet4_6x4/precheck/result.json`: 9 checks, 0 fail); gate-level job 24041157 (`gl/result.json`, `PE_VARIANT` diet4). Key comparison: `<work dir>/docs-timing/check_overlay_equals_p014.py`, 0 differences over 47 keys (`OPENROAD_THREADS` excluded) | Cluster |
| R83 | The official `gds_6x4` run of `4bd30c8` passed `gds`, `precheck` and `gl_test` with the p014 configuration (R82): setup WS typ +7.71, fast +10.52, slow +2.74 ns, 0 setup and 0 hold violations; hold WS min +0.051 ns (fast); utilization 58.90% (standard cells 52.48%); route DRC 0; LVS 0; antenna 0. The artifact's `metrics.csv` is byte-identical to that of the local full run 24036160 | [notes/6x4.md](notes/6x4.md) sections 4b and 5b; [signoff-history.md](signoff-history.md) ("Tile size"); [limitations.md](limitations.md) section 5 | Run [36274474540](https://github.com/TeslaCoilerOW/ttihp-protocol-emulator/actions/runs/36274474540): all five jobs succeeded; `gl_test` `TESTS=102 PASS=46 FAIL=0 SKIP=56`; "Precheck passed" (KLayout DRC 5,919 s). `tt_submission` artifact `stats/metrics.csv` (`timing__setup__ws` 2.7368, per corner typ 7.7060, fast 10.5185, slow 2.7368; `timing__hold__ws` 0.0513; `design__instance__utilization` 0.58896; `route__drc_errors` 0; `design__lvs_net_difference__count` 0; `antenna__violating__nets` 0); `cmp` with the full run's `metrics.csv` reports no difference | CI |
| R87 | The `gds_6x4` run of `1e5b1d8`, after `8a05de7` and `fdc23f2` made the overlay state every flow knob key and `clock_hz`, passed all five jobs, and its `metrics.csv` is byte-identical to that of run 36274474540 (`4bd30c8`, R83) | [notes/6x4.md](notes/6x4.md) section 5b; [signoff-history.md](signoff-history.md) ("Tile size") | Run [36285537630](https://github.com/TeslaCoilerOW/ttihp-protocol-emulator/actions/runs/36285537630): `core_current`, `rtl_test` (`TESTS=102 PASS=102 FAIL=0 SKIP=0`), `gds`, `precheck` ("Precheck passed") and `gl_test` (`TESTS=102 PASS=46 FAIL=0 SKIP=56`) succeeded. The `tt_submission` artifact's `commit_id.json` names `1e5b1d8` and the run; `cmp` of its `stats/metrics.csv` with that of run 36274474540 reports no difference (artifact in `<work dir>/ci-artifacts/36285537630/`) | CI |
| R89 | The `gds_6x4` run of `d76f1cc` passed all five jobs, with a `metrics.csv` and gate-level netlist byte-identical to those of runs 36285537630 and 36274474540: the 15 ns `CLOCK_PERIOD` of `d76f1cc` does not reach the 6x4 build, which stays signed off at 20 ns | [signoff-history.md](signoff-history.md) ("Tile size"); [notes/6x4.md](notes/6x4.md) section 5b; [limitations.md](limitations.md) sections 2 and 5 | Run [36298635404](https://github.com/TeslaCoilerOW/ttihp-protocol-emulator/actions/runs/36298635404): `core_current`, `rtl_test`, `gds`, `gl_test` (`TESTS=102 PASS=46 FAIL=0 SKIP=56`) and `precheck` ("Precheck passed", 08:37 UTC) succeeded. `commit_id.json` names `d76f1cc`; `cmp` of `stats/metrics.csv` with runs 36285537630 and 36274474540 and of the netlist with both: no difference (artifact in `<work dir>/ci-artifacts/36298635404/`). `switch.py apply` on exports of `1e5b1d8` and `d76f1cc`: byte-identical `src/` and `info.yaml` (`<work dir>/docs-15ns/check_6x4_merged.out`) | CI |

The official `gds_6x4` run of `4bd30c8`
([36274474540](https://github.com/TeslaCoilerOW/ttihp-protocol-emulator/actions/runs/36274474540))
confirmed R82 with byte-identical metrics (R83). `8a05de7` then made the
overlay state every flow knob key without changing the merged
configuration (section 9, item 13).

The run of `1e5b1d8` confirmed that with byte-identical metrics (R87).
`d76f1cc` changes `CLOCK_PERIOD` in `src/config.json` to 15, but the overlay
pins `CLOCK_PERIOD` 20 and every other knob key, and
`variants6x4/info.overlay.json` pins `clock_hz` 50000000. `switch.py apply`
on exports of `1e5b1d8` and `d76f1cc` writes a byte-identical
`src/config.json`, `info.yaml` and `src/` (sha256 of each file in
`<work dir>/docs-15ns/check_6x4_merged.out`), so the 6x4 build is
unchanged and is signed off at 20 ns (50 MHz) only. In its `gds_6x4` run
on `d76f1cc`, 36298635404, `core_current`, `rtl_test` and `gds` passed; the
`tt_submission` `commit_id.json` names `d76f1cc`, and its
`stats/metrics.csv` and gate-level netlist are byte-identical to those of
runs 36285537630 and 36274474540 (`cmp`; artifact in
`<work dir>/ci-artifacts/36298635404/`). Its `gl_test` (`TESTS=102 PASS=46
FAIL=0 SKIP=56`) and `precheck` ("Precheck passed", finished 2026-09-27
08:37 UTC) passed, so the run passed all five jobs.

## 2d. The 15 ns sign-off of `d76f1cc` (current configuration)

`d76f1cc` puts optimizer promotion p018 (R84) into `src/config.json`:
`CLOCK_PERIOD` 15 (66.7 MHz), `DESIGN_REPAIR_MAX_CAP_PCT` 45,
`GRT_LAYER_ADJUSTMENTS` [0, 0.2, 0.2, 0.1, 0] and
`PL_RESIZER_SETUP_SLACK_MARGIN` 5.8; every other key is p010's
([notes/timing-closure.md](notes/timing-closure.md) section 10). `info.yaml` `clock_hz`
stays 50000000: the operating clock is 50 MHz, which the firmware, the
host library, `pe_timing` and the datasheet assume. The RTL is
byte-identical to `c118027`. Tiles, PDK and LibreLane are as in section 2.

| # | Claim | Stated in | Evidence | Reproduce |
|---|---|---|---|---|
| R85 | Official `gds`, `precheck` and `gl_test` of `d76f1cc`, the first official build at 15 ns, all PASS: setup WS typ +5.95, fast +6.92, slow +2.24 ns at 15 ns with 0 setup violations; hold WS min +0.165 ns (fast) with 0 hold violations; utilization 65.30%; route DRC 0; LVS 0; antenna 0; gl_test 102 tests, 46 pass, 56 skip, 0 fail. The artifact's `metrics.csv` is byte-identical to that of the local p018 full run (R84), and so is its gate-level netlist | README.md (Status: official build and clock); [signoff-history.md](signoff-history.md) (Status); [notes/timing-closure.md](notes/timing-closure.md) section 10.2 | Run [36298635436](https://github.com/TeslaCoilerOW/ttihp-protocol-emulator/actions/runs/36298635436): job `gds` success (05:56 to 10:20 UTC, 4 h 24 min, inside GitHub's 6 h job limit; p018's local flow took 7,833 s); `gl_test` `TESTS=102 PASS=46 FAIL=0 SKIP=56`; `precheck` "Precheck passed" (KLayout SG13CMOS5L DRC 11,501 s, finished 13:33 UTC). `tt_submission` artifact: `stats/metrics.csv` equals the full run's `out/metrics.csv` (`cmp`: no difference; `timing__setup__ws__corner:*` 5.9499 / 6.9240 / 2.2400, `timing__hold__ws` 0.1650, `design__instance__utilization` 0.653002); netlist sha256 `09841e31…` equals the full run's `final/nl` | CI |
| R86 | At the 50 MHz operating clock (20 ns), the p018 layout has setup WS typ +8.950, fast +9.924, slow +6.790 ns and hold WS typ +0.372, fast +0.165, slow +0.743 ns, with 0 setup and 0 hold violations. In the same analysis the 20 ns layout of `131e793` (p010) has +7.880 / +9.307 / +2.954 ns and +0.318 / +0.112 / +0.657 ns. From 15 to 20 ns the worst slack of each path class moves by +5 ns (register to register), +4 ns (input to register, register to output) and +3 ns (input to output); hold by 0, +1, +1 and +2 ns. This is a re-analysis with the flow's STA script, not a result of the official flow, which times the design at 15 ns | [signoff-history.md](signoff-history.md) (Status, "At 50 MHz"); [info.md](info.md), "Limitations"; [limitations.md](limitations.md) section 2; [notes/timing-closure.md](notes/timing-closure.md) sections 10.3 to 10.5 | Slurm job 24077956 (array 0 to 2): OpenSTA 2.7.0 in the `librelane-3.1.0.dev3` image, LibreLane's `corner.tcl` and `base.sdc` unmodified, the step's environment with only `CLOCK_PERIOD` and the netlist changed. Control (a): p018 at 15 ns equals the full run's `metrics.csv` (10 timing metrics at 3 corners, maximum absolute difference 0). Control (c): the `tt_submission` netlist and SPEF of run 36257636798 at 20 ns equal that run's `stats/metrics.csv` (maximum absolute difference 0). Per-class worst paths from the job's `pe_extra.tcl` (in `<work dir>/sta50/scripts/`; the repository's version, `tools/sta/pe_extra.tcl`, reproduced its results, section 9, item 15), the same start and end point at both periods. `<work dir>/sta50/` (`README.md`, `results.json`, `results.md`, `manifest.json`); 84 theorems checked with AXLE (`<work dir>/sta50/axle/`, `okay: true`) | [`tools/sta/`](../tools/sta/README.md): `python3 tools/sta/sta_retime.py all --run-dir <run> --period <ns> --out <case>` for (a), (b) and (c), then `sta_retime.py compare`. It needs apptainer, the `librelane-3.1.0.dev3` image and the IHP PDK, and takes about one minute per corner on 3 CPUs. The inputs are not in git: for (c) the `tt_submission` artifact of run 36257636798 (CI); for (a) and (b) p018's final netlist and nominal SPEF from its local full run (cluster files). Run from the repository as jobs 24089033, 24089058 and 24089059, it reproduced job 24077956 exactly |
| R88 | With the same knob values, the flow run at 20 ns gives less margin at 50 MHz than the flow run at 15 ns: control promotion p027 (p018's knob set with `CLOCK_PERIOD` 20) has setup WS typ +7.864, fast +9.389, slow +2.998 ns, and the p018 layout re-timed at 20 ns (R86) has +1.085, +0.535 and +3.792 ns more. One pair of runs | [notes/timing-closure.md](notes/timing-closure.md) section 10.6; [signoff-history.md](signoff-history.md) (Status, "At 50 MHz") | p027: full run job 24077610 (`OPENROAD_THREADS` 4; legal, LVS 0; hold WS +0.362 / +0.154 / +0.724 ns; utilization 0.6196), precheck job 24081008 (9/9), gate-level job 24081009 (102 tests, 46 pass, 56 skip, 0 fail); verdict PASS in the leaderboard of 2026-09-27 08:36 UTC. It is the committed configuration of the optimizer's `dor` track since tree `f511c97`, imported trial `#114` (= v1 `dor-26a873-c8bf57e#118`, fast mode, job 24014107). Arithmetic checked with AXLE (`<work dir>/docs-15ns/axle/`) | Cluster: [notes/optimization.md](notes/optimization.md), "Promotion" |

R85 confirmed R84: the official 15 ns build passed with metrics and
netlist identical to the local sign-off (2026-09-27 13:33 UTC).

**Later commits of `main`.** No commit after `d76f1cc` changes the design:
`git diff d76f1cc 24f31f0 -- src info.yaml` lists only comment keys (`//`)
of `src/config.json` (`62f1ad6`). GitHub runs the workflows on the last
commit of each push. Every run below that had finished by 2026-09-28
08:40 UTC passed: `test` with `TESTS=102 PASS=102 FAIL=0 SKIP=0`, `gl_test`
with `TESTS=102 PASS=46 FAIL=0 SKIP=56`, `precheck` with "Precheck passed".
The `gds` runs end `failure` only because their `viewer` job fails
(GitHub Pages is not enabled). The equivalence column is R93.

| Commit | `test`, `formal`, `regen`, `docs` | `gds`: jobs `gds`, `gl_test`, `precheck` | `gds_6x4` | Equivalence on GitHub |
|---|---|---|---|---|
| `4c30622` | 36308043755, 36308043782, 36308043772, 36308043780 | 36308043760: all three pass | 36308043804: all five jobs pass | none (before `a15f6f2`) |
| `fff6746` | 36323174079, 36323174052, 36323174081, 36323174070 | 36323174075: all three pass | 36323174037: all five pass | 8x4: 36351319648; 6x4: none (finished before `a15f6f2`) |
| `a15f6f2` | 36344917874, 36344917891, 36344917886, 36344917910 | 36344917852: all three pass | 36344917858: all five pass | 8x4: 36368252100; 6x4: 36353833650 |
| `76a81f5` | 36360006672, 36360006584, 36360006627, 36360006712 | 36360006594: all three pass | 36360006612: cancelled by the push of `127e8e8` | 8x4: 36391888473; 6x4: skipped, no netlist (36360097584) |
| `127e8e8` | 36360078907, 36360078854, 36360078860, 36360078868 | 36360078852: all three pass | 36360078870: all five pass | 8x4: 36382409490; 6x4: 36369225191 |
| `65cb65c` | 36369316773, 36369316741, 36369316819, 36369316712 | 36369316719: all three pass (`precheck` finished 2026-09-28 09:29 UTC) | 36369316684: all five pass | 8x4: 36403802455; 6x4: 36379351458 |
| `24f31f0` | 36391218353, 36391218338, 36391218351, 36391218336 | 36391218317: all three pass (`gl_test` `TESTS=102 PASS=46 FAIL=0 SKIP=56`; `precheck` finished 2026-09-28 16:03 UTC) | 36391218297: all five pass (`gl_test` `TESTS=102 PASS=46 FAIL=0 SKIP=56`) | 8x4: 36448275402; 6x4: 36405195879 |

The other commits after `d76f1cc` (`f511c97`, `62f1ad6`, `45de462`,
`468e560`, `e0b5223`, `0f8576e`, `75ac8af` and `51bf18a`) were pushed
together with a later commit and have no runs of their own. The rows of
`65cb65c` and `24f31f0` were completed on 2026-09-29 from the finished
runs, which all passed apart from the `viewer` jobs; the equivalence runs
added to them are R93b.

## 2e. A 13.33 ns build on a branch (not the design of record)

The optimizer's 13.33 ns (75.0 MHz) track produced promotion p033
([notes/optimization.md](notes/optimization.md), "The 75 MHz plan"). Branch
`cand/13p33-p033` (commit `3a1ef99`, on top of `65cb65c`) changes only
`src/config.json` and `variants6x4/PROVENANCE.json`. In `src/config.json`
it sets `CLOCK_PERIOD` 13.33, `DESIGN_REPAIR_MAX_CAP_PCT` 30,
`DESIGN_REPAIR_MAX_SLEW_PCT` 30, `FP_MACRO_HORIZONTAL_HALO` 25,
`GRT_LAYER_ADJUSTMENTS` [0, 0.2, 0.1, 0.1, 0],
`PL_RESIZER_SETUP_SLACK_MARGIN` 5.05 and p033's macro placement, and removes
`CTS_SINK_CLUSTERING_SIZE`; `src/project.v`,
`src/protocol_emulator_core.v` and `info.yaml` (`clock_hz` 50000000) are
unchanged. The official actions passed on it. **It is not the design of
record:** the configuration of record stays the 15 ns sign-off of
`d76f1cc` (section 2d) with the 50 MHz operating clock, and operation above
50 MHz is not claimed. The branch is kept as evidence only.

| # | Claim | Stated in | Evidence | Reproduce |
|---|---|---|---|---|
| R96 | The p033 configuration at `CLOCK_PERIOD` 13.33 ns (branch `cand/13p33-p033`, `3a1ef99`) passed the official `gds`, `precheck` and `gl_test`: setup WS typ +4.78, fast +6.08, slow +0.47 ns at 13.33 ns with 0 setup violations; hold WS min +0.151 ns (fast) with 0 hold violations; utilization 65.30%; route DRC 0; LVS 0; antenna 0; gl_test 102 tests, 46 pass, 56 skip, 0 fail. Not adopted: the design of record keeps the 15 ns sign-off and 50 MHz operation (section 2d) | [signoff-history.md](signoff-history.md), "A 13.33 ns build on a branch (not adopted)" | Run [36373555394](https://github.com/TeslaCoilerOW/ttihp-protocol-emulator/actions/runs/36373555394) (push of the branch, 2026-09-28): job `gds` success (03:23 to 07:16 UTC, 3 h 52 min); `gl_test` `TESTS=102 PASS=46 FAIL=0 SKIP=56`; `precheck` "Precheck passed" (finished 11:02 UTC); `viewer` failed (Pages not enabled). `tt_submission` artifact: `commit_id.json` names `3a1ef99` and the run; `stats/metrics.csv` `timing__setup__ws__corner:*` typ 4.7761, fast 6.0780, slow 0.4657, `timing__hold__ws` 0.1512, `timing__setup_vio__count` 0, `timing__hold_vio__count` 0, `design__instance__utilization` 0.653033, `route__drc_errors` 0, `design__lvs_net_difference__count` 0, `antenna__violating__nets` 0; `src/config.json` `CLOCK_PERIOD` 13.33 | CI (a push of the branch) |

## 3. Simulation-based verification

The random and mutation campaigns ran on a frozen snapshot of `73536f0`.
`c118027` has the same `src/` core and `firmware/` as that commit; it changes
the tests (`test/`) and the hardening configuration.

| # | Claim | Stated in | Evidence | Reproduce |
|---|---|---|---|---|
| R20 | Random lockstep campaign: 8,704 seed runs, 536,064 cases, 3,207,184,824 lockstep cycles, 0 failures. RTL: 525,312 cases, 3,159,347,713 cycles. Gate level: 10,752 cases, 47,837,111 cycles | [verification-campaign.md](verification-campaign.md), "Campaigns and totals" | Recomputed for this page from [`campaigns/random/results/campaigns.json`](../campaigns/random/results/campaigns.json) by summing the 15 campaigns; the totals match. Arrays 23746017, 23750843, 23746365–23746369, 23747218, 23750844–23750846, 23752081, 23746061, 23752532, 23752533. About 269 simulator CPU-hours | Cluster: [campaigns/random/README.md](../campaigns/random/README.md). One seed of a `default` campaign, locally and exactly: `cd test && PE_SEED=<seed> make COCOTB_TEST_MODULES=test_random` in a checkout of `73536f0`. At `c118027`, `PE_RANDOM_GEN=1` draws the same cases, except that a trailing `deselect` now runs (BL-8) |
| R21 | The checker catches an injected model bug in 64 of 64 seeds (1,536 of 4,096 cases), and the minimizer shrinks the case to one host operation | verification-campaign.md, "Negative control" | `campaigns.json` `negative_control`; jobs 23749927 and 23749932 | Local: `cd test && PE_INJECT_MODEL_BUG=xor PE_SEED=1 make COCOTB_TEST_MODULES=test_random` must fail (at `c118027` add `PE_RANDOM_GEN=1` for the campaign's cases) |
| R22 | Independent third-party peers: 65/65 tests pass at RTL, at gate level and on Icarus 13.0; seeded campaign 33,280 RTL and 16,640 gate-level test runs, all pass; all 12 wrong-mode SPI substitutions detected | [independent-peers.md](independent-peers.md), "Results" | [`test_ext/results/summary.json`](../test_ext/results/summary.json); job 23792571 (fixed stimulus), arrays 23792569 (RTL) and 23792570 (gate level), job 23791858 (wrong-mode matrix). Design: `73536f0` | Local: `reproduce.sh --only peers` (RTL, fixed stimulus); `cd test_ext && PE_EXT_SEED=<n> make` per seed. Cluster for the campaign |
| R23 | Mutation score 80.2% (1,847 / (2,420 − 116)); 85.8% with deep random and 12 directed tests | verification-campaign.md, "Mutation testing" | [`campaigns/mutation/results/summary.json`](../campaigns/mutation/results/summary.json) (`killed` 1,847, `proven_equivalent` 116); the job list in that section | Cluster: [campaigns/mutation/README.md](../campaigns/mutation/README.md) ("Reproduce"), about 109 CPU-hours |
| R23b | **Superseded by R23c** (96.82%). Mutation score 89.4% (2,060 / 2,304) after gap closure; 85.8% (1,976) without `test_timewarp` | verification-campaign.md, "Gap closure"; commit message of `c118027` | `<work dir>/test-gaps/summary_gaps.json` (`killed` 2,060, `score` 0.8941, `killed_without_timewarp` 1,976); jobs 23813966, 23813967, 23817415, 23819701. **Not in git** (section 9) | Cluster |
| R23c | Mutation score 96.82% (2,223 / (2,420 − 124)) with the 102-test suite of `aa07868`. 124 mutants are proven equivalent (116 by the campaign method, 6 by an ABC gold/mutant miter, 2 by `equiv_induct` with invariants and an SRAM model); the 73 other survivors are argued unobservable but not proven, and count as survivors. A later miter run with a longer ABC time cap proved 26 of the 73 equivalent: 97.93% (2,223 / (2,420 − 150)), 47 survivors ([mutation-push.md](mutation-push.md) section 4.5; `summary-longcap.json`). 96.82% stays the score as run | [mutation-push.md](mutation-push.md), "Result"; commit message of `aa07868` | The committed suite of `c118027` re-run on all 2,420 mutants in one stage: 2,060 killed (array 23974560, jobs 23976875 and 23979515). The `test_kill_*` modules then killed 158 (final stage, job 23984831), 3 (k6, jobs 23987440 and 23987441) and 2 (k7, jobs 23988083 and 23988084) more: 2,223. Formal: job 23977941 (6 proven) and job 23986701 (2 proven). Per-mutant status: [`campaigns/mutation/results/push-4bd30c8/summary.json`](../campaigns/mutation/results/push-4bd30c8/summary.json) and `mutant_status.tsv` (section 9, item 11); raw logs in `<work dir>/mutation97/`. Arithmetic checked with AXLE (`<work dir>/docs-timing/axle/`) | Cluster: mutation-push.md section 6 |
| R23d | Variant `diet4` (the 6x4 build's core) under the 102-test suite (see R23e: 95.19% without the clock-inversion proof of mutant 1860): mutation score 95.24% (2,199 / (2,420 − 111)); 90.87% (2,199 / 2,420) without removing proven-equivalent mutants; 110 survivors, not argued one by one. With the longer ABC time cap: 96.66% (2,199 / (2,420 − 145)), 76 survivors (`summary-longcap.json`). The earlier `diet4` figure, 87.7% (2,028 / (2,420 − 107)) with the 66-test suite ([verification-campaign.md](verification-campaign.md)), is superseded for the current suite | [mutation-push.md](mutation-push.md) section 7 | [`campaigns/mutation/results/diet4-102/summary.json`](../campaigns/mutation/results/diet4-102/summary.json) (`killed` 2,199, `equivalent` 111, `survived` 110) and `survivor_classes.tsv`; jobs in mutation-push.md section 7.5. Arithmetic checked with AXLE | Cluster: [campaigns/mutation/README.md](../campaigns/mutation/README.md) (`campaign-diet4-102.env`) |
| R23e | Recount of R23d without one `equiv_induct` proof that does not show equivalence: mutant 1860 inverts the clock input of a `transfer_pins` flip-flop, and the method treats every flip-flop as a one-step delay of the one clock. `diet4` then scores 95.19% (2,199 / (2,420 − 110)) with 111 survivors, and 96.62% (2,199 / (2,420 − 144)) with 77 survivors under the longer ABC time cap. Its seven other clock-input mutants are killed. The design of record's three clock-input mutants (857, 1390, 2111) are killed, so R23c does not change. R23d keeps the accounting as first published | [mutation-push.md](mutation-push.md) section 7.2, note on mutant 1860 | Slurm job 24391204: recount of the committed `campaigns/mutation/results/diet4-102/mutant_status.tsv` and `push-4bd30c8/mutant_status.tsv` against the campaigns' `mutations.tsv` (`-port CLK` commands; diet4 sha256 `8a24cf1d…`), region and mode of all 2,420 mutants matching in both. A two-flip-flop example with the first flip-flop on the inverted clock is proven equal by the same Yosys steps while Icarus Verilog shows different outputs (`<work dir>/ps2-port/clkinv/`). Arithmetic checked with AXLE (`<work dir>/ps2-port/axle/`) | Cluster: the per-mutant tables are in git; `mutations.tsv` is written into the campaign work directory by `campaigns/mutation/gen_mutants.sh` |
| R23f | Held-out mutation score of the design of record: a new sample of 1,936 mutants of the same core (`src/protocol_emulator_core.v`, sha256 `26a873db…`), drawn uniformly per region (80 % of each campaign quota; seed 20260930) from Yosys `mutate`'s raw database, without the (mode, cell, port) of any of the 2,420 mutants of R23c or of the eight section 8 mutants, run under the 109-test suite of `56f4b20` (Icarus 13.0, cocotb 2.0.1) with no test written for it. 93.45 % (1,655 / (1,936 − 165)), Wilson 95 % [92.20, 94.51], against the in-sample 96.86 % [96.07, 97.50]; with the longer ABC time cap 96.00 % (1,655 / (1,936 − 212)) [94.97, 96.83], against 97.97 % [97.31, 98.48]. Of the 69 survivors, 48 are argued equivalent and 21 are real test gaps: 1.22 % (21 / 1,724) [0.80, 1.86] of the mutants not proven equivalent. The twelve modules written against survivors kill 115 of the 231 mutants the nine older modules leave (49.78 %), against 163 of 235 (69.36 %) in-sample. Same runner on the 2,420 mutants of R23c: 2,224 killed, as in R23c plus survivor 192 | [mutation-push.md](mutation-push.md) section 9 | [`campaigns/mutation/results/heldout-56f4b20/`](../campaigns/mutation/results/heldout-56f4b20/) (`summary.json`: `killed` 1,655, `equivalent` 165, `survived` 116; `summary-longcap.json`: `equivalent` 212, `survived` 69; `survivors.tsv`: 48 argued, 21 gaps; `insample-56f4b20.json`: `killed` 2,224). Jobs: 24425559 (sample), 24425574 (controls), 24425862 and 24429175 (held-out suite), 24425864 (in-sample suite), 24428688, 24430160, 24431210 (`equiv_mutant.py`), 24429181, 24430279 (miter, 150 s), 24429182, 24430280 (`equiv_inv.py`), 24429183, 24430281 (miter, 900 s), 24429184, 24430282 (RIP). Arithmetic checked with AXLE (`<work dir>/mut-heldout/axle/`) | Cluster: mutation-push.md section 9.6 (`campaigns/mutation/campaign-heldout.env`, `campaigns/mutation/heldout_sample.py`) |
| R23g | Tests for the specified behaviour behind the 21 real test gaps of R23f (five modules `test/test_spec_*.py`, 9 tests; the default suite is 118 tests in 26 modules) and a second held-out sample. The 21 gap mutants are all killed by the new modules, with the lockstep comparison and with `PE_SPEC_ONLY=1`; the unmutated core and id 0 pass the 118 tests. The first held-out sample, now in-sample for the new modules: 94.64 % (1,676 / (1,936 − 165)) [93.49, 95.59], with the longer ABC cap 97.22 % (1,676 / 1,724) [96.33, 97.89], 48 survivors, all argued; the push sample is unchanged (the new modules kill none of its 72 survivors). Second held-out sample (seed 20261001, same method and quotas, without the (mode, cell, port) of the 2,420 + 8 + 1,936 earlier mutants; 1,936 drawn, one not buildable by Yosys and left out), run under the 118 tests with no test written for it: 95.00 % (1,691 / (1,935 − 155)) [93.89, 95.92]; with the longer ABC cap 97.13 % (1,691 / (1,935 − 194)) [96.23, 97.81]. Of the 50 survivors, 37 are argued equivalent and 13 are real test gaps: 0.75 % (13 / 1,741) [0.44, 1.27] of the mutants not proven equivalent. The twelve modules written against the push's survivors kill 113 of the 210 mutants the nine older modules leave (53.81 % [47.06, 60.42]); the five new modules kill 8 of the 97 the 21 other modules leave | [mutation-push.md](mutation-push.md) section 10 | [`campaigns/mutation/results/heldout2-b37c0ee/`](../campaigns/mutation/results/heldout2-b37c0ee/) (`summary.json`: `killed` 1,691, `equivalent` 155, `survived` 89, `error` 1; `summary-longcap.json`: `equivalent` 194, `survived` 50; `survivors.tsv`: 37 argued, 13 gaps; `insample-118.json`: the 21 killed, the push's 72 survivors not). Jobs: 24493977 and 24493968 (the 21 gaps, with and without the comparison), 24493969 (controls), 24500049 (push survivors), 24493540 (runner check), 24493549 (sample), 24494405, 24495281, 24495282, 24495284, 24495285 (suite), 24501277 (`equiv_mutant.py`), 24502293 (miter, 150 s), 24502859 (`equiv_inv.py`), 24503814 (miter, 900 s), 24503815 (RIP). Arithmetic checked with AXLE (`<work dir>/gap-close/axle/`) | Cluster: mutation-push.md section 10.9 (`campaigns/mutation/campaign-heldout2.env`, `campaigns/mutation/heldout_sample.py`) |
| R24 | Host library: 69 unit tests pass; 100,000 fuzz seeds (400,000 to 499,999) pass on the three-way differential and on Icarus 13.0 RTL replays, with 0 oracle problems | [host.md](host.md), "Verification of the library" | Job 23778831 (unit tests); jobs 23778347, 23778353, 23778832, 23778833, 23778835, 23778836 (fuzz) | Local: `reproduce.sh --only host`. Without MicroPython on `PATH`, 4 tests skip. Fuzz: `host/tools/fuzz_host.py` (cluster for 100,000 seeds) |
| R25 | cocotb suite after gap closure: 66/66 on RTL; 36 pass, 30 skip at gate level on the campaign netlist; 66/66 on each of the six variants | verification-campaign.md, "Suite" | Jobs 23819699, 23819700, 23819698 | Local (RTL); see R12 and R3 |
| R26 | Six design variants: 39/39 cocotb each, 16 extra random seeds each (24,576 cases, about 94.5 M cycles), all 16 formal jobs each (112 jobs), gate level 22/22 on LibreLane-replica netlists; TT-synthesis areas base 462,710 µm², `rstreg` 462,675, `cn` 414,536, `cn_s2` 413,522, `diet4` 298,478, `diet2` 257,254 | [notes/variants.md](notes/variants.md) sections 5 and 7.2 | Jobs 23758014 to 23758018 (23758015 has 107 array tasks), 23758039, 23758040, 23758041 (112 tasks), 23761206, 23761207. Suite at `73536f0` (39 tests); R25 covers the 66-test suite | Local: `reproduce.sh --only variants,hardcaml`; `cd test && PE_VARIANT=<name> make`; `formal/run.sh --variant <name>` |
| R27 | FPGA builds: the unchanged `test/` suite (39 tests at `73536f0`) passes on four FPGA-top configurations and on two post-synthesis netlists; the SRAM stand-in is proved equivalent to the IHP model (unbounded, ABC PDR) | [fpga.md](fpga.md), "Verification" | Jobs 23763625, 23757655, 23756607, 23756608, 23764155, 23768231 | Local: `fpga/sim/`, `fpga/formal/run.sh` |
| R24b | Host library with `uart-rx-idle` as the flagship's engine 1 (since `e64cd6b`): 69 of 69 unit tests pass with MicroPython 1.29, mpy-cross and Icarus 14, the `peers="external"` tests now expecting no engine fault; `test_host_rtl.py` passes on Icarus 13.0 (flagship stimulus 7,842 cycles); `make -C host rtl-cocotb` 2 of 2; `run_flagship(peers="external")` with the default 200,000 free-run cycles passes on a full and a 6-bit uo port with no engine fault (201,599 host cycles) | [host.md](host.md), "Verification of the library" | Job 24302122 (snapshot of the working tree after `6a3ea08`) | Local: `reproduce.sh --only host`; `make -C host test` |
| R26b | `dune test` in `hardcaml/` runs the seven Hardcaml test executables, `line_test` and, when the `#test ` packages of `scripts/opam-deps.txt` are installed, the waveform expect tests of `hardcaml/test/expect` (six files); `line_sys_test` passes on `configs/variants/diet8_rec16.json`. The `regen` workflow runs them in its own job, `hardcaml-tests`, apart from the regeneration check | [hardcaml/test/README.md](../hardcaml/test/README.md) | Cluster emulation of the workflow's run steps in a fresh opam switch built from `scripts/opam-deps.txt` with the test packages: jobs 24195951 (with two seeded mutants) and 24305230 (the `hardcaml-tests` job's steps on the tree after `6a3ea08`); `reproduce.sh --only hardcaml` with the expect tests: job 24303859 | CI (`regen.yaml`, job `hardcaml-tests`); local: `reproduce.sh --only hardcaml` |
| R28 | Default cocotb suite on RTL: 107 of 107 tests pass (Icarus 13.0, cocotb 2.0.1), including the 5 RTL-only tests of `uart-rx-idle`, the idle-tolerant receiver that is engine 1 of the flagship since `e64cd6b`: idle stretches of 100,000 cycles, sparse frames at every poll phase, a break across START, a framing error, and back-to-back frames at -2%, 0 and +2% baud error. Its sample points are the reference model's, with the DUT checked in lockstep on its outputs, at RTL only: frame bit n (start bit 0, stop bit 9) is sampled 64n + 31 + d clocks (d = 0 to 2) after the first clock edge that registers the start bit's falling edge. The flagship passes at gate level (1 pass, the 5 new tests skip), with the top-up scenario, on the FPGA top (6 of 6), and under `PE_VARIANT=diet4` and `diet8_rec16` with the image that `scripts/gen_variants.sh` now reassembles for each variant (6 of 6 each); the third-party UART peers of `test_ext_uart` pass with `uart-rx-idle` in place of `uart-rx` (5 of 5, including ±3% baud error), and `test_ext_flagship` 4 of 4. `pe_timing`: the image's contract checks pass (R40c); the validator matched 752 of 752 engine runs (scenarios and stress, all 20 images of that tree) and 525 of 525 (`uart-rx-idle` stress); a model-only run with idle stretches of 10,000,000 cycles passes | [info.md](info.md), "Example: UART TX, SPI and I2C at the same time"; [firmware.md](firmware.md); [test/README.md](../test/README.md) | Suite: job 24303859 (107 of 107, on the tree after `6a3ea08`; also the variant runs) and job 24167290 (107 of 107, before commit); gate level against the netlist of run 36298635436: 24167291; top-up: 24167306; FPGA top (`fpga/sim`): 24167292; `test_ext_uart` with the image aliased: 24167049; `test_ext_flagship` with the engine-1 lookup: 24166965, and 4 of 4 again in the `peers` step of job 24303859; `pe_timing` report and analysis: 24167452; validation and the long model run: 24166995 | Local: `reproduce.sh --only cocotb`; `cd test && make COCOTB_TEST_MODULES=test_flagship` |
| R28b | Default cocotb suite with `test/test_wait_limit.py`: 109 of 109 tests pass on RTL (Icarus 13.0, cocotb 2.0.1), and 109 of 109 on the 6x4 core under `PE_VARIANT=diet4`. At gate level 48 pass, 61 skip and 0 fail on the netlists of runs 36298635436 (8x4) and 36298635404 (6x4, `PE_VARIANT=diet4`), both of `d76f1cc`, whose core is unchanged since; the module's two tests run there with LIMIT up to 2^8 + 2. The module lets WAITEVENT and WAITPIN time out at LIMIT 2^k + 2 (k = 0 to 23) on every engine and checks from the DUT that each output enable stays high for exactly LIMIT + 1 edges and that the status reports fault code 3. It fails on four mutants of the design-of-record core that pass the other 107 tests, also with the reference-model comparison off (`PE_SPEC_ONLY=1`), and on survivor 192 of the mutation push (R23c; section 9, item 18). Its two tests take 2.9 s of the suite's 207 s of test time on RTL, and 7.4 s (8x4) and 4.9 s (6x4) at gate level. It also passes on the `diet8_rec16` core of the extension branch (2 of 2) | [test/README.md](../test/README.md), "LIMIT timeouts"; [mutation-push.md](mutation-push.md) section 8 | Snapshot of `3364ad9` with the module. Job 24382111: task 1 (109 of 109), task 2 (the 107 tests without the module, 107 of 107), task 3 (6x4 RTL), tasks 4 and 5 (gate level), task 6 (`diet8_rec16`, core sha256 `d517e277…`). Mutants: jobs 24381935, 24382109 (the four mutants, controls and `PE_SPEC_ONLY=1` runs), 24382110 (the 73 survivors) and 24382495 (192); the four mutants under the push suite: jobs 24366260 and 24370776. Arithmetic checked with AXLE (`<work dir>/limit-port/axle/`) | CI (`test.yaml`, job `test`); local: `cd test && make COCOTB_TEST_MODULES=test_wait_limit`, with `PE_SPEC_ONLY=1` for the model-free check |
| R28c | Default cocotb suite with the five `test/test_spec_*` modules: 118 of 118 tests pass on RTL (Icarus 13.0, cocotb 2.0.1), 118 of 118 on the 6x4 core under `PE_VARIANT=diet4`, and 55 of 55 at gate level (63 skipped) on the official 8x4 netlist of run 36714406904 (`ce6b9bd`). The nine new tests simulate 118,148 cycles on RTL (14.9 s of test time against 183.4 s for the other 109 in the uncontended job 24507279; 17.2 s against 423.6 s in job 24493924, which shared its node) and 19,825 at gate level (26.7 s, the other 48: 151.5 s) | [test/README.md](../test/README.md), "Specification checks"; [mutation-push.md](mutation-push.md) section 10.1 | Job 24493924 (four suites at once on one cluster node: RTL with 26 and with 21 modules, gate level, `diet4`) | Cluster: `cd test; make` (RTL), `make PE_VARIANT=diet4 PE_CORE=../variants6x4/protocol_emulator_core.v`, `make GATES=yes GL_NETLIST=<netlist of run 36714406904>` |
| R29 | The SWD (`swd-read`), WS2812B (`ws2812`, `ws2812b-v5`), PS/2 (`ps2-device`, `ps2-host`) and 1-Wire (`onewire-master`) images, added in `e64cd6b` with no RTL change: `test/test_protocols_ext.py` 22 of 22 on RTL in lockstep with the reference model, against peers written from the cited specifications (including the stricter SWD error-path check that the target model records no violation); the `pe_timing` validator matched 747 of 747 engine runs with 16,552 of 16,552 pad changes on a predicted edge; their contract checks pass (R40c). Timing certificates: all six certified (R42c) | [firmware.md](firmware.md), "SWD, WS2812B, PS/2 and 1-Wire images" | RTL: job 24302123 (22 of 22, 428 s, on the tree after `6a3ea08`), job 24170373 (22 of 22, before commit) and jobs 24169435 to 24169439 (earlier partial runs); validator: 24170374; `tools/timing` and `tools/timing/cert` unit tests and the report: 24170375; reference-model runs of every scenario: 24169388, 24170172 | CI (`test.yaml`, job `protocols-ext`); local: `cd test && make COCOTB_TEST_MODULES=test_protocols_ext` |
| R29b | `ps2-host` on designs with byte-lane shifts (ISA version 3): its word 45, SHR by 21, is the only shift count of the 26 images in `firmware/` that is not a byte lane (the others use 8, 16 and 24; branch targets at most 59), and a byte-lane design faults there with code 1. [isa.md](isa.md) had said that every image runs unchanged on a version-3 device. `test/test_protocols_ext.py` now skips an image's tests on a design whose ISA knobs change one of its words, and `test_ps2_host_restricted` checks the fault instead (the command reaches the PS/2 device, then fault 1 at PC 45): design of record 22 pass and 1 skip; `diet4` on the 6x4 core and `diet2` 1 pass and 22 skip; `diet8` and `diet8_rec16` 21 pass and 2 skip. On `dced528`, `diet8` failed both `test_ps2_host` tests. The default suite passes 109 of 109. `pe_host` refuses `ps2-host` on a device that reports ISA version 3: 72 of 72 host unit tests (69 on `dced528`) | [isa.md](isa.md), "ISA version"; [test/README.md](../test/README.md); [firmware.md](firmware.md); [host.md](host.md); [notes/6x4.md](notes/6x4.md) section 1.1 | Snapshot of the working tree after `dced528`, Icarus 13.0 and cocotb 2.0.1: array 24391190, tasks 1 (design of record, 426 s), 2 (`diet4`, core `cc27c465…`), 3 (`diet8`), 4 (`diet2`), 5 (`diet8_rec16`), 6 (default suite), 7 and 8 (`dced528` on `diet8` and `diet4`); host library: job 24391202 (unit tests, CI-like run, `upy-check`, `mpy`, `test_host_rtl.py` on Icarus 13.0, `rtl-cocotb` 2 of 2), 24391702 (the tests fail with the rule removed), 24391460 (heap). Arithmetic checked with AXLE (`<work dir>/ps2-port/axle/`) | CI (`test.yaml`, job `protocols-ext`, design of record); local: `cd test && make PE_VARIANT=diet4 PE_CORE=$PWD/../variants6x4/protocol_emulator_core.v COCOTB_TEST_MODULES=test_protocols_ext`; `make -C host test` |

## 4. Formal verification

**`formal/` (in CI; see [formal/README.md](../formal/README.md)).** The
design is `configs/instruction-sram-32.json` with the IHP FUNCTIONAL SRAM
models. The times are from the full local run, Slurm job 23716631 (2 CPUs,
15 min 10 s in total). CI run 36144357811 passed all 16 jobs on `c118027`.
On a fresh export of `c118027`, `scripts/reproduce.sh` met the expectation
of the 12 quick jobs in 223 s and 233 s (jobs 23974810 and 23975260, 2 CPUs),
and of all 16 in job 23974811.

| # | Job | Bound | Engine | Local time (s) |
|---|---|---|---|---:|
| R30 | `reset_safety` | unbounded (k-induction) | smtbmc yices | 3 |
| | `fifo_conservation` | unbounded (IC3/PDR) | abc pdr | 216 |
| | `engine_safety` | BMC 24 | smtbmc yices | 16 |
| | `processor_invariants_bmc` | BMC 24 | smtbmc yices | 29 |
| | `processor_invariants_prove` | unbounded (k-induction) | smtbmc yices | 3 |
| | `processor_inductive_bmc` | BMC 8 | smtbmc yices | 11 |
| | `processor_inductive_prove` | unbounded (k-induction), from any valid state | smtbmc yices | 2 |
| | `processor_inductive_cover` | cover | smtbmc yices | 4 |
| | `timing_isolation_prove_k0` to `_k3` | unbounded (k-induction, depth 2), one job per engine | smtbmc yices | 34–39 each |
| | `timing_isolation_bmc` | BMC 20 | smtbmc bitwuzla | 454 |
| | `timing_isolation_cover` | cover, 4 witnesses | smtbmc yices | 9 |
| | `timing_isolation_neg_pull` | negative control; must FAIL | smtbmc yices | 5 |
| | `timing_isolation_neg_mutant` | negative control; must FAIL | smtbmc yices | 7 |

**`formal_depth/` (cluster; see [formal-depth.md](formal-depth.md)).** R31 to
R39 ran against `73536f0`, and R97 reran every job on `56f4b20`. The
machine-readable results are in
[`formal_depth/results/summary.tsv`](../formal_depth/results/summary.tsv) and
[`formal_depth/results/56f4b20/summary.tsv`](../formal_depth/results/56f4b20/summary.tsv).
The rows below were checked against those files (R97 against
`formal_depth/results/56f4b20/summary.tsv`).

| # | Claim | Status | Engines that passed (Slurm id) |
|---|---|---|---|
| R31 | Timing-isolation miter BMC to depth 100 | bounded | rIC3 BMC, 2,643 s (23757105_0). Depth 60: rIC3 (23752066_7) and smtbmc bitwuzla, 7,038 s (23752066_2) |
| R32 | `engine_safety` unbounded | unbounded | suprove on the unmodified harness (23752067_11); k-induction depths 2, 4 and 8 with yices, bitwuzla and boolector (23757443_0 to _8) and rIC3 IC3 (23757443_10) on a copy with three added invariants |
| R33 | `processor_invariants` BMC 128; `processor_inductive` BMC 96 | bounded | abc bmc3, btormc, rIC3 (23757105_3 to _5; _6 to _8) |
| R34 | Host-port atomicity and read snapshots | unbounded | yices, bitwuzla, boolector, rIC3, abc pdr (23756999_0 to _4) |
| R35 | Program-load safety, control part | unbounded | yices, bitwuzla, boolector (23756749_12 to _14) |
| R35b | Program-load SRAM data integrity (`spec_word_*`) | **bounded only**, BMC 48 | abc bmc3, boolector, bitwuzla, btormc (23756748_8 to _11) |
| R36 | Mover conservation, quota and order | unbounded | boolector, bitwuzla, yices, rIC3, abc pdr (23760775_2 to _4, 23760892_0 and _1) |
| R37 | Round-robin grant bound, from every register state | unbounded | boolector, yices, bitwuzla, abc pdr, suprove, rIC3 (23756749_36 to _41) |
| R38 | Fault stickiness and output-enable release; pin ownership and open-drain safety | unbounded | 6 engines each (23756749_48 to _53; _54 to _59) |
| R39 | 13 mutant negative controls, all caught on the named assertion | — | `neg_*` rows of `summary.tsv` (23756748, 23756749, 23756999, 23760775) |
| R97 | `formal_depth/` second campaign, on `56f4b20`. Six mutant substitution sites, broken since `c377d97` (one) and `131e793` (five), were repaired. Every job of `formal_depth/jobs.py` (56 jobs, 192 sby tasks) then ran again on netlists that are byte-identical to the `73536f0` ones. Every result of R31 to R39 was reproduced: the same unbounded proofs with at least the same engines; the same BMC depths (timing isolation 100, `processor_invariants` 128, `processor_inductive` 96, `engine_safety` 128, program-load data integrity 96); the same cover steps; and each of the 13 negative controls failing on its named claim at the same step. 191 tasks finished. One bitwuzla cross-check of a control was cancelled after 8 h 34 min; yices had already failed that control at the named step | as R31 to R39 | Arrays 24426336 and 24426337 (41,400 s limit), and 24426338 and 24426339 (24 long-tail tasks, 14,400 s limit). Generation 24425593, repeated with the final scripts in 24427432. On `73536f0` the updated `mutants.py` reproduces the 13 mutant netlists byte for byte (24425594). Files: [`formal_depth/results/56f4b20/summary.tsv`](../formal_depth/results/56f4b20/summary.tsv) and [`mutant_cones.txt`](../formal_depth/results/56f4b20/mutant_cones.txt); [formal-depth.md](formal-depth.md), "Results at `56f4b20`" |

Reproduce: `formal_depth/run.sh generate`, then
`formal_depth/run.sh submit <work dir>` on a cluster, or
`FD_PARALLEL=8 formal_depth/run.sh local <work dir> --only '<regex>'`
without Slurm. The heavy classes need up to 32 GB per task.

**RTL-vs-netlist equivalence (`formal_eq/`: locally, in the optimizer's
promotions and, since `a15f6f2`, in CI after every `gds` and `gds_6x4` build
of `main` (`.github/workflows/equiv.yaml`); see
[equivalence.md](equivalence.md)).** Yosys builds a
miter of the RTL (`src/project.v` plus the variant's core) and the gate-level
netlist, with cell functions from the standard-cell liberty, the eight SRAM
macros as cut points and reset forced in the first cycle; ABC `dprove`
decides it. Only "equivalent" passes; "not equivalent", "undecided", a time
limit or an error fail. The Tiny Tapeout flow does not compare its netlist
with the RTL (LVS compares the layout with the netlist).

| # | Claim | Stated in | Evidence | Reproduce |
|---|---|---|---|---|
| R90 | The netlists of the official builds are equivalent to their RTL: 8x4 at 15 ns (run 36298635436, `d76f1cc`; ABC 692 s), 6x4 (run 36298635404; 67 s) and 8x4 at 20 ns (run 36257636798, `131e793`; 349 s). In each run the self-test also passed: the recipe controls and two mutated netlists (one cell function changed, two SRAM data pins swapped), which were found not equivalent | [equivalence.md](equivalence.md) | Slurm jobs 24093884, 24093883 and 24093885 (`<work dir>/eq-repo/runs-final/*/result.json`, verdict `equivalent`, exit 0; the netlist sha256 in each equals the artifact's). A third mutant (one random cell) stayed undecided after 1,708 s (job 24093081), which the gate counts as a failure | `python3 formal_eq/eq_check.py check --run-dir <tt_submission artifact> --variant base\|diet4 --selftest` ([formal_eq/README.md](../formal_eq/README.md)); about 2 to 13 min on one CPU |
| R91 | The first recipe (`miter -equiv -ignore_gold_x` followed by `setundef -zero`) was unsound: it compared an output bit only where the RTL value was 1. Its earlier "equivalent" results were not proofs and are superseded by R90. The packaged recipe drops the flag and adds nine recipe controls, including the two cases the old recipe misclassified | [equivalence.md](equivalence.md) | Ablation job 24094085 (`<work dir>/eq-repo/ablation/ablation.json`): with the old recipe, controls c1 (gate `a\|b` against gold `a`) and c4 (a difference after 13 cycles) were reported equivalent; with the packaged recipe all nine controls meet their expectation | `python3 formal_eq/eq_check.py controls` |
| R92 | The gate-level failure of optimizer promotion p026 (6x4; 8 of 102 tests) is a race in the zero-delay simulation, not a logic change: its netlist is equivalent to the RTL, the SRAM clock branch is 15 to 18 buffers deep against 11 to 13 for the flip-flops, and with the SRAM clock pins tied to `clk` the gate-level subset passes (46 pass, 0 fail). Real timing is the other way round (SRAM clock latency 0.796 ns against up to 1.478 ns at the flip-flops, fast corner) | [equivalence.md](equivalence.md); [notes/optimization.md](notes/optimization.md) | Equivalence job 24093886; simulations 24085496 and 24086215; clock report 24087092 (`<work dir>/gleq/`) | Cluster |
| R93 | The `equivalence` workflow checked on GitHub the two official netlists of `d76f1cc` (by hand) and every `gds` and `gds_6x4` build of `main` that finished after the workflow reached `main` (`a15f6f2`, 2026-09-27 19:35 UTC) and before 2026-09-28 08:40 UTC: 9 checks, all `equivalent`, each with the self-test passed. Builds that finished in between were not checked: those of `4c30622` (`gds` 36308043760, `gds_6x4` 36308043804) and the `gds_6x4` build of `fff6746` (36323174037); they have the same `src/` as `d76f1cc`. 8x4 (`base`): 5 checks, jobs of 10 min 2 s to 15 min 5 s, `eq_check.py` wall time 568.5 to 873.6 s. 6x4 (`diet4`): 4 checks, jobs of 2 min 32 s to 2 min 45 s, wall time 112.9 to 124.4 s. The `gds_6x4` run of `76a81f5`, cancelled before its `gds` job ended, was skipped with "there is no netlist to check" | [equivalence.md](equivalence.md) section 7 | Runs (checked build in brackets): 36344927204 (6x4 36298635404) and 36344929368 (8x4 36298635436), both `workflow_dispatch` on `d76f1cc`'s builds; by `workflow_run`: 36351319648 (36323174075), 36353833650 (36344917858), 36368252100 (36344917852), 36369225191 (36360078870), 36379351458 (36369316684), 36382409490 (36360078852), 36391888473 (36360006594); skipped: 36360097584 (36360006612). The mapping and the verdicts are from the jobs' logs: the `select` step names the run it checks, and the check prints `{"verdict": "equivalent", "exit_code": 0, "pass": true, "wall_s": …}` | CI: `gh workflow run equiv.yaml -f run_id=<gds or gds_6x4 run>` |
| R93b | After 2026-09-28 08:40 UTC the `equivalence` workflow checked three more builds of `main`, all `equivalent`, each job passing only with the self-test's two netlist controls and the recipe controls behaving as expected: the 8x4 build of `65cb65c` and the 6x4 and 8x4 builds of `24f31f0` | [equivalence.md](equivalence.md) section 7 | Runs (checked build in brackets; `eq_check.py` wall time): 36403802455 (8x4 36369316719; 819.7 s), 36405195879 (6x4 36391218297; 112.6 s), 36448275402 (8x4 36391218317; 828.7 s), all by `workflow_run`. The job's final `jq -e` check requires `verdict` `equivalent`, `selftest.pass`, no missed control and both netlist controls; each log prints `{"verdict": "equivalent", "exit_code": 0, "pass": true, …}` | CI |
| R95 | The formal netlist of the timing-isolation proof and of the timing certificates, `processor_fv.v`, is sequentially equivalent to the committed `src/project.v` and `src/protocol_emulator_core.v` on the chip ports, from the all-zero state; a netlist with one extra input flip-flop is found not equivalent. The same file, byte for byte (sha256 `2a039bae…`), is what the `formal` workflow generated on `c118027` and on `24f31f0`, what `formal_depth/` read at `73536f0`, and what the certificate campaign read at `c118027` | [timing-certificates.md](timing-certificates.md) section 6; [limitations.md](limitations.md) section 3; [formal-depth.md](formal-depth.md), "What is still unproven" | Equivalence: Slurm job 23987598 (ABC `dprove`, "Networks are equivalent"), negative control job 23989727. File identity: the `formal-rtl` artifacts of `formal` runs 36144357811 (`c118027`) and 36391218338 (`24f31f0`), and the work-area copies of `formal_depth/` and of the certificate campaign, compared by sha256 on 2026-09-28 | `python3 tools/timing/cert/equiv_src.py --src src --rtl formal/build/rtl --models models …` after `formal/run.sh --generate-only` (timing-certificates.md section 7); cluster |

## 5. Static timing analysis of the firmware

| # | Claim | Stated in | Evidence | Reproduce |
|---|---|---|---|---|
| R40 | **Superseded by R40b** (the I²C images of `fb79f31`). Report on the images committed at `c118027`: 182 PASS, 1 FAIL, 3 WARN, 55 INFO. The FAIL is `i2c-repeated-start` `i2c-scl-low-phase`, a 7-cycle SCL low phase | [timing-analysis.md](timing-analysis.md), "Results" and "Findings" | [`tools/timing/report/checks.json`](../tools/timing/report/checks.json) as committed at `c118027` (the file now holds R40b). A regeneration for this page gave the same `checks.json` and `timing-report.md`, byte for byte | Local: `reproduce.sh --only timing`, which takes seconds |
| R41 | **Superseded by R41b** (the I²C images of `fb79f31`). Validation against the reference model on the images committed at `c118027`: 1,303,659 engine runs, 38,037,698 of 38,037,698 pad changes on a predicted edge, 100% path coverage of those images; 7 of 7 deliberately wrong analyzers caught | timing-analysis.md, "Validation" | [`tools/timing/report/validation-summary.json`](../tools/timing/report/validation-summary.json) as committed at `c118027` (`runs_ok` 1,303,659, `pad_changes_matched` 38,037,698; the file now holds R41b); runs r2, r3, r4 and r7 (jobs 23757447–23757449, 23759925, 23759928, 23761093, 23762121, 23762123, 23774644, 23776236) | Local: `reproduce.sh --only timing-validate` (base suites only). Cluster: the stress and random arrays ([tools/timing/README.md](../tools/timing/README.md)) |
| R40b | **Superseded by R40c** (the 26 images of `e64cd6b`). Report on the images committed since `fb79f31`, which regenerated the three I²C controller images (the other 16 are byte-identical): 183 PASS, 0 FAIL, 0 WARN, 55 INFO | [timing-analysis.md](timing-analysis.md), "Results"; [bug-ledger.md](bug-ledger.md) BL-2 and BL-3 | [`tools/timing/report/checks.json`](../tools/timing/report/checks.json) (Slurm jobs 23975273 and 23986537). On 2026-09-28, `pe_timing report` on `firmware/` of `24f31f0` regenerated `checks.json` and `timing-report.md` byte for byte | Local: `reproduce.sh --only timing`, which takes seconds |
| R41b | Validation of the regenerated images against the reference model (run r8): 1,193,441 of 1,193,441 engine runs consistent; 35,303,947 of 35,303,947 pad changes on a predicted edge; 7 of 7 deliberately wrong analyzers caught; the 3 margin experiments agree with the prediction; path coverage of the 19 committed images 362 of 363 variants (`i2c-read` 27 of 28, every other image all of its variants), and of the 6 uncommitted scalar images of the stress suite 218 of 218 | [timing-analysis.md](timing-analysis.md), "Validation of the regenerated set (run r8)" | [`tools/timing/report/validation-summary.json`](../tools/timing/report/validation-summary.json) (`runs_ok`, `pad_changes_matched`, `mutants`, `margins`, `variant_coverage`); jobs 23984750 to 23984754 and 23986537 | As R41 |
| R40c | Report on the 26 images committed since `e64cd6b` and the flagship, whose engine 1 runs `uart-rx-idle`: 252 PASS, 0 FAIL, 0 WARN, 65 INFO. The checks of the 19 earlier images are unchanged (175 PASS, 55 INFO); the seven new images add 69 PASS and 10 INFO (`uart-rx-idle` 10 and 1, `swd-read` 12 and 2, `ps2-device` 11 and 2, `ps2-host` 9 and 2, `onewire-master`, `ws2812` and `ws2812b-v5` 9 and 1 each); the flagship's 8 checks pass, with an engine-1 WCET between boundaries of 606 cycles (`uart-rx`: 618). The validation summary of run r8 (R41b) covers the 19 earlier images; the new images were validated separately (R28, R29) | [timing-analysis.md](timing-analysis.md), "Results"; [firmware.md](firmware.md) | [`tools/timing/report/checks.json`](../tools/timing/report/checks.json) and `timing-report.md`, regenerated from the tree after `6a3ea08` (Slurm job 24301869; the same totals in job 24170375 before `uart-rx-idle` became engine 1 of the committed flagship) | Local: `reproduce.sh --only timing` |
| R42 | **Superseded by R42b** (the campaign on `24f31f0`). Timing certificates of the images committed at `c118027`: all 368 segments of the 19 images certified on the RTL (368 of 368 whole-segment certificates, 21 of 21 long segments also as chunk chains); the boundary lemmas (four engines, with covers) and the SRAM macro lemma pass, and their two negative controls fail (12 of 12 tasks meet their expectation); 132 of 132 negative controls fail as required; 3 of 5 RTL timing mutants caught. **Scope at `24f31f0`:** `fb79f31` changed the three I²C controller images, so the certificates cover the committed firmware for 16 of the 19 images (249 of the 368 segments); the 119 segments of `i2c-read`, `i2c-write` and `i2c-repeated-start` certify their earlier versions, and those three images await re-certification | [timing-certificates.md](timing-certificates.md) | [`tools/timing/cert/results/summary.json`](../tools/timing/cert/results/summary.json) (`totals`, `lemmas`, `negatives`, `rtl_mutants`); jobs in timing-certificates.md section 6. Which images changed: `bytecode_sha256` of each `firmware/*.image.json` at `c118027` and at `24f31f0` (the `certs` check of `tools/evidence/check_consistency.py`) | Cluster: `tools/timing/cert/campaign.sh` (timing-certificates.md section 7) |
| R42b | Timing certificates of the 19 images committed at `24f31f0`, which include the three I²C controller images revised in `fb79f31`: 350 of 350 segments certified on the RTL (whole-segment certificates), the 22 segments longer than 96 steps also as 127 chunks, 455 covers reached (328 whole-segment and 127 chunk covers); the boundary lemmas (four engines, with covers) and the SRAM macro lemma pass and their two negative controls fail; 132 of 132 negative controls and 52 of 52 chunk-level ones fail as required; 3 of 5 RTL timing mutants caught; the formal netlist is equivalent to the committed `src/` top, and a netlist with an extra input flip-flop is not. **Scope:** the 7 images added in `e64cd6b` (`uart-rx-idle`, `swd-read`, `ws2812`, `ws2812b-v5`, `ps2-device`, `ps2-host`, `onewire-master`) are certified by the later campaign on `6a3ea08` (R42c) | [timing-certificates.md](timing-certificates.md), "Results" and section 6; README.md (Status) | [`tools/timing/cert/results/summary.json`](../tools/timing/cert/results/summary.json) (campaign `24f31f0`: `totals`, `lemmas`, `negatives`, `rtl_mutants`) and [`results/campaigns/24f31f0.md`](../tools/timing/cert/results/campaigns/24f31f0.md); jobs 24168359 (formal RTL), 24168398 (short segments), 24168399 (chunks), 24168400 (covers), 24168401 (negative controls), 24168402 (lemmas), 24168403 (long segments whole), 24168404 and 24168802 (equivalence and its control), 24168782 and 24168801 (RTL mutants), 24198443 (chunk-level controls, not in the ledger record) | Cluster: `tools/timing/cert/campaign.sh certify` (timing-certificates.md sections 7 and 8); `python3 tools/timing/cert/ledger.py check` compares the ledger with the committed images |
| R42c | Timing certificates of the 7 images added in `e64cd6b` (`uart-rx-idle`, `swd-read`, `ws2812`, `ws2812b-v5`, `ps2-device`, `ps2-host`, `onewire-master`), campaign on `6a3ea08`: 91 of 91 segments certified on the RTL, the 28 segments longer than 96 steps as chunk chains (the longest, in `onewire-master`, 80,004 steps), 91 covers reached; 53 of 53 negative controls that were run fail as required, 36 deeper than 2,000 steps are not run (undecided); for 2 `ps2-device` nodes the `open-drain-as-push-pull` control cannot be written and is taken from node 17; the boundary lemmas and the SRAM macro lemma pass again and their negative controls fail; the formal netlist is equivalent to the committed `src/` top (ABC `dprove`), and the control netlist with an extra input flip-flop is not. With R42b the ledger lists 26 of 26 committed images certified: 441 of 441 segments, 441 covers, 185 of 221 negative controls failing as required (the other 36 not run) | [timing-certificates.md](timing-certificates.md), sections 6 and 8; README.md (Status) | [`tools/timing/cert/results/summary.json`](../tools/timing/cert/results/summary.json) and [`results/campaigns/6a3ea08.md`](../tools/timing/cert/results/campaigns/6a3ea08.md); jobs 24301948 (certify: snapshot, formal RTL, emission), 24303012 (short segments), 24303013 (chunks), 24303014 (covers), 24303015 (negative controls), 24303016 (lemmas), 24303017 (long segments whole), 24303018 and 24303019 (equivalence and its control), 24303020 and 24333946 (retry: 10 cover runs ended in ERROR on the solver portfolio and passed with yices alone), 24333947 (record) | Cluster: `tools/timing/cert/campaign.sh certify`; `python3 tools/timing/cert/ledger.py check` |

## 6. Physical exploration (local LibreLane runs; not results of record)

| # | Claim | Stated in | Evidence | Reproduce |
|---|---|---|---|---|
| R50 | The flow is deterministic: four runs of the submission point (8x4, `fp8_base`, density 60, 20 ns; 32 and 48 OpenROAD threads) gave identical metrics, equal to the 4-thread local run `run2` (job 23720702). All were at `73536f0`, before the halo change | [notes/sweep.md](notes/sweep.md), "Results" | `<work dir>/sweep/results.csv`: 23749129_0, 23749537_0, 23749132_0 (full) and 23749131_0 (fast): utilization 0.5854, typ WS +2.938, slow WS −5.09, LVS 0 | Cluster: [notes/sweep.md](notes/sweep.md) |
| R51 | Base 8x4 meets typical-corner setup down to 12.5 ns (80 MHz), WS +0.05 ns | notes/sweep.md | 23749131_6 | Cluster |
| R52 | Full sign-off (LVS 0, route DRC 0, antenna 0) for `rstreg` and `cn_s2` at 8x4 and for `diet4` at 6x4 (`fp6_tworow`, density 65, utilization 56.2%, typ WS +2.85 ns) | notes/sweep.md | 23751798_0, 23751802_0, 23763343_0 | Cluster |
| R53 | The reset variants do not close the slow corner: `rstreg` −7.52 ns, `cn_s2` −4.99 ns (at 73536f0: base −5.09 ns). Still true for these runs; the design of record's slow corner was later closed by configuration, not by RTL (R16) | notes/sweep.md | same rows | Cluster |
| R54 | All 69,448 Magic DRC markers lie inside the SRAM macro footprints and reproduce on the macro alone; KLayout precheck DRC 0 of 332 rule categories on every GDS tested; the 84 illegal overlaps are 32 stripe-over-OBS crossings | [notes/drc-triage.md](notes/drc-triage.md), "Verdict" | `<work dir>/drc-triage/` (`manifest.json`) | Cluster: notes/drc-triage.md section 9 |
| R55 | With `FP_MACRO_HORIZONTAL_HALO` 16.48 and `RUN_MAGIC_DRC` false, a local full run passes the unmodified precheck, all 9 checks | notes/drc-triage.md section 6 | Jobs 23850490 (flow), 23856538 (precheck); confirmed officially by R2 | Cluster |
| R56 | 8x4 area study: 58.4% measured at 8x4; 6x4 needs `diet4`, predicted 55.2% | [notes/area-study.md](notes/area-study.md) section 1 | The study's scripts in `docs/notes/area-study/`; superseded by R4 (58.53% official) and R52 (56.2% measured for `diet4` at 6x4) | Cluster |

## 7. FPGA builds (not run on a board)

| # | Claim | Stated in | Evidence | Reproduce |
|---|---|---|---|---|
| R60 | **Superseded by R60b** as the current release; these bitstreams are kept. Seven openXC7 bitstreams, all meeting their clock target in nextpnr-xilinx's timing model after synthesis/place-and-route option and seed optimization (about 12,700 nextpnr runs): `cmod_a7 pll50` DIP pin host 79.69 MHz (was 46.39), bridge-only 78.38, `pll40` 73.91, `osc12` 76.45, `cmod_a7 host` 80.43, `urbana pll50` 86.95, `urbana host` 76.44 MHz; TT design and SRAM replacement unchanged (SRAM proof re-run) | [fpga.md](fpga.md), "Build results" | Release rebuild job 23998703 (each rebuild reproduces its sweep fmax; readback 0 missing/extra bits); bitstreams with SHA256SUMS in `<work dir>/fpga/bitstreams/` (not in git; the 2026-09-25 set in `v1-2026-09-25/`) | Local with the openXC7 toolchain: `fpga/scripts/release.sh <release>` (fpga/scripts/release.tsv) |
| R61 | Configuration readback of all 7 bitstreams | fpga.md, "Build results" | Job 23767112 | Local: `fpga/scripts/readback.sh` |
| R60b | The 2026-09-27 openXC7 release, with the on-board capture unit in the UART-bridge builds: all seven builds meet their clock target in nextpnr-xilinx's model (not a vendor sign-off): `cmod_a7 pll50` 71.36 MHz, `BRIDGE_ONLY=1` 73.19, `pll40` 66.66, `osc12` 73.83, `urbana pll50` 76.04, `cmod_a7 host` 69.31, `urbana host` 74.32 MHz; every bitstream passed the readback check | [fpga.md](fpga.md), "Build results, capture-unit release (2026-09-27)" | Seed sweep job 24125836 (560 runs), release rebuild job 24126323; bitstreams in `<work dir>/fpga/bitstreams/v3-2026-09-27-scope/` (not in git) | Local with the openXC7 toolchain: `fpga/scripts/release.sh` |
| R62 | AMD Vivado 2025.2 timing sign-off of the same seven builds (same RTL, pin and clock constraints): all seven meet timing, with WNS ≥ 0, TNS 0, WHS ≥ 0, THS 0, no unclocked register or unconstrained internal endpoint, no methodology critical warning and no DRC error; worst setup slack 4.979 ns (`urbana host`, 20 ns) and worst hold slack 0.014 ns (`cmod_a7 osc12`). A timing sign-off, not a hardware result | [fpga.md](fpga.md), "Vivado sign-off flow" | Jobs 24149331 and 24149924; bitstreams in `<work dir>/fpga/bitstreams/vivado-2025.2-2026-09-27/` (not in git) | Vivado 2025.2 (ML Standard edition; no license needed for the xc7a35t and xc7s50): `fpga/vivado/build.tcl`, then `fpga/vivado/timing_check.py` |

## 8. Extension study and the extension variant

| # | Claim | Stated in | Evidence | Reproduce |
|---|---|---|---|---|
| R70 | Conditional GO for line coding plus CRC-16 at 8x4; prototype checks pass on four configurations (16 whole-chip checks each), with 6 of 6 seeded RTL bugs caught | [extension-study.md](extension-study.md) sections 1 and 5 | Job 23789566 and its log, in `<work dir>/extension/`. The prototype Hardcaml sources are not in git (section 9) | Cluster work area only |
| R94 | The extension variant `diet8_rec16` (line coding and CRC-16; not the design of record) passed the official Tiny Tapeout actions on branch `eval/diet8-rec16` (`ac436f7`, the variant core in `src/`): `gds` (3 h 59 min), `precheck` ("Precheck passed") and `gl_test` (`TESTS=127 PASS=66 FAIL=0 SKIP=61`); `test` 127 of 127 on RTL. Its `metrics.csv` is byte-identical to the local run's (setup WS typ/fast/slow +6.03/+7.38/+2.07 ns at 15 ns, one antenna net), and its official netlist is equivalent to its RTL. `regen` fails on the branch by design: it regenerates `src/` as the design of record | [extension.md](extension.md) section 12.1 | Runs 36360490711 (`gds`), 36360490678 (`test`, `TESTS=127 PASS=127 FAIL=0 SKIP=0`), 36360490685 (`formal`), 36360490692 (`regen`, failure as expected), 36360490710 (`docs`); local full run job 24121613; equivalence job 24163332 | CI on the branch |

## 9. Claims that are stale or not fully substantiated

These were found while this page was compiled. They are listed so the
owning documents can be corrected. No number above depends on them. Items
that no longer hold are kept and marked **Resolved**, with the commit that
resolved them (re-checked on 2026-09-28 against `24f31f0`).

1. **README.md, previous Status section.** It said the design had not been
   hardened and quoted 58.4% utilization and a slow-corner WS of −5.09 ns.
   Those figures came from the local run of `73536f0` (`run2`, job 23720702).
   The official build of `c118027` has 58.53% and −8.52 ns (R4, R7). This
   change replaces that section.
2. **Resolved in `fb79f31`: docs/info.md, "Limitations".** At `c118027` it
   said the design "has not yet passed the Tiny Tapeout gds flow" and that a
   host library "is planned", although `host/` exists (R24). `fb79f31`
   removed both statements.
3. **docs/notes/hardening.md, status paragraph and section 9.** They say nothing
   in the document has been run by the GitHub action. Its slow-corner figure,
   −5.09 ns, is the `run2` figure for `73536f0`. The official results (R1 to
   R9) now answer most of the section 9 items. Still so at `24f31f0`.
4. **Mutation score 89.4% (R23b).** The summary and the per-mutant results
   are only in the cluster work area (`<work dir>/test-gaps/`). The
   repository keeps only the 80.2% summary
   (`campaigns/mutation/results/summary.json`). Committing
   `summary_gaps.json` would make the 89.4% auditable from the repository.
5. **"39/39" results.** The FPGA simulations (R27), most of the variant
   results (R26) and the early gate-level figure of 22 pass and 17 skip used
   the 39-test suite of `73536f0`. Only the variant suites were re-run with
   the 66-test suite (R25, job 23819698). The FPGA tops have not been
   simulated with the 66-test or the 102-test suite. For the 2026-09-27
   release, `test_smoke` and `test_flagship` of `test/` passed on the
   pin-host tops, 4 of 4 each (job 24125728; [fpga.md](fpga.md),
   "Checks of the capture-unit tree").
6. **Extension study (R70).** Its prototype sources and tests are in the
   cluster work area, not in the repository, so its PASS results cannot be
   re-run from a clone. Since `76a81f5` the recommended extension is in the
   repository as the variant `diet8_rec16`, with its own tests, formal jobs
   and official branch run (R94); the prototype itself is still not.
7. **Earlier monorepo results ([signoff-history.md](signoff-history.md), "Earlier results", moved from README.md).** These are
   the independent-model checks and bounded formal properties of the private
   monorepo, for example Slurm jobs 22625543 and 22620770. They cannot be
   inspected or re-run from this repository.
8. **Resolved in `fb79f31`: gate-level `test_ext/`.** `fb79f31` adds
   `sg13cmos5l_udp.v` to the gate-level sources of `test_ext/Makefile`, and
   with the action's PDK revision and that file the whole suite passed at
   gate level on the CI netlist of run 36144357821, 65 of 65 (job 23975497;
   [independent-peers.md](independent-peers.md)). As first written, for
   `c118027`: `test_ext/Makefile` does not add
   `sg13cmos5l_udp.v` for gate-level runs. `test/Makefile` gained that line
   in `88f89a1` (see [bug-ledger.md](bug-ledger.md), BL-5). The 65/65
   gate-level result (R22) used a PDK copy whose standard-cell file defines
   the UDPs inline. With the action's PDK revision, a gate-level `test_ext`
   run fails to elaborate (`Unknown module type: ihp_mux4`); with the line
   added it passes (job 23975124, `test_ext_uart`, 5 of 5). The R22
   gate-level figure therefore depends on the PDK copy used.
9. **Reproducing a campaign seed.** [verification-campaign.md](verification-campaign.md)
   says any seed of a `default` campaign reproduces with
   `PE_SEED=<seed> make COCOTB_TEST_MODULES=test_random`. That holds for
   the `73536f0` test tree. Since `c118027` the default generator is
   generation 2. `PE_RANDOM_GEN=1` draws the campaign's cases, except that a
   trailing `deselect` now runs ([test/README.md](../test/README.md)).
10. **Resolved: runs recorded as unfinished.** As first written,
   [formal-depth.md](formal-depth.md) listed runs that had not finished, for
   example abc pdr and rIC3 on the unmodified `engine_safety` and on the SRAM
   data-integrity proof. All of them have ended, and formal-depth.md
   ("Runs that finished after this page was written") gives each outcome
   from its result file in the work area. Two passed: rIC3 BMC 96 on the
   program-load harness (23767782_0, 13,703 s) and yices BMC 64 on
   `processor_invariants` (23752066_8, 16,162 s). The others reached the
   41,400 s limit or ended in an error without a verdict; none failed an
   assertion. `formal_depth/results/summary.tsv` does not contain these
   rows.
11. **Mutation score 96.82% (R23c).** The per-mutant status of the push,
   re-tallied on the `4bd30c8` tree, is in
   `campaigns/mutation/results/push-4bd30c8/` (`summary.json`,
   `mutant_status.tsv`); the stage and formal scripts are in
   `campaigns/mutation/` ([mutation-push.md](mutation-push.md) section 6).
   The raw per-test logs stay in `<work dir>/mutation97/`.
   `campaigns/mutation/results/summary.json` holds the 80.2% campaign
   summary (R23).
12. **The official 6x4 run of `4bd30c8` (R82, R83).** Resolved: run
   36274474540 passed all jobs, and its `metrics.csv` equals that of the
   local p014 full run byte for byte.
13. **What the 6x4 overlay pins.** At `4bd30c8`
   `variants6x4/config.overlay.json` restated 15 of the 33 keys that the
   optimizer treats as knobs (`tools/opt/space.py` `KNOB_KEYS`): the keys in
   which p014 differs from `src/config.json`. Five more (`SYNTH_STRATEGY`,
   `PL_TIMING_DRIVEN`, `DESIGN_REPAIR_MAX_WIRE_LENGTH`, `CLOCK_PERIOD`,
   `GRT_RESIZER_HOLD_SLACK_MARGIN`) came from `src/config.json`, and twelve
   were unset in both files, so a later 8x4 change of any of them would
   have reached the 6x4 build (as would one of `OPENROAD_THREADS`). Since
   `8a05de7` and `fdc23f2` the overlay states all 33 knob keys: a value, or
   `null` for LibreLane's default; `switch.py check` accepts a `null` for a
   key that `src/config.json` lacks, `tools/opt/test_opt.py` fails if a
   knob key is missing, and `variants6x4/info.overlay.json` restates
   `clock_hz` 50000000. `switch.py apply` writes the same configuration as
   at `4bd30c8` (R83), apart from the order of two keys.
14. **`docs/notes/variants.md`** (section on reset styles) said that
   `sync_registered` removes the `rst_n` paths "that fail slow-corner setup",
   in the present tense. That described the `c118027` configuration (R7); the
   sentence now says so, and that the design of record meets the slow corner
   since `25e331e` (R16).
15. **The 50 MHz margins (R86).** The method is now in
   [`tools/sta/`](../tools/sta/README.md). It re-times a run's final netlist
   and nominal SPEF with LibreLane's own `corner.tcl` and `base.sdc`, which it
   reads from the LibreLane 3.1.0.dev3 image and does not copy. The
   repository copy was run as Slurm jobs 24089033, 24089058 and 24089059. It
   reproduced every per-corner metric, path-class value and report file of
   the original analysis (job 24077956) exactly.
   - **Requirements.** Re-running needs apptainer, that image and the IHP
     PDK.
   - **Inputs.** The inputs are not in git:
     - p010: the `tt_submission` artifact of `gds` run 36257636798, a CI
       artifact.
     - p018: the final netlist and nominal SPEF of p018's local full run,
       which are cluster files.
   - **Other material.** The original reports and the AXLE check stay in
     `<work dir>/sta50/`.
   - **Official flow.** It reports the design at 15 ns only (R85).
16. **Resolved at `24f31f0`: timing certificates of the revised I²C
    images (R42, R42b).** The campaign on `24f31f0` certified all 19 images
    committed there, the three revised I²C controller images included
    (R42b). As first written: the certificates were
    generated and proved for the 19 images committed at `c118027`. `fb79f31`
    then regenerated the three I²C controller images, so 119 of the 368
    certified segments describe earlier versions of those three images.
    [timing-certificates.md](timing-certificates.md) says so in its "Setup";
    a headline that cites "368 of 368" for the firmware at `24f31f0` needs
    this qualification until the three images are re-certified. The
    `certs` check of `tools/evidence/check_consistency.py` reports each
    certified image whose `bytecode_sha256` has changed since.
17. **Path coverage of the validation (R41, R41b).** The "100% path
    coverage" of R41 was for the images committed at `c118027`. For the
    images of `fb79f31`, run r8 observed 362 of the 363 path variants of
    the 19 committed images: one of the 28 variants of `i2c-read` was not
    observed (`validation-summary.json`, `variant_coverage`).
18. **Survivor 192 of the mutation push (R23c).** R23c counts 73 survivors,
    each argued unobservable. `test/test_wait_limit.py`, added later (R28b),
    kills survivor 192: the mutation sits on the input of another
    instruction's stage that carries the WAITEVENT stage's value, so the
    argument of [mutation-push.md](mutation-push.md) section 5 does not hold
    for it (section 8 there). The push's 102 tests and the module together
    kill 2,224: 96.86% (2,224 / (2,420 − 124)), 72 survivors; 97.97%
    (2,224 / (2,420 − 150)), 46 survivors, with the longer ABC cap. R23c's
    96.82% stays the push as run.
