TeslaCoilerOW/ttihp-protocol-emulator/campaigns/mutation/results/diet4-102/mutant_status.tsv

id | region | mode | status | how | status_longcap | how_longcap
1 | engine_ctrl | const1 | killed | suite:test_kill_blocked | killed | suite:test_kill_blocked
2 | engine_ctrl | inv | killed | suite:test_smoke | killed | suite:test_smoke
3 | engine_ctrl | cnot1 | killed | suite:test_legacy | killed | suite:test_legacy
4 | engine_ctrl | const1 | killed | suite:test_random | killed | suite:test_random
5 | engine_ctrl | inv | killed | suite:test_legacy | killed | suite:test_legacy
6 | engine_ctrl | cnot0 | equivalent | equiv_induct | equivalent | equiv_induct
7 | engine_ctrl | cnot1 | killed | suite:test_timewarp | killed | suite:test_timewarp
8 | engine_ctrl | cnot1 | killed | suite:test_random | killed | suite:test_random
9 | engine_ctrl | cnot0 | killed | suite:test_legacy | killed | suite:test_legacy
10 | engine_ctrl | const0 | killed | suite:test_kill_blocked | killed | suite:test_kill_blocked
11 | engine_ctrl | inv | killed | suite:test_directed | killed | suite:test_directed
12 | engine_ctrl | cnot0 | killed | suite:test_legacy | killed | suite:test_legacy
13 | engine_ctrl | const1 | killed | suite:test_protocols | killed | suite:test_protocols
14 | engine_ctrl | cnot1 | killed | suite:test_protocols | killed | suite:test_protocols
15 | engine_ctrl | inv | killed | suite:test_legacy | killed | suite:test_legacy
16 | engine_ctrl | const1 | killed | suite:test_legacy | killed | suite:test_legacy
17 | engine_ctrl | const0 | survived |  | survived
18 | engine_ctrl | cnot1 | survived |  | survived
19 | engine_ctrl | cnot0 | killed | suite:test_protocols | killed | suite:test_protocols
20 | engine_ctrl | const0 | killed | suite:test_counters | killed | suite:test_counters
21 | engine_ctrl | cnot0 | killed | suite:test_protocols | killed | suite:test_protocols
22 | engine_ctrl | inv | killed | suite:test_smoke | killed | suite:test_smoke
23 | engine_ctrl | const1 | killed | suite:test_smoke | killed | suite:test_smoke
24 | engine_ctrl | const0 | equivalent | equiv_induct | equivalent | equiv_induct
25 | engine_ctrl | const0 | killed | suite:test_smoke | killed | suite:test_smoke
26 | engine_ctrl | const1 | killed | suite:test_protocols | killed | suite:test_protocols
27 | engine_ctrl | cnot0 | killed | suite:test_legacy | killed | suite:test_legacy
28 | engine_ctrl | const0 | killed | suite:test_counters | killed | suite:test_counters
29 | engine_ctrl | const1 | killed | suite:test_smoke | killed | suite:test_smoke
30 | engine_ctrl | cnot0 | killed | suite:test_random | killed | suite:test_random
31 | engine_ctrl | const1 | killed | suite:test_kill_blocked | killed | suite:test_kill_blocked
32 | engine_ctrl | cnot1 | equivalent | equiv_induct | equivalent | equiv_induct
33 | engine_ctrl | const0 | survived |  | survived
34 | engine_ctrl | cnot1 | survived |  | survived
35 | engine_ctrl | cnot1 | killed | suite:test_timewarp | killed | suite:test_timewarp
36 | engine_ctrl | cnot1 | killed | suite:test_random | killed | suite:test_random
37 | engine_ctrl | const1 | killed | suite:test_kill_blocked | killed | suite:test_kill_blocked
38 | engine_ctrl | cnot1 | killed | suite:test_random | killed | suite:test_random
39 | engine_ctrl | inv | killed | suite:test_protocols | killed | suite:test_protocols
40 | engine_ctrl | inv | killed | suite:test_smoke | killed | suite:test_smoke
41 | engine_ctrl | inv | killed | suite:test_random | killed | suite:test_random
42 | engine_ctrl | const1 | killed | suite:test_protocols | killed | suite:test_protocols
43 | engine_ctrl | inv | killed | suite:test_smoke | killed | suite:test_smoke
44 | engine_ctrl | cnot1 | killed | suite:test_counters | killed | suite:test_counters
45 | engine_ctrl | inv | killed | suite:test_random | killed | suite:test_random
46 | engine_ctrl | cnot1 | killed | suite:test_kill_host | killed | suite:test_kill_host
47 | engine_ctrl | const1 | survived |  | survived
48 | engine_ctrl | inv | killed | suite:test_random | killed | suite:test_random
49 | engine_ctrl | const0 | killed | suite:test_timewarp | killed | suite:test_timewarp
50 | engine_ctrl | const0 | survived |  | survived
51 | engine_ctrl | const0 | equivalent | equiv_induct | equivalent | equiv_induct
52 | engine_ctrl | const1 | killed | suite:test_protocols | killed | suite:test_protocols
53 | engine_ctrl | cnot0 | killed | suite:test_random | killed | suite:test_random
54 | engine_ctrl | cnot0 | killed | suite:test_legacy | killed | suite:test_legacy
55 | engine_ctrl | const0 | killed | suite:test_kill_blocked | killed | suite:test_kill_blocked
56 | engine_ctrl | cnot0 | killed | suite:test_legacy | killed | suite:test_legacy
57 | engine_ctrl | const0 | killed | suite:test_smoke | killed | suite:test_smoke
58 | engine_ctrl | cnot0 | killed | suite:test_protocols | killed | suite:test_protocols
59 | engine_ctrl | inv | killed | suite:test_legacy | killed | suite:test_legacy
60 | engine_ctrl | inv | killed | suite:test_protocols | killed | suite:test_protocols
61 | engine_ctrl | const0 | killed | suite:test_random | killed | suite:test_random
62 | engine_ctrl | const0 | killed | suite:test_timewarp | killed | suite:test_timewarp
63 | engine_ctrl | const0 | survived |  | survived
64 | engine_ctrl | const0 | killed | suite:test_counters | killed | suite:test_counters
65 | engine_ctrl | cnot1 | equivalent | equiv_induct | equivalent | equiv_induct
66 | engine_ctrl | cnot1 | killed | suite:test_random | killed | suite:test_random
67 | engine_ctrl | cnot0 | killed | suite:test_legacy | killed | suite:test_legacy
68 | engine_ctrl | cnot0 | killed | suite:test_smoke | killed | suite:test_smoke
69 | engine_ctrl | const0 | killed | suite:test_kill_regs | killed | suite:test_kill_regs
70 | engine_ctrl | const0 | killed | suite:test_directed | killed | suite:test_directed
71 | engine_ctrl | cnot0 | killed | suite:test_random | killed | suite:test_random
72 | engine_ctrl | cnot1 | equivalent | equiv_induct | equivalent | equiv_induct
73 | engine_ctrl | const0 | killed | suite:test_timewarp | killed | suite:test_timewarp
74 | engine_ctrl | inv | killed | suite:test_smoke | killed | suite:test_smoke
75 | engine_ctrl | cnot0 | killed | suite:test_smoke | killed | suite:test_smoke
76 | engine_ctrl | inv | killed | suite:test_smoke | killed | suite:test_smoke
77 | engine_ctrl | const0 | killed | suite:test_smoke | killed | suite:test_smoke
78 | engine_ctrl | const1 | killed | suite:test_random | killed | suite:test_random
79 | engine_ctrl | cnot1 | killed | suite:test_protocols | killed | suite:test_protocols
80 | engine_ctrl | const0 | killed | suite:test_random | killed | suite:test_random
81 | engine_ctrl | const0 | survived |  | survived
82 | engine_ctrl | const0 | killed | suite:test_legacy | killed | suite:test_legacy
83 | engine_ctrl | inv | killed | suite:test_protocols | killed | suite:test_protocols
84 | engine_ctrl | inv | killed | suite:test_smoke | killed | suite:test_smoke
85 | engine_ctrl | const0 | killed | suite:test_counters | killed | suite:test_counters
86 | engine_ctrl | cnot0 | killed | suite:test_smoke | killed | suite:test_smoke
87 | engine_ctrl | cnot0 | killed | suite:test_kill_blocked | killed | suite:test_kill_blocked
88 | engine_ctrl | const0 | equivalent | equiv_induct | equivalent | equiv_induct
89 | engine_ctrl | cnot0 | killed | suite:test_random | killed | suite:test_random
90 | engine_ctrl | cnot0 | killed | suite:test_random | killed | suite:test_random
91 | engine_ctrl | cnot0 | killed | suite:test_protocols | killed | suite:test_protocols
92 | engine_ctrl | const0 | killed | suite:test_protocols | killed | suite:test_protocols
93 | engine_ctrl | inv | killed | suite:test_smoke | killed | suite:test_smoke
94 | engine_ctrl | cnot0 | killed | suite:test_random | killed | suite:test_random
95 | engine_ctrl | cnot1 | killed | suite:test_directed | killed | suite:test_directed
96 | engine_ctrl | const1 | killed | suite:test_legacy | killed | suite:test_legacy
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
