TeslaCoilerOW/ttihp-protocol-emulator/demo/results/isolation-bridge.png

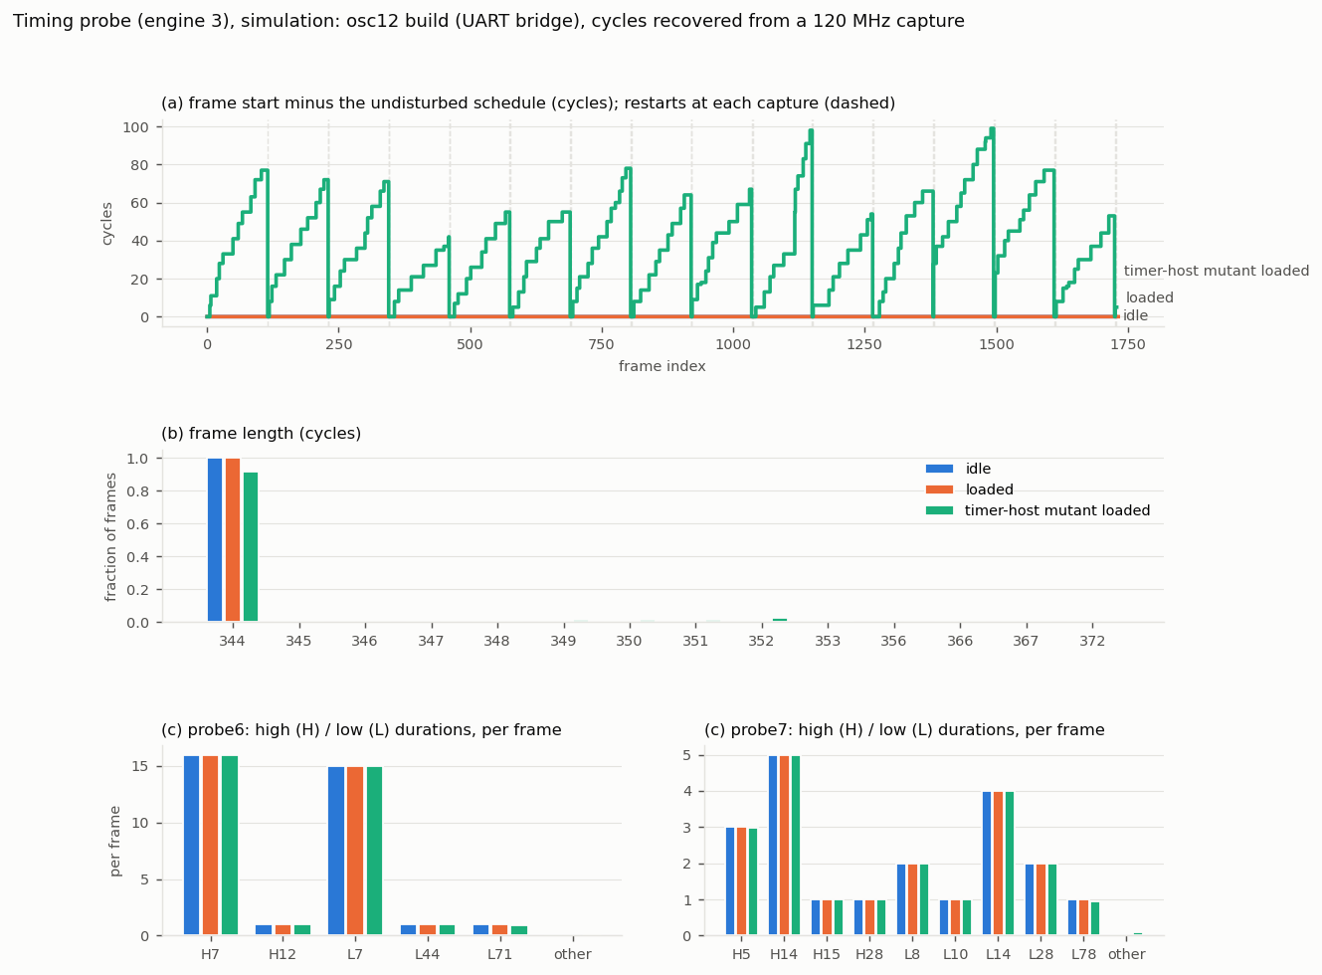
demo/results/isolation-bridge.png
