TeslaCoilerOW/ttihp-protocol-emulator/demo/results/isolation-pins.png

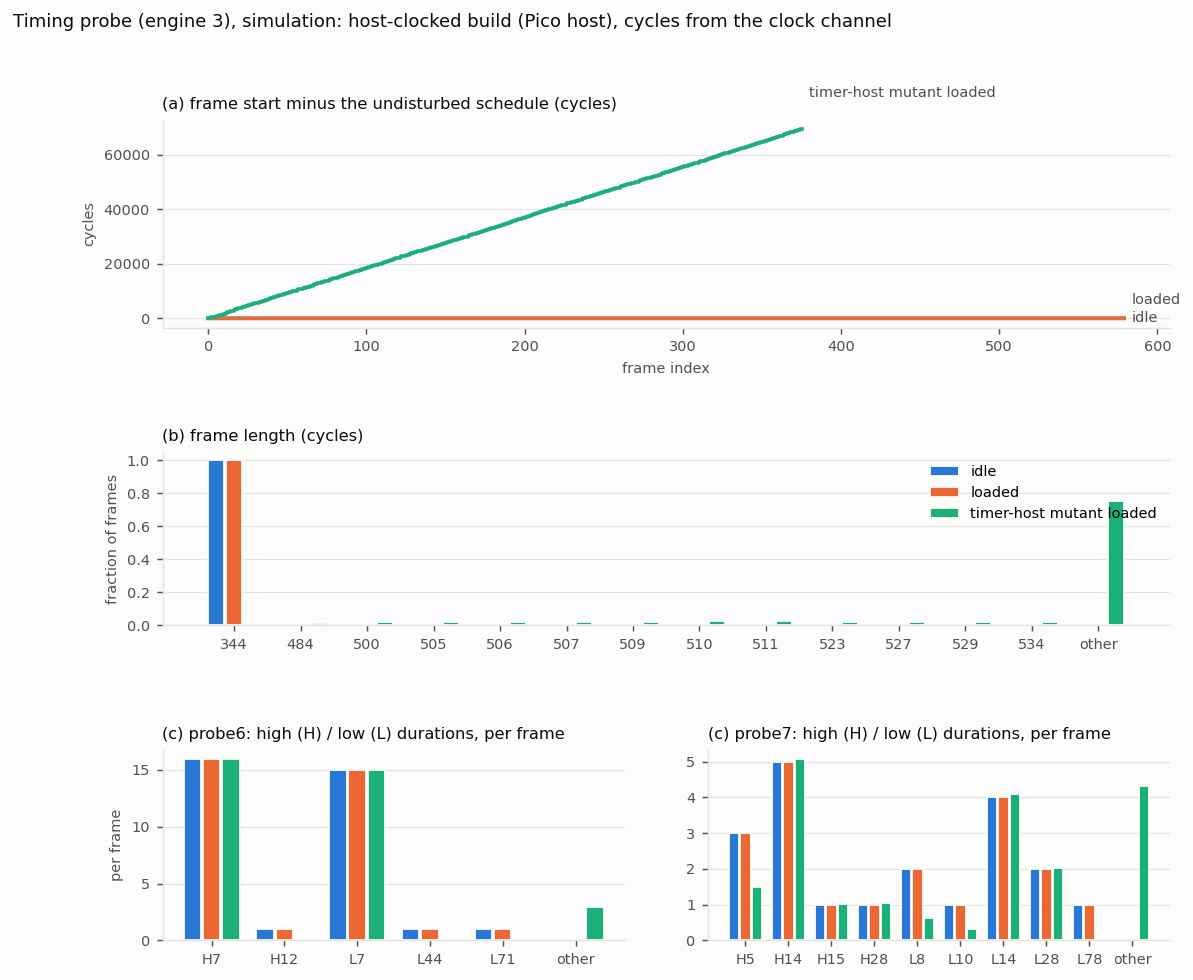
demo/results/isolation-pins.png
