TeslaCoilerOW/ttihp-protocol-emulator/demo/results/isolation-scope.png

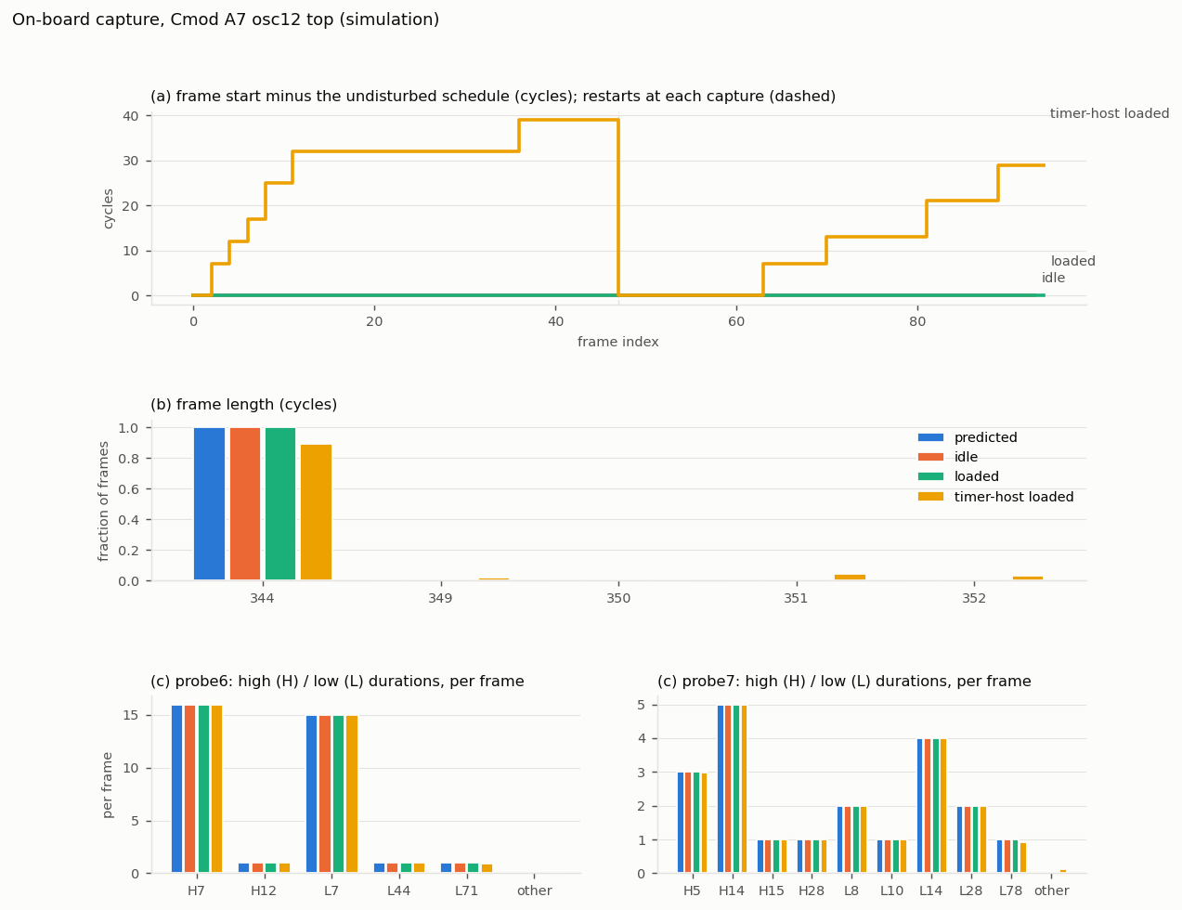
demo/results/isolation-scope.png
