TeslaCoilerOW/ttihp-protocol-emulator/(commit log)

2026-09-25 Protocol emulator: TT CMOS5L scaffold, SRAM-32 core, cocotb suite, macro config
    Work-in-progress snapshot of Phase 1:
    - Hardcaml source (four concurrent programmable I/O engines) with a
    generator --name option; scripts/generate.sh regenerates
    src/protocol_emulator_core.v (private instruction-SRAM refinement:
    4 engines, 32-bit data, 64 instructions/engine, 8x RM_IHPSG13_1P_64x16_c2).
    - TT wrapper tt_um_teslacoilerow_protocol_emulator, info.yaml (8x4, 50 MHz,
    full pinout), regen and test workflows.
    - cocotb suite running the DUT in lockstep with the Python ISA reference
    model: smoke, UART/SPI/I2C, flagship concurrency, 25 legacy workloads and
    constrained-random differential testing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
2026-09-25 Add formal verification suite and area/hardening studies
    - formal/: sby jobs for reset safety, FIFO conservation, engine safety and
    processor invariants, plus a new two-copy timing-isolation
    (non-interference) proof per engine on the full 4x32-bit SRAM design,
    with non-vacuity covers and two negative controls that must fail.
    run.sh regenerates the formal RTL from hardcaml/.
    - .github/workflows/formal.yaml: runs the sby job matrix in CI.
    - docs/area-study.md: CMOS5L area breakdown, 8x4 fit estimate and a ranked
    6x4 area diet.
    - docs/hardening.md: SRAM macro integration recipe for the TT gds action.
    [engine_safety.sv, fifo_conservation.sv, mutate.py, processor_inductive.sv, processor_invariants.sv, reset_safety.sv, timing_isolation.sv]
2026-09-25 Add TT datasheet and README; pin OpenROAD threads for macro routing
    - docs/info.md: Tiny Tapeout datasheet covering the four engines, host
    nibble protocol, command and READ_SELECT tables, ISA quick reference,
    flagship UART/SPI/I2C example, test instructions and limitations.
    - README.md: project overview, status, repo layout, build/test/formal
    instructions.
    - src/config.json: set OPENROAD_THREADS=4; LibreLane otherwise passes
    '-threads None' and detailed routing falls back to a single thread.
    - docs/hardening.md: updated SRAM integration notes.
2026-09-25 Integrate Phase 1: reconcile docs, CI and checks; record local hardening results
    - Move isa.md, firmware.md and architecture.md into docs/ and repoint
    references; move the area-study appendix (knob patch, scripts, configs)
    into docs/area-study/ with paths as required environment variables.
    - gds.yaml: pin librelane-version 3.1.0.dev3, which src/sram_pdn_cfg.tcl
    relies on. fpga.yaml: manual dispatch only, since the design does not
    fit an iCE40UP5K.
    - Add .gitattributes (generated core, vendored IHP views, binary GDS);
    ignore test/output/.
    - Makefile check-generated diffs only the generated core; lint.sh now
    requires exactly eight SRAM instances.
    - formal: declare past_valid before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
2026-09-25 Add reset and area variants with model, test and formal support
    Configurable Hardcaml options (refinement config 'options'):
    reset style (sync, sync_registered, async, async_sync_release), FIFO
    storage reset, narrow image registers, fifo_words 2/4, optional debug
    counters, 7-bit saturating PC and byte-lane shifts (ISA version 3 when
    any ISA-visible option is set). Without options the generated core is
    byte-identical to the design of record.
    Six named configs in configs/variants/ (base, rstreg, cn, cn_s2,
    diet4, diet2); scripts/gen_variants.sh generates and checks them. The
    reference model, assembler, cocotb suite (PE_VARIANT) and formal
    harnesses (run.sh --variant) follow the same semantics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
    [engine_safety.sv, fifo_conservation.sv, harness.py, processor_inductive.sv, processor_invariants.sv, random_gen.py, reset_safety.sv, scenarios.py]
2026-09-25 Add random-differential and mutation-testing campaigns
    Random lockstep campaign on the frozen 73536f0 design: 8,704 seed runs,
    536,064 cases and about 3.2 billion lockstep cycles against the Python
    reference model, including stress, dense/faulty/hostile/deselect
    generator variants and 10,752 gate-level cases on the locally routed
    netlist, with 0 failures. Every tracked coverage bin was hit across the
    campaigns; an injected model bug is caught and minimized.
    Mutation campaign: 2,420 single-mutation variants of the core (yosys
    mutate, region-biased). The existing suite kills 1,847; 116 survivors are
    proven equivalent, giving a mutation score of 80.2% (85.8% with deep
    random and 12 directed te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
    [gen_params.txt, mutant_status.tsv, sample_classification.tsv, survivor_evidence.tsv]
2026-09-25 Add host library and static firmware timing analyzer
    host/: one host API for the nibble host port that runs on the Tiny
    Tapeout demo board (MicroPython), a standalone Pico wired to an FPGA,
    and CPython against the reference model or RTL. It covers every
    command, program load with image hash and architecture checks, FIFO
    I/O and fault decoding, plus the flagship scenario. It is checked by 69
    unit tests, an acceptance oracle against the model's decisions, and
    100,000 fuzz seeds replayed under MicroPython and on RTL (Icarus 13).
    tools/timing/: pe_timing, a stdlib-only static analyzer giving exact
    per-edge pin schedules between synchronization points, loop periods,
    worst-case cycles and declare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
2026-09-25 Add parallel LibreLane sweep harness and floorplans
    scripts/sweep/ builds self-contained snapshots that reproduce the
    tt-support-tools config merge exactly, then runs the gds action's
    LibreLane 3.1.0.dev3 in its SIF on Slurm. It supports fast mode (skipping
    only Magic DRC, extraction and LVS) and full mode, local OPENROAD_THREADS,
    CPU-budgeted arrays, pruning, result extraction and collection. Paths come
    from PE_WORK.
    floorplans/: 8x4 alternatives and five 6x4 arrangements of the eight SRAM
    macros, some raised onto Metal2 tracks. check_macro_floorplan.py now
    validates any floorplan and tile size, and predicts off-grid macro pins.
    First results (docs/sweep.md; about 100 runs, 32 threads eac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
    [collect.py]
2026-09-25 Add deeper and new formal proofs; stretch-protocol extension study
    formal_depth/ (run against the committed 73536f0 design with the IHP SRAM
    FUNCTIONAL models; formal/ unchanged):
    - Deeper bounded runs: timing isolation to BMC 100, processor invariants
    to 128, processor inductive to 96, engine safety to 128.
    - engine_safety proved unbounded (suprove; and k-induction with three
    strengthening invariants).
    - Six new unbounded property sets: host-port atomicity and read
    snapshots, program-load safety, mover conservation (no loss,
    corruption, duplication or reordering), the 4-grant round-robin bound,
    fault stickiness with output-enable release, and pin safety (disjoint
    drivers, open-d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
    [summary.tsv]
2026-09-25 Add FPGA prototyping and independent third-party protocol peers
    fpga/: board tops for the Digilent Cmod A7-35T and the Real Digital Urbana
    (Spartan-7 xc7s50), wrapping the unchanged TT top. Includes an MMCM 50 MHz
    clock (or a host-driven clock like the TT demo board), tri-state and
    open-drain pads, a USB-UART host bridge, and an FPGA replacement for the
    IHP SRAM macro that is proved equivalent to the IHP model (unbounded, RTL
    and netlist). Seven openXC7 bitstreams build reproducibly with configuration
    readback checks; the full cocotb suite passes on the FPGA tops (RTL and
    synthesized). Pin maps, wiring, build, programming and a hardware test
    procedure are in docs/fpga.md. Not yet run on a bo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
    [RM_IHPSG13_1P_64x16_c2_fpga.v]
2026-09-25 Fix precheck Pin-check failure; skip Magic DRC in the gds flow
    The official precheck of 73536f0 failed its Pin check: OpenROAD's PDN
    generator placed short VPWR/VGND Metal4 straps in the 32.96 um gaps
    between paired SRAM macros, and they were exported as power ports that do
    not reach both die edges. FP_MACRO_HORIZONTAL_HALO 16.48 (half the gap)
    makes the halos meet, so no rows or straps are generated there.
    RUN_MAGIC_DRC false: all 69,448 Magic markers lie inside the IHP SRAM
    macros and reproduce on the macro alone. Magic DRC is not part of the
    cmos5l precheck, whose KLayout SG13CMOS5L deck reports 0 of 332 on every
    build. Skipping it saves about 40 minutes of the runner's 6 h limit.
    Verif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
2026-09-25 Close verification gaps; mutation score 80.2% -> 89.4%
    - Random generator generation 2 (default; PE_RANDOM_GEN=1 keeps the old
    cases): random deselects run inside the cycle budget, and host-command
    rejection paths (BEGIN, COMMIT, STOP, ROUTE, EVENT) are generated.
    - New modules: test_directed (tests derived from mutation survivors),
    test_mover (arbitration under contention and host priority),
    test_counters (long counters and timers read back) and test_timewarp.
    - The suite has 66 tests; all six variants pass. The mutation score is
    2,060/(2,420-116) = 89.4% (docs/verification-campaign.md, 'Gap closure').
2026-09-26 Fix I2C controller firmware timing found by the static analyzer
    pe_timing reported that i2c-repeated-start held SCL low for only 7 cycles
    (140 ns at 50 MHz) before the repeated START, and that the NACK path in
    i2c-write, i2c-read and i2c-repeated-start released SCL after a 2-cycle
    runt without sending STOP. The firmware now meets the UM10204 SCL low/high
    and START/STOP/repeated-START timing at its declared bus speed, and ends a
    NACK with a STOP while keeping fault 65. i2c-write is now 60 words, so the
    datasheet host sequence commits 60 words (0x0200003C).
    Checks: pe_timing report 183 PASS, 0 FAIL, 0 WARN (tools/timing/report
    regenerated; validation replays consistent); cocotb 66/66 (Icarus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
    [test_ext_i2c.py, test_pe_timing.py]
2026-09-26 Add results table, one-command reproduction, bug ledger and limitations
    - docs/results.md: every headline claim with where it is stated, the
    evidence (commit, CI run, Slurm jobs, result files) and the command to
    reproduce it; unsupported or stale claims are listed.
    - scripts/reproduce.sh, 'make reproduce' and 'make reproduce-full':
    regenerate and compare the RTL, lint, cocotb, a formal subset including
    timing isolation, the timing report and host tests, with a PASS/FAIL
    summary. The quick tier passes on the committed tree in about 4 minutes.
    - docs/bug-ledger.md: real defects found by the verification process,
    with the finding method, evidence and fix.
    - docs/limitations.md: what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
2026-09-26 Add mutation-kill tests; mutation score 89.4% -> 96.82%
    Eleven new cocotb modules (test/test_kill_*.py, 36 tests) target real
    test gaps found by classifying every mutation survivor: blocked-cycle
    timeout edges, decoder must-be-zero operand bits, mover eligibility
    around same-edge host actions, host payload and image-length checks,
    trigger detectors, and STOP/START on the exact issue edge. They kill 163
    more mutants, and 8 more are formally proven equivalent. The strict score
    is 2,223 / (2,420 - 124) = 96.82%; the 73 remaining survivors are argued
    unobservable but not proven, so they count as survivors
    (docs/mutation-push.md). The suite is 102 tests and passes on the design
    of record, all six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
    [test_kill_blocked.py, test_kill_common.py, test_kill_decode.py, test_kill_edges.py, test_kill_events.py, test_kill_fifo.py, test_kill_host.py, test_kill_mover.py]
2026-09-26 Add formal timing certificates tying pe_timing schedules to the RTL
    tools/timing/cert/ generates one SymbiYosys certificate per firmware
    segment from the static analyzer's output. Each certificate asserts, on
    every cycle up to the next synchronization boundary, that the design of
    record matches pe_timing's issue slots, pad levels, pad-change edges,
    input sampling and arrival state. All 368 segments of the 19 committed
    images are proven, long segments both whole and as chained chunks. Covers
    are reached, and all 132 negative controls (wrong analyzers and perturbed
    predictions) fail. Boundary lemmas, an SRAM macro lemma and an
    equivalence check from the formal netlist to src/ complete the
    comp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
    [boundary_lemmas.sv, equiv_src.py, gen_cert.py, rtl_mutants.py, sram_lemma.sv, summarize.py, test_gen_cert.py]
2026-09-26 Add hardware demonstration kit validated in simulation
    demo/ prepares the timing-isolation measurement for an FPGA board: a
    timing-probe firmware on engine 3 whose edges are compared, cycle by
    cycle, with pe_timing's schedule while the host and the other three
    engines are idle and then fully loaded (a UART-mover-SPI loop plus host
    traffic). It also covers a concurrent four-protocol demo and a host-free
    mover bridge. Capture tooling covers sigrok analyzers, cycle recovery from
    a host-driven clock or high-rate sampling, statistics and histograms. The
    full pipeline is validated on simulation dumps, and a deliberately
    timing-coupled mutant is detected. docs/demo.md lists the parts, wiring,
    proce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
2026-09-26 Add CI-built 6x4 submission candidate (diet4)
    The competition rules still say 6x4 is the maximum, so the diet4 variant
    (ISA 3; docs/variants.md) is now a CI-built candidate next to the 8x4
    design of record.
    - variants6x4/: committed diet4 core with provenance and a currency check,
    config/info overlays, switch.py to switch a workspace to the 6x4 build,
    and row_islands.py, which predicts short-power-strap channels.
    - At 6x4 the halo value alone leaves a short VPWR/VGND strap pair in a
    26.96 um stripe-free gap next to the right core edge, which fails the
    precheck Pin check. The selected floorplan (fp6_tworow_trk_top30_edgeobs)
    keeps halo 16.48 and adds an FP_OBSTRUCTIONS box over tha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
2026-09-26 Run the random and mutation campaigns on the 6x4 diet4 variant
    - Random lockstep on RTL: 4,352 seeds, 278,528 cases, 1.66 billion cycles,
    0 failures, no coverage holes. Gate level on a diet4 6x4 routed netlist:
    10,752 cases, 0 failures, cycle-identical to RTL. An injected model bug
    is caught.
    - Mutation (66-test suite): 2,028 / (2,420 - 107 proven equivalent) =
    87.7%, rising to 91% with an extra random stage.
    - campaigns/ scripts gained backwards-compatible variant support.
    [gen_params.txt, mutant_status.tsv]
2026-09-26 FPGA: all seven builds meet timing with large margins
    About 12,700 nextpnr-xilinx runs on the cluster (synthesis/place-and-route
    option studies and placer seed sweeps) moved every build well past its
    clock target. The TT design, the FPGA wrapper and the proved SRAM
    replacement are unchanged; only tool options changed:
    - HeAP placer timing weight 80-160 (default 10);
    - Yosys ABC9 script flow3mfs with a 1000 ps wire delay, with -nowidelut on
    5 of 7 builds;
    - router1 on 5 of 7 builds, plus the best placer seed.
    Cmod A7 50 MHz with the DIP pin host goes from 46.39 MHz (missed) to
    79.69 MHz; the others reach 73.9-87.0 MHz. Every release rebuild
    reproduces its sweep fmax, configuration readback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
    [release.tsv]
2026-09-26 Adopt optimizer configuration: setup met at all corners at 50 MHz
    Adopt the physical-design optimizer's best promoted configuration
    (promotion p010-dor, trial dor-26a873-c8bf57e#94) into src/config.json.
    The RTL is unchanged; only LibreLane settings change: timing-driven
    placement with a 5.75 ns setup-repair margin, density 61, DELAY 4
    synthesis, fanout 8, repair margins, CTS settings, GRT layer adjustments,
    and the fp8_spread_trk macro floorplan with a 20 um halo.
    Promoted evidence with the gds action's LibreLane and OPENROAD_THREADS 4:
    full run 24010051 (route DRC 0, antenna 0, LVS 0), the unmodified TT
    precheck 9/9 (24011934) and the gate-level suite (24011935, 0 fail).
    Setup worst slack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
2026-09-26 Add the autonomous physical-design optimizer
    tools/opt/: an Optuna-TPE driver that runs as a self-resubmitting Slurm job
    and keeps about 20 LibreLane runs in flight through the sweep harness.
    Every trial goes to an append-only store. The objective is lexicographic:
    legal (route, antenna, all-corner hold, no short power straps, precheck
    power-port rule), then minimum all-corner setup slack, then electrical
    violations, typ fmax and utilization. The best trials are promoted to full
    runs (LVS), the TT precheck and the gate-level suite, and a leaderboard
    shows the exact config diff. There is a budget, a STOP file and preemption
    safety. docs/optimization.md covers method, search space, how to insp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
2026-09-26 Optimizer v2: frequency tracks, a 6x4 track, per-track promotion
    Knob sets are now absolute (space.base_knobs/materialize), so a trial
    means the same configuration whatever src/config.json is committed;
    test_opt.py checks this and that the 6x4 build matches switch.py.
    Tracks: design of record at 20, 15 and 13.33 ns, the diet4 6x4
    fallback (variants6x4 overlay) and the variant cores, with weighted
    allocation, a retirement rule, a 3,000-run budget and per-track
    leaderboard sections. docs/optimization.md records the SDC analysis
    (I/O delays are 20% of CLOCK_PERIOD) and the v1 and v2 results.
2026-09-27 6x4 overlay: pin every flow knob key
    The overlay of 4bd30c8 restated only the keys in which p014 differs from
    src/config.json, so a later 8x4 change of SYNTH_STRATEGY,
    PL_TIMING_DRIVEN, DESIGN_REPAIR_MAX_WIRE_LENGTH, CLOCK_PERIOD,
    GRT_RESIZER_HOLD_SLACK_MARGIN or of a key unset today could still reach
    the 6x4 build. The overlay now states all 32 knob keys of
    tools/opt/space.py except OPENROAD_THREADS: a value, or null for
    LibreLane's default. switch.py check accepts a null for a key that
    src/config.json lacks. The merged configuration is unchanged (equal to
    that of 4bd30c8, which passed gds_6x4 run 36274474540).
2026-09-27 6x4 overlay: pin OPENROAD_THREADS and clock_hz; test the pin
    The overlay now states all 33 knob keys of tools/opt/space.py (it left
    out OPENROAD_THREADS, on which detailed routing can depend), and
    info.overlay.json restates clock_hz 50000000, the 6x4 build's signed-off
    clock, so an 8x4 clock change cannot reach it. test_opt.py checks that
    the overlay states every knob key; report.py's adoption note says a null
    needs no overlay_new_keys entry. switch.py apply writes the same
    configuration as at 4bd30c8 (key order aside) and the same info.yaml.
2026-09-27 Mutation: reproducible push scripts; diet4 rerun with the 102-test suite
    The stage, miter and invariant scripts of the 96.82% push move from the
    cluster work area into campaigns/mutation/ (parameterized by PE_WORK and
    OSS_CAD_SUITE), with the per-mutant status re-tallied on the 4bd30c8
    tree (results/push-4bd30c8/). The diet4 core, rerun under the same
    procedure and the 102-test suite, scores 95.24% (2,199 / (2,420 - 111)),
    up from 87.7% with the 66-test suite (results/diet4-102/). run_mutant.py
    now applies the time warp to both cores of the RIP wrapper; before, the
    warping tests failed on it (documented in docs/mutation-push.md).
    [mutant_status.tsv, survivor_classes.tsv]
2026-09-27 Docs: official all-corner timing for 8x4 and 6x4; 15 ns local sign-off
    Run 36257636798 (131e793): the design of record meets setup at all three
    corners at 50 MHz (+7.88/+9.31/+2.95 ns), byte-identical to the local
    p010 prediction; the slow corner was closed by configuration only.
    gds_6x4 failed on 131e793 (the overlay inherited the p010 keys) and
    passed on 4bd30c8 with p014 (+7.71/+10.52/+2.74 ns, run 36274474540,
    byte-identical to the local full run). results.md adds R15-R19, R80-R84
    and R23c/R23d and marks superseded rows; limitations.md, info.md,
    timing-closure.md (section 9), 6x4.md (sections 4b, 4c, 5b) and
    optimization.md (current results, promotions p011-p023) follow.
    Promotion p018 p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
2026-09-27 Optimizer: weight the committed 15 ns track first
    Since d76f1cc src/config.json signs off at 15 ns, so new trials go
    dor15 0.35, dor13 0.15, dor20 0.15, 6x4 0.20, variants 0.15 (was
    0.22 / 0.08 / 0.35 / 0.20 / 0.15).
2026-09-27 Config comments: describe the template changes and the 15 ns gate
    The comments said the only template changes were the SRAM block and the
    stripe keys (false since 25e331e) and that the flow signs off at every
    corner (setup is gated at typ, hold at every corner). Comments only; the
    configuration is unchanged. tracks.py: the optimizer's dor15 snapshots
    still write clock_hz 66666667, unlike the committed info.yaml.
2026-09-27 Docs: 15 ns sign-off with a 50 MHz operating clock
    d76f1cc constrains the flow at 15 ns (p018; local sign-off: full run
    24042265, precheck 24053971, gate level 24053972); the operating clock
    stays 50 MHz. An OpenSTA re-analysis with the flow's own STA script
    (job 24077956; both controls reproduce the flow's metrics exactly) gives
    the layout +8.95/+9.92/+6.79 ns of setup slack at 20 ns, against
    +7.88/+9.31/+2.95 for the 20 ns layout of 131e793 and +7.86/+9.39/+3.00
    for p018's settings flowed at 20 ns (p027). Input-to-output paths gain
    only 3 ns from 15 to 20 ns because the I/O delays are 20% of the period.
    The official gds run 36298635436 was in progress; the 6x4 build stays at
    20 ns and pass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
2026-09-27 tools/sta: re-time a signed-off layout at another clock period
    sta_retime.py re-runs LibreLane 3.1.0.dev3's own post-route STA
    (corner.tcl, base.sdc, read from the image at run time and hashed) on a
    run's final netlist and SPEF at a chosen CLOCK_PERIOD, per corner, with a
    read-only report of the worst path per class (reg->reg, in->reg,
    reg->out, in->out). A run at the layout's own period is the control and
    must reproduce the flow's metrics. Run from the repository on the three
    cases of docs/timing-closure.md section 10 (jobs 24089033, 24089058,
    24089059), it reproduces the earlier work-area results exactly (0
    differences in 90 timing metrics, 90 path-class values and 144 report
    files); both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
2026-09-27 formal_eq: RTL-vs-netlist sequential equivalence of hardened netlists
    eq_check.py builds a Yosys miter of the RTL (src/project.v plus the
    variant's core) and a gate-level netlist (cell functions from the
    liberty; the eight SRAM macros as cut points; reset forced in the first
    cycle) and decides it with ABC dprove. Only "equivalent" exits 0; not
    equivalent, undecided, a time limit or an error fail. Structural
    preconditions (liberty functions, no latches, rising-edge flops, clocks
    through buffers only, PDK revision) are checked first. Nine recipe
    controls and two netlist mutants form a self-test; the first recipe
    (miter -ignore_gold_x then setundef -zero) was unsound and is rejected by
    controls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
    [c1_gold0_mask.v, c2_gold1_mask.v, c3_reencoded.v, c4_deep.v, c5_sram_same.v, c6_sram_din_swap.v, c7_sram_dout_swap.v, c8_gated_clock.v]
2026-09-27 Docs: the official 15 ns build of d76f1cc passed
    Run 36298635436 passed gds (4 h 24 min), gl_test (102/46/56/0) and
    precheck (finished 2026-09-27 13:33 UTC). Its metrics.csv and gate-level
    netlist are byte-identical to the local p018 sign-off: setup WS
    +5.95/+6.92/+2.24 ns at 15 ns, hold min +0.165 ns, 0 violations. README,
    info.md, results.md (R85), limitations.md, timing-closure.md (10.2),
    optimization.md and 6x4.md now quote the official result instead of
    "in progress". p024 (13.33 ns) passed the local sign-off including the
    equivalence stage; it is not committed.
2026-09-27 CI: RTL-vs-netlist equivalence on every gds and gds_6x4 build
    .github/workflows/equiv.yaml runs formal_eq/eq_check.py --selftest on the
    tt_submission artifact of each gds / gds_6x4 run whose gds job succeeded
    (workflow_run), or of a given run (workflow_dispatch), and fails closed.
    The checker and its tests come from the workflow's own commit; only src/
    and variants6x4/ come from the built commit, and the artifact's src/ must
    equal them. The artifact zip, the PDK liberty (pdk.json revision) and OSS
    CAD Suite are verified against pinned sha256 values; every event, input
    and API value reaches scripts through env: and is validated; permissions
    are read-only. actionlint 1.7.12 is clean. Emulated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
2026-09-27 Optimizer v3: CI runtime model and rule, timing-repair runtime knobs
    tools/opt/runtime.py projects the official gds / gds_6x4 job length from
    a trial's or full run's per-step runtimes, normalised by node speed; its
    constants are fitted to 18 official jobs matched to 4 local full runs and
    over-predict every one of them. For the 15 ns, 13.33 ns and 6x4 tracks a
    promotion reads PASS only if the projected official job is <= 5.5 h
    (GitHub stops a job at 6 h); p019, p021 and p024 now read "PASS (over CI
    time bound)". New knobs bound post-CTS repair effort
    (PL_RESIZER_SETUP_REPAIR_TNS_PCT, GRT_RESIZER_SETUP_REPAIR_TNS_PCT, gate
    cloning and buffer removal switches). dor13 (75 MHz) becomes the main
    t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
2026-09-27 Extension variant diet8_rec16: line coding + CRC-16 (design of record unchanged)
    A default-off `line_unit` option adds a shared-ticker line unit to each
    engine: Manchester / NRZI coding, bit stuffing and CRC-16 presets in both
    bit orders (LCFG, LTIM and CRC instructions; READ_SELECT 7 capability
    bits), as docs/extension-study.md recommended ("diet8 + REC16 at 8x4").
    configs/variants/diet8_rec16.json enables it on diet8 (the diet4 options
    with 8-word queues, also added). Firmware in firmware/ext/: CAN data-frame
    node, 10BASE-T UDP transmit, USB-LS IN responder, relay, CRC stream.
    Verification (docs/extension.md): cocotb 127/127 in lockstep plus
    independent pad-waveform references (CAN, USB-L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
2026-09-28 FPGA: self-measuring capture unit, bring-up kit, Vivado scripts
    An FPGA-side capture unit (fpga/rtl/pe_fpga_scope.v; in the shell, not
    the ASIC core; read-only taps) timestamps every change of uo_out / uio
    (pad or core view) / ui_in with a 48-bit cycle counter into block RAM,
    with explicit overflow; UART bridge protocol 2 adds arm / force / halt /
    status / counters / CRC-checked read-back. fpga/host/pe_scope.py rebuilds
    the waveforms; `demo/pc_demo.py scope` runs the idle-vs-loaded isolation
    experiment on the board itself, with no logic analyzer. In simulation the
    reconstructed edges equal the simulator's VCD in 9/9 cases, the clean
    design shows 0 cycles of jitter and the coupled mutants are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
    [release.tsv]
2026-09-28 FPGA: Vivado 2025.2 timing sign-off of all 7 builds (all met)
    The seven released builds (same RTL and constraints as the openXC7 set)
    were implemented with AMD Vivado 2025.2 ML Standard (xc7a35tcpg236-1,
    xc7s50csga324-1): all meet timing with positive setup and hold slack,
    TNS/THS 0, pulse width met, no unclocked or unconstrained endpoints and
    no methodology critical warnings (Slurm job 24149924). WNS at the target
    clock: Cmod A7 pll50 +5.467 ns, pll50 bridge-only +5.089, pll40 +9.871,
    osc12 +64.445, Urbana pll50 +5.821, Cmod host +5.808, Urbana host
    +4.979 ns. build.tcl now reads only the port clocks by default so Vivado
    derives the core clock through the MMCM (the net clock that nextpnr ne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
2026-09-29 Timing certificates: ledger, preflight, retry path, lemma checks and a certs workflow; campaign re-run at 24f31f0 (19/19)
2026-09-29 Firmware: idle-tolerant UART receiver for the flagship; SWD, PS/2, WS2812 and 1-Wire images (no RTL change)
2026-09-29 Docs: pitch-first README, overview, sign-off history, one verification page; evidence consistency checker
2026-09-29 Flagship on uart-rx-idle: peer and host tests, variant image sets, stricter SWD error check
    [flagship.py, scenarios.py, test_ext_flagship.py, test_host_flagship.py, test_host_micropython.py, test_protocols_ext.py]
2026-09-29 Timing certificates: a lost portfolio run is repeated with yices alone
    In the c-6a3ea08b campaign four cover tasks (bundles of chunk covers on the
    boolector+yices portfolio) were killed for running out of memory before
    writing results. retry_list.py --missing listed those runs unchanged, so the
    retry would have used the same portfolio again.
    [retry_list.py, test_retry_list.py]
2026-09-29 Timing certificates: campaign 6a3ea08 certifies the 7 new images (ledger 26/26)
    91 of 91 segments (28 long ones as 96-step chunk chains, up to 80,004
    steps), 91 covers, 53 of 53 negative controls run fail as required (36
    deeper than 2,000 steps not run); lemmas pass; netlist equivalence holds and
    its control fails. Slurm 24301948, 24303012-24303020, 24333946-24333947.
2026-09-29 Docs: the seven round-5 images are certified (R42c); 26 of 26 images in the ledger
2026-09-29 certs CI: covers with yices alone (CI_COVER_ENGINES)
    The first GitHub run of the certs workflow (36624435421) lost the
    prove uart-rx-idle job about two minutes in (exit 143, later steps not run):
    the boolector+yices portfolio used up the runner's 16 GB on a first-chunk
    cover, as it did on the cluster. Proof runs keep the portfolio.
2026-09-29 certs CI: covers four at a time (CI_COVER_PAR)
    With yices alone the covers of uart-rx-idle took most of 5,949 s for 38 runs
    at two in parallel (dispatched run 36625986442). yices alone needs far less
    memory (four chunk covers at once peaked at about 9 GB on the cluster).
2026-09-29 certs CI: budget 150 runs from GitHub-measured rates
    Dispatched runs 36625986442 and 36637581754 proved uart-rx-idle, jtag and
    i2c-repeated-start on GitHub runners (all passed): about 84 s per run on
    uart-rx-idle and jtag, against about 50 s on the cluster nodes the 200-run
    budget was based on. 150 runs at 85 s take about 3 h 33 min.
2026-09-30 Tests: WAITEVENT/WAITPIN LIMIT timeouts at 2^k + 2 (test_wait_limit); closes a count-bit gap
    A mutation campaign on the extension variant found that four count-bit
    mutations of the WAITEVENT LIMIT countdown passed all 107 tests of the design
    of record (Slurm 24370776). test_wait_limit times out WAITEVENT and WAITPIN at
    LIMIT 2^k + 2, k = 0..23, on all four engines and checks from the DUT that the
    enable stays high for exactly LIMIT + 1 edges and that fault 3 is reported.
    It kills the four and push survivor 192, whose written argument was wrong
    (96.86% with it; 96.82% stays as the push as run). Suite: 109 tests; gate
    level 48 pass, 61 skip. Independently verified (Slurm 24383951, 24384695).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
    [test_wait_limit.py]
2026-09-30 ps2-host on byte-lane-shift designs: isa.md corrected, pe_host refuses it on ISA 3, protocols-ext skips it and requires the fault; diet4 mutant 1860 note
    firmware/ps2-host word 45 is SHR by 21, the only non-lane shift of the 26
    images; on diet8 (and diet4, diet2, diet8_rec16) it faults with code 1, and
    test_protocols_ext's two ps2-host tests failed under PE_VARIANT=diet8.
    Found on the extension branch (605feab). Also: diet4's 95.24% counts a
    clock-inverting mutant as proved equivalent; 95.19% without it (R23e).
    Independently verified (Slurm 24392390, 24392406).
    [host.py, image.py, test_host_image.py, test_protocols_ext.py, variant.py]
2026-09-30 Hardcaml: typed opcodes, host commands and issue mode; engine split into decode, datapath, transfer and line-unit modules
    Opcode.t (34), Host_command.t (12) and Issue.t are matched exhaustively by
    the decode rule, the execute body, the encoder, the mnemonic and the
    host-command acceptance rule, so the compiler rejects an opcode without all
    of them (warning 8). engine.ml is split into Engine_datapath (registers, one
    START list), Engine_decode, Engine_transfer (one XFER issue and transfer
    body), Engine_line (register bank as a Hardcaml Interface) and Engine
    (Engine.I interface), each with an .mli. ppx_jane derivers (hardcaml.v0.17.0
    already depends on ppx_jane).
    Every generated file is byte-i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
    [harness.py, line_unit.py, rtl_mutants.py]
2026-09-30 Host: lockstep PIO port keeps the chip clocked while the host services queues (simulation only)
    One RP2040/RP2350 PIO state machine runs a 6-system-clock frame per
    project clock (f_sys/6: 25 MHz at 150 MHz), drives clk on side-set and
    carries the nibble-port transfers, so the clock does not pause for host
    transactions (outside reset/deselect halts). MicroPython driver
    (pe_host/ports/pio_lockstep.py), PIO assembler and cycle-accurate
    interpreter (host/pio/), checked against the datasheet text and rp2040js.
    RTL cocotb: flagship 83,653 edges, 0 model mismatches; UART bridge and
    stream scenarios that need host service while the chip runs; FPGA host
    builds. Timing margins at 150 MHz under stated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
    [asm.py, board.py, pathcheck.py, pio_lockstep.py, replay.py, scenarios.py, sim.py, test_pio_asm.py]
2026-09-30 Formal: instruction-level specification (formal/isa), one check per opcode and host command
    Written from docs/isa.md without the Hardcaml source, the generated RTL's
    logic or the reference model (docs/isa-spec.md section 1 lists the earlier
    formal harnesses that were read). Symbolic engine, image address and
    instruction word; 48 one-step checks proved by k-induction from an invariant
    V that reset establishes, 5 bounded checks (queue data, whole XFER); 153
    jobs with 49 negative controls that must fire their named assertion. No RTL
    bug found. Plain formal/run.sh keeps its 16 jobs; the spec runs by name or
    through the isa_ci_* groups. Re-verified independently on f246775 (Slurm
    24420171-2442018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
    [gen_sby.py, isa_cmd.sv, isa_insn.sv, isa_spec.sv, mutate_isa.py]
2026-09-30 Docs: worked example of a timing certificate (docs/timing-certificates-tutorial.md)
    An 8-instruction image (tools/timing/cert/examples/toy-pulses) walked
    through the flow: pe_timing's schedule, the generated certificate
    (annotated excerpt), the proof with run_one.sh and ci_prove.sh (3/3
    segments, 3/3 covers, 8/8 negative controls), a one-cycle-late control and
    its counterexample, and how certificates, boundary lemmas, netlist
    equivalence and STA compose (argued, not machine-checked). All shown output
    comes from Slurm jobs 24425442 and 24427706; run.sh reproduces it.
    Independently verified (24426595). Also: verification.md now says all 26
    images are certified.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
2026-09-30 Mutation: held-out sample of the design of record, 93.45% [92.20, 94.51] vs 96.86% in-sample
    1,936 mutants drawn uniformly per region (seed 20260930) from Yosys mutate's
    raw database of the 56f4b20 core, excluding every (mode, cell, port) of the
    push's 2,420 mutants; run under the 109-test suite and classified with the
    push's method. Longer ABC cap: 96.00% vs 97.97%. 69 survivors: 48 argued
    equivalent, 21 real test gaps (1.22%), listed with the unobserved
    behaviour; no tests were written, so the sample stays held out. The twelve
    survivor-targeted modules kill 49.8% of the held-out survivors of the older
    suite against 69.4% in-sample. docs/mutation-push.md section 9; results.md
    R23f. Independ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
    [exclude_section8.tsv, mutant_status.tsv, survivors.tsv]
2026-09-30 formal_depth: repair six mutant sites, follow HEAD, rerun every job on 56f4b20 (all 73536f0 results reproduced)
    load_partial_commit's substitution site stopped matching at c377d97 and five
    others at 131e793, so formal_depth could not build its negative controls
    past 73536f0. The sites are repaired (older revisions still resolve); the 13
    mutant netlists are byte-identical to 73536f0's; a structural check
    (gen/mutant_cones.py) shows each mutant changes only the fan-out of its
    edit. FD_REV now defaults to HEAD and is recorded in every result. All 56
    jobs (192 sby tasks) reran on 56f4b20 (arrays 24426336-24426339) and
    reproduced every earlier result: unbounded proofs, BMC depths, cover steps,
    an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
    [summary.tsv]
2026-09-30 Docs: working notes move to docs/notes/ with an index; die render and Pages viewer in the README
    Eight dated working records (optimization, sweep, area-study, drc-triage,
    hardening, timing-closure, variants, 6x4) move to docs/notes/ with an index;
    the evidence and specification documents stay at the top level. Links and
    path mentions are rewritten (path-only changes; floorplans regenerate
    byte-identical; src/config.json differs only in '//' values). docs/img/die.png
    is the official gds_render of run 36714406904 (ce6b9bd), scaled. The
    consistency check now also covers docs/notes/. README Status: the viewer job
    passes since bab697b. Independently verified (Slurm 24479719, 24479723).
    Co-Author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
2026-10-01 Tests: specification checks for the 21 held-out gaps; second held-out sample 95.00% [93.89, 95.92]
    Five test/test_spec_*.py modules (9 tests; suite 118) check the isa.md and
    info.md behaviour that the first held-out sample's 21 gaps left unobserved,
    from the DUT; each gap is killed by exactly one module, also with the model
    comparison off. A second held-out sample (seed 20261001, excluding the
    push's, section 8's and the first sample's mutants) scores 95.00%
    (1,691/1,780) under the 118 tests, 97.13% with the longer ABC cap; 13 new
    gaps are listed without tests. run_mutant.py takes the module list from make.
    docs/mutation-push.md section 10; results.md R23g, R28c. Independently
    verified (Slur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
    [mutant_status.tsv, survivors.tsv]
